Resident-X/brew-state/docs/sunbeam-em7000/photos/original-board-solder-side-aligned.jpg

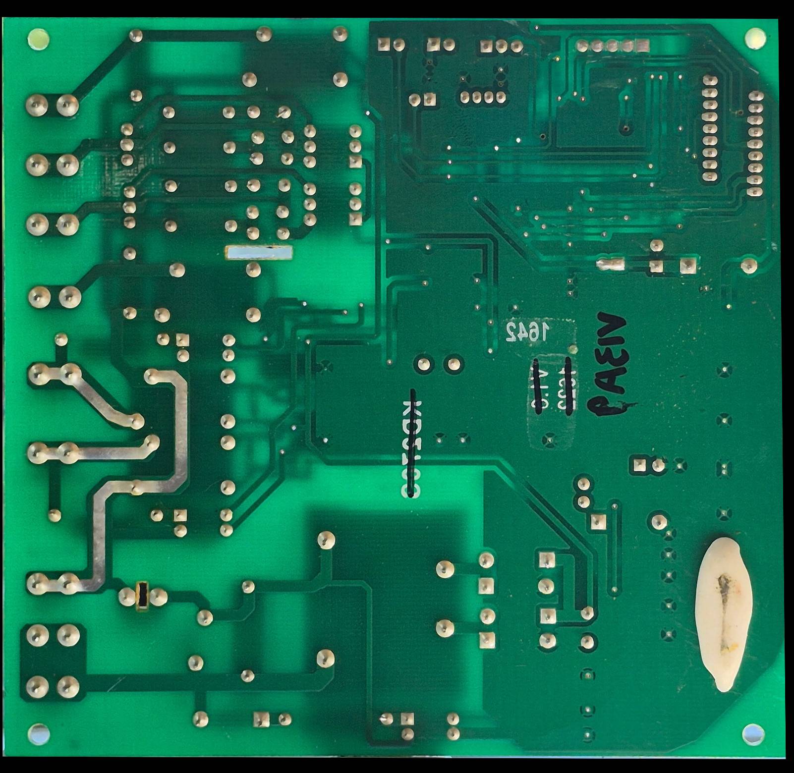
docs/sunbeam-em7000/photos/original-board-solder-side-aligned.jpg
