Resident-X/brew-state/docs/sunbeam-em7000/photos/ntc-two-pin-headers.jpg

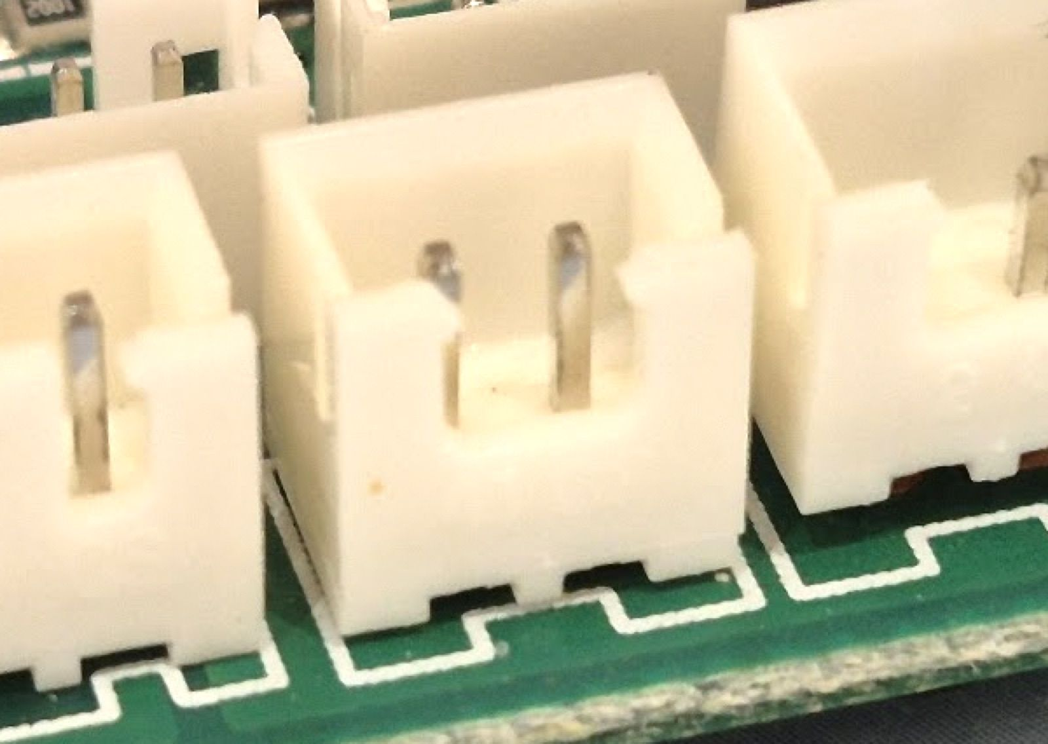
docs/sunbeam-em7000/photos/ntc-two-pin-headers.jpg
