Resident-X/brew-state/docs/sunbeam-em7000/photos/mains-terminals-with-ruler.jpg

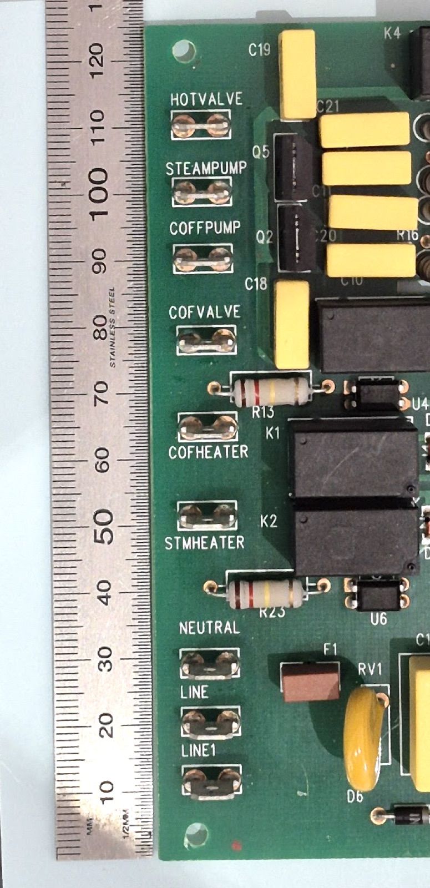
docs/sunbeam-em7000/photos/mains-terminals-with-ruler.jpg
