Resident-X/brew-state/docs/sunbeam-em7000/photos/three-way-valve-coil-marking.jpg

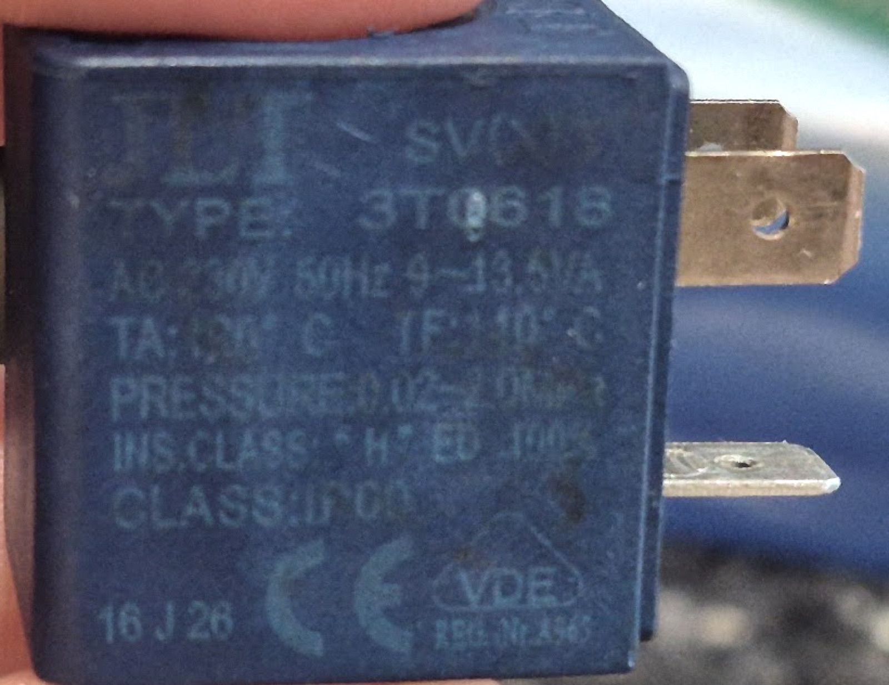
docs/sunbeam-em7000/photos/three-way-valve-coil-marking.jpg
