Resident-X/brew-state/docs/sunbeam-em7000/controller-design/component-specification.md

> **[Fork, kept as history.]** This is the copy of `../component-specification.md` refreshed on 2026-10-12 against the bought-module design. The root document is the live record and governs; this copy's passages are classified in `_carry-forward/reconciliation.md`, and the README of this folder says where the design now is.

# Component specification and list

**This file is local, like `reference-machine.md` and `controller-io.md`.** It answers the question those two leave open: given every channel the machine needs, what property must each part have, which part has been selected, does the selected part meet the property and on what evidence, and what is still undecided or unmeasured.

It is a refresh of the earlier `component-specification.md`, rewritten against the decisions of 2026-10-12 (`decisions.md`) and the current design data (`control-system-bom.csv`, `part-numbers.csv`, `module-interconnect.csv`, `passive-and-drive-components.csv`, `h743-pin-allocation.csv`, `h743-header-pinout.csv`). `decisions.md` was written before any of its decisions was in the graph; its controller choice (D1) has since been replaced by `DEC-CONTROLLER-BASELINE-STM32H743`, which is in the graph, and where this file leans on another decision of that log it says so. `DEL-COMPONENT-SPECIFICATION.C6` — regenerating this document and its list from the graph — is still a later criterion of the parent task and is not attempted here.

Tags used for provenance: **[chosen]** and **[owner decision]**, **[agreed]**, **[recommended]** are the status words of `decisions.md`; **[owner statement]**, **[parts list]**, **[schematic]**, **[published, unverified]**, **[inferred]**, **[unmeasured]** are as defined there. **[BOM]**, **[pin allocation]**, **[interconnect]**, **[passives]** name the data file the statement is read from. **To confirm** marks a claim kept from an earlier text or a source that the current inputs cannot settle.

Three rules govern what may appear below.

**The required property is stated independently of the part.** Each switched load names what its device has to do, carry, dissipate and fail into. The selected part is then held against that property. This is deliberate: a part recovered from another machine, or a replacement bought later, can be held against the property, but not against someone else's part number.

**Every figure traces to a declaration.** Currents are derived from the measured element resistances in `reference-machine.md` § Heating and load at the supply span that document declares. Nothing here introduces a figure that section does not carry, and where a figure cannot be derived the row says so rather than estimating.

**The controller was selected in the earlier design, and the live record has replaced that selection.** The earlier text of this file declined to select a controller because `DEC-PREHARDWARE-TARGET-FAMILY` and `DEC-HEATER-DRIVE-GATED-BY-SUPERVISION` left the choice open, to be answered against measured plant parameters. The WeAct MiniSTM32H743 was then chosen (D1, [chosen]; reason recorded as its 16-bit ADCs). `DEC-CONTROLLER-BASELINE-STM32H743` now baselines the STM32H743 designed bare onto the controller board, does not keep the WeAct module, and supersedes `DEC-PREHARDWARE-TARGET-FAMILY`, which had nominated the F4 family only as a verification stand-in for the pre-hardware target build; the F4 family is not the controller. The earlier assessment candidate, an STM32F407 board, and the OEM Hongfa relays were not used: the F407 was replaced for the H743's ADCs, and the relays cannot be commanded at the switching rate the heater scheme needs (half-cycle or whole-cycle: open decision). `module-interconnect.csv` separately records a graph revision owed against `DEC-MAINS-PHASED-ACTUATION-BELOW-SEAM` (see the supply-timing section).

## What the supply is, and what changes off it

Everything below is stated against a declared supply rather than against this machine's. The reference build runs on a declared span of 216–253 V at 50 Hz, from a 10 A outlet behind an upstream breaker declared as up to 20 A (`reference-machine.md` § Supply, which grades each). Two things follow for an adopter elsewhere, and both are properties of their supply rather than of this design:

- **Frequency sets the switching cadence, not the control period.** Heater devices are specified as commandable once per supply half-cycle (OPEN DECISION: heater switching cadence (whole-cycle versus half-cycle): `h743-pin-allocation.csv` toggles at whole-cycle granularity). That is 100 commands per second at 50 Hz and 120 at 60 Hz; the device requirement is identical either way, and `DEC-MAINS-PHASED-ACTUATION-BELOW-SEAM` carries the residual forward so a non-integer number of half-cycles per control step behaves exactly as an integer number does. [Superseded: bought-module design; the whole-cycle reading is the earlier pin allocation's, and the live record settles the per-half-cycle decision in `../controller-board-function-forms.md` § The heater switch and the per-half-cycle decision.]
- **Voltage sets the current, and the current sets the device.** These elements are fixed resistances, so halving the supply halves the current and quarters the power: the same two elements on 120 V would draw about 2.3 A and 2.6 A and deliver roughly a quarter of their rated heat, which is a different machine rather than the same one on a different plug. An adopter building to the same *heating* on a 120 V supply needs 120 V-rated elements instead, and `reference-machine.md` § What depends on these values records where that lands: the same installed heating at 120 V is over 16 A, so concurrent brew and steam is unavailable there regardless. Either way every current and dissipation figure below is recomputed from the adopter's own supply and element resistances; none of them is inherited.

This machine's 50 Hz is the supply's nominal, taken from the standard governing that supply rather than from a component's marking, as `REQ-MACHINE-CONFIGURATION-001.C9` requires (`reference-machine.md` § Supply, which grades it). Nothing below depends on its exact value: whatever depends on the supply's timing reads it live while the machine runs. The 50 Hz figure also appears in the dimmer acceptance test (about 100 zero-cross edges per second), which therefore measures the supply as well as the module. [Superseded in part: the dimmer acceptance test is bought-module design (the live front end is in `../controller-board-function-forms.md` § Supply-timing front end); the supply-nominal sentence before it is unchanged and is in `../component-specification.md` § What the supply is, and what changes off it.]

## What each switched load needs of its device

Six mains loads, each specified by property. Currents are computed from the measured cold resistances in `reference-machine.md` § Heating and load at three points of the declared 216–253 V span: 230 V nominal, 240 V, and 253 V, the span's top, which sets every current and dissipation a device is sized for (its 216 V bottom sets the least heat delivered and no device rating); a cold resistance gives the higher current if these elements behave as metal heating elements ordinarily do, resistance rising with temperature. **That coefficient is assumed, not declared** — no document here gives one for either element. It is called out because the whole direction of the sizing case turns on it: were either element to fall in resistance when hot, the worst case would be the hot reading rather than the cold one, and every figure in this table would be a floor rather than a ceiling.

### The required property

| Load | Commanded how often | Carries continuously | Must dissipate | Must fail into |
|---|---|---|---|---|
| [Superseded in part: the cadence open-decision note and the SSR dissipation estimate are bought-module design (live record: `../controller-board-function-forms.md` § The heater switch and the per-half-cycle decision and § Parts off the boards); the currents and the fail-into state are carried in `../component-specification.md`.] Coffee thermoblock element | OPEN DECISION: heater switching cadence (whole-cycle versus half-cycle): once per supply half-cycle as written here. This is the requirement that retires the OEM device: `DEC-MAINS-PHASED-ACTUATION-BELOW-SEAM` converts a commanded level into an energise-or-idle decision taken every half-cycle, and a mechanical relay cannot be commanded at that rate or survive being asked to | 4.36 A at 230 V, 4.55 A at 240 V, 4.80 A at 253 V, from the measured 52.7 Ω | At full duty, the device's own forward drop times that current. The earlier estimate was of the order of 6 W at the top of the supply span on a 1.2–1.4 V on-state drop, **a device-class figure from ordinary practice, not from any declaration here**; the BOM now estimates 5–6 W for the selected part on a 1.0–1.2 V drop [BOM, inferred, unmeasured]. A datasheet or measurement replaces either, and the heatsink follows from that number. Mounted so heat leaves it at the ambient inside a machine that is itself heating, not at bench ambient | **De-energised.** `OBL-ELECTRICAL-THERMAL-SAFETY-001.C2` requires a hung controller to de-energise rather than hold a heater on, and a device whose dominant failure is a short does not provide this by itself — see the regression note below |
| [Superseded in part: as the coffee row; the currents and the fail-into state are carried in `../component-specification.md`.] Steam thermoblock element | OPEN DECISION: heater switching cadence (whole-cycle versus half-cycle): once per supply half-cycle, as above | 4.89 A at 230 V, 5.11 A at 240 V, 5.38 A at 253 V, from the measured 47.0 Ω. That reading is a *lower bound* on the element's resistance — the bench could not isolate it and a parallel path can only pull a reading down — so these currents are a conservative ceiling rather than a central estimate, which is the right direction for sizing a device | Of the order of 7 W at full duty at the top of the span on the earlier basis (1.2–1.4 V); 5–6 W per channel is the BOM's estimate for the selected part | **De-energised**, on the same criterion and with the same caveat |
| Coffee pump | At a firing instant within the cycle. `DEC-MAINS-PHASED-ACTUATION-BELOW-SEAM` retains the phase-capable arrangement rather than replacing it | Bounded rather than derived from the declared figures. 48 W (Ulka EP5, nameplate, inspected) is a real-power rating and the load is a solenoid pump, so its VA exceeds its watts by a power factor no document here gives. 0.21 A at 230 V is the real-power floor, not the current the device must carry. The BOM carried 0.1–0.22 A as the pump current for the comparison with the dimmer's 4 A rating; the recorded sizing values, 0.46 A (coffee) and 0.19 A (steam) at 253 V under an assumed 0.5 power-factor floor (`../connector-pinouts.md` § Pumps: running current), replace it | Not derivable for the same reason. The OEM device carries it today, which bounds the question without answering it | **De-energised.** A pump left running is not the thermal hazard a heater is, but it is a water hazard and the same criterion reaches it |
| Steam pump | As the coffee pump | Same basis, 22 W (JYPC-4, nameplate, inspected) giving a 0.096 A real-power floor at 230 V | Same basis | **De-energised** |
| [Superseded in part: the relay that opens on power loss is bought-module design (live record: `../controller-board-function-forms.md` § Two-way valve switching and three-way valve switching); the vent role of the valve and the replacement-coil match are kept in `decisions.md` D6 and F2 and carried to the channel enumeration `../controller-io.md`; the coil currents are carried in `../component-specification.md`.] Two-way solenoid valve (`2T0607W`) | Once per delivery. Nothing requires this channel to modulate; it opens and closes | As found, the coil is marked 230 V AC, 9–13.5 VA, with a cold resistance of 2.496 kΩ: at most 64.6 mA rms steady and 101.4 mA rms inrush at 253 V (`../connector-pinouts.md`). A replacement valve is specified to match the fitted coil, 230 V AC 9–13.5 VA marked, and the snubber leakage note uses the 2.496 kΩ cold resistance | Follows from the device chosen | **Open to the drain when de-energised.** This is now decided rather than hypothesised: the 2-way vent is normally open and is energised closed whenever the coffee pump is pumping through the block (the 30-40 s shot; also hot water; the pre-shot flush; dry-fill and identification runs), so it vents on power loss, fault, end of brew and whenever the block heats with no flow path (D6, [owner decision]; F2, [owner statement]). The channel's safe state is therefore the de-energised state, held by a relay that opens on power loss |
| [Superseded in part: nothing module-specific except the relay; the brew-path state of the de-energised valve is kept in `decisions.md` F1 and carried to the channel enumeration `../controller-io.md`; the coil currents are carried in `../component-specification.md`.] Three-way diverter valve (`3T0618W`) | Once per delivery | As found, the coil is marked 230 V AC, 9–13.5 VA, cold resistance 2.497 kΩ: at most 64.6 mA rms steady and 101.4 mA rms inrush at 253 V (`../connector-pinouts.md`); a replacement valve is specified to match the fitted coil, 230 V AC 9–13.5 VA marked | Follows from the device chosen | **De-energised.** F1 [owner statement]: the 3-way valve is never closed; de-energised it connects the coffee block outlet to the group (brew path), energised it diverts to the hot-water outlet. De-energised is therefore the brew path |

### The selected part against the property

[Superseded: bought-module design (EARU SSR-40DA, ULN2003A breakout, RBdimmer modules, the four-channel relay module and its snubber modules); the live record is `../controller-board-function-forms.md` § Coffee element switching and steam element switching, § Coffee pump switching and steam pump switching and § Two-way valve switching and three-way valve switching, with the module properties re-stated as constraints in `../controller-board-design-constraints.md` § Carried-forward module properties. The datasheet-derived figures in the rows below (snubber leakage arithmetic, pump sizing currents, triac holding current against the valve coils) are held there and in `control-system-bom.csv`, `decisions.md` D5 and `passive-and-drive-components.csv`.]

The as-found OEM devices are recorded in `reference-machine.md` as evidence of what the machine was built with, not as candidates: two mechanical relays on the elements (on/off only, cannot be commanded per half-cycle), an opto-triac driver into a triac on each pump, and two mechanical relays on the valves.

| Load | Selected part | Meets the property? Evidence | Undecided or unmeasured |
|---|---|---|---|
| Coffee element | EARU SSR-40DA zero-cross solid-state relay (D2, [chosen]), control + to the 5 V rail, control − to ULN2003A OUT1 | **Current:** 40 A rating against 4.36 A at 230 V (4.80 A at 253 V) [BOM], large margin. **Cadence:** zero-cross type is the property that permits burst firing and the BOM calls it load-bearing; the BOM describes the scheme as half-cycle burst-fire, while `h743-pin-allocation.csv` says PB0 is toggled at whole-cycle granularity by the burst layer — the two readings are **to confirm** against `heater-drive-and-supply-timing.md`. **Isolation:** command crosses the SSR input to output; the ULN2003A sits between the controller pin and the SSR so no controller pin carries SSR drive current [BOM]. **Fail state on controller loss:** low-side drive, a lost wire turns the SSR off, and a 10 k pull-down on each ULN2003A input at the breakout's own header holds it off in reset [BOM, passives] | **Zero-cross type of this EARU part is not confirmed** — confirm on EARU's own datasheet, not the generic SSR-40DA class [BOM]. Package dimensions are assumed to match the Fotek it replaces [BOM, unmeasured]. Control current at the ~4 V the SSR sees after the Darlington drop is unmeasured (expect 7.5–12 mA). Heatsink: 2 × AUD 10 is listed, but the owner will try mounting direct to the side wall so it may not be needed (proposed, not decided; superseded 2026-10-23: the owner's plan is to mount the heater switches outside the enclosure on the machine's metal wall (`controller-board-design-constraints.md` § Enclosure air temperature); the wall is plastic and unearthed as found (reference-machine.md § Controller enclosure as found)) [owner statement, BOM]. SSR isolation rating not read from a datasheet (to confirm). Fail-short behaviour: see the regression note |
| Steam element | EARU SSR-40DA, OUT2 / PB1 | As above; 40 A against 4.89 A at 230 V (5.38 A at 253 V) [BOM] | As above |
| Coffee pump | RBdimmer 4A 1-channel Standard module (Z-C/DIM header) (D3, [chosen]); DIM on PA9, 1–2 A slow-blow branch fuse in its AC-L feed | **Phase-capable:** the controller times the triac itself from the module's Z-C, giving phase-angle and whole-cycle burst control [BOM]. **MOC3021 confirmed random-phase** so genuine phase-cut [BOM]. **Current:** BT136S 4 A against a pump current of 0.46 A (coffee) and 0.19 A (steam) at 253 V, the sizing values under an assumed 0.5 power-factor floor (`../connector-pinouts.md` § Pumps: running current); large margin even allowing for the unknown power factor [inferred]; no heatsink needed [BOM]. **Fail state:** DIM is active-high (from the vendor library), a 10 k DIM-to-GND pull-down is to be fitted at the module header so a floating or disconnected line cannot fire the pump; loss of AC-N or Z-C removes the timing reference and firmware must stop firing and raise a fault [BOM, interconnect] | Z-C output type (open-collector or push-pull), pulse width and polarity are not published — scope on arrival. Confirm by meter that the board has no pull-down of its own. The triac reads BT136S-600E from the board photo, which appears not to be snubberless; commutation on an inductive pump load is an open question the BOM judges likely a non-issue at a pump current of 0.46 A (the sizing value under an assumed 0.5 power-factor floor), and no snubber is to be added pre-emptively. The BT136 tab is non-isolated, so PCB copper under it is live: clearance matters when mounting. The vendor page states no isolation figure (read 2026-10-13) — **measure it, do not assume it**. Price of the Standard variant not yet checked |
| Steam pump | Same module; DIM on PD8; Z-C not wired | As above | As above, plus D4: steam pump drive (phase-angle versus burst) is **open**, to be settled on the bench; the OEM drives it in software bursts [published, unverified] |
| Two-way valve | Channel 1 (IN1, PD7) of a 4-channel opto-isolated mechanical relay module (Songle SRD-05VDC-SL-C relays, 10 A class) (D5, [chosen]); RC snubber + MOV module (100 nF / 220 Ω with 10D471K) across the contacts | **Isolation:** opto input plus the relay's own coil-to-contact separation. **Why mechanical:** espresso solenoid coils draw about 39-59 mA at 230 V (the coil marking's 9-13.5 VA, `../connector-pinouts.md`) against a BTA16 triac's maximum holding current of 60 mA, so a triac cannot reliably latch on them; the OEM's own split (triac for the pumps, mechanical relay for the valves) rests on the same physics (`decisions.md` D5) [earlier working README]. Relay contacts can weld; that is not removed by the choice. **Fail state:** the vent being fail-safe is a separate point: a de-energised coil is the venting state (D6), and the relay opens on power loss. **Drive level:** opto input triggers at 3.0–5.0 V so a 3.3 V GPIO drives it directly; JD-VCC jumper open to feed coil current from the 5 V rail so 286 mA of steady coil current for four relays does not sag the logic rail [BOM] | The as-found coil is marked 9–13.5 VA with a cold resistance of 2.5 kΩ (at most 64.6 mA rms steady and 101.4 mA rms inrush at 253 V: `../connector-pinouts.md`), so the contact rating margin is 10 A against that current, not against a replacement's, which is specified to match the fitted coil. **Input polarity** (active-low typical) is to be established first; the 10 k pull on each IN line is safety-critical and its direction depends on it [passives]. The snubber passes about 7.2 mA with contacts open (230 V over 100 nF at 31.8 kΩ, 220 Ω and the coil's 2.5 kΩ cold resistance in series), leaving about 18 V across the coil taken as its cold resistance (the lower bound) to about 31–51 V across the sealed coil (impedance 230² ÷ VA = 3.92–5.88 kΩ from the 9–13.5 VA marking, 7.95–8.63 mA), 8–22 % of line, the plunger-open state between and not recorded: whether that holds a valve in is not established (no drop-out or holding voltage is recorded for the coils, and the vent valve's fail-safe state rests on it: to confirm on the bench), and "de-energised" is not zero [BOM]. Whether the OEM valve is retained or replaced by the BOM's replacement spec is not settled (the BOM tags both valves with retained and future markers) — to confirm |
| Three-way valve | Channel 2 (IN2, PD10) of the same module; second snubber | As above. Channels 3 and 4 (PD14, PD15) are spare | As above |

### Isolation, which every row above shares

[Superseded in part: the first paragraph is unchanged and is in `../component-specification.md` § Isolation, which every row above shares; the module-by-module barrier statements, the BL0942 and IRM-10-5 items and the hand-cut carrier gaps that follow are bought-module design, and the barrier ratings are in `../controller-board-function-forms.md` § Barrier parts and `../controller-board-design-constraints.md` § Carried-forward module properties.]

`OBL-ELECTRICAL-THERMAL-SAFETY-001.C6` applies to all six loads and is stated once here rather than repeated per row, because the requirement does not vary between them: the barrier between the mains-referenced switching device and everything the controller, its sensing and the operator can reach must hold under fault as well as in service, and under the water, steam and repeated thermal cycling the machine actually runs in rather than under bench conditions.

For every one of the six, that means the device is commanded across an isolating barrier and never by a direct electrical connection to a controller pin. On the two pump channels the dimmer module's optocoupler (MOC3021) is that barrier and the requirement is a property of the module, and the vendor page states no isolation figure (read 2026-10-13), so it must be measured before it is relied on. On the two valve channels the relay module's opto input and the relay's own coil-to-contact separation provide it. On the two heater channels the barrier is inside the SSR, and the controller's pin reaches it only through the ULN2003A at 5 V; the SSR's own isolation figure is **to confirm** from the EARU datasheet. The heater channels are the consequential ones: they carry the largest current in the machine and they are the channels moved from a relay to a semiconductor.

Two further isolation items are new with the selected parts. The BL0942 energy meters (D17) are inherently mains-referenced, with a shunt in the current path and a resistor divider off mains, and **may not be connected at all until the module's isolation has been measured** (resistance between every header pin and every mains terminal reads open; treat as live until proven) [interconnect, pin allocation]. And the IRM-10-5 supply is rated 4.2 kVac isolation [BOM].

Creepage and clearance on the boards carrying these devices are a layout question this document does not settle, and no declared figure of this design bounds them. The BOM states 4–5 mm gaps on the hand-cut IRM carrier, that conformal coating does not replace creepage, and that the module's own 38.5 mm pin separation must stand on its own. The jurisdiction whose wiring rules apply is AS/NZS 3000 (`reference-machine.md` § Supply), which is a local assumption an adopter replaces along with the voltage and the frequency.

### The regression this specification makes visible

[Superseded in part: the argument is unchanged and is in `../component-specification.md` § The regression this specification makes visible; the SSR-specific sentences and the deferred interlock parts (master relay, watchdog module, latching relay) are bought-module design, and the live record is `../controller-board-function-forms.md` § Proof-of-life interlock.]

Meeting the half-cycle requirement (cadence is an open decision) on the two heater channels meant replacing a mechanical relay with a semiconductor device, and that is a regression in failure mode, not only a change of part. A relay's dominant failure is an open contact — not its only one, since contacts switching this current do weld — whereas a shorted junction is a semiconductor switch's ordinary way of dying rather than its unlucky one. That the selected SSR shares this failure tendency is **inferred** from its being a semiconductor output switch; it is not stated in any input and is to confirm on the EARU datasheet. On a heater channel the difference is the whole of `OBL-ELECTRICAL-THERMAL-SAFETY-001.C2`: a shorted output holds the element energised with no command and no way for the controller to intervene, which is precisely the state that criterion exists to forbid.

This is recorded here rather than solved here. The answer is not a better SSR — it is a series element that removes power independently of the switching device, which is what `REQ-SAFETY-CHAIN-001.C2` and `.C3` already require of the proof-of-life interlock. **Overtaken by `DEC-PROOF-OF-LIFE-INTERLOCK-IN-FIRST-HARDWARE` (2026-10-18): the interlock is built into the first controller hardware, not deferred.** The interlock is still not built: the master relay (Songle SLA-05VDC 30A, with aux contacts, which "cannot be the trip decider" because firmware may not be in the protective path) and the watchdog module (Jaycar/Freetronics XC4267) are BOM rows marked DEFERRED, and a candidate latching relay (CZH-LABS D-1022) is noted in `module-interconnect.csv`, deferred per `DEC-HEATER-DRIVE-GATED-BY-SUPERVISION`, which permits bench operation under human supervision without it and gates only the assembled unattended machine. Whether the graph now has covering work for the interlock is **to confirm**; the earlier text said it had none. The coupling remains: choosing the device the actuation scheme demands worsens the failure mode it protects against.

What the selected design adds is limited. The ULN2003A low-side drive with 10 k pull-downs holds both SSRs off while the controller is in reset or hung, which addresses a controller failure, not an SSR failing shorted. The BL0942 current reading (D17, [chosen], no BOM row yet) could in principle show heater current flowing with no command [inferred]; it detects, it does not remove power, and it is blocked on the isolation measurement above.

Both elements sit downstream of a per-block series thermostat (coffee block 110 °C, steam block 200 °C [parts list]), which the controller cannot reach (`DEC-HEATER-DRIVE-GATED-BY-SUPERVISION`). The parts list also names a thermal fuse (240 °C, steam block), a published, unverified derived view: none was seen at the board end and none was found by the owner (`../reference-machine.md` § Protection), so none is relied on here. The thermostats bound the hazard; they do not satisfy the criterion, which is about the controller's own failure rather than the temperature's.

## What the supply-timing front end needs

[Superseded in part: the Property, Requirement and OEM columns are unchanged and are in `../component-specification.md` § What the supply-timing front end needs; the Selected design column (the dimmer module's Z-C on PA10), the closing statement that the heater SSRs need no phase reference and the graph revision owed are bought-module design, and the live record is `../controller-board-function-forms.md` § Supply-timing front end.]

| Property | Requirement | OEM circuit (as found) | Selected design |
|---|---|---|---|
| What it presents | Both crossings of every cycle. `DEC-MAINS-PHASED-ACTUATION-BELOW-SEAM` resolves half-cycles, and a scheme resolving half-cycles cannot be timed against a reference reporting every second one | A `PC817` optocoupler fed from the line through a `1N4007` and a 120 kΩ 1 W resistor [schematic]. **Half-wave** — one conduction window per cycle; does not meet the property | The Z-C output of dimmer module #1 on PA10 (TIM1_CH3 expected, rising edge, input capture), one edge per half-cycle, **believed** full-wave: the acceptance test is about 100 edges per second at 50 Hz [BOM, interconnect]. Not yet measured, so **whether it meets the property is open**. The second module's Z-C is not wired |
| Isolation | A barrier separating the mains-referenced side from every low-voltage circuit and operator-reachable control, holding under fault and under the water, steam and thermal cycling the machine actually runs in, per `OBL-ELECTRICAL-THERMAL-SAFETY-001.C6` | The `PC817`'s optical barrier. Adequate in kind | The dimmer module's own; the vendor page states no figure, so it is to be measured |
| What it is read as | An input, not a clock. The supply's period is measured from it, and an edge arriving outside a plausible window — or not arriving — is a supply fault to report rather than smooth over | Routed to an interrupt pin of `U3`. Adequate in kind | Timer capture with the digital input filter plus a software lock ignoring edges inside a noise gate (the vendor library uses 3000 µs). Loss of the reference is a supply fault and firmware must stop firing [interconnect] |
| Phase accuracy | **Not established and not bounded.** The offset between a true crossing and a detected edge is real in any such front end, and no declared figure of this design bounds it. `DEC-MAINS-PHASED-ACTUATION-BELOW-SEAM` explicitly declines to invent one | Unknown | Unknown. The BL0942's ZX output (datasheet delay 570 µs) is not on the module header and the UART carries no phase, so it cannot supply a bound [interconnect] |

The heater SSRs are zero-cross and need no phase reference; the reference serves the pumps and the supply-period measurement [interconnect]. The both-crossings property is no longer a matter of choosing a rectifier or detector part: the dimmer module supplies the reference and the selection question becomes the acceptance test above. `module-interconnect.csv` records that this restores the both-crossings reference and that the graph's zero-cross enumeration row and `DEC-MAINS-PHASED-ACTUATION-BELOW-SEAM` have not been re-read or amended against it (graph revision owed).

## Does the selected controller serve every channel at once

[Superseded: bought-module design (the WeAct MiniSTM32H743 on female headers and its pin allocation); the live record is `../component-specification.md` § Does a candidate controller serve every channel at once and § The part selected, and `../controller-board-function-forms.md` § Controller.]

The assessment is made in interface resources, not in connector count, because `REQ-HARDWARE-HEADROOM-001.C2` and `DEL-COMPONENT-SPECIFICATION.C4` both rule that a count of spare pins argues nothing: what matters is whether the capture channels, conversion inputs and timer outputs the design collectively demands are *simultaneously* available. The ST datasheet facts (alternate functions, ADC channel maps) are not recomputed here; they are cited from `h743-pin-allocation.csv`, whose rows are checked against ST DS12110 except where marked.

### What the design demands, and where each channel lands

[Superseded: this is the earlier allocation on the WeAct module, an input only; the live record is `../component-specification.md` § What the enumeration demands, § Where each function lands and § The earlier pin allocation, as input only, which re-reads each row below against the manufacturer's datasheet.]

Read from `h743-pin-allocation.csv`. The option of reaching the panel over the machine's old two-wire link, left open by `DEC-U8-BOARD-RETENTION-UNVERIFIED`, no longer arises: the panel board carries no controller, and the project replaces both microcontrollers.

| Resource | Channel | Pin | Count | Verification status [pin allocation] |
|---|---|---|---|---|
| Heater SSR gates (via ULN2003A) | Coffee, steam | PB0, PB1 (TIM3_CH3/CH4, spare capability only) | 2 | Verified against DS12110 |
| Pump DIM gates | Coffee, steam | PA9, PD8 | 2 | Assigned, plain GPIO; TIM1_CH2 on PA9 "expected", not verified |
| Zero-cross capture | Shared, from dimmer #1 | PA10 (TIM1_CH3) | 1 | Assigned, AF not yet verified |
| Energy-meter UART receive | Coffee, steam heater | PC7 (USART6_RX), PA3 (USART2_RX) | 2 | Verified; TX optional on PC6 / PA2; blocked on isolation test |
| Pressure sensors, two I2C buses | Brew, steam | PB8/PB9 (I2C1), PB10/PB11 (I2C2) | 4 | Verified |
| Analogue inputs, 16-bit | 3 NTC (coffee, steam, wand) | PC0, PC1, PC4 | 3 | Verified |
| Analogue inputs, 16-bit | Outlet-water PT1000; commissioning PT1000; steam-output PT1000 | PA4; PA1; PA6 | 3 | Assigned, ADC channel **not yet verified** |
| Valve relay drive | 2-way, 3-way, 2 spare | PD7, PD10, PD14, PD15 | 4 | Verified, plain GPIO |
| Gauge drive lines (via 74HCT541) | 2 direction, step clocks, reset | PD0, PD1, PD4, PD5, PD6 | 5 | Verified, plain GPIO |
| Panel key/indicator lines | 5 bidirectional | PE4–PE8 | 5 | Verified, plain GPIO |
| Indicator anode-rail gate | PWM | PB5 (TIM3_CH2 expected) | 1 | Assigned, AF **not yet verified** |
| Buzzer drive | Open-drain | PB4 | 1 | Verified; PB4 defaults to NJTRST, release in firmware |
| Water-indicator cathode | Open-drain | PA0 | 1 | Verified |
| Tank level, hot-water knob, steam knob switches | S6, S7, S8 | PE9, PE15, PC6 | 3 | Verified |
| Flow-meter capture | Pulse train | PA8 (TIM1_CH1) | 1 | Verified |
| Mains-presence confirm | Two isolated inputs | unassigned | 2 | Under review (see the confirm-channel row below) |
| **Assigned total** | | | **38** | Matches the allocation file's budget line |

The 38 assigned pins are all that the allocation file counts; the two unassigned mains-presence inputs would bring the demand to 40.

### What the selected controller provides

[Superseded: bought-module design (the module's headers, onboard screen, card slot and flash, and its onboard 3.3 V converter); the live record is `../component-specification.md` § What the selected part provides.]

The selected controller is the WeAct MiniSTM32H743 (STM32H743VIT6, LQFP100) on female headers [chosen]: 480 MHz, 3 × 16-bit ADC, 2 MB flash and 1 MB RAM per `part-numbers.csv`, an onboard DC-DC accepting 3.3–5.5 V in and rated 1 A for the 3V3 rail [BOM, part-numbers]. The H750VBT6 variant (same board, 128 KB flash) is not to be bought [BOM]. Board footprint 40.64 × 66.88 mm, height estimated [BOM].

| Resource | Provided [pin allocation, header pinout] | Demanded | Remaining and caveat |
|---|---|---|---|
| Header GPIO | 74 port pins on headers (92 header positions including power and SWD; PC13 and PE3 are the only port pins off the headers; PA13/PA14 on the separate SWD header) | 38 assigned | 17 free; 19 are encumbered by onboard TFT, microSD, QSPI/SPI flash and USB. The design avoids every encumbered pin; the DVP camera pins are used freely because no camera is fitted. Five header designators (3, 7, 10, 90, 91) did not parse from the source library and are almost certainly power or ground: **to confirm** against the schematic |
| 16-bit ADC channels | 3 ADCs; ADC channel map per DS12110 differs between ADC1/2 and ADC3 on this package | 6 channels (3 NTC, 3 PT1000) | PC0/PC1/PC4 verified; PA1, PA4 and PA6 **not yet verified** (expected ADC1_INP17, ADC12_INP18 and ADC12_INP3). Free ADC-capable pins are not counted in the allocation file — **to confirm** from the header pinout before the headroom claim below is made firm. PC2/PC3 plain pads do not exist on LQFP100 and were deliberately avoided |
| Timers | Allocation uses TIM1 (flow capture CH1, zero-cross capture CH3; PA9 CH2 expected for a pump DIM) and TIM3 (PB0 CH3, PB1 CH4, PB5 CH2) | 2 captures, timer-backed outputs | Each timer's channels share a counter and prescaler: TIM1's two captures are noted "no conflict expected" and TIM3 carries the anode-rail PWM beside the heater gates. The heater gates are plain-GPIO-sufficient so the shared TIM3 period does not bind, **to confirm** once firmware allocates periods |
| Serial | USART2 and USART6 receive for the meters; I2C1 and I2C2 | 2 UART RX, 2 I2C | PC6 is both the optional USART6 TX and the steam-knob switch input S8: if the coffee meter needs commands, one of the two must move. **To confirm** whether the module needs commands |
| Output level, gauge lines | 3.3 V I/O | 5 lines clearing the retained `VID66-08`'s 3.15 V VIH | Cleared by the 74HCT541 level-up buffer (D19, [chosen]); HCT accepts 3.3 V as a valid high [part-numbers]. The buffer's output reaching the driver at 5 V is **inferred** from its supply. The allocation file notes the 5 V-tolerance analysis behind the buffer was an F407 one and the H743 pin set differs: re-check, though the buffer is conservative either way |
| 5 V-tolerance on open-drain stages | PB4, PB5 drive the OEM-copied Q8 and Q7 transistor stages open-drain (D18, [recommended]) | 2 pins | To be verified 5V-tolerant (PB4, PB5; see `open-items.md` section B); the allocation file says verify, otherwise add an NPN level shifter. **To confirm** |
| Flash / RAM / compute | 2 MB / 1 MB / 480 MHz | Not stated by the design | Unquantified on both sides, as before; see below |

**Simultaneity holds on the allocation as written, with the unverified rows named.** No channel is double-assigned among the 38, and the one overlap in the file (PC6) is on an optional TX. The six unverified items are the PA1, PA4 and PA6 ADC channels, the PA10 and PB5 timer alternate functions, and PA9's timer channel (not required: plain GPIO is assigned). Until those six are checked against DS12110 the allocation is a plan, not a proven placement.

**One row of the earlier assessment is resolved by a part.** The earlier text found that a 3.3 V controller output could not be guaranteed to clear the gauge driver's 3.15 V input high, and offered level shifters or a bench measurement of VOH. The 74HCT541 buffer on the perfboard is that level shifter (one octal part, socketed). It is also a cost that belongs to **retention** of the gauge driver rather than to the gauges, which sits with `DEC-DEVICE-RETENTION-BOUNDARY`.

**A requirement disagreement to settle.** The earlier enumeration said the two gauge step clocks need timer channels because an uneven step rate reads as needle stutter. The allocation file assigns all five gauge lines (PD0, PD1, PD4, PD5, PD6) as plain GPIO and does not say whether the step clocks are timer-driven. Whether the stutter requirement is met by a software-timed clock or needs timer outputs on two of those pins is **to confirm**.

### Room for the channels the graph anticipates

[Superseded in part: the pin counts and the states of the brew-path pressure and current-sensing channels are bought-module design; the live record is `../component-specification.md` § Room for the channels the graph anticipates.]

Several channels the earlier text carried as anticipated are now designed; the rest are as before.

| Channel | Where it comes from | State and cost |
|---|---|---|
| Brew-path pressure transducer | `REQ-MEASUREMENT-001.C7` requires brew pressure measured rather than inferred | Now designed: XDB401 on I2C1 (PB8/PB9), D12 [chosen]. No longer anticipated |
| Current sensing | Earlier: not fitted, not decided | Now designed as the two BL0942 energy meters on USART RX (D17), blocked on the isolation test |
| Weight-based endpoint control | Named in `REQ-HARDWARE-HEADROOM-001` as the immediate deferred capability | Not designed; 2 digital pins to a load-cell amplifier against 17 free header GPIO (some of which are the encumbered-but-usable pins; the 17 counts only the free ones) |
| Direct group-head instrumentation | Named in the same requirement as the general case | Not designed; would cost 1–2 conversion inputs. Headroom in ADC-capable free pins is to confirm (above) |
| Real-time clock | Not fitted, not decided | Not designed. Pin cost of a 32.768 kHz crystal option is not determined from the inputs; the earlier text said 0 pins on the internal oscillator and 2 with the crystal, and noted the internal oscillator drifts too far for timestamping — **carried, to confirm** on the H743 board |

Against 17 free header GPIO, the anticipated channels that remain (weight, group-head instrumentation, an RTC crystal) fit by pin count on the allocation's own budget line, which is what `REQ-HARDWARE-HEADROOM-001.C1` and `DEL-COMPONENT-SPECIFICATION.C4` ask to be shown; the ADC-capable share of those 17 is the part not yet shown.

### What this assessment does not establish

[Superseded in part: the compute and memory bullet and the usable-subset bullet are unchanged and are in `../component-specification.md` § What this assessment does not establish; the board-specific allocation checks are bought-module design.]

- **Compute and memory are unquantified on both sides.** The design states no RAM, flash or clock requirement, and measuring the control law's actual execution time is on-target work under a later phase. 480 MHz, 2 MB and 1 MB are recorded as what the board provides, not as what the design needs; no headroom claim is made about them in either direction.
- **The board's usable subset is narrower than the part's, and the allocation has now been checked against it.** The earlier text required the pins a board brings out to be checked against its own schematic before purchase. The header map was recovered from the maker's Altium library and cross-checked with the V12 schematic PDF; the encumbered pins are identified. The QSPI and SPI-flash pairings are noted PARTIAL in the allocation file, with a note to verify against the PDF before committing the allocation. The five unparsed header designators remain.
- **The graph records the selection as the bare chip, not the module.** D1 is [chosen] in `decisions.md` as the WeAct module; `DEC-CONTROLLER-BASELINE-STM32H743` records the STM32H743 designed bare onto the board and supersedes `DEC-PREHARDWARE-TARGET-FAMILY` (see the opening note), so the module selection is not kept.

## The component list

[Superseded in part: the status list of selected bought modules, including the table under *What each channel requires, and what is selected*, is bought-module design; the live record is `../component-specification.md` § The component list, with the form of each function in `../controller-board-function-forms.md` and the catalogue stock and price per channel in `../controller-board-design-constraints.md` § Manufacturer stock and price, per channel. The channel properties in the Must satisfy column that are not module-specific are held in `control-system-bom.csv` and the retained design data named per row.]

This is a specification and a status list. Each row states what a part on that channel has to satisfy, what has been selected, how the selection meets it and what remains open, so a replacement — bought new, taken off this machine, or recovered from a donor machine — can still be held against the row. **Provenance and spend are recorded as parts are bought; the BOM prices are mostly estimates and are not totalled here.**

**Declared spend: 250 USD**, covering what the retrofit adds and excluding the machine it is added to. This is the figure `REQ-COST-DISCIPLINE-001.C5` and `DEL-COMPONENT-SPECIFICATION.C5` require to be written down rather than held in anyone's head, and it is the figure an adopter replaces with their own — currency, market and what they paid for their machine are all theirs. `REQ-COST-DISCIPLINE-001.C6` asks that the running total be *weighed* against it as decisions land, not that it be treated as a trip point. The BOM prices are in AUD and no conversion is declared, so the running total is not stated (see the end of this section).

### Provenance classes

Three, and they differ on more than price. The class is recorded per channel when the part is chosen.

- **Reused** — already carried by this machine, whether it stays where it is or is recovered off a board being replaced. Costs nothing, and has demonstrated it survives this machine's environment, which is more than a datasheet establishes (`REQ-COST-DISCIPLINE-001.C1`). A part coming off the OEM control board is reuse on this definition: it loses its board, not its history.
- **Salvaged** — taken from a different machine. Costs nothing and has demonstrated *neither* a datasheet nor survival here, so a salvaged row records how the part was verified against its specification before it is admitted. What that verification has to reach is set by what the channel's failure costs, not by what the part costs (`REQ-COST-DISCIPLINE-001.C4`).
- **Bought** — new, carrying its datasheet and its price.

### What each channel requires, and what is selected

Prices are AUD each from `control-system-bom.csv`; "est." means the BOM says the price is an estimate or not looked up. Whether a part has actually been bought is recorded in `../controller-board-design-constraints.md` § Purchases ahead of verification.

| Channel | Must satisfy | Selected part | Class | Cost (AUD) | Meets / open |
|---|---|---|---|---|---|
| Controller | Every row of the resource assessment above, simultaneously, with room for the anticipated channels | WeAct MiniSTM32H743 on female header strips soldered to the perfboard, so it is swappable (D1) | Bought | 20 | Meets by pin and ADC count on the allocation; five allocation items unverified; height estimated |
| Coffee element switching | OPEN DECISION: heater switching cadence (whole-cycle versus half-cycle): commandable once per half-cycle as written here; carries 4.80 A at the top of the span; dissipates about 5–6 W at full duty; isolated; see the fail-state discussion | EARU SSR-40DA (D2) | Bought | 15 | Zero-cross type, isolation rating and package unconfirmed; fail-short covered only by the deferred interlock (overtaken by `DEC-PROOF-OF-LIFE-INTERLOCK-IN-FIRST-HARDWARE` (2026-10-18): the interlock is built into the first controller hardware and not deferred) |
| Steam element switching | As above at 5.38 A | EARU SSR-40DA (D2) | Bought | 15 | As above |
| Heater gate drive, both channels | Sinks 7.5–12 mA each from 5 V, holds both SSRs off while the controller is not driving, isolation between the controller pin and the mains-referenced load | ULN2003A 7-channel breakout (buy 2, fit 1) with a 10 k pull-down across each used input, fitted at the breakout's header pins | Bought | 1.5 ea (est.) | About 24 mA total; the Darlington drop is about 1 V, SSR sees about 4 V — measure. The breakout's GND/VCC jumper header and the LED loading are undocumented; check the chip marking. The ULN2003A's own internal input default-off is a datasheet claim not yet confirmed on this board |
| Coffee pump switching | A firing instant placed within the cycle; isolated; de-energised on failure | RBdimmer 4A Standard module, DIM on PA9, 10 k DIM pull-down, 1–2 A slow-blow fuse (D3) | Bought | TBD | See the table above |
| Steam pump switching | As above; 22 W | RBdimmer 4A Standard module, DIM on PD8 (D3); drive scheme open (D4) | Bought | TBD | See above |
| Two-way valve switching | Per-delivery switching of a mains AC coil; isolated; de-energised on failure, which is the venting state (D6) | Channel 1 of the 4-channel mechanical relay module; RC snubber + MOV across the contacts (D5) | Bought | 6.40 (module); 3 ea (snubber, est.) | Input polarity to establish; coil marked 9–13.5 VA (`../connector-pinouts.md`) |
| Three-way valve switching | As above; de-energised is the brew path | Channel 2 of the same module; second snubber | Bought | (shared) | As above. Do not fit the snubber module to the pump triacs: about 7.2 mA through 100 nF can latch a BT136 on [BOM] |
| Supply-timing front end | Both crossings of every cycle; isolation; read as an input | Z-C of dimmer module #1 on PA10 (shared) | Bought (within the dimmer) | (in dimmer) | Full-wave, output type and pulse unmeasured; phase offset unbounded |
| Heater current and voltage metering | Quantitative heater current, upstream of the SSR so the voltage channel sees continuous mains | Two BL0942 isolated energy-meter modules, UART TX to PC7 and PA3 (D17) | Bought | no BOM row yet | Isolation to be measured before connection; no BOM row or price |
| Heater mains-presence confirm | Two isolated AC-sense inputs reporting whether mains actually reached each element, which distinguishes a relay that did not close, a welded contact and an open thermal cutout from a command that was obeyed | Not selected. D20 [recommended, not decided]: replace by the BL0942 current reading, losing the localisation of "did not close" versus "open downstream". The OEM `LTV814` through a 120 kΩ 1 W resistor is the as-found floor | — | — | Two pins unassigned. The allocation file notes `controller-io.md` marks mains presence safety-relevant, so decide whether the BL0942 reading suffices; keep only if the meters are dropped |
| Outlet-water temperature (key sensor) | Reads the water, the controlled variable (`REQ-BREW-TEMP-001.C2`); PT1000; element, sheath and leads at least 125 °C (150 °C preferred); at least 15 bar; own divider | Calibrated PT1000 spike probe (3 mm × 30 mm class, PTFE/FEP leads) at the coffee block outlet before the 3-way valve, in a standard tee used as an elbow, tip facing upstream, with a compression gland, on PA4 (D9, [owner decision] for placement) | Bought | 12 + 6 tee + 8 gland + 5 sleeving (all est.) | Probe class claim unverified; calibrate on the whole chain (ice and boiling point, pressure-corrected); tee and gland threads unmeasured; stagnant water at rest cools, so it is not a rest-state reference for the NTCs |
| Block and wand temperature (casing sensors) | Analogue resistance, NTC, at the accuracy `controller-io.md` states per channel; calibrated in place against the water probe under steady low flow | `EM70025` (coffee), `EM70020` (steam) and the wand disc sensor, retained as casing sensors, PC0/PC1/PC4; no MAX31865 (D10) | Reused | 0 | The NTCs are 100 kΩ at 25 °C with 10 kΩ 1 % dividers on the OEM board and B is not established [schematic]; the new dividers are 4.7 kΩ low-TCR (25 ppm/°C or better, 8 off, est. 0.5 ea) to VREF+/VDDA, 100 nF at each ADC pin. Sensitivity of a 4.7 kΩ divider against a 100 kΩ NTC over the working range is not in the inputs: **to confirm** at calibration. Thermal compound for refitting the NTCs (non-conductive, rated 200 °C or more) is a BOM item |
| Commissioning probes | A temporary puck-inlet probe for the identification runs, plus a spare | Two PT1000 thin-film flat chips, 250 °C or more, on PA1 (D11) | Bought | 6 ea (est.) | Class A claim is a label, not a test; room-temperature, ice and boiling checks owed. Never fitted to the blocks |
| Flow sensing | A pulse train on a port pin | The fitted OEM meter on the suction line about 5–7 cm ahead of the coffee pump, on PA8 (TIM1_CH1) | Reused | 0 | Output type (open-collector, open-drain or push-pull) is pending (not yet read; it is read when the board carrying the device is designed, and does not block the division of the circuitry into boards) and the K-factor is unmeasured; the OEM signal is held to the 5 V rail by 2 kΩ [schematic], and level handling into a 3.3 V controller pin is to be settled (`SOL-FLOW-METER-READING-AT-CONTROLLER.C1` exists because the signal is unidentified). Whether PA8 tolerates the 5 V pull-up is not stated in the inputs: **to confirm**. Pull-up 10 k and 1 k + 10 nF RC are reserved (0–1) |
| Steam-path pressure | Measure the in-block pressure (`REQ-MEASUREMENT-001.C8`, `DEC-STEAM-PRESSURE-SENSOR-ADDED`); the steam end must survive saturated steam | XDB401 3.3 V I2C, 0.5 MPa, on I2C2 (PB10/PB11), at the lowest point of a 100–150 mm downhill PTFE drop leg from a hairpin-clip tee between the steam block and the manual steam knob valve (D12, D14); steam tee rated for saturated steam | Bought | 30 (est.), tee 6, leg tube 10, adaptors 20 (est.) | Sensor spec: ±1 % FS (±0.05 bar), response ≤ 4 ms, −40 to 105 °C operating, 150 % FS overload, IP65 [BOM, owner-supplied datasheet of the generic XDB401 family]. The 3.3 V I2C variant's output rate and thread are to confirm with the seller. Drop-leg sensor end aimed under about 60 °C, unmeasured. Whether the steam OPV caps block pressure depends on a check valve (F7), to be inspected. No required accuracy is declared in the inputs, so whether ±0.05 bar meets it is **to confirm** against the requirement |
| Brew-path pressure | Measure brew pressure rather than infer it (`REQ-MEASUREMENT-001.C7`) | XDB401 3.3 V I2C, 1.2 MPa, on I2C1 (PB8/PB9), direct tee on the cold side between the new brew OPV and the block, no leg (D12, D13 [agreed]) | Bought | 30 (est.), tee shared with steam row | ±1 % FS (±0.12 bar). A cold-side tap sits inside the sensor's compensated range and needs no capillary; the block, valve and tube drop is estimated at hundredths of a bar at espresso flow [unmeasured] |
| Pressure containment (not electrical) | A relief that acts without anything electrical (`OBL-ELECTRICAL-THERMAL-SAFETY-001.C5`); brew pressure bounded by a safety-only relief (`DEC-BREW-RELIEF-VALVE-IS-SAFETY-ONLY`) | Steam OPV retained, on the steam pump, about 4–5 bar (it is the pressure guarantee only if no check valve lies between it and the block, to be inspected, F7; otherwise the block is bounded by the 200 °C thermostat, about 15.5 bar absolute); brew OPV new between pump and damper and the block, setting TBD, adjustable preferred; brew damper retained; no steam damper (D15, D16) | Retained / Bought | 30 each (est.) | Settings, threads and body sizes are not published or measured; the steam damper decision rests on a reasoning review with assumed numbers, about 75 % confidence, unmeasured |
| Gauge drive, both gauges | Two direction levels, two step clocks, a shared reset, all five clearing a 3.15 V input threshold; the controller does not provide stepper drive | Retained OEM `VID66-08` on the gauge assembly (inherited), five lines through a socketed 74HCT541 buffer, PD0/PD1/PD4/PD5/PD6 (D19) | Reused (driver); Bought (buffer) | 1 (buffer, 20-pin socket est. 0.5) | The driver is out of production, an obtainability risk and a single point of failure with no fallback, distinct from the unknown-condition question `OBL-PHYSICAL-CONFIGURATION-001.C3` asks. Step-clock timing requirement to confirm (above). The /OE pins carry 10 k pull-ups so the gauges read zero at boot |
| Low-water indication, visual | One output sinking an indicator cathode on the gauge assembly, whose anode rail is the panel's gated rail extended over the gauge harness | The fitted indicator, retained; PA0 open-drain, 47 Ω in series at the pin as the OEM has | Reused | 0 | Sink current for two elements is pending with the forward voltage (not yet read; it is read when the board carrying the device is designed, and does not block the division of the circuitry into boards); contact 6 of the gauge harness is measured (`../connector-pinouts.md`) |
| Operator panel — keys, indicators, buzzer | Five bidirectional lines carrying both the key pairs and the indicator cathodes, one timer output gating the anode rail, one buzzer output — seven pins for the whole panel | The OEM panel board retained as a passive assembly; the controller copies the OEM `Q7` anode-rail gate and `Q8` buzzer stages with 2N5401 PNP transistors driven open-drain (D18, [recommended], not yet decided) | Reused (panel); Bought (transistors, 2 off) | 0.5 ea (est.) | Pinout in `connector-pinouts.md`. Key lines have 1 kΩ in series with each switch and 47 Ω at the MCU pin, no pull-up drawn [schematic]; this disagrees with the earlier reading of the 1 kΩ as pull-ups: check with a meter. Buzzer type (magnetic or piezo) is pending (not yet read; it is read when the board carrying the device is designed, and does not block the division of the circuitry into boards) and the terminal order is read (`../connector-pinouts.md`) |
| Tank level and knob switches | Three ground-switched inputs on their own wires | The tank reed (S6, PE9), hot-water knob microswitch (S7, PE15) and steam knob microswitch (S8, PC6), internal pull-ups plus firmware debounce. The reed is soldered through holes to the original board (body on the back face and leads on the component face: inferred; the two aligned board photographs under `../photos/` show the `WAT` outline and a blob of insulating compound, not the element clearly), so it is lifted or replaced like for like at X 122 mm, Y 17.5 mm (`../reference-machine.md`, enclosure section); the two microswitches are reused | Reused (the microswitches); lifted or replaced (the reed) | 0 | The tank reed is on the board being replaced and its channel is the new board's to provide. S8 is the only thing that engages steam mode in the base machine (F5) |
| Low-voltage supply | Whatever the controller and gate drives need, isolated from the mains side | Mean Well IRM-10-5 (10 W / 2 A) on a hand-cut single-sided copper-clad FR4 carrier, recommended T2A slow-blow fuse and 47–100 µF output capacitor (D7) | Bought | TBD (module); 4 carrier, 3 fuse set, 0.5 ea cap (est.) | Typical-based 5 V budget about 0.53 A (many items estimated; its 143 mA term is the relay-module coil current, 2 x 71.4 mA, not valve solenoid current); worst case with the VID6608 datasheet maximum (200 mA, or the doubled 400 mA the old E16 used) about 0.66 to 0.86 A, all against 2 A; derating about 75 % at 60 °C and about 50 % at 70 °C (1.0 A), read approximately off the spec sheet. 4.2 kVac isolation. Surge only EN61000-4-5 Level 3 1 kV L-N and no earth path, hence the inlet MOV. `decisions.md` D7 names only an external T2A slow-blow fuse (recommended, not required) and states that an internal fuse in the IRM-10-5 is not established; none was found in the spec sheets read, so an internal fuse is **to confirm** in the user manual. 40 A cold-start inrush at 230 V |
| Mains inlet protection | Filter, fuse and surge clamp at the inlet; the clamp strictly downstream of the fuse | IEC C14 → Schaffner FN9222-15-06 (15 A, `DEC-INLET-CHAIN-RATED-ABOVE-ITS-FUSE`) → T10A slow-blow M205 fuse on the active → RN3404 MOV (275 VAC, L-N), leads under 25 mm (D8); see `mains-inlet-protection.md` | Bought | 11.50 + 5 + 3 | Filter panel cut-out and L/W/H mapping not confirmed; holder must be 250 VAC rated and shrouded |
| Wiring, connectors, mains-rated terminals | Rated for the currents above; mains-referenced runs separated from low-voltage per `OBL-ELECTRICAL-THERMAL-SAFETY-001.C6` and `REQ-ELECTRICAL-INSTALL-001.C1`; AS/NZS 3000 in this jurisdiction | Perfboard (7 × 9 cm double-sided PTH) with landing headers or pluggable terminals for every harness; 5.08 mm 300 V-class screw terminals on the IRM carrier | Bought / Reused (loom) | 3 + 5 + 1 ea (est.) | Existing loom condition unassessed. The perfboard size is estimated, not laid out; an LV-only PCB spin is recommended, not decided (D21) |

### Against the declared figure

[Superseded: the channel count and the running total are of the earlier module-based list in AUD; the live record is `../component-specification.md` § Against the declared figure.]

| | |
|---|---|
| Channels specified | 25 (the earlier 18 plus brew pressure, outlet-water probe, commissioning probes, heater metering, pressure containment, switches/tank level, mains inlet protection) |
| Channels with a part selected | 24; the heater mains-presence confirm is undecided (D20) |
| Bought to date | See `../controller-board-design-constraints.md` § Purchases ahead of verification |
| Reused to date | Not recorded as a count; retained parts are listed in the BOM at zero cost |
| Salvaged to date | None recorded; the BOM rows for the valves leave open whether the OEM valves are kept |
| **Declared spend** | **250 USD** |
| **Remaining** | Not computed: BOM prices are AUD with no declared conversion, the dimmer and IRM-10-5 prices are TBD, and most others are estimates |

`REQ-COST-DISCIPLINE-001.C2` asks for a justification wherever a part departs from the reused-or-commodity default. The BOM records these departures: the SSR over the Fotek (counterfeit and over-rating risk), the 4-channel relay module over the 2-channel (AUD 0.70 more), two I2C buses over a multiplexer (removes a module and a failure point), and a Mean Well module over an open-frame supply (encapsulation, 4.2 kVac isolation).

Two rows are worth reading against `REQ-COST-DISCIPLINE-001.C4`. The heater channels' parts are cheap and their failure is a hazard, which is exactly the combination that criterion says to weigh — and the answer is not a dearer SSR, since failing shorted is a property of the device class rather than of its price. **Overtaken by `DEC-PROOF-OF-LIFE-INTERLOCK-IN-FIRST-HARDWARE` (2026-10-18): the interlock is built into the first controller hardware, not deferred.** It is the series interlock, deferred and still outside this list, which will draw on the declared figure (the BOM prices the master relay at AUD 5 and the watchdog at AUD 60; the interconnect note puts the candidate unit at AUD 80–100). The steam-side relief question and the panel decision (D18) also sit partly outside the totals.

## Open items collected

[Superseded in part: items 1 to 9 and 11 are open items of the bought-module design; where one still bears on the live design its subject is held in `../controller-board-design-constraints.md` § Pending marks and in `../controller-board-function-forms.md` § Pending marks this record ended, and the live record is the root `../component-specification.md`; item 12 (the logic supply's internal fuse) is held with the logic supply in `../controller-board-design-constraints.md` § Carried-forward module properties, *Logic supply*, and item 10 is corrected in place.]

For the next reader, the items this refresh could not resolve from its inputs, all marked **to confirm** above:

1. OPEN DECISION: heater switching cadence (whole-cycle versus half-cycle): half-cycle (BOM, `DEC-MAINS-PHASED-ACTUATION-BELOW-SEAM`) versus whole-cycle (pin allocation).
2. EARU SSR zero-cross type, isolation rating, package and fail-short behaviour.
3. Whether the Standard dimmer's Z-C is full-wave, its output type and pulse width, and its optical isolation (the vendor page states no figure).
4. BL0942 module isolation (blocks connection), and whether the module needs TX (PC6 clash with S8).
5. D20: whether the BL0942 reading replaces the mains-presence confirm; two pins unassigned.
6. Allocation rows not yet verified: PA1, PA4 and PA6 ADC channels, PA10 and PB5 timer AFs; 5 V-tolerance of PB4, PB5, PA8, PD7, PD10, PD14, PD15, PA0 and PE4 to PE8; five unparsed header designators; QSPI pairing.
7. Gauge step-clock timing requirement versus plain-GPIO assignment.
8. Relay module input polarity; whether the valves are retained or replaced.
9. Pressure-sensor accuracy against the requirement; XDB401 3.3 V variant output rate and thread.
10. **Overtaken by `DEC-PROOF-OF-LIFE-INTERLOCK-IN-FIRST-HARDWARE` (2026-10-18): the interlock is built into the first controller hardware, not deferred.** `DEC-PREHARDWARE-TARGET-FAMILY` is superseded by `DEC-CONTROLLER-BASELINE-STM32H743`; whether the zero-cross enumeration has been amended, and whether the interlock now has covering work, are still to confirm.
11. Currency: BOM in AUD, declared spend in USD.
12. IRM-10-5 internal fuse.
