Resident-X/brew-state/docs/sunbeam-em7000/controller-design/controller-io-bom.csv

Ref | Option | Channel | Direction | Signal | Controller resource | Pins | Qty | Items | Status | Notes
T-A1 | NTC casing sensors (kept) | Coffee thermoblock temperature | In | Analogue resistance NTC 100k 2-wire | ADC channel (16-bit) + 4.7k low-TCR divider to VREF+/VDDA + 100nF | 1 | 1 | COFFEE NIC WIRE EM70025 (RT1) | Fitted (kept as casing sensor) | OEM sheet 3-3: 100k NTC against 10k 1% divider (R54-R56) + 100nF filter; sensitivity peak ~85-90 degC was for the 10k divider and is not re-derived for 4.7k (to confirm). Replacement divider 4.7k low-TCR (~25ppm/C) to VREF+/VDDA, ratiometric. Pin is one of PC0/PC1/PC4; which NTC is on which pin is not recorded (to confirm). Beta is pending (not yet read; it is read when the board carrying the device is designed and does not block the division of the circuitry into boards). Kept and calibrated in place against the outlet water probe (D10, Chosen)
T-A2 | NTC casing sensors (kept) | Steam thermoblock temperature | In | Analogue resistance NTC 2-wire | ADC channel (16-bit) + 4.7k low-TCR divider to VREF+/VDDA + 100nF | 1 | 1 | Steam SOLEPLATE THERMISTOR SR6000 EM70020 | Fitted (kept as casing sensor) | Same class as T-A1; pin is one of PC0/PC1/PC4 (D10, Chosen)
T-A3 | NTC casing sensors (kept) | Steam wand temperature | In | Analogue resistance NTC 2-wire | ADC channel (16-bit) + 4.7k low-TCR divider to VREF+/VDDA + 100nF | 1 | 1 | Steam Arm NTC WIRE EM70024 | Fitted (kept as casing sensor) | Conduction disc on wand exterior; stays an NTC (D10, Chosen); pin is one of PC0/PC1/PC4
T-C1 | PT1000 (selected) | Outlet water temperature (key sensor) | In | Analogue resistance PT1000 spike probe | ADC channel (16-bit) + own 4.7k low-TCR divider to VREF+/VDDA + 100nF | 1 | 1 | PT1000 spike probe, stainless, ~3mm x 30mm class, rated >=125C (150C preferred) and >=15bar, in a tee at the block outlet before the 3-way valve | Chosen; not yet fitted | D9 (Owner decision on placement; fitting detail Agreed): tee used as an elbow, probe in the opposite run port, tip facing upstream. Pin PA4 (ADC12_INP18 expected, NOT YET VERIFIED against DS12110 Table 9); PA4 is the DVP HSYNC pin, connector only, free in practice. About 0.54mA, 0.4mW self-heating, ~1.6mV/C at the 4.7k divider. Replaces the earlier plan of one MAX31865 per RTD, which is dropped (D10)
T-C2 | PT1000 (selected) | Commissioning PT1000 (temporary puck-inlet probe, plus a spare chip) | In | Analogue resistance PT1000 thin-film flat chip | ADC channel (16-bit) + 4.7k low-TCR divider to VREF+/VDDA + 100nF | 1 | 2 chips on 1 channel | PT1000 thin-film flat chip, Class A claimed, welded leads, rated >=250C | Chosen; commissioning tool only | D11 (Chosen). Pin PA1 (ADC1_INP17 expected, NOT YET VERIFIED); used for the puck-inlet probe during commissioning and as a spare channel afterwards. Not fitted to the blocks any more. The Class A claim is a label, not a test: check ~1090 ohm at room temperature and the ice and boiling points
T-C3 | PT1000 (selected) | Steam-output temperature monitor (permanent channel) | In | Analogue resistance PT1000 probe | ADC channel (16-bit) + own 4.7k low-TCR divider to VREF+/VDDA + 100nF | 1 | 1 | PT1000 probe at the steam output; type, rating (steam-side temperature) and placement NOT YET SPECIFIED | Chosen (channel only); probe not specified | D23 (Owner decision). Pin PA6 (ADC12_INP3 expected, NOT YET VERIFIED against DS12110 Table 9); PA6 is the DVP PIXCLK pin, connector only, free in practice. Reserved so the commissioning channel PA1 is not borrowed. Same divider and filtering as T-C1
P1 | Both | Steam-path pressure | In | I2C digital, XDB401 3.3V variant 0.5MPa, fixed address 0x7F | I2C2 (PB10 SCL / PB11 SDA, AF4) + 2x 4.7k pull-ups to 3V3 | 2 | 1 | XDB401 3.3V I2C, 0.5MPa (steam) | Chosen; not yet fitted | DEC-STEAM-PRESSURE-SENSOR-ADDED; D12 (Chosen). Tap per D14 (Owner decision): hairpin-clip tee between the steam block and the manual steam knob valve, 100-150mm downhill PTFE drop leg, sensor at the lowest point. Accuracy +/-1% FS (+/-0.05 bar), response <=4ms, overload 150% FS. Separate bus from the brew unit so both stay at 0x7F with no multiplexer. Replaces the earlier analogue ADC-channel entry (part had not been selected)
P2 | Both | Brew-path pressure | In | I2C digital, XDB401 3.3V variant 1.2MPa, fixed address 0x7F | I2C1 (PB8 SCL / PB9 SDA, AF4) + 2x 4.7k pull-ups to 3V3 | 2 | 1 | XDB401 3.3V I2C, 1.2MPa (brew) | Chosen; not yet fitted | REQ-MEASUREMENT-001.C7 (whether the graph now links this channel to it was not re-read, to confirm); D12 (Chosen), D13 (Agreed): direct tee on the cold side between the new brew OPV and the block, no leg. Accuracy +/-1% FS (+/-0.12 bar), response <=4ms. Replaces the earlier Proposed row that depended on the OPV return location
D1 | Both | Operator panel keys | In | Contact closure to ground, shared with the indicator cathodes on the same line | Bidirectional GPIO, open-drain, internal pull-up + 47R at the pin (PE4 PE5 PE6 PE7 PE8) | 5 | 5 keys / 10 switches | PWR MAN ONE TWO PRG | Fitted | Ten tact switches wired as five parallel pairs - a wide cap with a switch at each end - so the controller sees one signal per key. Each key's line ALSO carries its indicator cathodes, so these 5 pins are shared with O10 and are not additional to it. The anode rail must be blanked before reading. OEM sheet 3-3 (read 2026-10-12): 1k in series with each switch to ground and 47R at the MCU pin, NO pull-up drawn, so the OEM appears to rely on the MCU's own; this disagrees with the earlier reading of the 1k as a pull-up - check with a meter (to confirm). See docs/sunbeam-em7000/connector-pinouts.md
D2 | Both | Control knob microswitches | In | Contact closure to ground | GPIO in with pull-up (S7 on PE15, S8 on PC6) | 2 | 2 | S7 HOT and S8 STM on the L-panel and R-panel assemblies | Fitted | 250 V 3 A. Reach the board on their own wires, not through the front-panel harness. Ground-switched, 1k in series and 47R at the pin on the OEM schematic. S8 is the only thing that engages steam mode in the machine as found (Owner statement) and a candidate interlock for the steam heater
D3 | Both | Tank water level | In | Contact closure (reed/magnet) | GPIO in with pull-up (PE9) | 1 | 1 | S6 WAT tank level sensor | Fitted | Drawn as a plain switch alongside the knob microswitches rather than as a pushbutton. The reed element is soldered through holes to the original board (body on the back face and leads on the component face: inferred; the two aligned board photographs under `../photos/` show the `WAT` outline and a blob of insulating compound | not the element clearly) and is lifted or replaced like for like (reference-machine.md Controller enclosure as found)
D4 | Both | Flow meter | In | Digital pulse 5 V | Timer capture / counter input (PA8, TIM1_CH1, AF1) | 1 | 1 | Flow meter on coffee pump suction line via CZ1 | Fitted | Established digital from OEM sheet 3-3: 3-pin connector, R51 2k pull-up to VCC5, landing on a general-purpose port pin while the three analogue inputs are occupied by the thermistors. This supersedes an earlier reading of the same scan that placed it on analogue-labelled pins. STILL OPEN: open-drain vs push-pull (open-drain re-references to 3V3 by pull-up alone, push-pull needs a shifter), pending: not yet read; it is read when the board carrying the device is designed and does not block the division of the circuitry into boards; the K-factor in pulses per litre, and PA8's 5V tolerance - do not connect to PA8 until it is confirmed or the pull-up is moved to 3V3 at the controller end. PA8 AF0 is MCO1: confirm nothing drives MCO1 out of it. SOL-FLOW-METER-READING-AT-CONTROLLER.C1
D5 | Both | Mains zero-cross | In | Z-C output of the coffee-pump dimmer module, one edge per half-cycle (believed full-wave; output type and pulse width not published) | Timer input capture, rising edge, input filter + software noise gate (PA10, TIM1_CH3, AF1 expected - NOT YET VERIFIED) | 1 | 1 | Z-C of RBdimmer Standard module #1 (shared for the whole system) | Replaced (dimmer Z-C; D3) | Supersedes the half-wave OEM front end (D6 1N4007 in series with R5 120k 1W into U2 PC817, one polarity only), which goes with the OEM board. The Standard dimmer times both pumps' triac firing from this edge, supplies the supply period, and loss of it is a supply fault. The module #2 Z-C is NOT wired and the two are never tied together. The heater SSRs need no phase reference. Edge rate about 100/s at 50Hz is an acceptance test; scope the output on arrival. DEC-MAINS-PHASED-ACTUATION-BELOW-SEAM has not been amended to match - revision owed
D6 | Both | Coffee heater mains-presence confirm - under review | In | Opto-isolated AC sense (LTV814 via 120k 1W) on the machine as found; replacement undecided | GPIO in, isolated - UNASSIGNED | 1 | 1 | CFSIG to U3 PA2 | Under review (D20: Recommended, not decided) | OEM arrangement (machine as found): CFSIG to U3 PA2, senses mains actually present at the heater node - detects a relay that did not close, a welded contact or an open thermal cutout. It sits with the OEM relays and board being replaced. D20 (Recommended; not decided) replaces this binary bit with the BL0942 current reading, which loses localisation of 'did not close' versus 'open downstream'; keep a dedicated input only if the meters are dropped. REQ-ACTUATION-CONFIRMATION-001.C2 requires the confirmation available for each output, and the time it takes, to be established rather than assumed; this row establishes the AVAILABILITY half only on the machine as found, and the time it takes is measurement work
D7 | Both | Steam heater mains-presence confirm - under review | In | Opto-isolated AC sense (LTV814 via 120k 1W) on the machine as found; replacement undecided | GPIO in, isolated - UNASSIGNED | 1 | 1 | SMSIG to U3 PA1 | Under review (D20: Recommended, not decided) | OEM arrangement (machine as found): SMSIG to U3 PA1, senses mains actually present at the heater node - detects a relay that did not close, a welded contact or an open thermal cutout. It sits with the OEM relays and board being replaced. D20 (Recommended; not decided) replaces this binary bit with the BL0942 current reading, which loses localisation of 'did not close' versus 'open downstream'; keep a dedicated input only if the meters are dropped. REQ-ACTUATION-CONFIRMATION-001.C2 requires the confirmation available for each output, and the time it takes, to be established rather than assumed; this row establishes the AVAILABILITY half only on the machine as found, and the time it takes is measurement work
D8 | Both | Coffee heater energy meter | In | UART from BL0942 module (V, I, active power, energy), free-running | UART receive (PC7, USART6_RX, AF7) | 1 | 1 | BL0942 energy meter #1 in series with the coffee heater, upstream of the SSR | Chosen (D17); blocked on isolation test; no BOM row yet | BEFORE CONNECTING measure resistance between every header pin and every mains terminal - isolated reads open; treat as live until proven. Receive only may suffice (confirm whether the module needs commands; if so the PC6 TX option noted in the pin allocation collides with the S8 input assigned to PC6, to confirm). Packet 23 bytes / ~48ms at 4800bps. ZX pin not available on the module header. Slow integrated scalars; feeds the state estimator
D9 | Both | Steam heater energy meter | In | UART from BL0942 module (V, I, active power, energy), free-running | UART receive (PA3, USART2_RX, AF7) | 1 | 1 | BL0942 energy meter #2 in series with the steam heater, upstream of the SSR | Chosen (D17); blocked on isolation test; no BOM row yet | As D8. Optional TX on PA2 (USART2_TX, AF7) if the module needs commands
O1 | Both | Coffee thermoblock element | Out | Logic level to ULN2003A input, sinking the SSR control from 5V | GPIO push-pull (PB0), 10k pull-down at the ULN2003A input | 1 | 1 | COF HEATER, measured 1004 W at 230 V; EARU SSR-40DA #1 via ULN2003A OUT1 | Chosen (D2); not yet fitted | Element measured at 52.7 ohm cold, so 4.80 A continuous at 253 V, the declared span's top and the worst case (1004 W and ~4.4 A at 230 V nominal); the 1000 W circuit-diagram label is superseded by that measurement. SSR control + to the 5V rail, control - to ULN2003A OUT1; SSR needs 3-32VDC at 7.5-12mA so a 3V3 GPIO cannot drive it direct; the Darlington drops ~1V so the SSR sees ~4V (measure it). OPEN DECISION: heater switching cadence (whole-cycle versus half-cycle): the pin allocation toggles at whole-cycle granularity and this file's earlier rows say commandable per half-cycle. ZERO-CROSS TYPE IS LOAD-BEARING - confirm on EARU's own datasheet (to confirm). ~5-6.5W dissipation per channel: heatsink, or mount direct to the side wall (owner will try; proposed, not decided; superseded 2026-10-23: the owner's plan is to mount the heater switches outside the enclosure on the machine's metal wall (controller-board-design-constraints.md § Enclosure air temperature); the wall is plastic and unearthed as found (reference-machine.md § Controller enclosure as found)). Machine as found: mechanical relay, on/off only, not commandable within a half-cycle - the capability floor, replaced. PB0 TIM3_CH3 AF2 confirmed but unused as an AF
O2 | Both | Steam thermoblock element | Out | Logic level to ULN2003A input, sinking the SSR control from 5V | GPIO push-pull (PB1), 10k pull-down at the ULN2003A input | 1 | 1 | STM HEATER, measured 1126 W at 230 V; EARU SSR-40DA #2 via ULN2003A OUT2 | Chosen (D2); not yet fitted | Element measured at 47.0 ohm cold (a lower bound on the true resistance), so 5.38 A continuous at 253 V, the declared span's top and the worst case (1126 W and ~4.9 A at 230 V nominal) - the LARGER of the two, and what sizes the switching part for both channels; do not inherit the coffee channel's 4.80 A. Both together draw 10.18 A at 253 V, over the 10 A outlet rating the supply budget is spent against (reference-machine.md, Supply), which REQ-POWER-BUDGET-001 arbitrates against at that figure (REQ-POWER-BUDGET-001.C6). Machine as found: the same mechanical relay arrangement. PB1 TIM3_CH4 AF2 confirmed but unused as an AF
O3 | Both | Coffee pump | Out | Logic level phase-timed (active-high DIM pulse ~100us after a computed delay from zero-cross) | GPIO out fired from a timer compare (PA9), 10k DIM pull-down at the module header | 1 | 1 | RBdimmer 4A 1-ch Standard module #1 (MOC3021 random-phase opto-triac + BT136S 4A triac) | Chosen (D3); not yet fitted | Replaces the OEM COF PUMP stage (U5 MOC3021 + Q2 Z0409NF) in kind - phase-capable, random-phase. 1-2A slow-blow branch fuse in the module's AC-L in feed. The pump's thermal protector stays in series. Pump current 0.46A (coffee) and 0.19A (steam) at 253V (the sizing values under an assumed 0.5 power-factor floor) against the 4A triac (connector-pinouts.md Pumps: running current). TIM1_CH2 AF1 expected on PA9, not verified
O4 | Both | Steam pump | Out | Logic level phase-timed (active-high DIM pulse ~100us after a computed delay from zero-cross) | GPIO out fired from a timer compare (PD8), 10k DIM pull-down at the module header | 1 | 1 | RBdimmer 4A 1-ch Standard module #2; module Z-C NOT wired | Chosen (D3); not yet fitted | As O3 (OEM STM PUMP stage U7 MOC3021 + Q5 Z0409NF replaced). Phase-angle versus burst drive for the steam pump is OPEN (D4): bench test; the OEM is reported to drive it in software bursts (Published, unverified)
O5 | Both | Two-way solenoid valve (vent), normally open | Out | Logic level to mains-rated switch (energise = closed) | GPIO out (PD7) to relay module channel 1, 10k pull resistor at the module input | 1 | 1 | 2T0607W on a second coffee block outlet, via channel 1 of a 4-channel mechanical relay module + RC snubber | Chosen (D5, D6) | Mains AC coil (OEM sheet 3-2). NORMALLY OPEN to the drain: energised closed whenever the coffee pump is pumping through the block (the 30-40 s shot; also hot water; the pre-shot flush; dry-fill and identification runs), so it vents on power loss, fault, end of brew and whenever the block heats with no flow path (D6, Owner decision). Mechanical relay chosen over a triac or SSR because espresso solenoid coils draw about 39-59 mA at 230 V (the coil marking's 9-13.5 VA, ../connector-pinouts.md) against a BTA16 triac's maximum holding current of 60 mA, so a triac cannot reliably latch on them; the OEM's own split (triac for the pumps, mechanical relay for the valves) rests on the same physics. Relay contacts can weld. The vent being fail-safe is a separate point: normally open and de-energised on power loss (D6). SRD-05VDC coil 71.4mA each; JD-VCC jumper open, coils fed from their own 5V (286mA inrush); opto input 3.0-5.0V so 3V3 drives it direct; active-low typical (confirm). Snubber 100nF+220R with 10D471K across the CONTACTS; ~7.2mA flows with contacts open (230V over 100nF at 31.8k, 220R and the coil's 2.5k cold resistance) leaving ~18V on the coil taken as its cold resistance (the lower bound) to ~31-51V on the sealed coil (impedance 230^2/VA = 3.92-5.88k from the 9-13.5 VA marking, 7.95-8.63mA), 8-22 % of line, the plunger-open state between and not recorded, so 'de-energised' is not zero. Pull-resistor direction depends on module polarity: establish it first (SAFETY-CRITI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
O6 | Both | Three-way diverter solenoid (never closed) | Out | Logic level to mains-rated switch (energise = hot water outlet) | GPIO out (PD10) to relay module channel 2, 10k pull resistor at the module input | 1 | 1 | 3T0618W via channel 2 of the same relay module + RC snubber | Chosen (D5) | As O5. De-energised it connects the coffee block outlet to the group (brew path); energised it diverts to the hot water outlet; it is never closed (F1, Owner statement). Which schematic tag (COF VALVE or HOT VALVE) drives which physical valve on the OEM board is still not established. Spare relay channels 3 and 4 are PD14/PD15 (expansion, unused)
O7 | Both | Espresso gauge stepper | Out | Direction level + step clock to an inherited driver | Timer output (step) + GPIO (direction), via 74HCT541 level-up | 2 | 1 | MOT1 resistance-to-pour gauge | Fitted | The VID66-08 is on the GAUGE ASSEMBLY, not the main board - CONFIRMED by opening the machine and reading the part off that board, which also fits the 9-conductor harness closing only if the driver is local. Note the board silkscreens it U8 where the circuit diagram says U9; the manual has U8 and U9 swapped. If that board is retained the driver is inherited and the controller drives logic lines, not motor phases. Step clock needs a timer channel: a needle has inertia and an uneven rate reads as stutter. DRIVE LEVEL: the VID6608 datasheet puts Vih at 3.15 V min and Vil at 1.35 V max as absolute figures across its whole 4.5-5.5 V supply range. Its prose says the inputs carry level shifters so the part may run at a higher VDD than the logic driving it, but that decouples the threshold from the motor rail without lowering it. So a 3.3 V controller has 150 mV of margin at best and needs level shifting or a Voh guarantee checked against 3.15 V. In this design the five driver lines go through a 74HCT541 level-up (D19, Chosen), which clears the threshold. The pin allocation lists them as plain GPIO (PD0 PD1 PD4 PD5 PD6; roles not recorded), which does not provide the timer step clocks this row asks for (to confirm). Rising edge steps 1/12 degree of shaft rotation fixed in silicon; 450 ns min pulse; 100 ns direction setup; 20 ns glitch filter; speed ceiling 7.2 kHz, quoted against VID29 movements that MOT1/MOT2 have not been identified as. See docs/sunbeam-em7000/connector-pinouts.md
O8 | Both | Milk gauge stepper | Out | Direction level + step clock to the same inherited driver | Timer output (step) + GPIO (direction), via 74HCT541 level-up | 2 | 1 | MOT2 milk temperature gauge | Fitted | As O7, second channel of the same VID66-08 and under the same 3.15 V Vih obligation. The part is out of production, so retaining it makes an unobtainable device a single point of failure - an obtainability risk rather than a saving - and distinct from the unknown-condition question OBL-PHYSICAL-CONFIGURATION-001.C3 asks, which is answered by testing the part. Pins and buffer as O7
O9 | Both | Gauge driver reset | Out | Logic level | GPIO out via 74HCT541 | 1 | 1 | RST on the VID66-08 | Fitted | Resets the driver's phase counter but does not establish needle position. Active low and SHARED across both channels - neither gauge can be reset alone. The datasheet asks it be held low while VDD rises and released about 1 ms after the supply settles, so a replacement owes that at power-on, and it asks for an external pull-down to hold the line low through start-up - a part on the board, not just firmware ordering. Both movements have hard end stops and the machine sweeps to full scale and back to zero at power-on, so a replacement owes the same homing routine - without it a step count runs from an unknown origin and the needles read plausibly and wrongly. Counting steps between stops also yields steps-per-sweep, which no document carries. No reset pull-down appears in passive-and-drive-components.csv and the buffer's /OE pull-ups leave the line high-impedance at boot; whether a pull-down is fitted is to confirm
O10 | Both | Panel indicator elements | Out | Logic level sink | Shares the 5 bidirectional lines of D1 - no pins of its own | 0 | 8 elements / 5 groups | PWR x1 MAN x2 ONE x1 TWO x2 PRG x2 | Fitted | Count settled at 8 elements across 5 functions by tracing the physical panel board. The circuit diagram's sixth function, WATER, is a real indicator but sits on the gauge assembly - see O13. Each group's cathodes share the line carrying its key, so the indicators cost no pin beyond D1's five. ~300 ohm series resistors are on the panel and stay with it. See docs/sunbeam-em7000/connector-pinouts.md. Realised on PE4-PE8. Sink current per element is pending with the forward voltage (not yet read; it is read when the board carrying the device is designed and does not block the division of the circuitry into boards): when it is recorded check the pin's rated sink or sink through spare ULN2003A channels (to confirm)
O12 | Both | Panel indicator anode rail gate | Out | Logic level to a rail-switching transistor | Timer / PWM output (PB5, TIM3_CH2 AF2 expected - NOT YET VERIFIED), open-drain into a copy of the OEM Q7 stage | 1 | 1 | Common anode rail for all five indicator groups (OEM Q7) | Fitted function; stage rebuilt (D18: Recommended) | THE MULTIPLEXING GATE, not an ornament: the rail must be blanked to read the keys, because each line carries both. It is also how brightness is modulated - globally rather than per line, which is why the PWR element appears to ramp alone while heating (it is the only one lit). ONE timer output for the panel, not one per line - and the same rail is extended over the gauge harness to the low-water indicator of O13, so this single gate covers every indicator on the machine. It costs a second connector pin there, not a second controller pin. See docs/sunbeam-em7000/connector-pinouts.md. Q7 stage: 2N5401 PNP, emitter on 5V, base through 2k from the pin and 100k to 5V; driven open-drain (low = on), so PB5 is to be verified 5V-tolerant (PB4, PB5; see open-items.md section B) in DS12110, or put an NPN level shifter in front
O11 | Both | Buzzer | Out | Logic level to a driver stage | GPIO out (PB4), open-drain into a copy of the OEM Q8 stage | 1 | 1 | Sounder on the front panel near the pushbuttons | Fitted function; stage rebuilt (D18: Recommended) | Was absent from controller-io.md, reference-machine.md and the graph; now enumerated. Drive stage is on the main board being replaced, which is why the sounder takes two harness conductors but only one controller pin. Magnetic (needs a drive waveform) vs self-driving piezo (needs on/off only) is pending (not yet read; it is read when the board carrying the device is designed and does not block the division of the circuitry into boards). It is one mechanism by which the machine tells the operator something, and it is the audible half of low-water annunciation - but NO criterion requires an audible channel specifically, so do not read this row as coverage of one. Q8 stage: 2N5401 PNP, emitter on 5V, base through 1k from the pin and 10k to 5V, buzzer then 100R to ground, no diode. Open-drain drive needs PB4 to be verified 5V-tolerant (PB4, PB5; see open-items.md section B). PB4 defaults to NJTRST: release in firmware. A tone must not share TIM3 with the PB5 gate PWM
O13 | Both | Low-water indicator | Out | Logic level sinking an indicator cathode | GPIO out, open-drain (PA0) | 1 | 1 | WATER indicator on the gauge assembly | Fitted | Was absent from controller-io.md and the graph; the fourth such channel found on this branch. Modulated rather than merely switched - observed to dim and brighten in step with the PWR element, which places it on the SAME gated rail as the button panel, extended over the gauge harness on that harness's contact 7. An earlier row here had it on a separate supply, on an observation of the same machine that has since been corrected. It is the visual half of a low-water annunciation whose audible half is the buzzer; keeping one and dropping the other degrades the annunciation without removing it. Two elements share the one cathode (sink current pending with the forward voltage: not yet read; it is read when the board carrying the device is designed and does not block the division of the circuitry into boards); the anode is on the gated 5V rail, so the pin must be open-drain, not push-pull. 47R series at the pin on the OEM. Contact 6 of the gauge harness, measured (connector-pinouts.md)
U1 | Both | Operator display link | Bidir | UART or bespoke 2-wire | UART peripheral | 2 | 1 | Serial display board | Undecided; the retained-panel alternative no longer arises | Conservative figure is direct drive. The OEM CMDTX/SLVOK pair is not an inter-board link: both microcontrollers are on the main board, so those two wires connect two chips this project replaces and the panel board is retained but carries no controller to speak to. A display is a separate question this row does not settle. The H743 board's own 0.96in TFT is unused by this design
O14 | Both | Spare valve relay channels | Out | Logic level | GPIO out (PD14, PD15) to relay module channels 3 and 4 | 2 | 2 | Spare channels of the 4-channel relay module | Chosen (D5); unused expansion | 4ch chosen over 2ch for AUD 0.70, so channel headroom is free; a snubber is added per extra valve only if a spare channel is ever used
