Resident-X/brew-state/docs/sunbeam-em7000/controller-design/control-system-bom.csv

Item | Qty | Channel | Location | L_mm | W_mm | H_mm | Area_mm2 | Rail | mA | Cost_AUD_ea | Dim_status | Note | User Note
WeAct MiniSTM32H743 (STM32H743VIT6) | 1 | controller | box | 66.88 | 40.64 | ? | 2718 | 3V3-5V5 in / 3V3 out | 117 | 20 | L-W confirmed from WeAct repo / H estimated | 40.64x66.88mm, LQFP100, 480MHz, 3x 16-bit ADC. Headers are DOUBLE ROW on both edges - 2 headers x 2 rows x ~22 positions, so 74 GPIO of the LQFP100 are on the headers (the only port pins not on a header are PC13 and PE3). Header footprint (WeAct BoardShape V12 drawing, read 2026-10-12): two columns on each long edge, 22 rows at 2.54mm pitch, columns 2.54mm apart, inner columns 33.02mm apart and outer columns 38.10mm apart, first row 6.77mm from each end (88 holes, plus a separate 4-pin SWD header, which is the 92 positions of the header map). Mounting holes 3.1mm, 2.54mm in from the side edges and 2.75mm from the ends, on 35.56 x 61.38mm centres. Pin count is NOT a constraint (37 of the 74 header GPIO are assigned in h743-pin-allocation.csv). Onboard DC-DC accepts 3.3-5.5V in, 1A max - a 1A onboard DC-DC for the 3V3 rail. H is PCB+header+DuPont+standoff; right-angle headers cut it to ~10mm. Carries an unused 0.96in TFT, microSD, 8MB QSPI + 8MB SPI flash and a DVP port - they cost pins and height, not function. Do not buy the H750VBT6 variant - same board, 128KB flash. HEIGHT CAUTION: double-row headers make the right-angle trick awkward - the inner row has nowhere to go. Budget for vertical headers plus DuPont unless the inner row is left unpopulated. | Swapped for better ADCs in-case we need them
74HCT541 octal buffer | 1 | E3 gauge lines | box | k m | 6.35 | 3.6 | 161 | 5V | 1 | 1 | confirmed | DIP-20. No commercial breakout exists - goes on the perfboard. Removes the 5V-tolerance requirement on the 5 gauge pins.
Perfboard (buffer + sensor dividers + connector landings) | 1 | E3/E5/E6 passives | box | 90 | 70 | 1.6 | 6300 | - | 0 | 3 | RECOMMENDED size, estimated from the parts and connector count, NOT laid out. Price is an estimate | DECIDED: the H743 plugs into female header strips soldered to this board (not soldered straight in), so it is swappable and its under-module space holds the low parts. Double-sided plated-through-hole, 2.54mm pitch, FR4 1.6mm, 7x9cm. Carries: the 74HCT541 (socketed) with its 100nF decoupling and two 10k /OE pull-ups (gauge line buffer); the 5 sensor dividers (2 PT1000 and 3 NTC, 4.7k low-TCR + 100nF each); the 4 I2C pull-ups (4.7k, two per bus); about 4 general 100nF decoupling caps; and the landing headers or pluggable terminals for every harness (NTCs, two pressure sensors, gauge and panel harnesses, relay module, flow meter, BL0942 UART, dimmer Z-C/DIM, ULN2003A inputs). Optional, only if needed: flow-meter pull-up and RC, BL0942 RX pull-ups, dimmer-line series resistors, button debounce caps. NOT on it: the ULN2003A (its own breakout board, with its two 10k pull-downs at that board's header), the relay-input pull resistors (at the relay module's input pins), and the DIM pull-downs (at the dimmer module headers). Board has no onboard analog conditioning. The old 80x20mm was flagged tight and the connector landings were not counted in it: rough parts area is about 1500 mm2 and perfboard packing is typically a third, hence about 6000 mm2. SELV ONLY - no mains conductor goes on this board. If the H743 is plugged into female headers on it, the board's area is shared and the cavity total drops by the H743's 2718 mm2; side by side, the 130x130 cavity runs roughly 80% full with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
EARU SSR-40DA solid state relay | 2 | E10 heaters | mains | 60 | 45 | 24 | 2700 | 5V ctrl (via ULN2003A) | 12 | 15 | dimensions NOT confirmed for EARU - assumed same standard SSR-xxDA package as the Fotek it replaces | Replaces Fotek SSR-25DA: counterfeit Foteks are rife and a fake 40A part often cannot do 10A. EARU is a brand store with traceable provenance. 40A vs 4.36A/4.89A load at 230V (4.80A/5.38A at 253V). ZERO-CROSS TYPE IS LOAD-BEARING - the drive scheme in heater-drive-and-supply-timing.md depends on it and a random-phase part reopens the whole zero-cross question; confirm on EARU's own datasheet, not the generic SSR-40DA class spec. CONTROL DRIVE: 3-32VDC, 7.5-12mA trigger. 3.3V is the BOTTOM of that range and an STM32 pin sourcing 12mA sags below its rail - do NOT drive direct from a 3V3 GPIO. Drive it low-side from the ULN2003A breakout (D2): SSR control + to the 5V rail, control - to the ULN2003A output, and a 10k pull-down at each breakout input. Dissipation is set by the junction drop, not the current rating, so the 40A part does not reduce the heatsinking owed - a larger die may give ~1.0-1.2V instead of 1.2-1.4V, so ~5-6W rather than 6.5W.
SSR heatsink | 2 | E10 heaters | mains | 80 | 50 | 50 | 4000 | - | 0 | 10 | inferred | Required - ~5-6.5W per channel. Combined H ~74mm so mains area only. This dissipation is the price of burst firing (cadence is an open decision); OEM relays paid ~0.1W for coarse on/off. | Will try mounting direct to metal side wall so not required if that mounting is adopted (proposed, not decided)
RBdimmer AC Dimmer 4A 1ch, STANDARD (Z-C/DIM header) | 2 | pump | mains | 50 | 16 | TBD | 800 | 3V3 | TBD | TBD | L-W 50x16 and terminal labels (AC-N / AC-L in / AC-L load) from the owner's product photo and listing. H = screw-terminal block + PCB thickness, NOT measured. Price of the Standard variant not yet checked | One per pump. STANDARD variant chosen over DimmerLink: the controller times the triac itself from the module's Z-C output, which gives both phase-angle and whole-cycle burst control, a supply-period reference, and a drive that stops when firing stops. Header GND/VCC/Z-C/DIM. Screw terminals: AC-N (neutral, the zero-cross reference - carries almost no current; the pump's own neutral goes to the neutral bus, not through the module), AC-L in, AC-L load. MOC3021 confirmed random-phase so genuine phase-cut. BT136S triac (SMD D2PAK, 4A) vs 0.1-0.22A pump current - no heatsink needed. BT136 is the NON-isolated-tab type, so the PCB copper under the triac sits at MT2 and is LIVE - clearance matters when mounting. TIMING IS OURS: from the vendor's ESP32 library, DIM is ACTIVE-HIGH (a high level fires the triac, low idles it), the gate pulse is 100us, the minimum delay after zero-cross is 100us, and the Z-C interrupt is on the RISING edge with a 3000us noise gate to reject triac switching spikes. The library is a reference, not this board's specification: Z-C output type (open-collector or push-pull), pulse width and polarity are NOT published - scope them on arrival. One Z-C serves both pumps (use one module's Z-C only; do not tie the two together). Loss of AC-N or of Z-C removes the timing reference, so firmware must stop firing and raise a fault. FUSE: 1-2A slow-blow in each module's AC-L in feed - it protects the 4A triac and the thin pump leads, which the T10A trunk fuse does not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
Mechanical relay module 4ch | 1 | E12 valves + expansion | mains | 73 | 54 | 20 | 3942 | 5V | 286 | 6.40 | confirmed | CHOSEN. Core Electronics. Only AUD 0.70 over the 2ch so channel headroom is free. SRD-05VDC coil is 71.4mA / 70R / 360mW each. Open JD-VCC jumper to feed coil current from its own 5V rail so 286 mA of steady coil current for four relays cannot sag the logic rail. Opto input triggers 3.0-5.0V so 3.3V GPIO drives it direct. No snubber fitted. Pin cost +2 from spare pool. 8ch exists (91x57mm) but jumps to AUD 22 and 571mA - not warranted.
RC snubber + MOV module (100nF/220R + 10D471K) | 2 | E12 valves ONLY | mains | 30.8 | 13.6 | TBD | 419 | - | 0 | 3 | L-W confirmed from product photo / H not found | Two needed: one per solenoid valve (the 3-way diverter and the 2-way vent), matching the two snubbed relay channels in module-interconnect.csv; add one per extra valve channel only if a spare channel is ever used. Prebuilt module: 100nF 630V X-class series 220R, in parallel with a 10D471K varistor, on a 2-way screw terminal. 220R is BETTER than the 100R previously specified - it limits the cap discharge surge into closing contacts to 1.5A at 325V peak instead of 3.3A. The 470V varistor is correct HERE (across contacts it must not conduct at normal line peak) even though the mains-inlet MOV is deliberately the lower 275VAC/431 class - different job. NOTE: 100nF is 31.8k at 50Hz, in series with the 220R and the 5.9k solenoid coil, so about 7.1mA flows with the contacts OPEN, leaving about 42V permanently across the coil. Not enough to hold a valve in, but 'de-energised' is no longer zero - relevant to the fail-safe vent hypothesis and to servicing isolation. Not fitted on any generic relay module. DO NOT FIT THESE TO THE PUMP TRIACS. 100nF passes ~7.2mA at 50Hz and a BT136's holding current is only ~10-25mA by grade, so this module risks latching the triac permanently on. A triac snubber, if one is ever needed, is a much smaller RC (about 39R+10nF or 100R+47nF, 0.7-3.4mA) fitted MT1-MT2 - a different device for a different problem.
XDB401 3.3V I2C | 2 | E7 pressure | plumbing | TBD | TBD | TBD | - | 3V3 | 5 | 30 | thread UNCONFIRMED (G1/4 BSP assumed; the datasheet lists NPT1/8 and NPT1/4; confirm with the seller) | G1/4 BSP is UNCONFIRMED (the sheet lists NPT1/8 and NPT1/4 as standard; confirm with the seller). Same body across ranges and across I2C/analog variants. 1.2MPa brew / 0.5MPa steam. Fixed 0x7F address. DATASHEET (owner-supplied, generic XDB401 family; the 3.3V I2C variant falls under 'others on request', so confirm its output rate and its thread with the seller - the sheet lists NPT1/8 and NPT1/4 as standard): accuracy +/-1% FS (brew 1.2MPa: +/-0.12 bar; steam 0.5MPa: +/-0.05 bar), response time <=4 ms, operating temperature -40 to 105C, compensated range -20 to 80C with drift <=+/-0.03% FS per C, overload 150% FS, burst 300% FS, IP65, 304 stainless, insulation resistance >100 MOhm, long-term stability <=0.2% FS per year, current <=3 mA. CONSEQUENCES: the STEAM tap sits behind a 100-150mm downhill PTFE condensate drop leg with the sensor at the lowest point (D14), so the sensor sees near-ambient water and not steam (saturated steam at 150C and up is far above the 105C limit); a stainless capillary is the fallback. A brew tap AFTER the block sees about 95C, outside the compensated range, adds up to about +/-0.9% FS of extra drift at 95C (about 0.1 bar on the brew sensor), and the 110C coffee thermostat trip is above the 105C limit, so it also needs a capillary. A brew tap BEFORE the block (between the new brew OPV and the block, cold water) sits inside the compensated range and needs none - the chosen placement (D13, Agreed). Steam overpressure check, gauge and absolute labe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
[RETAINED] Mechanical OPV, steam line (directly on the steam pump outlet, discharges to the drip tray) | 1 | steam line | plumbing | TBD | TBD | TBD | - | - | 0 | 30 | not published | Listed whether or not it is replaced. Base machine: fitted directly on the steam pump, on the cold water side, opening at about 4-5 bar and discharging cold water to the drip tray; it limits the maximum for safety (it caps the block only if no check valve lies between it and the block, to be inspected), and the steam block heater is off when no steam is drawn so the pressure falls (owner statement 2026-10-11, not yet confirmed on the machine). It sits downstream of the pump's own check valve (owner statement), so if no check valve lies between it and the block (to be inspected) it also opens when the block pressure rises and caps it at its setting; what reaches the tray may then be hot water or steam, not only cold water. Setting: about 4-5 bar (the earlier row said ~5, the owner says 4-5; read it off the part). The steam sensor (XDB401 0.5MPa, overload 150%) full scale is a coordinated pair with it. It caps the block pressure only if no check valve lies between it and the block (to be inspected); otherwise the block is bounded by the 200C thermostat (about 15.5 bar absolute, about 17 bar absolute at the thermostat tolerance) and the OPV limits only the cold pump side. Whether a check valve lies between it and the block is not established (to be inspected). Price is an estimate (a replacement), not looked up.
[NEW] Mechanical OPV, brew line (pump outlet side, discharges to the drip tray) | 1 | brew line | plumbing | TBD | TBD | TBD | - | - | 0 | 30 | not published | The base machine's brew pump has a damper and NO OPV (owner statement 2026-10-11, not yet confirmed on the machine; the earlier 'OPV before the block' was where the new one would go. The parts list's RELIEF ADAPTER BRASS is only an extension tube between the block and the 2-way, so the base machine has no brew relief device). Listed because the graph caps brew pressure mechanically (DEC-PROFILE-COMMANDS-FLOW) and the pump alone does not. Position (our choice): between the pump and damper and the block, cold side, with a discharge hose to the drip tray; the brew pressure tap sits between it and the block. Setting TBD: above the highest profile pressure, below the pump's maximum and the XDB401 1.2MPa sensor's overload; adjustable type preferred so it can be set against a blocked outlet with the sensor. Thread and body size not published (TBD). Price is an estimate, not looked up.
[RETAINED] Membrane pulsation damper, brew line | 1 | brew line | plumbing | TBD | TBD | TBD | - | - | 0 | 0 | retained, not bought | The base machine's brew pump has a damper (owner statement 2026-10-11, not yet confirmed on the machine). Listed whether or not it is replaced. It sits on the pump, so the cold-side brew tap downstream sees the damped pressure; what it hides of the pump's ripple is settled in commissioning. Rated for the brew OPV setting plus margin. Replacement price not looked up.
[NOT FITTED - decided] Membrane pulsation damper, steam line | 0 | steam line | plumbing | TBD | TBD | TBD | - | - | 0 | 0 | not fitted | Owner decision 2026-10-11, after an Opus-agent reasoning review (reasoning only, assumed numbers, not measured): do not fit one. The base machine has none. The pump's strokes are small against the block and its steam volume; the dry-steam limit is set by heater power; a damper adds compliance that slows the pressure and flow response and is the textbook trigger for boiling-channel pressure-drop oscillation; the sensors' ripple is removed by averaging over whole mains cycles. Revisit if bench logs show the pump-outlet peaks cracking the steam OPV at the working flow, wet-steam bursts locked to the pump strokes, or slow burst drive being forced. Prefer phase-angle drive or bursts of 10 Hz or more. Bench tests: log pressure at 2 kHz or faster at both ends, and weigh steam into a cup of water to find where it turns wet. The row stays so the decision is visible.
[NEW] Tee and fitting for the brew OPV (cold side), plus drain hose from the OPV to the drip tray | 1 | E7 pressure | plumbing | - | - | - | 0 | - | 0 | 8 | not bought yet | Thread to match the brew pump outlet line - NOT YET MEASURED. New plumbing for the part the base machine lacks. The retained steam OPV already discharges to the tray, and the steam damper is not fitted.
[RETAINED] Water tank, 3 L | 1 | water path | plumbing | - | - | - | 0 | - | 0 | 0 | retained, not bought | 3 L from the machine's EM7000 specification (reference-machine.md, parts list). Listed for the line order, tank first.
[RETAINED] Tank level sensor (reed/magnet), schematic S6 / WAT | 1 | E1 water path | plumbing | - | - | - | 0 | - | 0 | 0 | retained, not bought | Read as a controller input. Wiring route not yet bench-verified (reference-machine.md). On PE9 in h743-pin-allocation.csv.
[RETAINED] Flow meter on the suction line, about 5-7 cm ahead of the coffee pump | 1 | E8 water path | plumbing | - | - | - | 0 | - | 0 | 0 | retained, not bought | Position is an owner statement (reference-machine.md). Output type (push-pull or open-drain) and the K-factor are unmeasured; the OEM signal has a 5 V pull-up, so level handling into the controller is to be settled (PA8).
[RETAINED] Coffee pump, Ulka EP5, serves brew and hot water | 1 | water path | plumbing | - | - | - | 0 | - | 0 | 0 | retained, not bought | Nameplate 15 bar, 48 W (reference-machine.md). Contains a check valve (owner statement 2026-10-11, not yet confirmed on the machine). The pumps are expected to change as the design settles; if replaced, change this tag to [REPLACE]. Driven by the Standard dimmer row above.
[RETAINED] Steam pump, JYPC-4 | 1 | water path | plumbing | - | - | - | 0 | - | 0 | 0 | retained, not bought | 22 W; the variant fitted and its 4 bar rating are not confirmed (reference-machine.md). Contains a check valve (owner statement 2026-10-11, not yet confirmed on the machine). Feeds only the steam thermoblock, with the steam OPV directly on its outlet. How it draws from the tank (shared suction line or not) is not established. No flow meter on this path.
[RETAINED] Check valves: one inside each pump | 2 | water path | plumbing | - | - | - | 0 | - | 0 | 0 | retained, not bought | Owner statement 2026-10-11: the pumps have check valves and no discrete check valve is visible; any others would be inside the thermoblocks (unestablished, to be opened and looked at). No separate check valve is bought unless commissioning shows one is missing.
[RETAINED] Coffee thermoblock with its NTC (EM70025) | 1 | E5 coffee block | plumbing | - | - | - | 0 | - | 0 | 0 | retained, not bought | Brew and hot water both draw from this block; outlet goes to the 3-way valve and also to a second outlet running to the 2-way vent (owner statement). The NTC is kept as the casing sensor.
[RETAINED] Brass extension tube ('RELIEF ADAPTER BRASS' in the parts list) between the coffee block and the 2-way vent valve | 1 | water path | plumbing | - | - | - | 0 | - | 0 | 0 | retained, not bought | Owner statement 2026-10-11, not yet confirmed on the machine: despite the parts-list name it is only an extension tube between the block and the 2-way, not a relief valve, so the base machine has no relief device on the coffee side. Listed so the line order is complete; it is also a natural place for the vent-branch test tee.
[RETAINED] Steam thermoblock with its thermistor (EM70020) | 1 | E5 steam block | plumbing | - | - | - | 0 | - | 0 | 0 | retained, not bought | Heater off when no steam is drawn (owner statement). Outlet leads to the manual steam knob valve and the wand.
[RETAINED] Steam wand with its NTC disc (EM70024) | 1 | E5 wand | plumbing | - | - | - | 0 | - | 0 | 0 | retained, not bought | The disc's behaviour is a hypothesis in reference-machine.md; it stays an NTC.
[RETAINED] Manual steam knob valve (2-way) with microswitch S8 | 1 | E1 steam path | plumbing | - | - | - | 0 | - | 0 | 0 | retained, not bought | Owner statement 2026-10-11, not yet confirmed on the machine: a manual two-way valve between the steam block and the wand; the knob also triggers the microswitch that is the only thing that engages steam mode. The steam pressure tap sits between the block and this valve. S8 is on PC6 in h743-pin-allocation.csv.
[RETAINED] Group head, portafilter, basket, hot-water arm | 1 | outlet | plumbing | - | - | - | 0 | - | 0 | 0 | retained, not bought | The group head is the brass outlet joined to the coffee block. The hot-water arm is fed by the 3-way valve.
Master relay [DEFERRED] | 1 | safety interlock | mains | 32 | 27.6 | 25.5 | 883 | 5V | 180 | 5 | inferred | Songle SLA-05VDC 30A. Buy a variant with aux contacts. Cannot be the trip decider - firmware may not be in the protective path.
Watchdog module [DEFERRED] | 1 | safety interlock | mains | TBD | TBD | TBD | - | 5V | TBD | 60 | pending | Jaycar/Freetronics XC4267. Holds the master relay coil. 1 or 5 min timeout is coarse vs the 10-50ms discussed. Deferred - bench operation is supervised.
PT1000 spike probe, stainless, for the water at the block outlet (3mm x 30mm class), PTFE/FEP leads rated 150C or more | 1 | E6 outlet water | plumbing | - | - | - | 0 | - | 0 | 12 | - | THE KEY TEMPERATURE SENSOR: the controlled variable (REQ-BREW-TEMP-001.C2) is the water, and this reads it directly. Placed at the BLOCK OUTLET, BEFORE the 3-way valve: it sees both brew and hot-water flow, has the least transport delay for the control loop, and keeps the downstream loss (valve, tubes, the hot bore) a modelled, identified quantity. Must be a PT1000 (a PT100 would need a different divider). Rating: element, sheath and leads at least 125C, 150C preferred (the coffee thermostat trips at 110C, so 200C is NOT needed; PVC-lead probes at 105C are not enough); pressure at least 15 bar. Own 4.7k divider on PA4 (ADC channel not yet verified). Mounted in a standard tee used as an elbow straight at the block outlet (flow in one run port, out the branch to the 3-way valve, probe in the opposite run port pointing back into the oncoming flow so the tip faces upstream with the sheath along the flow axis, about 20mm immersed), fitting and sheath insulated from the casing - stagnant water at rest cools toward ambient, so the first water of a draw is a short cooled-stub transient and the probe is NOT a rest-state reference for the NTCs. Calibrate it carefully (ice and boiling point on the real chain, pressure-corrected). A short hot-water pre-flush conditions it. Price is an estimate, not looked up.
Tee fitting for the water probe at the block outlet (before the 3-way valve; used as an elbow, probe facing upstream) | 1 | E6 outlet water | plumbing | - | - | - | 0 | - | 0 | 6 | - | Thread to match the machine's line at the block outlet - NOT YET MEASURED. Used as an elbow: the block outlet goes into one run port, the branch goes on to the 3-way valve, and the opposite run port carries the probe gland with the probe pointing back into the oncoming flow. The flow turns at the tee, which mixes it (a heated laminar stream is cooler at the core than its mixed average), and the tip faces upstream with the sheath behind it. The only dead volume is the gap behind the branch around the sheath. Fit it straight in the block outlet and insulate it from the casing. A Y with an upstream-facing angled probe port is the second choice and a plain T with a cross-flow probe is to be avoided. General instrumentation practice, not yet checked on this block; the outlet port's thread is unmeasured. Brass (lead-free) or stainless, rated 15 bar and 125C or more. Thread seal rated for hot water. Price is an estimate, not looked up.
[NEW] Compression gland adaptor for the water probe (3mm sheath into the tee run port) | 1 | E6 outlet water | plumbing | - | - | - | 0 | - | 0 | 8 | - | Thread to match the tee's run port - NOT YET MEASURED. Compression gland (olive and nut, or a probe adaptor with an O-ring) for a 3mm sheath, rated 15 bar and 125C or more; the probe must not be able to push out under pressure. Price is an estimate, not looked up.
Silicone sleeving or high-temperature foam for the probe stub and fitting | 1 | E6 outlet water | plumbing | - | - | - | 0 | - | 0 | 5 | - | Slows the stagnant-water cooling at the probe and cuts heat carried away by the sheath. A thin layer on a small tube helps little (critical-radius effect: 10mm of foam on a 6mm tube improves the loss by only about 10%), so keep the stub short rather than relying on insulation. Price is an estimate, not looked up.
Tee fittings for pressure taps, normal hairpin-clip style (or brass/stainless equivalent), one brew line and one steam line | 2 | E7 pressure | plumbing | - | - | - | 0 | - | 0 | 6 | - | Thread to match each line - NOT YET MEASURED. Hairpin-clip push-in style if the OEM lines use it; its temperature rating at steam is unconfirmed. BREW tap (REQ-MEASUREMENT-001.C7): cold side, between the new brew OPV and the block (the base machine has no brew OPV, owner statement 2026-10-11), direct tee with no leg, so it sees the pressure that opens the OPV and the pressure the block and puck get, and lets the OPV setting be checked in place against a blocked outlet; the block, valve and tube drop is estimated at hundredths of a bar at espresso flow (unmeasured). STEAM tap (REQ-MEASUREMENT-001.C8, DEC-STEAM-PRESSURE-SENSOR-ADDED): in the line between the steam block and the manual steam knob valve (owner statement), upstream of the valve so a closed valve stops milk suck-back reaching the tap, with the drop-leg tube below it; it reads the pressure in the block, not the pump side (a cold-side steam tap adds the unmeasured two-phase block drop). Steam tee rating: saturated steam at the 200C thermostat trip, about 15.5 bar absolute (reference-machine.md); the steam OPV is downstream of the pump's check valve and caps the block at its 4-5 bar setting if no check valve lies between it and the block (to be inspected); until that is seen, size to the steam thermostat trip. If confirmed, size to at least 160C and 8-10 bar (saturated steam at 4-5 bar gauge is about 152-159C). Price is an estimate, not looked up.
Drop-leg tube for the steam pressure tap: PTFE matched to the OEM steam or brew PTFE size and wall (measure OD and ID), 100-150mm per sensor (buy 0.5m); stainless 304/316 capillary 3mm OD x 1.5mm ID, 300mm, as the fallback | 1 | E7 pressure | plumbing | - | - | - | 0 | - | 0 | 10 | - | A plain drop leg DOWNHILL from the steam tee, no rising section, sensor at the lowest point so air rises back into the steam line. The leg fills with condensate (distilled, no scale): the sensor sees water at near ambient and the pressure is transmitted through the water/steam boundary. Estimated from textbook properties, not measured: heat penetrates a stagnant water column only mm to about 1cm in minutes, so 100-150mm keeps the sensor end cool; check with the spare commissioning chip on the tube next to the sensor (aim under about 60C, the sensor is compensated to 80C). Route it away from the block and other hot parts so the seal does not boil off. About 2ml for 150mm if the bore is 4mm; the OEM tube's bore is not yet measured, and a 4mm OD tube holds less. One leg only: the brew tap has none. PTFE is acceptable only if its pressure rating at the hot-side maximum is confirmed with the supplier: the steam OPV caps the block only if no check valve lies between it and the block (to be inspected) (otherwise the pressure after the block is the saturation pressure at the block temperature, about 15.5 bar absolute at the 200C trip, far less at normal steam temperatures; if it does cap at 4-5 bar gauge, the steam is about 152-159C, so rate to at least 160C and 8-10 bar), the OEM steam line is already PTFE, the OEM tube size and joint method are matched, and the real maximum block temperature is established; if not, use the stainless capillary or 4mm metal tube. Replace the leg at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
Adaptors to land the pressure sensors on G1/4 BSP: tee branch thread to G1/4 female (brew), drop-leg tube to G1/4 female (steam), plus hot-water thread seal; compression olives and nuts only if the capillary fallback is used | 2 | E7 pressure | plumbing | - | - | - | 0 | - | 0 | 20 | - | One adaptor per sensor. Brew: from the tee's branch thread to the XDB401's G1/4 BSP. Steam: from the drop-leg tube (use the OEM joint method on PTFE; PTFE creeps under ferrules) to G1/4. If the stainless capillary is used instead, buy two compression sets (olives, nuts) for the tee and the sensor ends. Thread sizes on the machine side are NOT YET MEASURED, so the exact adaptors are settled when the lines are measured. Steam side rated for saturated steam at the 200C thermostat trip (about 15.5 bar absolute, about 17 bar absolute at the thermostat tolerance) until the check valve question is settled; if the OPV caps the block, at least 160C and 8-10 bar. Price is an estimate, not looked up.
[RETAINED] Solenoid valve 3-way [FUTURE] | 1 | brew / hot-water diverter | plumbing | TBD | TBD | TBD | - | 230VAC | 39 | 25 | thread not verified on the machine | 1/8 BSP female. SPEC TO MATCH: 230VAC 8-9W, orifice 1.5-2.3mm, 12-30 bar, -10 to +140C, brass body + FKM/PTFE seals. Scavenge or AliExpress ~AUD 15-30; the EUR 60-75 ODE/Sirai figure was specialist-retailer pricing. CHECK TEMP RATING - generic AliExpress mains solenoids are often water-inlet valves rated 80C and low pressure, which will fail on a 95C 9-bar line. The base machine has one (it routes the coffee block outlet to the group or to the hot water outlet and is never closed). This is the replacement spec. MOUNT CLOSE TO THERMOBLOCK OUTLET - short direct leg to group, long leg to tap.
[RETAINED] Solenoid valve 2-way [FUTURE] | 1 | drip-tray vent | plumbing | TBD | TBD | TBD | - | 230VAC | 26 | 20 | thread not verified on the machine | 1/8 BSP female. SPEC TO MATCH: 230VAC 5-9W, NORMALLY OPEN, i.e. open to the drain when de-energised (owner decision 2026-10-11, consistent with the standard espresso practice of a brew valve that vents the group when de-energised): the controller energises it closed whenever the coffee pump is pumping through the block (the 30-40 s shot; also hot water; the pre-shot flush; dry-fill and identification runs), so a power loss or controller fault leaves it venting, and it is not held energised the rest of the time. The earlier 'normally closed' had no source in the files. 8-15 bar, +140C, FKM/PTFE seals. Scavenge or AliExpress ~AUD 15-25. Same temp-rating caution as the 3-way. The base machine has one. Role (owner statement, not yet confirmed on the machine): on a second coffee block outlet, opens to the drain. Closed during a shot, opened by the controller at the end of the brew to relieve group pressure. The branch upstream of it is a dead end while it is closed, so a tee there would read the shot pressure (a possible brew pressure tap). The owner's reading of the base machine is the same: the OEM 2-way is normally open and is energised closed while pumping, so the block and group drain downhill to the tray whenever the machine is not pumping (inference, not yet confirmed).
Schaffner FN9222-15-06 IEC inlet filter | 1 | mains inlet | mains | 48 | 38.25 | 27.8 | 1836 | - | 0 | 11.50 | letters A/D/E from datasheet dimension table (10-15A types, so the row already covers the 15A part); drawing not parsed so L/W/H mapping and panel cut-out NOT confirmed | IEC C14 inlet + EMI filter, no fuseholder. Cx 0.1uF / Cy 2.2nF / L 0.225mH (10A part figures; 15A part's figures not rechecked). Leakage 373uA at 250VAC 50Hz (10A part). Rated 15A at 50C per DEC-INLET-CHAIN-RATED-ABOVE-ITS-FUSE (was FN9222-10-06, 10A). Whether the 15A part's appliance coupler stays IEC C14 (10A) is UNVERIFIED - confirm against the datasheet; if it is C14 the connector, not the filter, caps the inlet at 10A. ENEC/CQC/UL/CSA, IP40. Do NOT take the B (medical, Y-caps deleted - kills the common-mode filtering the dimmer needs), the A (low-leakage), or the Z (internal MOV, unserviceable). FN9260 is the same filter with a twin fuseholder at ~2.5x. See mains-inlet-protection.md
Panel-mount fuse holder M205 + T10A slow-blow | 1 | mains inlet | mains | TBD | TBD | TBD | - | - | 0 | 5 | not published | On ACTIVE, on the filter's output side. Slow-blow mandatory: 5V module cold-start inrush is 40A at 230VAC. Interrupts a sustained fault a 16/20A MCB does not (AU plugs are unfused), but slowly near its rating: a slow-blow fuse carries about 15A for half an hour or more before it opens (DEC-INLET-CHAIN-RATED-ABOVE-ITS-FUSE; this fuse's own curve not read), so the conductors relying on it alone - the trunk and the two heater branches, board copper included - are rated for that band, not for their load. Check the holder is 250VAC rated with shrouded terminals; many cheap ones are 250V DC automotive. See mains-inlet-protection.md
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
