Resident-X/brew-state/docs/sunbeam-em7000/controller-design/passive-and-drive-components.csv

# Passive and drive components required BEYOND the modules in control-system-bom.csv. Derived from the h743-pin-allocation.csv channel list. Two rows are marked SAFETY-CRITICAL: the SSR gate pull-downs and the valve relay pull resistors. Both exist to keep a load DE-ENERGISED when the MCU is in reset, booting, or hung with its GPIOs high-impedance - the state OBL-ELECTRICAL-THERMAL-SAFETY-001.C2 names. Neither is optional and neither is on
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
