Resident-X/brew-state/hardware/tools/tests/box.step

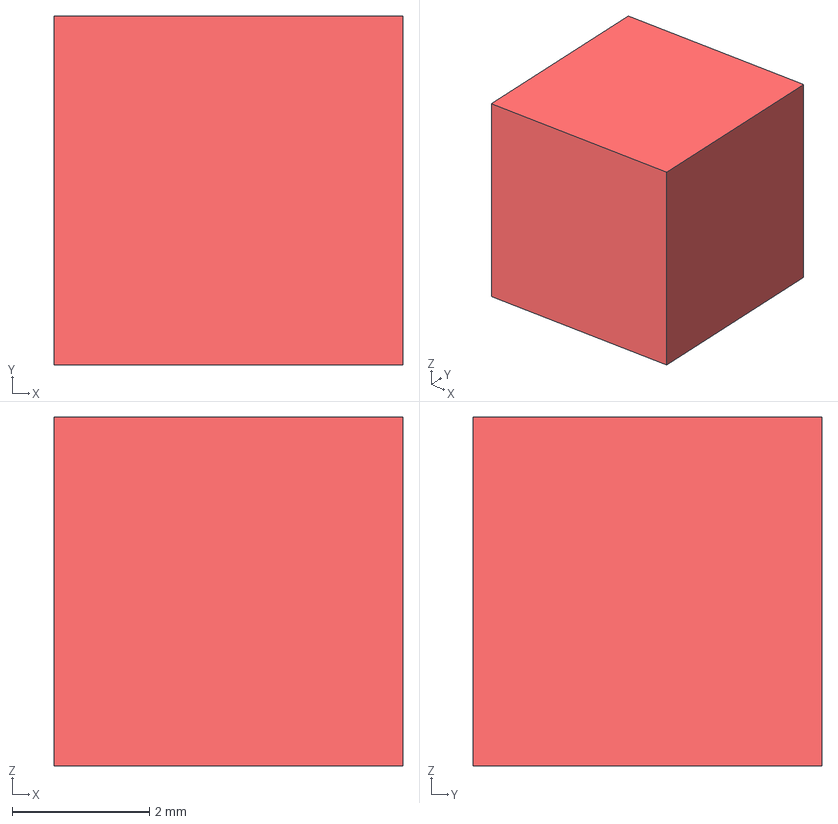
[picture p5: CAD file, 2026-10-16]
hardware/tools/tests/box.step
5.08 x 5.08 x 5.08 mm
