Resident-X/brew-state/hardware/tools/tests/fixtures/board_check_kicad_test_ids.txt

- AClassIsReadWholeOnABoardOfAnySize.test_the_board_is_past_the_limit_on_its_mains_nets_alone
- AClassIsReadWholeOnABoardOfAnySize.test_the_locked_copper_reading_sees_that_set
- AClassIsReadWholeOnABoardOfAnySize.test_the_mains_class_is_read_exactly_on_every_run
- AClassIsReadWholeOnABoardOfAnySize.test_the_pre_order_check_sees_that_set
- AClassIsReadWholeOnABoardOfAnySize.test_the_review_views_see_that_set
- AForgedRuleIsReported.test_a_rule_written_to_look_like_the_checks_own_has_its_findings_reported
- AReportCutShortFailsTheCheck.test_a_design_rule_failing_on_more_items_than_the_limit_fails_saying_the_report_was_cut_short
- AnUnparseableSchematicFailsTheDesignWhichSwitchesOffPolarisationBySymbol.test_a_schematic_kicad_cannot_read_fails_the_design_naming_the_schematic
- EveryTrackedDesignPassesTheConnectivityCheck.test_every_design_the_repository_tracks_is_held_to_a_record_and_passes
- EveryTrackedDesignPassesTheFloorAndHoleRules.test_no_design_the_repository_tracks_fails_either_rule_and_each_carries_the_inputs_the_floor_reads
- EveryTrackedDesignPassesTheMainsToMainsRules.test_every_tracked_design_passes_and_the_mains_present_ones_state_the_new_keys
- EveryTrackedDesignPassesTheMinimumsAndLifecycleRules.test_no_design_the_repository_tracks_fails_either_rule_and_each_carries_the_records_they_read
- EveryTrackedDesignPassesTheMinimumsAndLifecycleRules.test_the_reads_listings_description_names_the_manufacturer_limits_record
- EveryTrackedDesignPassesTheMinimumsAndLifecycleRules.test_the_round_learns_a_change_to_the_limits_record_reaches_a_design_through_the_reads_listing
- EveryTrackedDesignPassesTheSensingAndGroundReturnRules.test_no_design_the_repository_tracks_fails_either_rule_and_each_carries_a_synthetic_board_rules_record
- EveryTrackedDesignPassesTheSensingAndGroundReturnRules.test_the_round_learns_a_change_to_the_record_reaches_a_design_through_the_reads_listing
- FloorAndHolesRunDirectly.test_a_basis_lacking_the_floor_inputs_fails_the_run_by_key_and_still_runs_every_other_check
- FloorAndHolesRunDirectly.test_a_footprint_of_one_plated_pad_left_out_of_the_bom_is_a_fixing_whose_courtyard_is_measured
- FloorAndHolesRunDirectly.test_a_footprint_of_one_plated_pad_with_no_bom_flag_is_a_fixing_whose_courtyard_is_measured
- FloorAndHolesRunDirectly.test_a_hole_beyond_the_signed_distance_passes_and_one_inside_it_fails_with_the_gap_named
- FloorAndHolesRunDirectly.test_a_hole_inside_the_distance_fails_whether_or_not_it_is_on_a_protective_earth_net
- FloorAndHolesRunDirectly.test_a_pad_larger_than_its_hole_is_held_at_its_edge_in_a_hole_footprint_and_in_a_part
- FloorAndHolesRunDirectly.test_a_plated_hole_on_a_mains_net_is_not_failed_by_the_plated_hole_rule
- FloorAndHolesRunDirectly.test_mains_copper_inside_a_fixings_courtyard_distance_fails_by_track_and_by_pour_and_names_the_gap
- FloorAndHolesRunDirectly.test_the_distance_is_the_larger_of_the_signed_clearance_and_creepage_whichever_it_is
- FloorAndHolesRunDirectly.test_the_failure_is_in_the_same_report_as_the_existing_checks_with_the_rule_design_and_item
- FloorAndHolesRunDirectly.test_the_hole_that_is_clear_with_its_pad_clear_too_passes
- FloorAndHolesRunDirectly.test_the_same_fixing_with_the_mains_copper_beyond_the_distance_passes
- FloorAndHolesRunDirectly.test_the_unmodified_throwaway_design_passes_both_rules
- FloorAndHolesRunDirectly.test_without_its_physical_clearance_constraint_the_part_with_an_oversize_pad_would_pass
- KiCadComparesTracksEverywhereButAtAPad.test_a_branch_at_a_pad_passes_and_one_off_a_track_or_a_via_fails
- KiCadReportsATrackEndingFreeUnaided.test_a_stub_off_a_pad_off_a_track_or_lying_loose_is_reported_and_fails_the_design
- MainsToMainsRunDirectly.test_a_pair_listed_in_held_at_reinforced_fails_at_the_mains_to_low_voltage_figures_in_either_order
- MainsToMainsRunDirectly.test_a_pair_naming_a_net_outside_the_mains_class_fails_mains_declaration_naming_it
- MainsToMainsRunDirectly.test_a_pair_not_listed_keeps_the_mains_to_mains_figures
- MainsToMainsRunDirectly.test_a_pair_with_a_mains_entry_item_between_the_downstream_and_the_ahead_of_the_fuse_creepage_fails
- MainsToMainsRunDirectly.test_items_of_one_net_and_pairs_at_or_beyond_the_figures_are_never_reported
- MainsToMainsRunDirectly.test_pads_of_one_part_and_of_neighbouring_parts_closer_than_the_terminal_clearance_fail_and_conductors_between_it_and_the_clearance_pass
- MainsToMainsRunDirectly.test_the_same_distance_between_two_nets_outside_mains_entry_passes
- MainsToMainsRunDirectly.test_the_terminal_pairs_of_the_clean_design_pass_at_the_signed_terminal_clearance
- MainsToMainsRunDirectly.test_two_mains_items_closer_than_the_signed_clearance_fail_naming_both_nets_whatever_the_designs_rules_say
- MainsToMainsRunDirectly.test_two_mains_items_closer_than_the_signed_creepage_fail_naming_both_nets_whatever_the_designs_rules_say
- NamesRunDirectly.test_the_proof_fails_a_fault_whose_run_names_what_the_check_must_leave_alone
- NamesRunDirectly.test_the_seeded_net_run_carries_a_pin_nothing_joins_and_names_none_of_them_in_a_failure
- NamesRunDirectly.test_the_unmodified_throwaway_design_passes_the_name_refusals
- NetTiesAreExemptFromClearance.test_kicad_checks_no_clearance_between_tied_pads_and_the_check_fails_the_tie
- NothingFromTheMachineRunningTheCheck.test_kicad_run_as_the_user_finds_the_library_and_the_check_does_not
- OneCommand.test_the_task_runs_the_whole_check_on_the_repository
- OneCommand.test_the_task_stops_naming_a_missing_kicad_rather_than_passing
- OnlyWhatTheRepositoryHoldsIsChecked.test_a_footprint_library_left_out_of_the_commit_is_not_used
- OnlyWhatTheRepositoryHoldsIsChecked.test_libraries_and_sheets_above_the_designs_folder_are_checked_with_it
- PinCoverageSparesListedPins.test_the_proof_fails_a_run_that_names_the_listed_pin_it_must_leave_alone
- TheCheckReadsATrackMeetingAPadAsKiCadDoes.test_the_contact_rule_joins_a_track_to_a_pad_exactly_when_kicad_does
- TheCleanDesignStatesTheFiguresOfTheDecouplingAndSilkscreenRules.test_the_inherent_zeros_are_stated_and_the_clean_design_passes_the_two_rules
- TheMainsEntryDeclaration.test_a_mains_entry_net_outside_the_mains_class_fails_naming_the_net
- TheMainsEntryDeclaration.test_a_mains_entry_variable_that_is_unset_or_neither_present_nor_none_fails_naming_the_variable
- TheMainsEntryDeclaration.test_a_valid_declaration_with_a_net_in_the_class_passes
- TheMainsEntryDeclaration.test_none_with_a_net_in_the_mains_entry_class_fails_naming_the_variable_and_the_net
- TheMainsEntryDeclaration.test_present_with_no_net_in_the_mains_entry_class_fails
- TheMainsToMainsRowsOfTheProof.test_the_proof_holds_a_row_for_each_of_the_eight_failures_and_for_no_rule_this_leaf_leaves_alone
- TheMinimumsAndLifecycleRulesRunOnTheShippedCheck.test_a_board_setup_minimum_the_record_bounds_that_the_project_does_not_state_fails_naming_the_key
- TheMinimumsAndLifecycleRulesRunOnTheShippedCheck.test_a_custom_rule_that_sets_a_minimum_looser_than_the_limit_fails_naming_the_rule_and_its_line
- TheMinimumsAndLifecycleRulesRunOnTheShippedCheck.test_a_design_with_no_limits_record_in_any_folder_above_it_fails
- TheMinimumsAndLifecycleRulesRunOnTheShippedCheck.test_a_net_class_looser_than_the_limit_fails_naming_the_class_and_the_figure
- TheMinimumsAndLifecycleRulesRunOnTheShippedCheck.test_a_placed_part_whose_status_is_not_recommended_for_new_designs_fails_naming_the_position
- TheMinimumsAndLifecycleRulesRunOnTheShippedCheck.test_a_synthetic_limits_record_applied_to_an_orderable_board_fails
- ThePoursAreMeasuredOnTheBoardKiCadFilled.test_a_pour_round_a_pad_of_another_net_is_read_with_the_pads_hole_and_its_bridge
- ThePoursAreMeasuredOnTheBoardKiCadFilled.test_a_saved_fill_covering_the_track_does_not_hide_the_gap_the_refill_leaves
- ThePoursAreMeasuredOnTheBoardKiCadFilled.test_a_saved_fill_stopping_short_does_not_fail_a_pour_whose_refill_covers_the_track
- ThePoursAreMeasuredOnTheBoardKiCadFilled.test_saving_the_refilled_board_changes_nothing_in_kicads_report
- ThePoursAreMeasuredOnTheBoardKiCadFilled.test_the_clean_design_passes_both_rules
- TheProjectFilesNetClassesAreResolvedByKiCad.test_assignments_and_patterns_resolve_as_kicad_matches_them
- TheProofCopyCarriesTheSharedLimitsRecord.test_the_proof_copy_carries_the_shared_limits_record_so_it_is_held_to_it_as_the_committed_design_is
- TheProofDesignAndItsFaults.test_every_rule_the_check_reports_of_its_own_has_a_seeded_fault
- TheProofDesignAndItsFaults.test_the_proof_design_is_marked_not_for_manufacture_and_carries_a_synthetic_record
- TheRecordKeysProofDesignPasses.test_the_record_keys_proof_design_with_every_key_passes_the_check
- TheRejectedRuleIsNamed.test_a_form_that_is_not_a_rule_is_named
- TheRejectedRuleIsNamed.test_the_first_rejected_rule_is_named_wherever_it_sits
- TheReport.test_a_clean_tree_reports_every_design_passing_and_exits_zero
- TheReport.test_each_design_gets_a_verdict_each_violation_one_line_and_the_exit_status_matches
- TheReportLimitIsKiCads.test_an_assertion_every_item_fails_is_reported_exactly_the_limit_times
- TheSensingRulesRunDirectly.test_a_class_only_the_layout_gives_a_connector_net_is_resolved_not_taken_for_default
- TheSensingRulesRunDirectly.test_a_declared_class_that_holds_no_net_fails_so_a_pattern_that_misses_cannot_pass
- TheSensingRulesRunDirectly.test_a_design_that_declares_no_mains_may_still_declare_sensing_classes_and_is_held_to_the_override_rule
- TheSensingRulesRunDirectly.test_a_pair_with_mains_is_held_to_the_signed_figure_when_the_declared_one_is_smaller_so_the_rule_does_not_loosen_it
- TheSensingRulesRunDirectly.test_a_pair_without_mains_is_held_to_the_declared_figure_alone_and_a_gap_at_the_figure_passes
- TheSensingRulesRunDirectly.test_the_design_own_stricter_rule_is_still_held_because_the_sensing_rules_run_apart_from_it
- TheSignedFigurePrevails.test_a_design_declaring_a_stricter_figure_is_held_to_the_record
- TheSignedFigurePrevails.test_a_zone_fill_keeps_the_signed_figure_whatever_its_own_clearance
- TheSignedFigurePrevails.test_kicad_ranks_pad_and_footprint_overrides_above_custom_rules
- TheTrackedDesignsPassTheFiducialAndPolarityMarkRules.test_every_tracked_design_passes_and_reports_the_count
- TheTrackedDesignsPassTheTestPadCourtyardRule.test_every_tracked_design_passes_and_reports_the_figure
- TheUnmodifiedProofDesignPassesTheConnectivityCheck.test_a_net_moved_off_its_controller_pin_is_caught_on_the_real_netlist
- TheUnmodifiedProofDesignPassesTheConnectivityCheck.test_the_throwaway_design_as_committed_passes_with_its_synthetic_record
- ZonesAreRefilled.test_a_stale_fill_closer_than_the_signed_figure_does_not_fail_a_design_whose_refill_is_clean
- ZonesAreRefilled.test_an_unfilled_zone_is_filled_before_it_is_judged
P BoardMinimumsAndLifecycleProof.test_a_seeded_minimums_or_lifecycle_fault_names_the_fault_and_the_rule_in_the_record_of_the_run
P BoardMinimumsAndLifecycleProof.test_each_minimums_and_lifecycle_fault_is_caught_on_a_copy_of_the_proof_design_and_the_committed_design_stays_passing
P Connectivity.test_a_channel_the_design_lacks_and_a_pin_the_record_omits_are_each_caught_by_name
P Connectivity.test_each_connectivity_fault_is_caught_with_the_line_that_names_it
P Connectivity.test_every_pin_allocation_record_failure_fails
P Connectivity.test_the_four_connectivity_faults_are_each_seeded_and_caught_naming_what_they_break
P Discovery.test_every_discovery_failure_fails_by_name
P MountingHoleProof.test_each_hole_fault_is_caught_on_a_copy_of_the_throwaway_design
P Names.test_a_tool_named_net_and_each_unnamed_sheet_fail_by_name_beside_a_pin_nothing_joins
P Parts.test_every_parts_failure_fails_and_is_named
P Parts.test_every_none_convention_failure_fails_and_is_named
P Parts.test_the_unmodified_throwaway_design_passes_the_parts_check
P PinCoverageProof.test_a_pin_left_out_of_a_listed_parts_entry_is_caught_on_a_copy_of_the_throwaway_design_that_spares_its_listed_pins
P PinCoverageSparesUnconnectedPins.test_a_pin_on_no_other_pin_and_no_rail_is_not_failed_beside_a_connected_pin_left_out_and_the_proof_notices_if_it_were
P RecordKeys.test_a_misspelt_key_in_each_kind_of_record_fails_and_is_named
P RuleChecks.test_kicad_violations_parity_exclusions_and_ignored_checks_each_fail
P SensingAndGroundReturnProof.test_a_seeded_sensing_or_ground_fault_names_the_fault_and_the_rule_in_the_record_of_the_run
P SensingAndGroundReturnProof.test_each_sensing_and_ground_return_fault_is_caught_on_a_copy_of_the_proof_design_and_the_committed_design_stays_passing
P SensingAndGroundReturnProof.test_the_proof_requires_the_mains_pair_rule_to_decide_after_the_signed_rule
P Separation.test_every_separation_failure_fails
P SeparationFloorProof.test_each_floor_fault_is_caught_on_a_copy_of_the_throwaway_design_and_the_committed_design_stays_passing
P TheBarrierPasteAndPourRules.test_a_missing_or_malformed_figure_of_either_measured_area_fails_by_name
P TheBarrierPasteAndPourRules.test_a_no_connect_pad_and_a_pad_on_a_mains_net_with_no_number_leave_the_part_measured
P TheBarrierPasteAndPourRules.test_a_part_the_barrier_rule_cannot_measure_and_a_missing_rule_each_fail_by_name
P TheBarrierPasteAndPourRules.test_each_failure_names_where_on_the_board_it_is
P TheBarrierPasteAndPourRules.test_each_rule_fails_on_its_seeded_fault
P TheDecouplingAndSilkscreenRules.test_each_rule_fails_on_its_seeded_fault_and_names_where
P TheFiducialAndPolarityMarkRules.test_each_rule_fails_on_its_seeded_fault_and_names_the_rule_the_design_and_the_item
P TheFiducialAndPolarityMarkRules.test_the_seeded_part_with_no_pad_numbered_one_and_self_mapping_holes_is_caught_with_its_reason
P TheMainsToMainsRules.test_each_new_failure_is_caught_on_a_seeded_fault_under_the_rule_named_for_it
P TheSeededFaultProof.test_the_clean_design_passes_and_every_fault_is_caught_without_touching_the_tree
P TheTestPadCourtyardRule.test_the_rule_fails_on_its_seeded_fault_and_names_the_test_point_the_part_and_the_distances
P TheWorkmanshipRules.test_each_kicad_finding_and_measured_failure_names_the_item
P TheWorkmanshipRules.test_every_workmanship_rule_fails_on_its_seeded_fault
P VoltageRulesProof.test_a_seeded_fault_names_the_fault_and_the_rule_in_the_proofs_record_of_the_run
P VoltageRulesProof.test_each_voltage_rule_fault_is_caught_on_a_copy_of_the_throwaway_design_and_the_committed_design_stays_passing
P ControllerPart.test_every_controller_part_failure_fails_and_is_named
P ControllerPart.test_each_controller_failure_is_caught_with_the_line_that_names_the_rule_the_design_and_the_part
P RidingDomainsProof.test_a_divider_part_over_its_share_and_each_malformed_riding_declaration_is_caught_on_a_copy_of_the_throwaway_design
P RidingDomainsProof.test_a_seeded_riding_fault_names_the_fault_and_the_rule_in_the_proofs_record_of_the_run
- TheUnmodifiedProofDesignPassesTheControllerRule.test_the_throwaway_design_as_committed_passes_with_its_own_synthetic_controller
- TheUnmodifiedProofDesignPassesTheControllerRule.test_a_synthetic_controller_record_is_refused_for_a_design_not_marked_not_for_manufacture
- TheDeclarationOnTheThrowawayDesign.test_a_declared_design_that_places_a_controller_is_not_accepted
- TheDeclarationOnTheThrowawayDesign.test_a_design_with_no_machine_folder_is_not_held_to_the_far_channel_check
- TheDeclarationOnTheThrowawayDesign.test_the_check_reports_the_rule_and_the_part_in_its_text_report
- TheDeclarationOnTheThrowawayDesign.test_the_design_as_committed_passes_and_a_rail_entry_beside_its_controller_channels_is_accepted
- TheDeclarationOnTheThrowawayDesign.test_the_far_channel_case_runs_in_a_machine_folder_and_the_others_in_the_design_without_one
P TheNoControllerFaultsAreSeeded.test_each_way_the_declaration_can_be_abused_has_a_seeded_case_that_fails_the_check_naming_what_it_breaks
- SpacingExceptionsRunDirectly.test_a_distance_below_the_accepted_one_fails_naming_the_entry_and_both_distances
- SpacingExceptionsRunDirectly.test_a_mains_to_low_voltage_creepage_shortfall_at_or_above_the_accepted_distance_is_reported_and_the_design_passes
- SpacingExceptionsRunDirectly.test_a_mains_to_mains_clearance_shortfall_at_or_above_the_accepted_distance_is_reported_and_the_design_passes
- SpacingExceptionsRunDirectly.test_a_shortfall_with_no_exception_is_the_ordinary_violation_and_prints_no_accepted_line
- SpacingExceptionsRunDirectly.test_an_entry_accepting_no_less_than_the_figure_relaxes_nothing_and_fails_naming_it
- SpacingExceptionsRunDirectly.test_an_entry_dated_after_the_record_or_after_today_is_not_honoured_and_fails_naming_it
- SpacingExceptionsRunDirectly.test_an_entry_naming_a_pad_or_net_the_layout_lacks_fails_naming_it
- SpacingExceptionsRunDirectly.test_an_entry_of_the_other_pair_kind_or_the_other_constraint_excuses_nothing
- SpacingExceptionsRunDirectly.test_an_entry_that_no_shortfall_uses_fails_naming_it
- SpacingExceptionsRunDirectly.test_an_exception_for_one_pad_pair_of_a_part_does_not_excuse_another_pair_of_its_pads
- SpacingExceptionsRunDirectly.test_an_exception_in_a_synthetic_record_of_an_orderable_board_is_never_honoured
- SpacingExceptionsRunDirectly.test_an_exception_in_an_unsigned_record_is_never_honoured
- SpacingExceptionsRunDirectly.test_an_unsigned_entry_is_not_honoured_and_fails_naming_it
- SpacingExceptionsRunDirectly.test_the_net_pair_form_excuses_the_same_shortfall
- TheExceptionsKeepTheTrackedDesignsPassing.test_every_tracked_design_passes_and_none_of_them_holds_an_exception
- TheSpacingExceptionRowsOfTheProof.test_the_proof_holds_a_row_for_each_of_the_three_failures_and_for_no_rule_this_leaf_leaves_alone
P TheSpacingExceptionRules.test_each_new_failure_is_caught_on_a_seeded_fault_under_spacing_exception
