Resident-X/brew-state/hardware/tools/tests/fixtures/divided_test_ids/test_board_history.txt

CriticalRoutingFails.test_a_board_judged_commit_holding_unlocked_copper_or_none_fails
CriticalRoutingFails.test_a_board_judged_commit_on_a_side_branch_fails
CriticalRoutingFails.test_a_checklist_item_dropped_in_the_board_judged_commit_and_restored_before_the_router_fails
CriticalRoutingFails.test_a_checklist_item_neither_judged_nor_listed_or_given_twice_fails
CriticalRoutingFails.test_a_fail_put_right_before_the_router_passes_and_one_put_right_after_it_fails
CriticalRoutingFails.test_a_fail_with_no_commit_putting_it_right_fails
CriticalRoutingFails.test_a_first_pass_edited_after_the_second_was_appended_fails
CriticalRoutingFails.test_a_later_pass_judged_before_the_previous_passs_router_fails
CriticalRoutingFails.test_a_router_commit_between_the_first_router_and_the_second_passs_board_judged_fails
CriticalRoutingFails.test_a_router_commit_that_is_a_merge_fails
CriticalRoutingFails.test_a_squash_merged_copy_of_a_compliant_branch_fails_closed
CriticalRoutingFails.test_locked_router_copper_in_the_board_judged_commit_fails_with_routed
CriticalRoutingFails.test_locked_router_copper_reads_as_router_not_yet_run_and_fails_with_routed
CriticalRoutingFails.test_no_tracks_and_no_critical_routing_section_fail_with_routed
CriticalRoutingFails.test_router_copper_on_two_lines_after_the_board_judged_commit_fails
CriticalRoutingFails.test_tracks_with_no_critical_routing_section_fail
CriticalRoutingFails.test_unlocked_copper_merged_in_from_another_line_between_the_passes_fails
Documentation.test_every_site_describing_the_plan_compare_carries_the_one_sentence_and_none_a_falsehood
Documentation.test_nothing_the_command_prints_or_the_guides_say_calls_the_first_copper_a_track_only
Documentation.test_the_drawing_item_in_the_methods_circuit_catalogue_leaves_the_layout_checklist_unchanged
Documentation.test_the_guide_and_the_task_describe_the_command
Documentation.test_the_guide_and_the_task_state_each_hardened_behaviour
Documentation.test_the_review_names_a_sheet_in_the_net_or_part_column_and_in_every_text_on_the_rows_a_record_may_name
Output.test_the_task_runs_the_command_from_the_repositorys_taskfile
Output.test_the_text_and_json_outputs_give_the_same_verdicts
Passes.test_a_branch_merged_without_fast_forward_passes_checked_on_main
Passes.test_a_circuit_item_in_the_method_leaves_the_layout_checklist_unchanged
Passes.test_a_compliant_history_after_the_router_passes_and_a_hand_route_before_locking_is_not_the_routers
Passes.test_a_compliant_history_after_the_router_passes_with_routed
Passes.test_a_compliant_placement_before_any_track_passes_judged_at_head
Passes.test_a_pass_recorded_before_the_router_runs_is_judged_at_head_and_says_so
Passes.test_a_second_pass_appended_after_a_placement_change_passes
PlacementFails.test_a_candidate_measured_against_a_floorplan_widened_in_its_own_commit_fails
PlacementFails.test_a_candidate_merged_in_only_after_the_first_track_fails
PlacementFails.test_a_candidate_off_heads_line_of_history_fails
PlacementFails.test_a_chosen_candidate_the_section_does_not_record_fails
PlacementFails.test_a_missing_placement_section_fails_rather_than_passing
PlacementFails.test_a_part_moved_in_the_first_tracks_commit_fails
PlacementFails.test_a_placement_item_given_two_verdicts_fails
PlacementFails.test_a_placement_with_no_chosen_field_fails
PlacementFails.test_a_recorded_measure_the_candidates_commit_does_not_measure_fails
PlacementFails.test_a_track_in_the_root_commit_fails
PlacementFails.test_a_verdict_outside_the_three_or_a_not_applicable_the_plan_does_not_mark_no_fails
PlacementFails.test_a_verdict_table_missing_a_placement_items_row_fails
PlacementFails.test_an_empty_heading_committed_before_the_first_track_and_filled_in_after_fails
PlacementFails.test_cited_commits_not_in_the_repository_fail
PlacementFails.test_one_candidate_a_renders_not_naming_its_commit_and_a_chosen_part_outside_fail
PlacementFails.test_tracks_first_appearing_in_a_merge_commit_fail
PlacementFails.test_tracks_first_appearing_on_two_lines_of_history_fail
PlacementFails.test_two_candidates_holding_the_same_board_fail
PlanAndCopperFails.test_a_board_that_never_holds_a_footprint_fails
PlanAndCopperFails.test_a_first_placement_that_does_not_come_before_the_sections_commit_fails
PlanAndCopperFails.test_a_half_turn_stays_distinct_from_a_full_turn
PlanAndCopperFails.test_a_negative_zero_in_a_position_reads_as_zero
PlanAndCopperFails.test_a_part_appended_and_placed_after_the_chosen_candidate_still_fails
PlanAndCopperFails.test_a_part_appended_and_placed_after_the_first_copper_passes_with_the_section_left_as_it_is
PlanAndCopperFails.test_a_part_appended_before_the_first_copper_is_held_to_the_plan_when_it_is_placed_after_it
PlanAndCopperFails.test_a_part_appended_in_the_commit_that_places_it_or_after_it_fails
PlanAndCopperFails.test_a_part_appended_to_a_region_before_its_footprint_first_appears_passes
PlanAndCopperFails.test_a_part_dropped_from_the_plan_when_it_is_placed_fails_though_listed_earlier_after_the_first_placement
PlanAndCopperFails.test_a_part_first_placed_in_a_merge_commit_fails_unless_every_parent_lists_it
PlanAndCopperFails.test_a_part_listed_dropped_and_listed_again_all_before_it_is_placed_passes_as_the_plan_holds_it_when_placed
PlanAndCopperFails.test_a_part_listed_once_dropped_before_placement_and_listed_again_after_it_is_placed_fails
PlanAndCopperFails.test_a_part_placed_in_the_first_placement_commit_and_listed_only_afterwards_fails
PlanAndCopperFails.test_a_part_removed_moved_or_a_region_added_in_the_plan_fails
PlanAndCopperFails.test_a_plan_committed_alone_before_the_first_placement_passes
PlanAndCopperFails.test_a_plan_committed_with_the_first_placement_or_after_it_fails
PlanAndCopperFails.test_a_plan_text_the_compare_does_not_cover_may_change_and_the_report_says_what_it_covers
PlanAndCopperFails.test_a_pour_drawn_before_the_placement_section_is_recorded_is_the_first_track
PlanAndCopperFails.test_a_region_widened_after_an_unrecorded_placement_and_before_the_first_candidate_fails
PlanAndCopperFails.test_a_region_widened_in_the_commit_that_records_the_section_fails
PlanAndCopperFails.test_a_repeated_region_name_stops_the_plan_check_rather_than_comparing_a_plan_with_its_own_copy
PlanAndCopperFails.test_a_rule_area_is_no_copper_and_a_history_drawing_one_before_the_section_passes
PlanAndCopperFails.test_a_zone_on_a_layer_that_is_no_copper_is_no_pour_and_one_on_the_back_copper_is
PlanAndCopperFails.test_an_unlocked_pour_between_the_board_judged_commit_and_the_router_is_not_the_routers_commit
PlanAndCopperFails.test_candidates_differing_in_a_parts_angle_or_in_which_parts_they_hold_are_distinct
PlanAndCopperFails.test_candidates_differing_only_by_the_side_their_parts_sit_on_are_distinct
PlanAndCopperFails.test_candidates_holding_different_sets_of_parts_are_distinct_though_one_part_sits_alike
PlanAndCopperFails.test_footprints_first_appearing_in_a_merge_or_on_two_lines_of_history_fail
PlanAndCopperFails.test_one_turn_written_two_ways_fails_as_one_placement
PlanAndCopperFails.test_positions_equal_to_six_significant_digits_fail_as_one_placement_and_a_sixth_digit_apart_stay_distinct
PlanAndCopperFails.test_region_names_differing_only_in_case_or_spacing_are_distinct_regions_and_pass
PlanAndCopperFails.test_the_pass_says_none_placed_yet_for_an_appended_part_no_footprint_has_reached
PlanAndCopperFails.test_the_same_history_with_the_section_recorded_before_the_pour_keeps_the_order_and_passes
PlanAndCopperFails.test_turns_a_full_circle_apart_or_a_tiny_step_under_one_stay_whole
PlanAndCopperFails.test_two_candidates_differing_only_in_the_files_text_fail_as_one_placement
Refusals.test_a_board_or_plan_differing_from_head_is_refused
Refusals.test_a_board_outside_a_git_work_tree_or_unreadable_is_refused
Refusals.test_a_shallow_clone_is_refused
Refusals.test_an_untracked_board_or_plan_is_refused
