Resident-X/brew-state/hardware/tools/tests/fixtures/divided_test_ids/test_board_views.txt

Documentation.test_the_command_its_views_and_its_tools_are_named_in_the_method_and_the_readme
ExportStatus.test_a_leftover_export_from_an_earlier_run_does_not_stand_for_this_one
ExportStatus.test_a_non_zero_status_with_a_corrupt_export_is_unreadable_naming_the_status_the_cause_and_the_fault
ExportStatus.test_a_non_zero_status_with_a_readable_export_is_used_and_the_cause_kept
ExportStatus.test_a_non_zero_status_with_an_empty_export_is_unreadable_naming_the_status_and_the_cause
ExportStatus.test_a_non_zero_status_with_no_export_is_unreadable_naming_the_status_and_the_cause
ExportStatus.test_a_timeout_is_not_tolerated_even_when_an_export_was_written
ExportStatus.test_a_zero_status_is_not_reported_as_tolerated
ExportStatus.test_every_other_command_stays_strict_on_status_whatever_it_wrote
ExportStatusThroughTheCommand.test_a_non_zero_export_that_wrote_a_readable_file_still_renders_and_states_the_cause_in_text_and_json
ExportStatusThroughTheCommand.test_a_non_zero_export_that_wrote_nothing_or_nothing_readable_is_unreadable_with_its_cause_and_writes_no_views
ExportStatusThroughTheCommand.test_a_zero_status_export_adds_no_export_line_or_field_to_the_report_or_the_index
Lacking.test_a_fabrication_or_courtyard_layer_the_board_does_not_carry_is_named_where_it_would_be_drawn
OutputNames.test_a_tiled_net_beside_an_untiled_net_named_as_one_of_its_tiles_write_distinct_files
OutputNames.test_a_view_named_as_the_index_or_the_fact_table_never_takes_their_names
OutputNames.test_two_nets_whose_names_differ_only_in_case_write_two_files_each_listed_once
Pieces.test_a_caption_names_at_most_its_share_and_leaves_the_rest_to_the_index
Pieces.test_a_caption_too_tall_for_any_tile_is_refused_at_once_naming_the_view
Pieces.test_a_crop_larger_than_the_size_limit_is_tiled_and_its_tiles_cover_it
Pieces.test_a_crops_supply_nets_and_parts_are_capped_and_its_caption_still_tiles
Pieces.test_a_decoupling_part_goes_to_the_circuit_whose_nearest_pad_is_closest_not_whose_centre_is
Pieces.test_a_net_in_more_than_one_critical_class_is_named_on_the_class_map
Pieces.test_a_part_on_rails_another_circuit_does_not_share_is_never_its_decoupling
Pieces.test_a_part_with_both_pads_on_one_net_is_never_decoupling
Pieces.test_a_two_pad_integrated_circuit_on_the_rail_is_never_another_circuits_decoupling
Pieces.test_each_decoupling_part_on_a_shared_rail_belongs_only_to_the_circuit_nearest_it
Pieces.test_kicad_is_set_to_report_in_english_whatever_it_was_set_to
Pieces.test_nine_or_more_critical_classes_each_get_their_own_colour_named_apart_in_the_caption
Pieces.test_the_copy_keeps_the_designs_names_and_finds_its_models_as_the_design_does_in_place
Pieces.test_the_extent_of_a_plot_holds_everything_drawn_in_it_strokes_included
Pieces.test_the_fact_table_counts_a_copper_zone_held_inside_a_footprint
RealBoard.test_the_repositorys_kicad_authored_proof_board_renders
Refusals.test_a_board_open_in_an_editor_is_refused
Refusals.test_a_board_stating_no_minimum_a_zero_minimum_or_a_non_finite_one_is_refused_naming_the_figure
Refusals.test_a_class_list_leaving_out_mains_on_a_board_declaring_mains_is_refused
Refusals.test_a_class_named_twice_is_refused
Refusals.test_a_missing_layer_is_refused_by_name
Refusals.test_a_project_file_not_the_boards_own_is_refused
Refusals.test_an_edge_layer_holding_no_outline_is_refused
Refusals.test_an_empty_class_is_refused_by_name
Refusals.test_an_output_folder_inside_a_design_folder_is_refused
Refusals.test_an_output_folder_that_already_holds_files_is_refused
Refusals.test_an_unknown_class_is_refused_by_name
Refusals.test_an_unreadable_board_fails_naming_it
SharedIndex.test_the_views_index_and_report_lines_are_unchanged_by_the_placement_view_sharing_them
Tools.test_a_missing_or_too_old_tool_stops_the_command_naming_it
Tools.test_a_rasteriser_with_no_font_for_the_captions_stops_the_command
Tools.test_the_task_locates_resvg_through_its_path_variable
Transforms.test_a_malformed_transform_is_refused
Transforms.test_a_matrix_and_each_skew_map_points_as_svg_defines_them
Transforms.test_a_mirror_with_a_translation_applies_the_translation_first
Transforms.test_a_turn_about_a_centre_keeps_the_centre_and_turns_about_it
Transforms.test_each_element_is_bounded_by_its_own_stroke_and_not_the_widest_in_the_plot
Transforms.test_kicads_hidden_text_is_passed_over_and_content_it_cannot_bound_is_refused
Transforms.test_nested_groups_compose_their_transforms_and_the_stroke_is_bounded_through_them
Views.test_a_board_carrying_every_layer_names_none_as_missing
Views.test_a_circuit_whose_rails_only_candidates_sit_nearer_other_circuits_is_marked_as_having_no_decoupling
Views.test_a_circuit_with_no_power_typed_pad_gets_its_crop_marked_as_declaring_no_supply_nets
Views.test_a_font_kicad_substitutes_is_named_in_every_caption_the_index_and_the_report
Views.test_a_model_the_design_keeps_in_its_own_folder_is_drawn_in_three_dimensions
Views.test_a_net_overlay_and_the_class_map_crossing_a_copper_rule_area_show_and_name_it
Views.test_a_nets_overlay_holds_that_nets_copper_and_no_other
Views.test_a_nets_pour_is_drawn_with_the_fill_the_whole_board_gives_it
Views.test_a_part_drawn_without_its_model_is_named_in_the_captions_the_index_and_the_report
Views.test_a_rule_area_kicad_does_not_plot_is_drawn_and_named
Views.test_a_three_dimensional_view_is_zoomed_out_until_no_part_reaches_its_frame
Views.test_each_crop_and_tile_meets_the_derived_resolution_and_is_read_without_downsampling
Views.test_each_crop_contains_its_circuit_and_its_decoupling_parts
Views.test_each_image_carries_its_caption_drawn_into_it
Views.test_each_side_has_an_assembly_view_of_its_fab_silkscreen_and_courtyard_over_the_edge
Views.test_every_layer_the_board_carries_and_every_layer_holding_an_item_gets_an_image
Views.test_every_view_is_written_as_a_png_on_a_dark_background
Views.test_every_whole_board_view_frames_whatever_its_layers_hold_beyond_the_outline
Views.test_every_whole_board_view_larger_than_the_limit_is_tiled_and_its_tiles_cover_the_board
Views.test_the_class_map_draws_each_critical_class_in_its_own_colour
Views.test_the_class_map_names_a_net_in_more_than_one_critical_class_and_draws_it_in_the_last_ones_colour
Views.test_the_fact_table_gives_each_nets_track_widths_vias_zones_and_class_as_text_and_json
Views.test_the_index_lists_every_image_with_its_caption_fields_as_text_and_json
Views.test_the_overlay_caption_names_each_layers_colour
Views.test_the_render_leaves_the_design_folder_untouched
Views.test_the_smallest_track_and_clearance_each_span_three_pixels_in_the_image
Views.test_the_three_dimensional_views_are_written_within_the_size_limit
Views.test_turned_and_mirrored_items_kicad_plots_through_transforms_are_drawn_inside_the_frame
Views.test_two_circuits_on_a_shared_rail_each_crop_only_their_own_decoupling_and_neither_spans_the_board
