Resident-X/brew-state/hardware/sunbeam-em7000/main-board/circuit-proof/C_curr2_settle.cir

Settling and sample memory, CURR2_AN (R574 R575 R577 C571): sensor step 0 to 4.5 V, ideal sensor output
* Source of every value: the sheet fragment of this block (generated from the same table).
* Sim-only elements (names with SIM_) stand for the sensor, the converter's sample and hold and the supply.
* Converter: DS12110 Rev 11 Table 77 / Table 174: CADC 4 pF (typ), tS 810.5 cycles, 16 bit, fADC 10 MHz.
.model SWM SW(Ron=1m Roff=1e12 Vt=0.5 Vh=0.2)
R574 SIM_STEP CURR2_DIV 10k
R575 CURR2_DIV 0 20k
R577 CURR2_DIV CURR2_AN 1k
C571 CURR2_AN 0 47n
VSIM_STEP SIM_STEP 0 PWL(0 0 1u 4.5)
CSIM_ADC ADC_H 0 4p
SSIM_SH CURR2_AN ADC_H CTL 0 SWM
VSIM_CTL CTL 0 PULSE(0 1 30m 1n 1n 81.05u 100)
.ic V(ADC_H)=0
.tran 2u 45m
.control
* corner slow: every resistor at x1.0145, every capacitor at x1.2650 of nominal
alter R574 = 10145
alter R575 = 20290
alter R577 = 1014.5
alter C571 = 5.9455e-08
run
meas tran vfin_slow FIND v(CURR2_AN) AT=29m
let errx_slow = (vfin_slow - v(CURR2_AN))*1000
meas tran t_set_slow WHEN errx_slow=0.02518 FALL=1
meas tran v_win_slow FIND v(CURR2_AN) AT=30.0811m
let kick_uV_slow = (vfin_slow - v_win_slow)*1e6
print kick_uV_slow
meas tran t_rec_slow WHEN errx_slow=0.02518 FALL=2
meas tran v_end_slow FIND v(CURR2_AN) AT=44m
let resid_uV_slow = (vfin_slow - v_end_slow)*1e6
print resid_uV_slow
* corner fast: every resistor at x0.9855, every capacitor at x0.7650 of nominal
alter R574 = 9855
alter R575 = 19710
alter R577 = 985.5
alter C571 = 3.5955e-08
run
meas tran vfin_fast FIND v(CURR2_AN) AT=29m
let errx_fast = (vfin_fast - v(CURR2_AN))*1000
meas tran t_set_fast WHEN errx_fast=0.02518 FALL=1
meas tran v_win_fast FIND v(CURR2_AN) AT=30.0811m
let kick_uV_fast = (vfin_fast - v_win_fast)*1e6
print kick_uV_fast
meas tran t_rec_fast WHEN errx_fast=0.02518 FALL=2
meas tran v_end_fast FIND v(CURR2_AN) AT=44m
let resid_uV_fast = (vfin_fast - v_end_fast)*1e6
print resid_uV_fast
.endc
.end
