Resident-X/brew-state/hardware/proof/record-keys-proof/record-keys-proof.kicad_pcb

## KiCad design hardware/proof/record-keys-proof/record-keys-proof.kicad_pcb (2026-10-30)

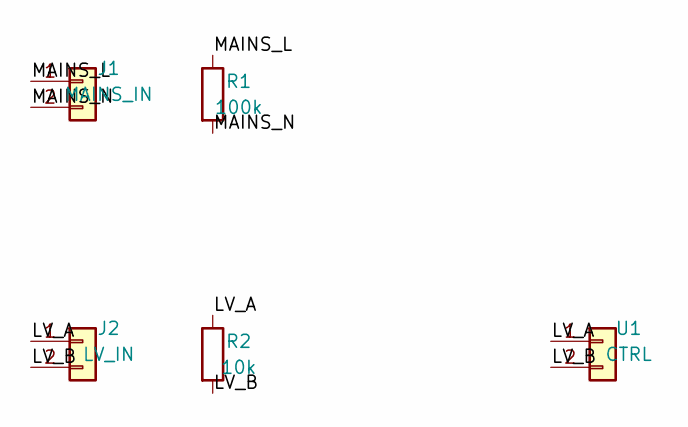
[picture p6: schematic record-keys-proof.kicad_sch]

Parts:
J1: MAINS_IN; PinHeader_1x02_P2.54mm_Vertical; LCSC C9000001
J2: LV_IN; PinHeader_1x02_P2.54mm_Vertical; LCSC C9000003
R1: 100k; R_Axial_DIN0207_L6.3mm_D2.5mm_P10.16mm_Horizontal; Rating 0.25W; LCSC C9000002
R2: 10k; R_Axial_DIN0207_L6.3mm_D2.5mm_P10.16mm_Horizontal; Rating 0.25W; LCSC C9000004
U1: CTRL; Controller_1x02; LCSC C9000005

Connections:
/LV_A: J2.1, R2.1, U1.1 (PA0)
/LV_B: J2.2, R2.2, U1.2 (PA1)
/MAINS_L: J1.1, R1.1
/MAINS_N: J1.2, R1.2

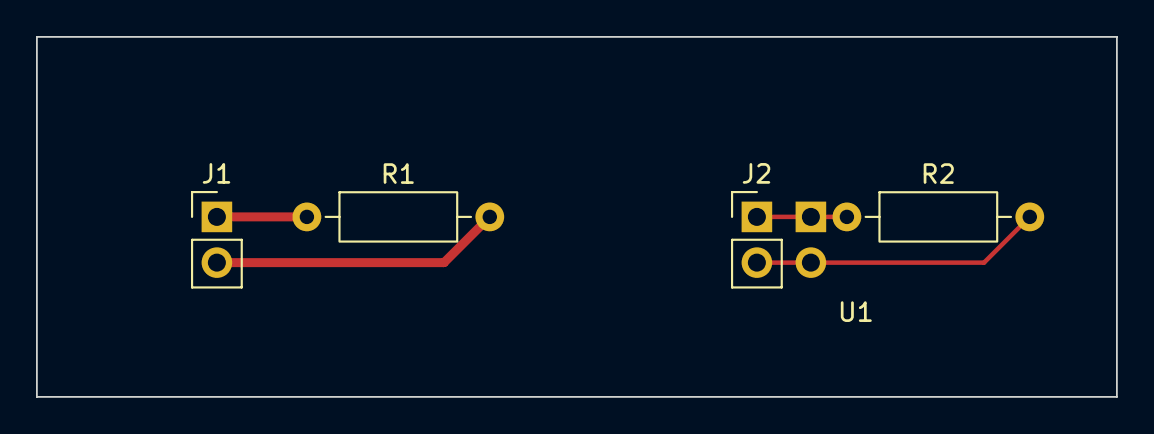
[picture p7: board record-keys-proof.kicad_pcb from above]

Board: 2 copper layers, 60.0 x 20.0 mm, 5 parts (0 on the bottom side), 4 nets.
