Resident-X/brew-state/hardware/proof/method-proof/method-proof.kicad_pcb

## KiCad design hardware/proof/method-proof/method-proof.kicad_pcb (2026-10-19)

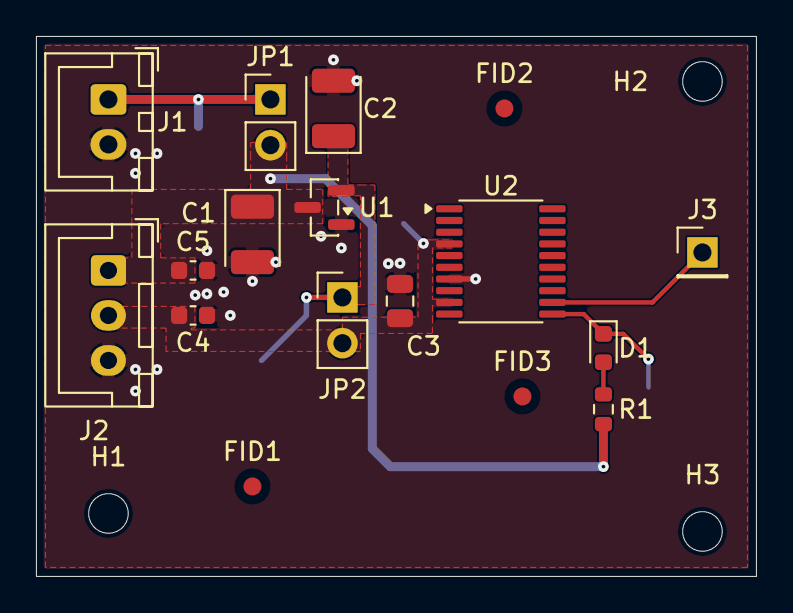
[picture p8: board method-proof.kicad_pcb from above]

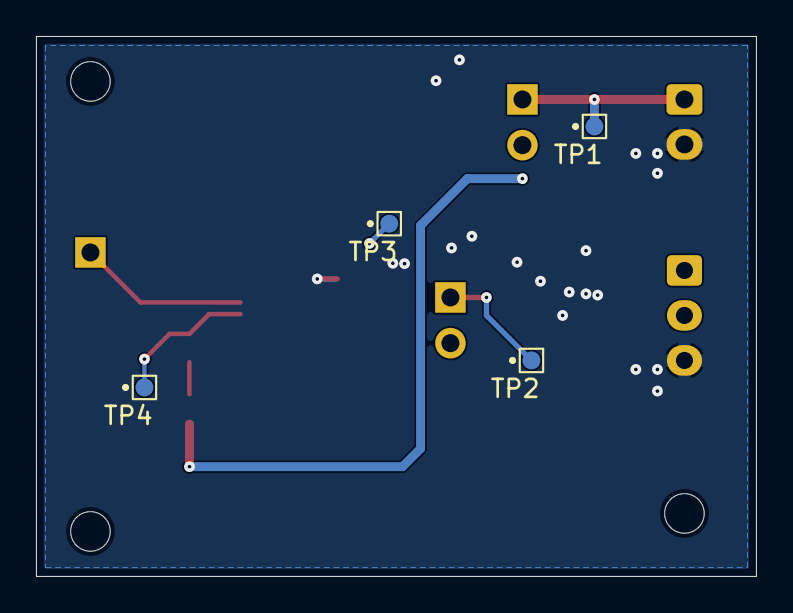
[picture p9: board method-proof.kicad_pcb from below]

Board: 4 copper layers, 40.0 x 30.0 mm, 24 parts (4 on the bottom side), 8 nets.

Parts:
C1: 47uF; CP_EIA-3528-21_Kemet-B
C2: 150uF; CP_EIA-3528-21_Kemet-B
C3: 10uF; C_0805_2012Metric
C4, C5: 100nF; C_0603_1608Metric
D1: VLMG1300-GS08; LED_0603_1608Metric
FID1, FID2, FID3: Fiducial; Fiducial_1mm_Mask2mm
H1, H2, H3: MountingHole; MountingHole_2.2mm_M2
J1: 5V_IN; JST_XH_B2B-XH-A_1x02_P2.50mm_Vertical
J2: OUT; JST_XH_B3B-XH-A_1x03_P2.50mm_Vertical
J3: PA1; PinHeader_1x01_P2.54mm_Vertical
JP1: LINK_5V; PinHeader_1x02_P2.54mm_Vertical
JP2: LINK_3V3; PinHeader_1x02_P2.54mm_Vertical
R1: 1.2k; R_0603_1608Metric
TP1: +5V_IN; TestPoint_Pad_D1.0mm
TP2: +3V3_REG; TestPoint_Pad_D1.0mm
TP3: +3V3; TestPoint_Pad_D1.0mm
TP4: LED_K; TestPoint_Pad_D1.0mm
U1: MCP1700T-3302E/TT; SOT-23
U2: MSPS003F4SPW20R; TSSOP-20_4.4x6.5mm_P0.65mm

Connections:
+3V3: C3.1, C4.1, J2.2, JP2.2, TP3.1 (1_1), U2.4 (NRST), U2.9 (VDD)
+5V: C1.1, C5.1, J2.1, JP1.2, R1.1, U1.3 (VI)
/+3V3_REG: C2.1, JP2.1, TP2.1 (1_1), U1.2 (VO)
/+5V_IN: J1.1, JP1.1, TP1.1 (1_1)
/LED_A: D1.2 (A), R1.2
/LED_K: D1.1 (K), TP4.1 (1_1), U2.11 (PA0)
/PA1_HDR: J3.1 (Pin_1_1), U2.12 (PA1)
GND: C1.2, C2.2, C3.2, C4.2, C5.2, J1.2, J2.3, U1.1 (GND), U2.7 (VSS)
