Resident-X/brew-state/hardware/proof/review-proof/review-proof.kicad_pcb

## KiCad design hardware/proof/review-proof/review-proof.kicad_pcb (2026-10-16)

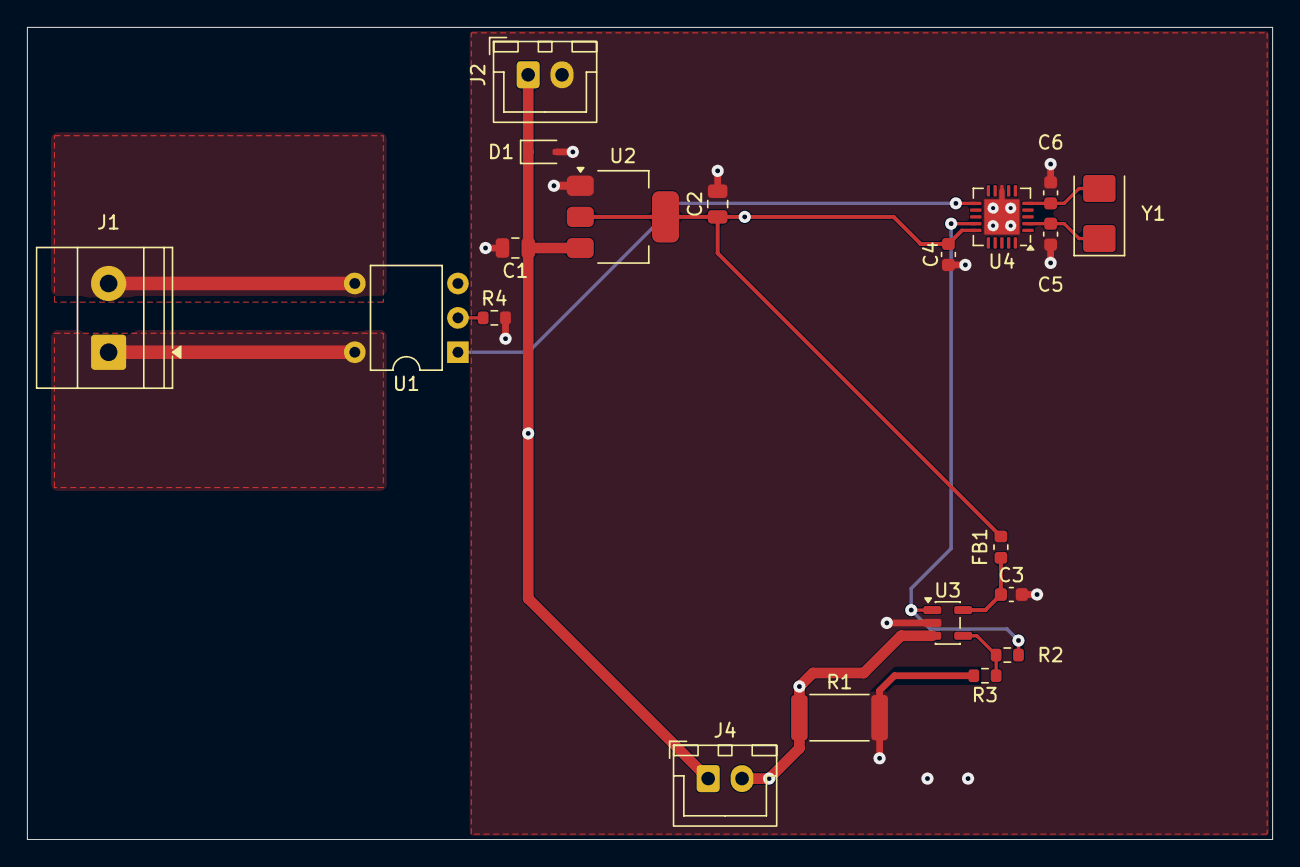
[picture p10: board review-proof.kicad_pcb from above]

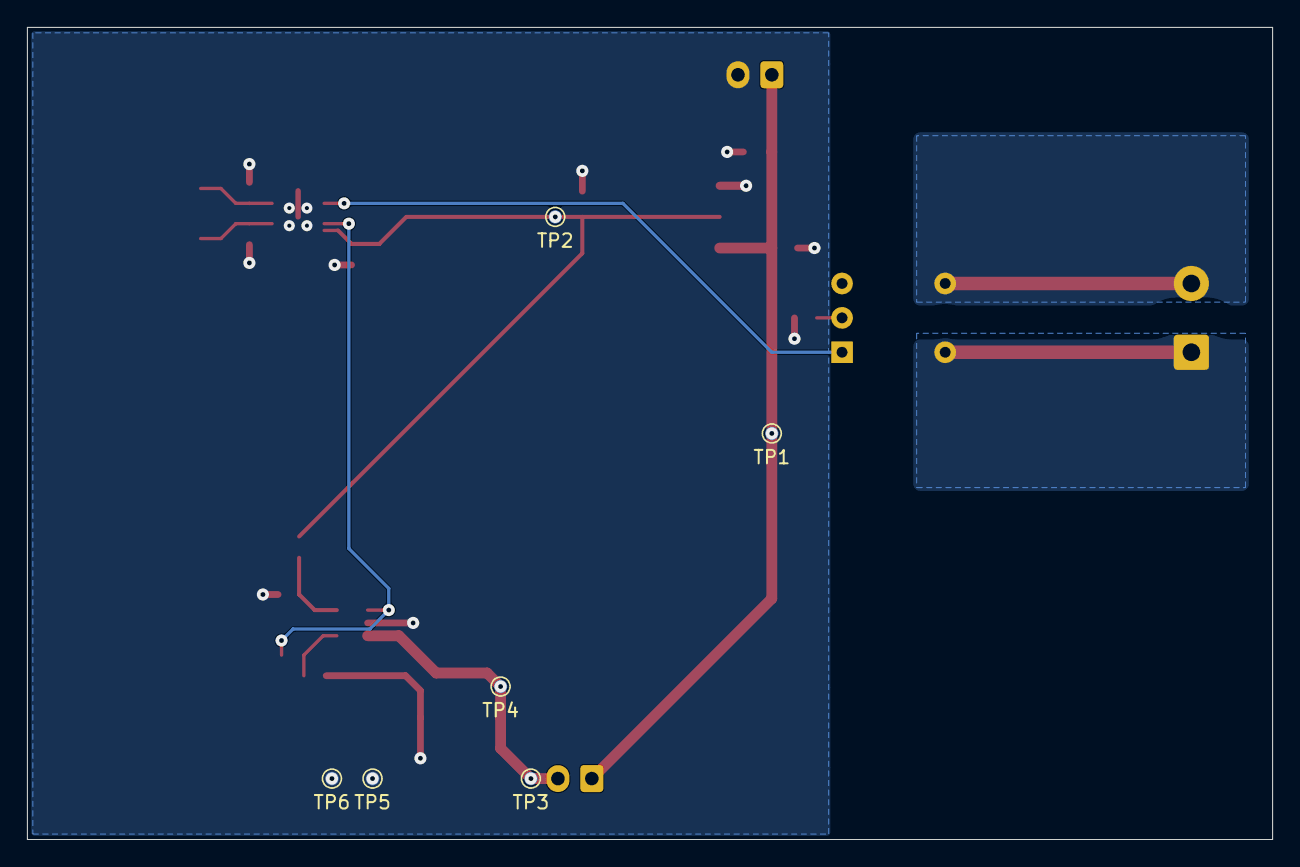
[picture p11: board review-proof.kicad_pcb from below]

Board: 4 copper layers, 92.0 x 60.0 mm, 26 parts (6 on the bottom side), 13 nets.

Parts:
C1, C2: 1uF; C_0805_2012Metric
C3, C4: 100nF; C_0603_1608Metric
C5, C6: 22pF; C_0603_1608Metric
D1: PESD5V0S1BA; D_SOD-323
FB1: 600R@100MHz; L_0603_1608Metric
J1: MAINS; TerminalBlock_Phoenix_MKDS-1,5-2-5.08_1x02_P5.08mm_Horizont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
J2: 5V_IN; JST_XH_B2B-XH-A_1x02_P2.50mm_Vertical
J4: LOAD; JST_XH_B2B-XH-A_1x02_P2.50mm_Vertical
R1: 0.05; R_2512_6332Metric
R2: 47k; R_0603_1608Metric
R3: 1k; R_0603_1608Metric
R4: 330; R_0603_1608Metric
TP1: +5V; TestPoint_Pad_D1.0mm
TP2: +3V3; TestPoint_Pad_D1.0mm
TP3: LOAD_RTN_I; TestPoint_Pad_D1.0mm
TP4: LOAD_RTN_V; TestPoint_Pad_D1.0mm
TP5: GND_I; TestPoint_Pad_D1.0mm
TP6: GND_V; TestPoint_Pad_D1.0mm
U1: VO3526; DIP-5-6_W7.62mm
U2: AMS1117-3.3; SOT-223-3_TabPin2
U3: MCP6001-OT; SOT-23-5
U4: ATtiny85-20M; QFN-20-1EP_4x4mm_P0.5mm_EP2.6x2.6mm
Y1: 8MHz; Crystal_SMD_5032-2Pin_5.0x3.2mm

Connections:
/+3V3: C2.1, C4.1, FB1.1, TP2.1, U2.2 (VO), U4.15 (VCC)
/+3V3A: C3.1, FB1.2, U3.5 (V+)
/+5V: C1.1, D1.1 (A1), J2.1, J4.1, TP1.1, U2.3 (VI)
/AMP_FB: R2.2, R3.1, U3.4 (-)
/AMP_OUT: R2.1, U3.1, U4.14 (PB2)
/GND: C1.2, C2.2, C3.2, C4.2, C5.2, C6.2, D1.2 (A2), J2.2, R1.2, R3.2, R4.2, TP5.1, TP6.1, U2.1 (GND), U3.2 (V-), U4.8 (GND), U4.21 (GND)
/LED_DRV: U1.1, U4.11 (AREF/PB0)
/LED_K: R4.1, U1.2
/LOAD_RTN: J4.2, R1.1, TP3.1, TP4.1, U3.3 (+)
/MAINS_L: J1.1, U1.6
/MAINS_SW: J1.2, U1.4
/XTAL1: C5.1, U4.2 (XTAL1/PB3), Y1.1
/XTAL2: C6.1, U4.5 (XTAL2/PB4), Y1.2
