Resident-X/brew-state/hardware/sunbeam-em7000/main-board/30-logic-supply.kicad_sch

## KiCad design hardware/sunbeam-em7000/main-board/30-logic-supply.kicad_sch (2026-11-06)

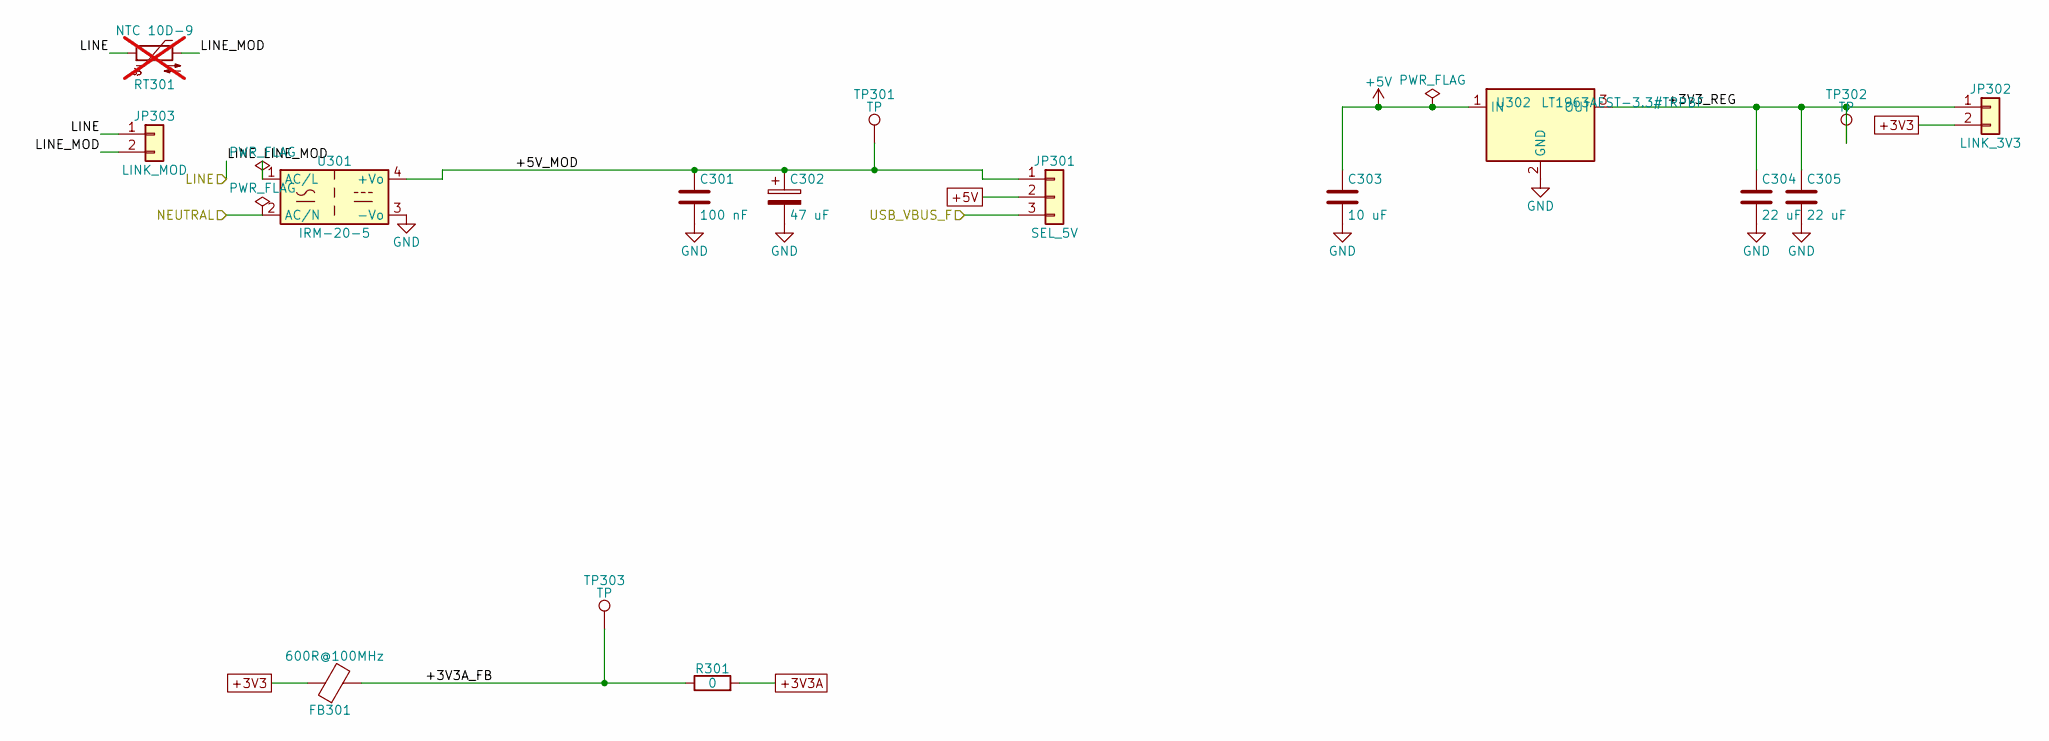
[picture p12: schematic 30-logic-supply.kicad_sch]

Parts:
C301: 100 nF; C_0603_1608Metric; Rating X7R 50 V 10 % 0603; MPN CC0603KRX7R9BB104; LCSC C14663
C302: 47 uF; CP_Elec_6.3x5.2; Rating aluminium electrolytic 16 V 20 % SMD 6.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; MPN MVK 16V47 M 6.3*5.2; LCSC C165623
C303: 10 uF; C_0603_1608Metric; Rating X5R 10 V 10 % 0603; MPN CL10A106KP8NNNC; LCSC C19702
C304, C305: 22 uF; C_0805_2012Metric; Rating X5R 10 V 20 % 0805, 85 degC; MPN LMK212BBJ226MG-T; LCSC C92811
FB301: 600R@100MHz; L_0603_1608Metric; Rating 0603, 0.50 ohm DC max, 350 mA, 25 %; MPN FCM1608KF-601T03; LCSC C141723
JP301: SEL_5V; PinHeader_1x03_P2.54mm_Vertical; Rating 1x3 2.54 mm header with one shorting ju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; MPN PZ254V-11-03P; LCSC C2937625
JP302: LINK_3V3; PinHeader_1x02_P2.54mm_Vertical; Rating 1x2 2.54 mm header with shorting jumper; MPN PZ254V-11-02P; LCSC C492401
JP303: LINK_MOD; JP101_WireLink_P10mm; Rating two plated holes for a wire link (1.5 m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; MPN none (owner-fitted wire); LCSC none
R301: 0; R_0603_1608Metric; Rating 0 ohm 0603 100 mW; MPN 0603WAF0000T5E; LCSC C21189
RT301: NTC 10D-9; C_Disc_D11.0mm_W5.0mm_P7.50mm; Rating NTC inrush limiter 10 ohm at 25 degC +/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; MPN NTC 10D-9; LCSC C3790; not fitted
TP301, TP302, TP303: TP; TestPoint_Pad_D1.0mm_Tight; Rating pad 1.5 mm; LCSC none
U301: IRM-20-5; Converter_ACDC_MeanWell_IRM-20-xx_THT; Rating 85-305 Vac input, 5 V 4 A, 4.2 kVac in-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; MPN IRM-20-5; LCSC C6280121
U302: LT1963AEST-3.3#TRPBF; SOT-223-3_TabPin2; Rating input and output pins +/-20 V absolute 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; MPN LT1963AEST-3.3#TRPBF; LCSC C459918

Connections:
+3V3: FB301.1, JP302.2
+3V3A: R301.2
+3V3A_FB: FB301.2, R301.1, TP303.1
+3V3_REG: C304.1, C305.1, JP302.1, TP302.1, U302.3 (OUT)
+5V: C303.1, JP301.2, JP303.2, RT301.2, U301.1 (AC/L), U301.2 (AC/N), U302.1 (IN)
+5V_MOD: C301.1, C302.1, JP301.1, TP301.1, U301.4 (+Vo)
GND: C301.2, C302.2, C303.2, C304.2, C305.2, U301.3 (-Vo), U302.2 (GND)
LINE: JP303.1, RT301.1
USB_VBUS_F: JP301.3
