Resident-X/brew-state/hardware/sunbeam-em7000/main-board/57-current-sensing-inputs.kicad_sch

## KiCad design hardware/sunbeam-em7000/main-board/57-current-sensing-inputs.kicad_sch (2026-11-06)

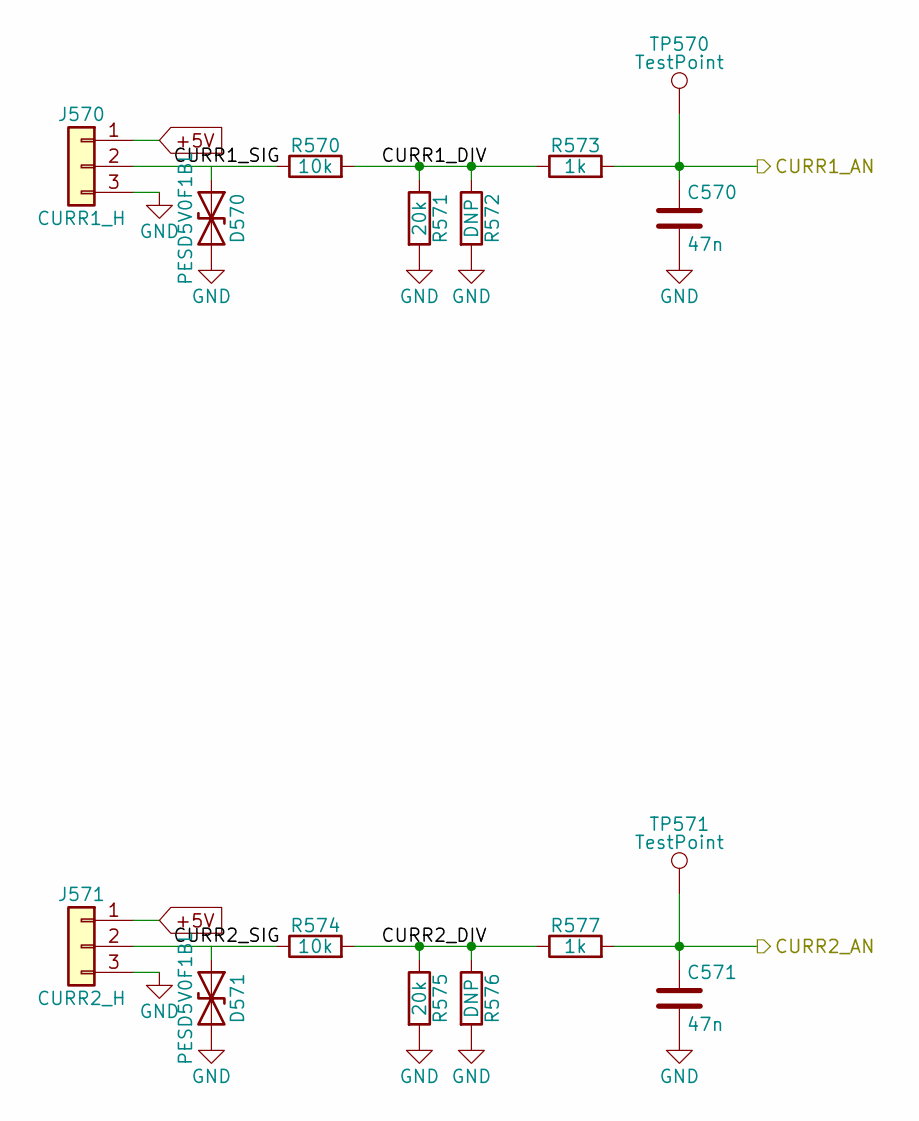
[picture p13: schematic 57-current-sensing-inputs.kicad_sch]

Parts:
C570, C571: 47n; C_0603_1608Metric; Rating 10% X7R 50V 0603; MPN CL10B473KB8NNNC; LCSC C1622
D570, D571: PESD5V0F1BL; D_SOD-882; Rating bidirectional 5.5V standoff, 0.55pF max; MPN PESD5V0F1BL,315; LCSC C45961
J570: CURR1_H; PinHeader_1x03_P2.54mm_Vertical; Rating 2.54mm 0.63mm pins; MPN 2.54mm 1x3 header; LCSC C49257
J571: CURR2_H; PinHeader_1x03_P2.54mm_Vertical; Rating 2.54mm 0.63mm pins; MPN 2.54mm 1x3 header; LCSC C49257
R570, R574: 10k; R_0603_1608Metric; Rating 1% 100ppm/K 0603 100mW; MPN 0603WAF1002T5E; LCSC C25804
R571, R575: 20k; R_0603_1608Metric; Rating 1% 100ppm/K 0603 100mW; MPN 0603WAF2002T5E; LCSC C4184
R572, R576: DNP; R_0603_1608Metric; Rating 1% 100ppm/K 0603 100mW; MPN 0603WAF1002T5E; LCSC C25804
R573, R577: 1k; R_0603_1608Metric; Rating 1% 100ppm/K 0603 100mW; MPN 0603WAF1001T5E; LCSC C21190
TP570, TP571: TestPoint; TestPoint_Pad_D1.0mm_Tight; Rating pad 1.5mm; LCSC none

Connections:
+5V: J570.1, J571.1
CURR1_AN: C570.1, R573.2, TP570.1
CURR1_DIV: R570.2, R571.1, R572.1, R573.1
CURR1_SIG: D570.1 (A1), J570.2, R570.1
CURR2_AN: C571.1, R577.2, TP571.1
CURR2_DIV: R574.2, R575.1, R576.1, R577.1
CURR2_SIG: D571.1 (A1), J571.2, R574.1
GND: C570.2, C571.2, D570.2 (A2), D571.2 (A2), J570.3, J571.3, R571.2, R572.2, R575.2, R576.2
