Resident-X/brew-state/hardware/sunbeam-em7000/main-board/720-heater-led-drive-and-wall-board-header.kicad_sch

## KiCad design hardware/sunbeam-em7000/main-board/720-heater-led-drive-and-wall-board-header.kicad_sch (2026-11-06)

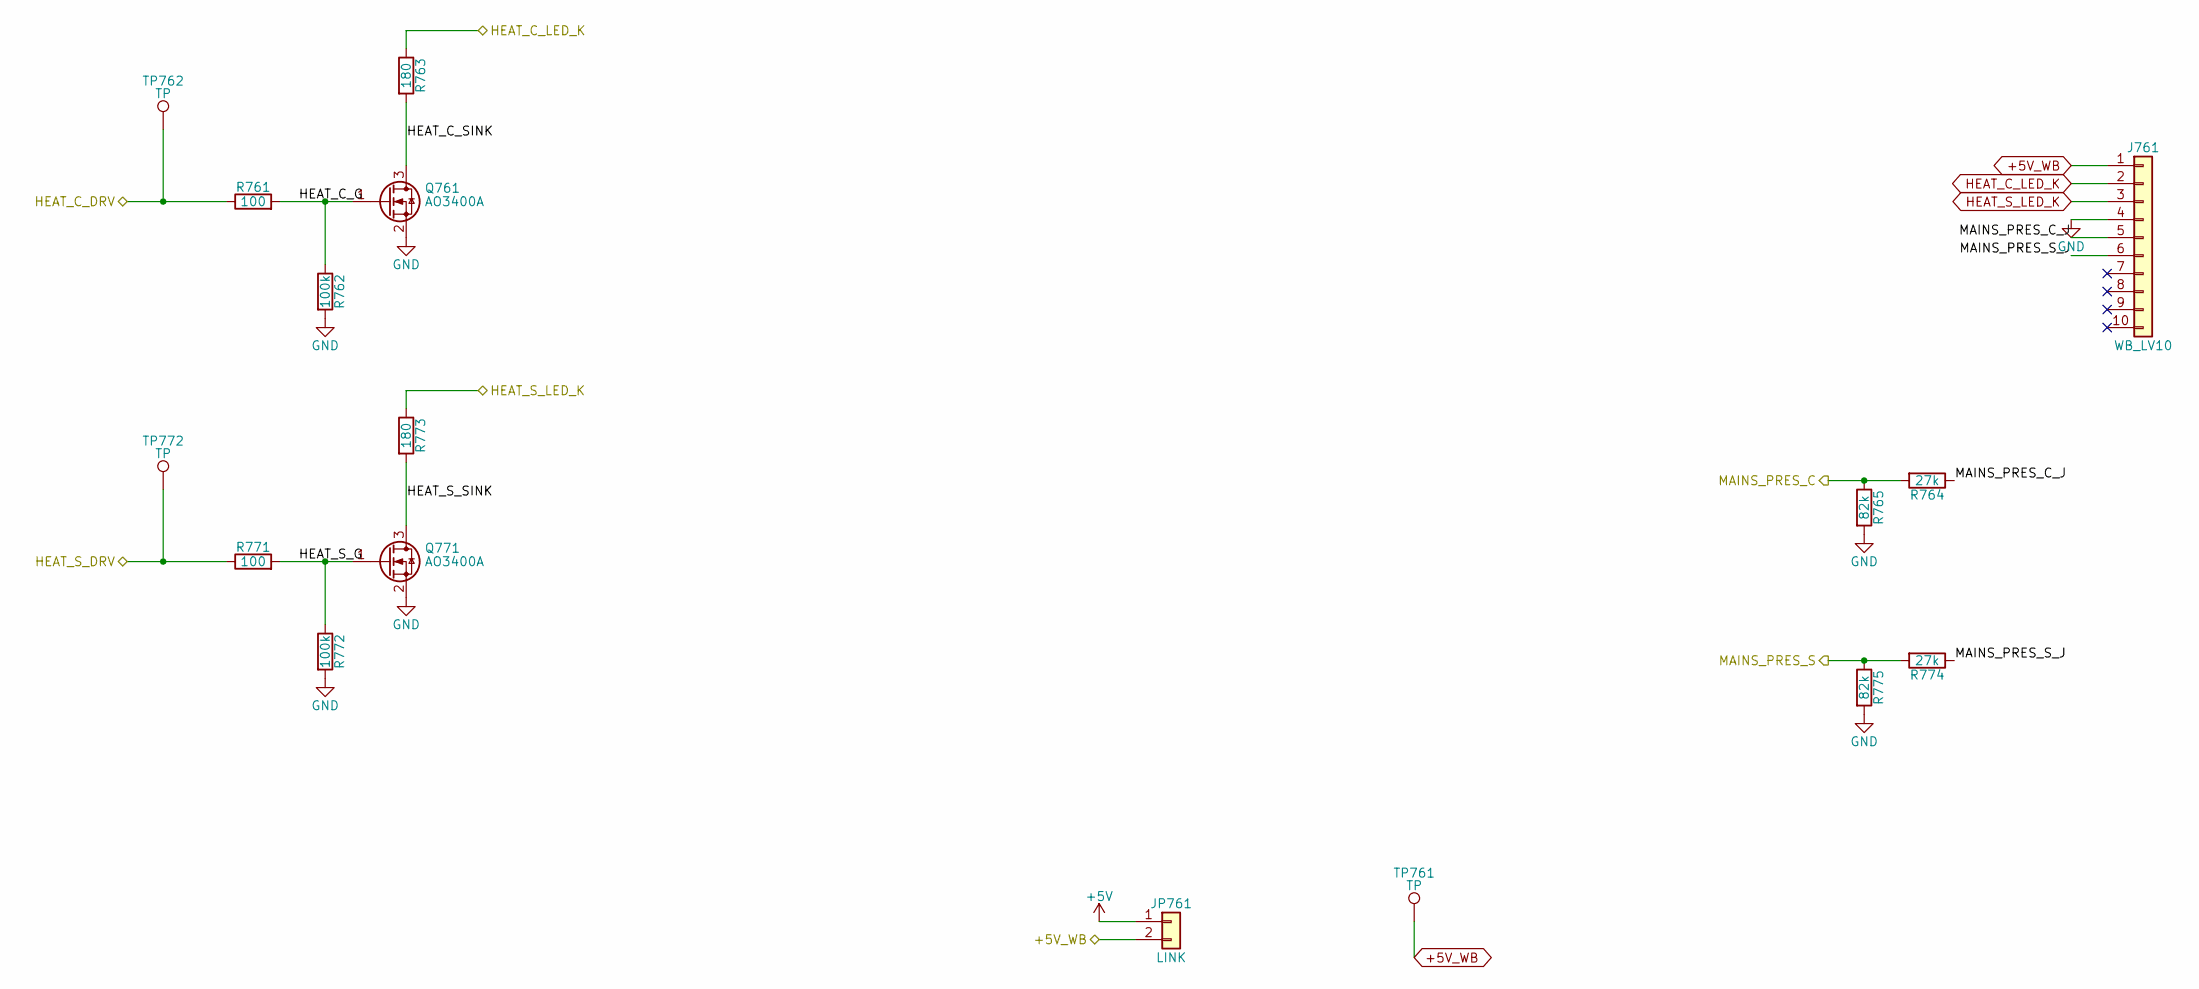
[picture p14: schematic 720-heater-led-drive-and-wall-board-header.kicad_sch]

Parts:
J761: WB_LV10; PinHeader_1x10_P2.54mm_Vertical; Rating 1x10 2.54 mm pin header, 3 A, vertical; MPN 2.54-1*10PPin; LCSC C57369
JP761: LINK; PinHeader_1x02_P2.54mm_Vertical; Rating 1x2 2.54 mm header + shunt jumper, 3 A,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; MPN PH2.54-1X2P-H25 + 2.54 Short Circuit Ca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; LCSC C42431798
Q761, Q771: AO3400A; SOT-23; Rating 30V 5.7A, RDS(on) <48 mohm at VGS 2.5 V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; MPN AO3400A; LCSC C20917
R761, R771: 100; R_0603_1608Metric; Rating 1% 100mW 75V 0603; MPN 0603WAF1000T5E; LCSC C22775
R762, R772: 100k; R_0603_1608Metric; Rating 1% 100mW 75V 0603; MPN 0603WAF1003T5E; LCSC C25803
R763, R773: 180; R_1206_3216Metric; Rating 1% 250mW 200V 1206; MPN 1206W4F1800T5E; LCSC C17924
R764, R774: 27k; R_0603_1608Metric; Rating 1% 100mW 75V 0603; MPN 0603WAF2702T5E; LCSC C22967
R765, R775: 82k; R_0603_1608Metric; Rating 1% 100mW 75V 0603; MPN 0603WAF8202T5E; LCSC C23254
TP761, TP762, TP772: TP; TestPoint_Pad_D1.0mm_Tight; Rating test point; LCSC none

Connections:
+5V: JP761.1
+5V_WB: J761.1, JP761.2, TP761.1
GND: J761.4, Q761.2 (S), Q771.2 (S), R762.2, R765.2, R772.2, R775.2
HEAT_C_DRV: R761.1, TP762.1
HEAT_C_G: Q761.1 (G), R761.2, R762.1
HEAT_C_LED_K: J761.2, R763.1
HEAT_C_SINK: Q761.3 (D), R763.2
HEAT_S_DRV: R771.1, TP772.1
HEAT_S_G: Q771.1 (G), R771.2, R772.1
HEAT_S_LED_K: J761.3, R773.1
HEAT_S_SINK: Q771.3 (D), R773.2
MAINS_PRES_C: R764.2, R765.1
MAINS_PRES_C_J: J761.5, R764.1
MAINS_PRES_S: R774.2, R775.1
MAINS_PRES_S_J: J761.6, R774.1
