Resident-X/brew-state/hardware/sunbeam-em7000/main-board/750-knob-tank-level-and-reed-inputs.kicad_sch

## KiCad design hardware/sunbeam-em7000/main-board/750-knob-tank-level-and-reed-inputs.kicad_sch (2026-11-06)

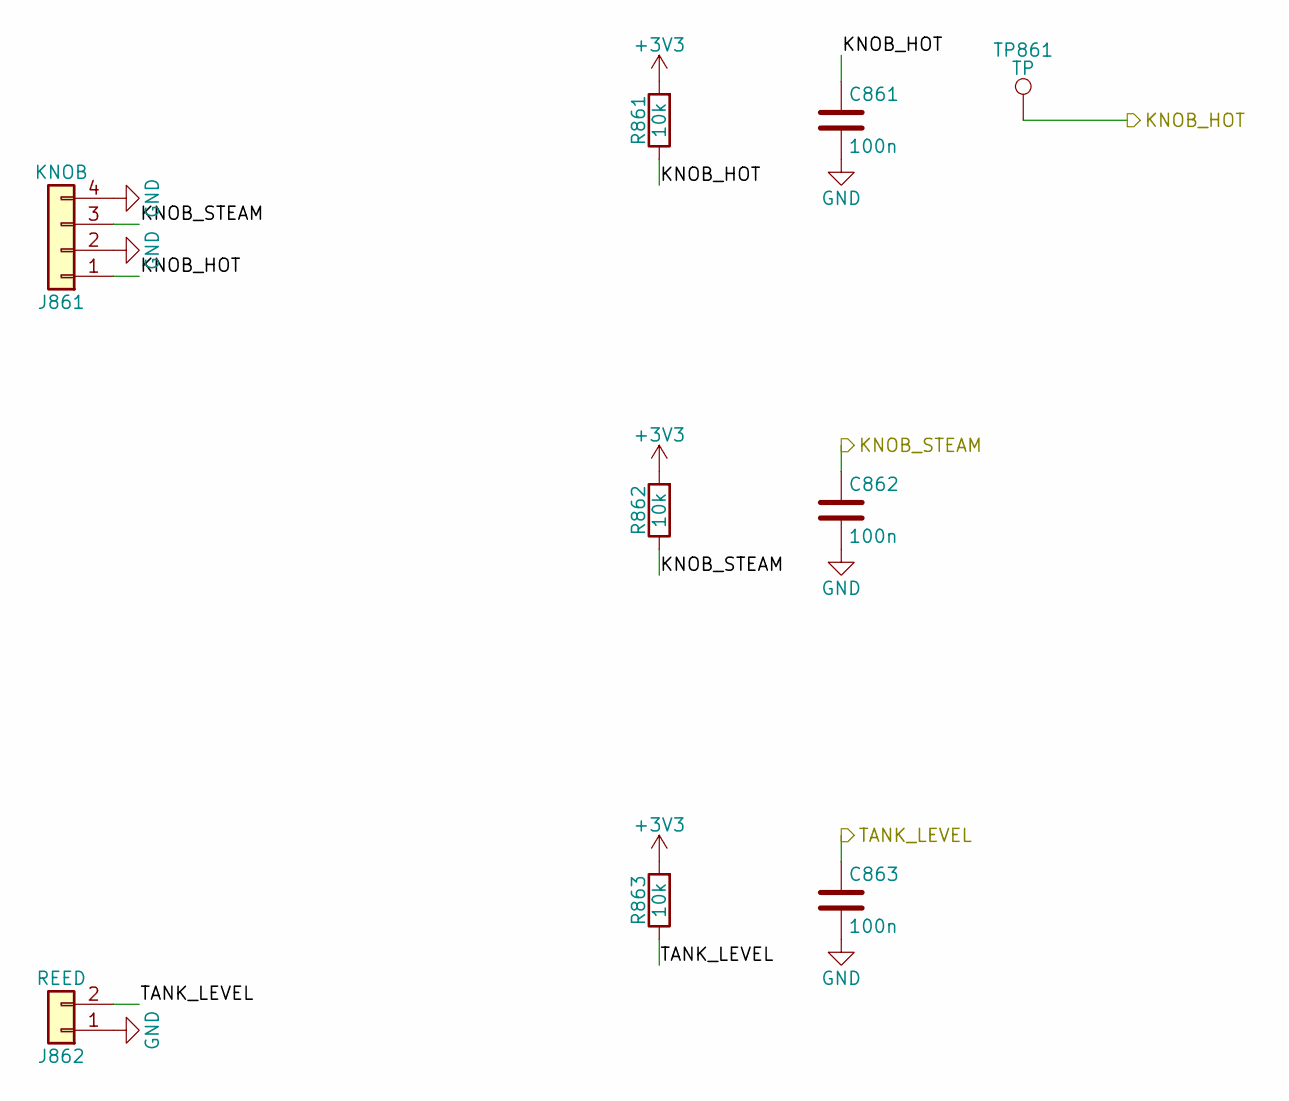
[picture p15: schematic 750-knob-tank-level-and-reed-inputs.kicad_sch]

Parts:
C861, C862, C863: 100n; C_0603_1608Metric; Rating 10% X7R 50V 0603; MPN CC0603KRX7R9BB104; LCSC C14663
J861: KNOB; JST_PH_B4B-PH-K_1x04_P2.00mm_Vertical; Rating 4-way header, JST B4B-PH-K-S (2.00 mm; 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; MPN B4B-PH-K-S(LF)(SN); LCSC C131334
J862: REED; REED_PADS_P20.00mm; Rating two through-hole pads 20.0 mm apart for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; LCSC none
R861, R862, R863: 10k; R_0603_1608Metric; Rating 1% 100mW 75V 0603; MPN 0603WAF1002T5E; LCSC C25804
TP861: TP; TestPoint_Pad_D1.0mm_Tight; Rating test point; LCSC none

Connections:
+3V3: R861.2, R862.2, R863.2
GND: C861.2, C862.2, C863.2, J861.2, J861.4, J862.1
KNOB_HOT: C861.1, J861.1, R861.1, TP861.1
KNOB_STEAM: C862.1, J861.3, R862.1
TANK_LEVEL: C863.1, J862.2, R863.1
