Resident-X/brew-state/hardware/sunbeam-em7000/main-board/E1-supply-voltage-and-current-measurement.kicad_sch

## KiCad design hardware/sunbeam-em7000/main-board/E1-supply-voltage-and-current-measurement.kicad_sch (2026-11-06)

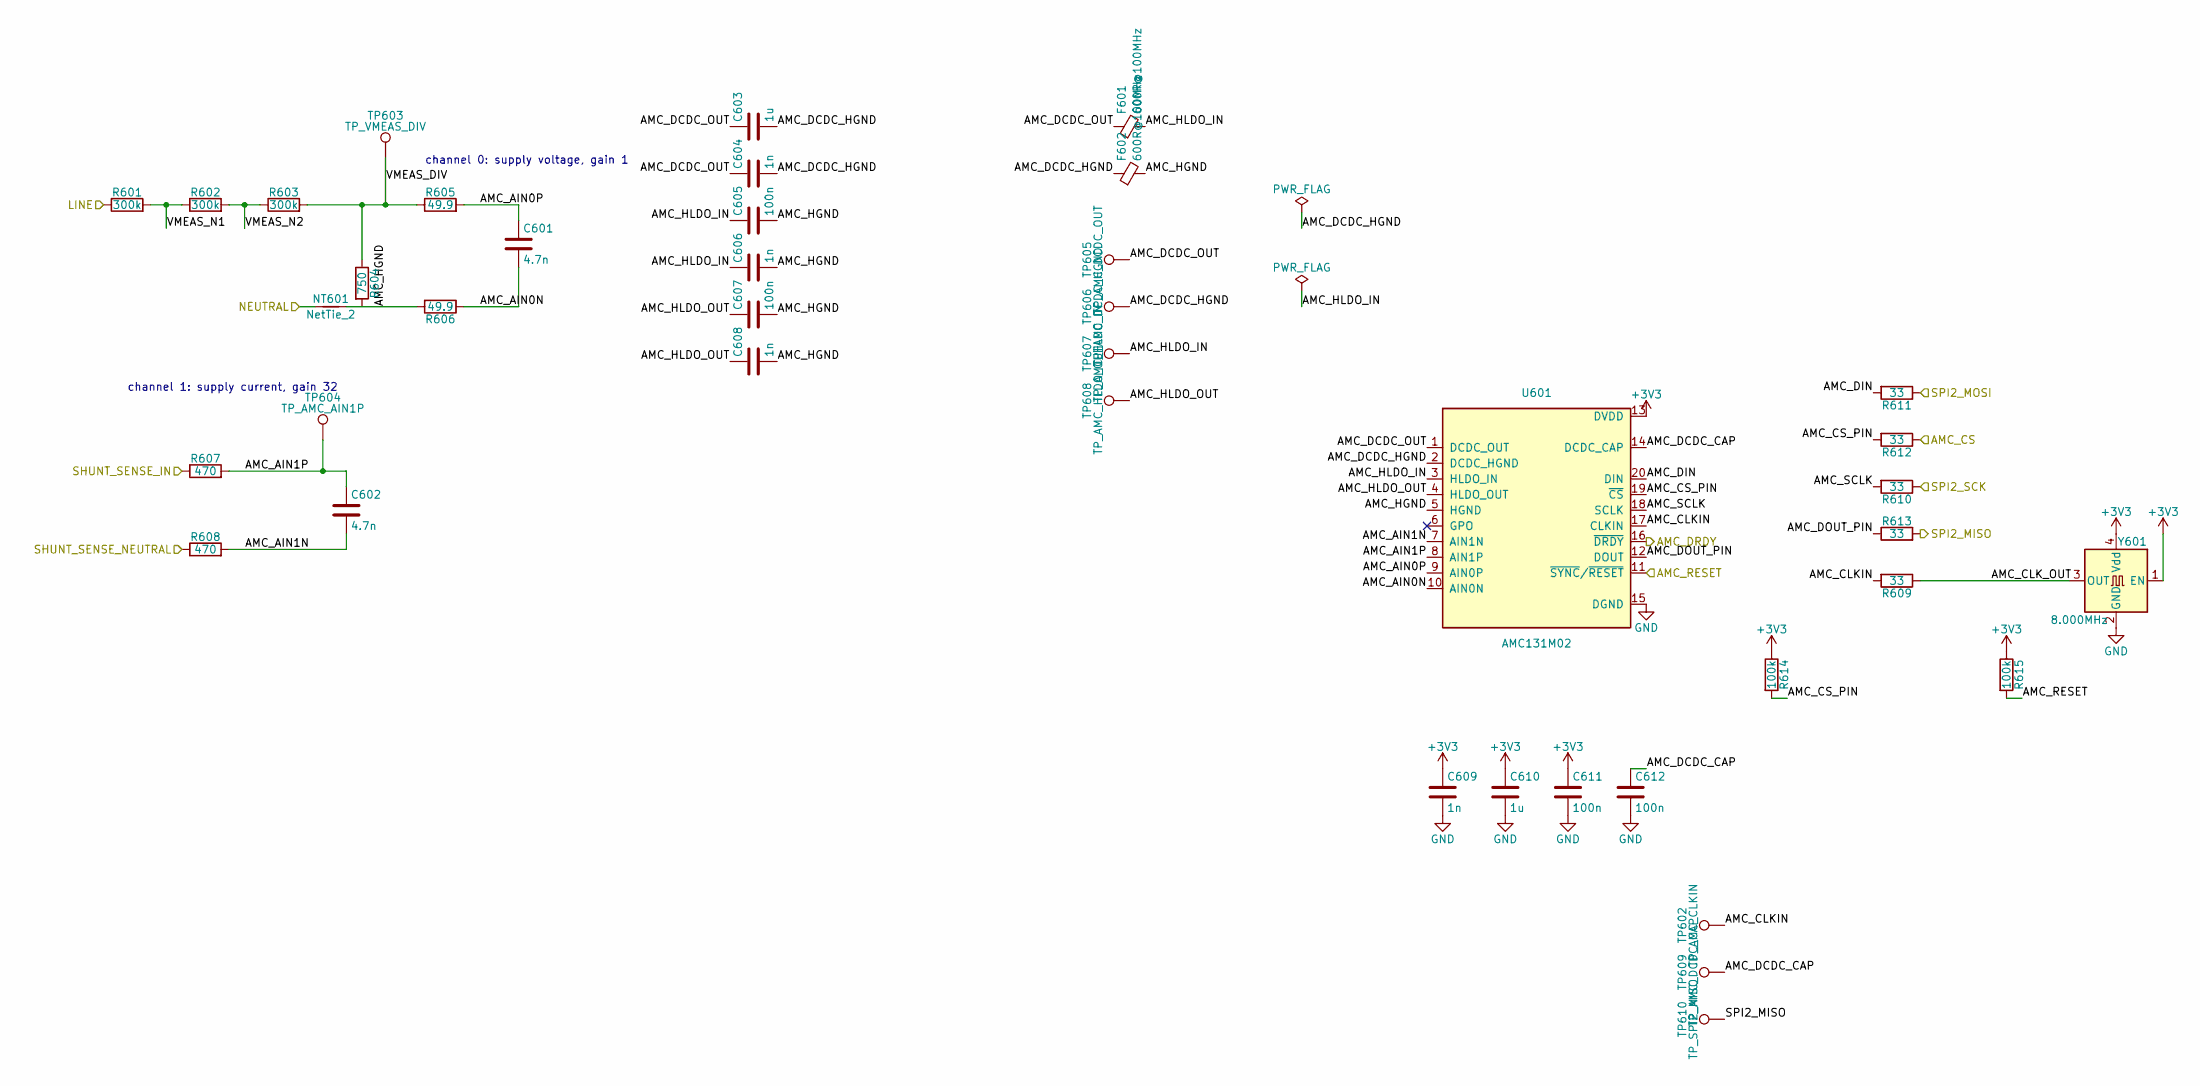
[picture p16: schematic E1-supply-voltage-and-current-measurement.kicad_sch]

Parts:
C601, C602: 4.7n; C_0805_2012Metric; Rating C0G 50V 10% 0805; MPN C0805N472K050T; LCSC C105936
C603, C610: 1u; C_0603_1608Metric; Rating X7R 25V 10% 0603; MPN CC0603KRX7R8BB105; LCSC C106858
C604, C606, C608, C609: 1n; C_0603_1608Metric; Rating X7R 50V 10% 0603; MPN CL10B102KB8NNNC; LCSC C1588
C605, C611, C612: 100n; C_0603_1608Metric; Rating X7R 50V 10% 0603; MPN CL10B104KB8NNNC; LCSC C1591
C607: 100n; C_1206_3216Metric; Rating C0G 50V 5% 1206; MPN 1206N104J500CT; LCSC C170182
F601, F602: 600R@100MHz; L_0603_1608Metric; Rating 0603 350mA 0.5ohm; MPN FCM1608KF-601T03; LCSC C141723
NT601: NetTie_2; NetTie-2_SMD_Pad0.5mm; LCSC none
R601, R602, R603: 300k; R_2512_6332Metric; Rating 1% 100ppm 2512 1W 200V working, 400V ov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; MPN FRC2512F3003TS; LCSC C2960835
R604: 750; R_0603_1608Metric; Rating 1% 100ppm 0603 100mW; MPN 0603WAF7500T5E; LCSC C23241
R605, R606: 49.9; R_0603_1608Metric; Rating 1% 100ppm 0603 100mW; MPN 0603WAF499JT5E; LCSC C23185
R607, R608: 470; R_0603_1608Metric; Rating 1% 100ppm 0603 100mW; MPN 0603WAF4700T5E; LCSC C23179
R609, R610, R611, R612, R613: 33; R_0603_1608Metric; Rating 1% 100mW 75V 0603; MPN 0603WAF330JT5E; LCSC C23140
R614, R615: 100k; R_0603_1608Metric; Rating 1% 100mW 75V 0603; MPN 0603WAF1003T5E; LCSC C25803
TP602: TP_AMC_CLKIN; TestPoint_Pad_D1.0mm_Tight; LCSC none
TP603: TP_VMEAS_DIV; TestPoint_Pad_D1.0mm_Tight; LCSC none
TP604: TP_AMC_AIN1P; TestPoint_Pad_D1.0mm_Tight; LCSC none
TP605: TP_AMC_DCDC_OUT; TestPoint_Pad_D1.0mm_Tight; LCSC none
TP606: TP_AMC_DCDC_HGND; TestPoint_Pad_D1.0mm_Tight; LCSC none
TP607: TP_AMC_HLDO_IN; TestPoint_Pad_D1.0mm_Tight; LCSC none
TP608: TP_AMC_HLDO_OUT; TestPoint_Pad_D1.0mm_Tight; LCSC none
TP609: TP_AMC_DCDC_CAP; TestPoint_Pad_D1.0mm_Tight; LCSC none
TP610: TP_SPI2_MISO; TestPoint_Pad_D1.0mm_Tight; LCSC none
U601: AMC131M02; AMC131M02_SOIC-20W_DFM0020A; Rating reinforced isolation VIORM 1700 V pk, V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; MPN AMC131M02DFMR; LCSC C31423783
Y601: 8.000MHz; Oscillator_SMD_Abracon_ASE-4Pin_3.2x2.5mm_Pin1Mark; Rating 2.97-3.63 V supply range, 3.3 V LVCMOS,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; MPN SiT8008BI-22-33E-8.000000; LCSC C819601

Connections:
+3V3: C609.1, C610.1, C611.1, R614.1, R615.1, U601.13 (DVDD), Y601.1 (EN), Y601.4 (Vdd)
AMC_AIN0N: C601.2, R606.1, U601.10 (AIN0N)
AMC_AIN0P: C601.1, R605.2, U601.9 (AIN0P)
AMC_AIN1N: C602.2, R608.2, U601.7 (AIN1N)
AMC_AIN1P: C602.1, R607.2, TP604.1, U601.8 (AIN1P)
AMC_CLKIN: R609.2, TP602.1, U601.17 (CLKIN)
AMC_CLK_OUT: R609.1, Y601.3 (OUT)
AMC_CS: R612.1
AMC_CS_PIN: R612.2, R614.2, U601.19 (~CS)
AMC_DCDC_CAP: C612.1, TP609.1, U601.14 (DCDC_CAP)
AMC_DCDC_OUT: C603.1, C604.1, F601.1, TP605.1, U601.1 (DCDC_OUT)
AMC_DIN: R611.2, U601.20 (DIN)
AMC_DOUT_PIN: R613.1, U601.12 (DOUT)
AMC_DRDY: U601.16 (~DRDY)
AMC_HGND: C605.2, C606.2, C607.2, C608.2, F602.2, NT601.2, R604.2, R606.2, U601.5 (HGND)
AMC_HLDO_OUT: C607.1, C608.1, TP608.1, U601.4 (HLDO_OUT)
AMC_RESET: R615.2, U601.11 (~SYNC/~RESET)
AMC_SCLK: R610.2, U601.18 (SCLK)
GND: C609.2, C610.2, C611.2, C612.2, U601.15 (DGND), Y601.2 (GND)
LINE: R601.1
NEUTRAL: NT601.1
PWR_FLAG: C603.2, C604.2, C605.1, C606.1, F601.2, F602.1, TP606.1, TP607.1, U601.2 (DCDC_HGND), U601.3 (HLDO_IN)
SHUNT_SENSE_IN: R607.1
SHUNT_SENSE_NEUTRAL: R608.1
SPI2_MISO: R613.2, TP610.1
SPI2_MOSI: R611.1
SPI2_SCK: R610.1
VMEAS_DIV: R603.2, R604.1, R605.1, TP603.1
VMEAS_N1: R601.2, R602.1
VMEAS_N2: R602.2, R603.1

Notes on the sheet:
channel 0: supply voltage, gain 1
channel 1: supply current, gain 32
