Resident-X/brew-state/hardware/sunbeam-em7000/main-board/E2-zero-crossing-detector.kicad_sch

## KiCad design hardware/sunbeam-em7000/main-board/E2-zero-crossing-detector.kicad_sch (2026-11-06)

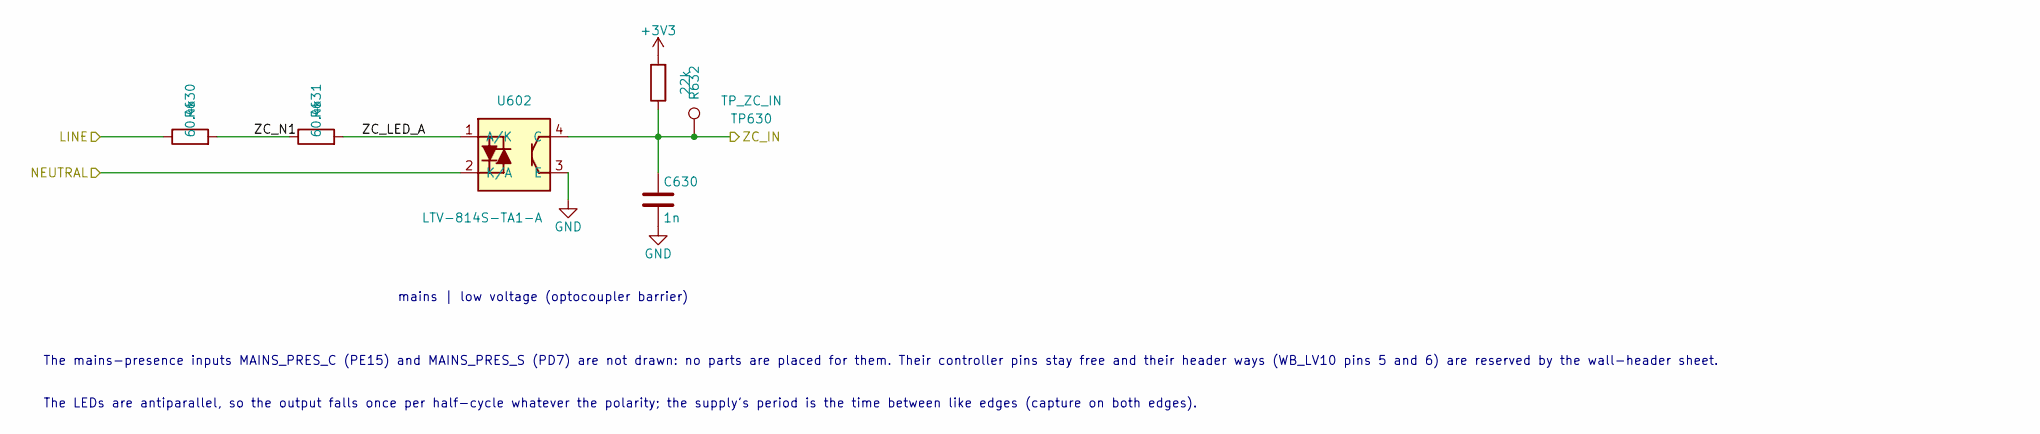
[picture p17: schematic E2-zero-crossing-detector.kicad_sch]

Parts:
C630: 1n; C_0603_1608Metric; Rating X7R 50V 10% 0603; MPN CL10B102KB8NNNC; LCSC C1588
R630, R631: 60.4k; R_2512_6332Metric; Rating 1% 100ppm 2512 1W 200V working, 400V ov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; MPN FRC2512F6042TS; LCSC C5126066
R632: 22k; R_0603_1608Metric; Rating 1% 100mW 75V 0603; MPN 0603WAF2202T5E; LCSC C31850
TP630: TP_ZC_IN; TestPoint_Pad_D1.0mm_Tight; LCSC none
U602: LTV-814S-TA1-A; LTV-814S_SMD-4; Rating isolation 5000 VAC rms 1 min, AC input,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; MPN LTV-814S-TA1-A; LCSC C108051

Connections:
+3V3: R632.2
GND: C630.2, U602.3 (E)
LINE: R630.1
NEUTRAL: U602.2 (K/A)
ZC_IN: C630.1, R632.1, TP630.1, U602.4 (C)
ZC_LED_A: R631.2, U602.1 (A/K)
ZC_N1: R630.2, R631.1

Notes on the sheet:
The mains-presence inputs MAINS_PRES_C (PE15) and MAINS_PRES_S (PD7) are not drawn: no parts are placed for them. Their controller pins stay free and their header ways (WB_LV10 pins 5 and 6) are reserved by the wall-header sheet.
The LEDs are antiparallel, so the output falls once per half-cycle whatever the polarity; the supply's period is the time between like edges (capture on both edges).
mains | low voltage (optocoupler barrier)
