Resident-X/brew-state/hardware/sunbeam-em7000/main-board/E3-in-stream-temperature-converters.kicad_sch

## KiCad design hardware/sunbeam-em7000/main-board/E3-in-stream-temperature-converters.kicad_sch (2026-11-06)

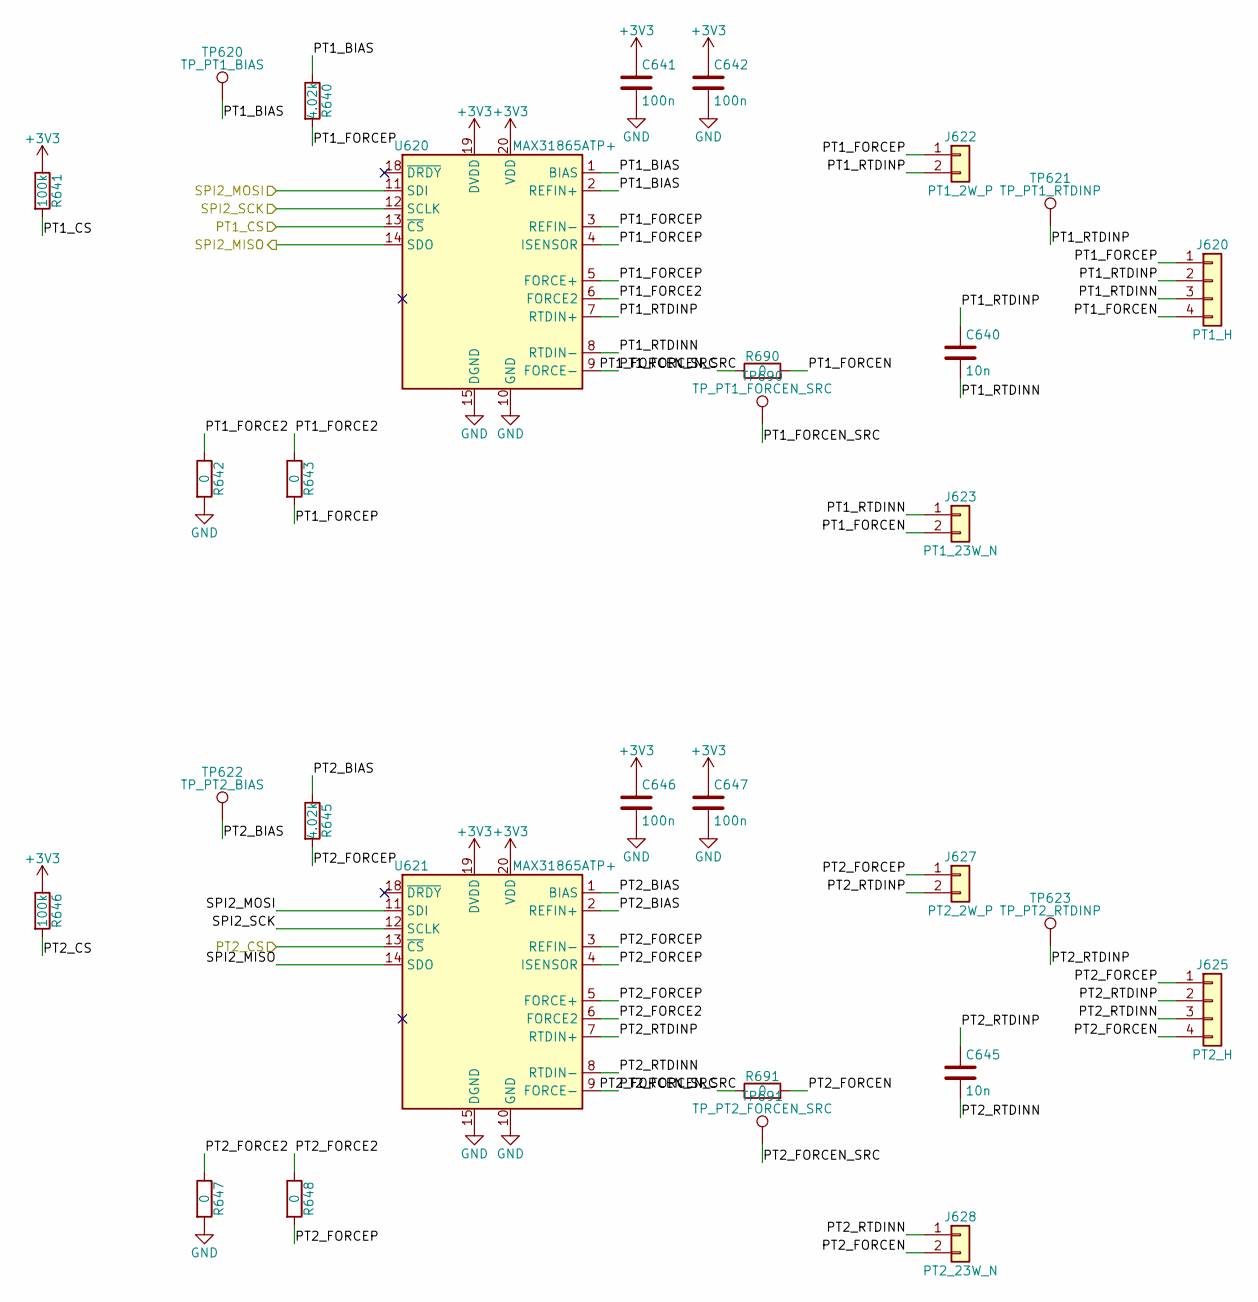
[picture p18: schematic E3-in-stream-temperature-converters.kicad_sch]

Parts:
C640, C645: 10n; C_0603_1608Metric; Rating X7R 50V 10% 0603; MPN CL10B103KB8NNNC; LCSC C1589
C641, C642, C646, C647: 100n; C_0603_1608Metric; Rating X7R 50V 10% 0603; MPN CL10B104KB8NNNC; LCSC C1591
J620: PT1_H; JST_XH_B4B-XH-A_1x04_P2.50mm_Vertical; Rating JST XH 2.5 mm 3 A 250 V; MPN XH-4PA; LCSC C5258885
J622: PT1_2W_P; PinHeader_1x02_P2.54mm_Vertical; Rating 2.54 mm header with jumper cap; MPN 2.54-1*40P (cut) with jumper cap 2.54Sh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; LCSC C2337
J623: PT1_23W_N; PinHeader_1x02_P2.54mm_Vertical; Rating 2.54 mm header with jumper cap; MPN 2.54-1*40P (cut) with jumper cap 2.54Sh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; LCSC C2337
J625: PT2_H; JST_XH_B4B-XH-A_1x04_P2.50mm_Vertical; Rating JST XH 2.5 mm 3 A 250 V; MPN XH-4PA; LCSC C5258885
J627: PT2_2W_P; PinHeader_1x02_P2.54mm_Vertical; Rating 2.54 mm header with jumper cap; MPN 2.54-1*40P (cut) with jumper cap 2.54Sh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; LCSC C2337
J628: PT2_23W_N; PinHeader_1x02_P2.54mm_Vertical; Rating 2.54 mm header with jumper cap; MPN 2.54-1*40P (cut) with jumper cap 2.54Sh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; LCSC C2337
R640, R645: 4.02k; R_0603_1608Metric; Rating 0.1% 25ppm 0603 100mW thin film; MPN ERA3AEB4021V; LCSC C491130
R641, R646: 100k; R_0603_1608Metric; Rating 1% 100mW 75V 0603; MPN 0603WAF1003T5E; LCSC C25803
R642, R643, R647, R648: 0; R_0603_1608Metric; Rating 0603 0 ohm link; MPN 0603WAF0000T5E; LCSC C21189
R690, R691: 0; R_0603_1608Metric; Rating 0603 zero-ohm link; MPN 0603WAF0000T5E; LCSC C21189
TP620: TP_PT1_BIAS; TestPoint_Pad_D1.0mm_Tight; LCSC none
TP621: TP_PT1_RTDINP; TestPoint_Pad_D1.0mm_Tight; LCSC none
TP622: TP_PT2_BIAS; TestPoint_Pad_D1.0mm_Tight; LCSC none
TP623: TP_PT2_RTDINP; TestPoint_Pad_D1.0mm_Tight; LCSC none
TP690: TP_PT1_FORCEN_SRC; TestPoint_Pad_D1.0mm_Tight; LCSC none
TP691: TP_PT2_FORCEN_SRC; TestPoint_Pad_D1.0mm_Tight; LCSC none
U620, U621: MAX31865ATP+; TQFN-20-1EP_5x5mm_P0.65mm_EP3.1x3.1mm; Rating 4 V absolute maximum VDD and DVDD, VDD/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; MPN MAX31865ATP+T; LCSC C118474

Connections:
+3V3: C641.1, C642.1, C646.1, C647.1, R641.1, R646.1, U620.19 (DVDD), U620.20 (VDD), U621.19 (DVDD), U621.20 (VDD)
GND: C641.2, C642.2, C646.2, C647.2, R642.2, R647.2, U620.10 (GND), U620.15 (DGND), U620.16 (GND), U620.21 (GND), U621.10 (GND), U621.15 (DGND), U621.16 (GND), U621.21 (GND)
PT1_BIAS: R640.1, TP620.1, U620.1 (BIAS), U620.2 (REFIN+)
PT1_CS: R641.2, U620.13 (~CS)
PT1_FORCE2: R642.1, R643.1, U620.6 (FORCE2)
PT1_FORCEN: J620.4, J623.2, R690.2
PT1_FORCEN_SRC: R690.1, TP690.1, U620.9 (FORCE-)
PT1_FORCEP: J620.1, J622.1, R640.2, R643.2, U620.3 (REFIN-), U620.4 (ISENSOR), U620.5 (FORCE+)
PT1_RTDINN: C640.2, J620.3, J623.1, U620.8 (RTDIN-)
PT1_RTDINP: C640.1, J620.2, J622.2, TP621.1, U620.7 (RTDIN+)
PT2_BIAS: R645.1, TP622.1, U621.1 (BIAS), U621.2 (REFIN+)
PT2_CS: R646.2, U621.13 (~CS)
PT2_FORCE2: R647.1, R648.1, U621.6 (FORCE2)
PT2_FORCEN: J625.4, J628.2, R691.2
PT2_FORCEN_SRC: R691.1, TP691.1, U621.9 (FORCE-)
PT2_FORCEP: J625.1, J627.1, R645.2, R648.2, U621.3 (REFIN-), U621.4 (ISENSOR), U621.5 (FORCE+)
PT2_RTDINN: C645.2, J625.3, J628.1, U621.8 (RTDIN-)
PT2_RTDINP: C645.1, J625.2, J627.2, TP623.1, U621.7 (RTDIN+)
SPI2_MISO: U620.14 (SDO), U621.14 (SDO)
SPI2_MOSI: U620.11 (SDI), U621.11 (SDI)
SPI2_SCK: U620.12 (SCLK), U621.12 (SCLK)
