Resident-X/brew-state/firmware/params/thermoblock-variant.params

# The reference machine's description with one coefficient changed:
# brew.heater_power_w is 1600 rather than the 1000 the service manual gives.
#
# It exists so that one linked executable can be run against both and produce
# two different trajectories with no rebuild between the runs. A coefficient
# quietly written into the equations rather than read from a description would
# give the same trajectory twice, which is exactly what that check fails on.
#
# The changed figure is not this machine's, so the description as a whole claims
# no machine and says so below. That statement is what exempts it from
# accounting for its values: there is no origin to record for a number chosen
# because it differs, and requiring one would only produce a form of words.
#
# The other twenty-four values are the reference description's, and the account of
# where each came from is there rather than here -- deliberately, because this
# file must stay one coefficient away from that one for the check to conclude
# anything from the pair. So quote thermoblock.params, never this file: a figure
# read out of here has had its provenance stripped by design, and one value of
# the twenty-five is not the machine's at all.

@describes-no-machine

ambient_temperature_c = 20.0

brew.thermal_mass_j_per_k = 320.0
brew.heater_power_w = 1600.0
brew.loss_w_per_k = 1.2
brew.outlet_held_volume_ml = 4.0
brew.outlet_conduction_time_constant_s = 20.0

steam.thermal_mass_j_per_k = 360.0
steam.heater_power_w = 1000.0
steam.loss_w_per_k = 1.5

pump.pressure_bar = 15.0
pump.flow_ml_per_s = 7.0
brew.pressure_time_constant_s = 0.8

water.feed_temperature_c = 20.0
water.heat_capacity_j_per_ml_k = 4.15
water.latent_heat_j_per_ml = 2160.0

steam.saturation_temperature_c = 100.0
steam.saturation_antoine_a = 5.26509
steam.saturation_antoine_b_k = 1810.94
steam.saturation_antoine_c_c = 244.485
steam.casting_ceiling_c = 150.0
steam.restriction_bar_s2_per_ml2 = 25.0
steam.outlet_drop_k_s_per_ml = 15.0
steam.liquid_capacity_ml = 6.0
steam.initial_inventory_ml = 2.0
steam.feed_flow_ml_per_s = 3.0
