Resident-X/brew-state/(commit log)

2026-08-16 feat(graph): requirement chain for the EM7000 retrofit control system
    Establishes the full requirement chain for a DIY retrofit replacing the OEM
    controller on a Sunbeam EM7000 (dual thermoblock) with a model-based control
    system. 287 nodes: 3 personas, 8 obligations, 7 journeys, 33 functional /
    constraint / interface requirements, 14 definitions, 2 decisions.
    Why
    The project's thesis is that requirement-driven engineering produces better
    software faster. This graph is the bet: every design decision downstream has
    to answer to a criterion here, and the criteria are deliberately free of
    mechanism so the decisions stay open.
    Three things drove the shape. The two thermoblocks are independent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
    [OBL-CONTROLLER-FAULT-RESPONSE-001.C1.req.yaml, OBL-CONTROLLER-FAULT-RESPONSE-001.C2.req.yaml, OBL-CONTROLLER-FAULT-RESPONSE-001.C3.req.yaml, OBL-CONTROLLER-FAULT-RESPONSE-001.C4.req.yaml, OBL-CONTROLLER-FAULT-RESPONSE-001.C5.req.yaml, OBL-CONTROLLER-FAULT-RESPONSE-001.C6.req.yaml, OBL-CONTROLLER-FAULT-RESPONSE-001.req.yaml, REQ-HARDWARE-HEADROOM-001.C1.req.yaml]
2026-08-16 chore(sources): remove the stale parts list, mark the design notes historical
    Both files were committed in 8859d0d by a blanket `git add -A` that was checked
    for binaries and secrets but not for whether each file should exist in a repo
    intended for publication.
    parts/requirement_bom.csv was already known stale before that commit. It
    contradicts parts/controller_bom.csv on five interfaces — sensing technology,
    load-cell amplifier, solenoid voltage and driver, pump modulation scheme, and
    pump count — and nothing in the graph or the build depends on it. Publishing two
    contradictory parts lists is the specific hazard
    OBL-OPEN-SOURCE-MAINTAINABILITY-001.C3 and .C5 exist to prevent, so i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
    [requirement_bom.csv]
2026-08-16 chore(sources): demote the parts list to a feasibility sketch; add configuration obligation
    The parts list was never a controlled artefact. It was assembled once to answer
    whether the project was achievable cheaply enough to attempt, it answered yes,
    and it was then treated for the rest of this work as though it were a baseline.
    It is not one: prices are unverified, several rows are already superseded, and
    nothing has maintained it.
    Moved to thoughts/ alongside the design notes, since it is the same category of
    thing — working material that informed the graph rather than project output. The
    directory name parts/ made a claim the file could not support, so parts/ is gone.
    A status hea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
    [controller-bom-feasibility-sketch.csv]
2026-08-16 feat(graph): close blind-review findings and extend the requirement chain
    Closes every open finding from the 2026-08-16 blind review (Tiers 2 and 3), then
    a second four-agent blind review of that work, and its findings too.
    Tier 2 — the open-source promise now holds. REQ-MACHINE-CONFIGURATION-001
    requires the machine's local configuration to be declared in one place the
    requirements point at. Every machine-specific power figure is gone from specs/;
    the values live once, in the declaration, with provenance. The external-authority
    obligation now requires its authority to be named rather than left as "domestic
    wiring rules".
    New capability, on the developer's direction:
    - REQ-DELIVERY-PROF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
    [JRN-MAINTAIN-MACHINE-001.C1.req.yaml, JRN-MAINTAIN-MACHINE-001.C2.req.yaml, JRN-MAINTAIN-MACHINE-001.C3.req.yaml, JRN-MAINTAIN-MACHINE-001.C4.req.yaml, JRN-MAINTAIN-MACHINE-001.req.yaml, REQ-MACHINE-CONFIGURATION-001.C1.req.yaml, REQ-MACHINE-CONFIGURATION-001.C2.req.yaml, REQ-MACHINE-CONFIGURATION-001.C3.req.yaml]
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2026-08-16 docs(claude): record engine read discipline and two known gaps
    Read the graph through show / query / trace / links rather than grepping the
    YAML. Raw file reads lose the inline meanings the envelopes carry, a grep misses
    nodes whose wording differs from the search term, and it takes several calls to
    do what one query does. All three cost real time this session.
    Records that deprecation is one-way through the CLI — reversing it needs the
    file-edit escape hatch plus a reindex — and that criterion IDs must be resolved
    individually with show, because directory order is not .C1..Cn order. Getting
    that wrong retires the wrong criterion, and validate does not catch it.
    Also records the three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
2026-08-16 docs: correct how the README describes maintaining the graph
    The README said reading the graph needs nothing but a text editor and left the
    impression that editing it is the same. It is not. Hand-editing a .req.yaml
    bypasses ID assignment, file placement, link wiring and validation, the chain
    boundary, the authoring discipline and the event trail — and it fails quietly,
    because the file still parses. What breaks is a link pointing at something
    retired, a criterion orphaned from its parent, or a change landing with no
    version and no event behind it, none of which structural validation catches.
    Now separates reading from changing: read freely with any editor, change through
    the engine.
    Rec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
2026-08-16 chore: rename the project to Baristate
    "coffee" was a placeholder. Baristate is barista plus state — a machine that
    judges a shot as it happens rather than running a timer, and the state-space
    estimator that lets it.
    Renames the README title, the graph document description and the schema-ownership
    wording in the Taskfile. Deliberately leaves every use of "coffee" inside specs/
    alone: those are the beverage and the coffee side of the machine, not the project.
    The repository directory is still named coffee and the engine still resolves the
    project identity as coffee. Both can move whenever convenient; the reasoning trail
    recorded against the old identity is not worth preserving and is not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
2026-08-16 docs: record the drip-tray vent hypothesis for over-pressure relief
    The brew solenoid may vent to the drip tray when de-energised, which is standard
    espresso practice and would explain why no dedicated relief part is listed.
    Recorded as hypothesis rather than fact, with the reasoning that follows from it.
    If true it is a genuine fail-safe vent — losing power, or losing the controller's
    proof of life, opens the vent path with nothing having to decide. It still would
    not meet OBL-ELECTRICAL-THERMAL-SAFETY-001.C5, because during a delivery the
    valve is deliberately held energised, which is when pressure is highest, so a
    rise firmware has not recognised is a rise nothing vents. That is the ca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
2026-08-16 fix(graph): state the over-pressure criteria as properties, not as relief
    OBL-ELECTRICAL-THERMAL-SAFETY-001.C5 was titled "Over-pressure is relieved
    without any electrical dependency" and required that "relief acts on the pressure
    itself". That names a mechanism inside a Tier-1 safety criterion, and it
    forecloses the better answer: containing the pressure by adequate strength
    eliminates the hazard rather than mitigating it, leaves no device to fail, needs
    no periodic test, and does not disappear when a component is substituted.
    Both criteria now state the property — pressure the machine can generate is
    contained or released, without anything electrical having to act, holding while
    unpower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
2026-08-16 feat(graph): ratify firmware language and pre-energisation verification toolchain
    Fills the decision space REQ-PREENERGISATION-VERIFICATION-001 deliberately
    left open (how the plant model is obtained, what executes the control law,
    what tooling), and captures a separability requirement the verification
    strategy silently depended on.
    - DEC-FIRMWARE-LANGUAGE: C/C++ on the bare STM32 HAL built with PlatformIO;
    Rust/RTIC and the Arduino framework weighed and rejected. Grounds the choice
    in review-fluency as a safety property (no second reviewer), catastrophe
    contained by the firmware-independent hardware safety chain, and the C++
    espresso-controller ecosystem. Addresses OBL-REALTIME-DIS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
    [REQ-CONTROL-HARDWARE-SEAM-001.C1.req.yaml, REQ-CONTROL-HARDWARE-SEAM-001.C2.req.yaml, REQ-CONTROL-HARDWARE-SEAM-001.C3.req.yaml, REQ-CONTROL-HARDWARE-SEAM-001.req.yaml]
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2026-08-16 feat(graph): add DEL-MAINTENANCE to house remediation of closed work
    Sealing and attestation are one-way, so a defect found in work already
    delivered under a sealed or attested deliverable has nowhere to land:
    the deliverable that owed it admits no further work, and superseding a
    criterion that was correct would misrecord the history as a spec error.
    DEL-MAINTENANCE is that landing place. It carries one criterion per
    confirmed shortfall, each naming the closed criterion whose intent went
    unmet, with the task or sol that closes it wired beneath. It starts
    empty and is sealed only when the graph is.
    Admission is gated on two axes so it does not become a dumping ground:
    the deliverable must b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
2026-08-16 feat(graph): rule the hardware seam at build time and author its first solution leaf [DEL-SIM-SEAMS-HARNESS.C1, .C2, .C3]
    Decomposes DEL-SIM-SEAMS-HARNESS through WF-SLICE (plan
    PLAN-DEL-SIM-SEAMS-HARNESS-001), ratifying one buildable leaf and
    deferring the remaining eight criteria as premise-pending.
    DEC-HARDWARE-SEAM-AT-BUILD-TIME closes an open slot: no decision
    addressed REQ-CONTROL-HARDWARE-SEAM-001, so the seam's substitution
    mechanism was load-bearing but unruled-on. It extends
    DEC-MODEL-STRUCTURE-AT-BUILD-TIME's reasoning to this distinct seam.
    SOL-CONTROL-HARDWARE-SEAM-HOST-SIM is the first solution node in the
    graph, carrying five build-brief criteria.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
    [DEC-HARDWARE-SEAM-AT-BUILD-TIME.req.yaml, SOL-CONTROL-HARDWARE-SEAM-HOST-SIM.C1.req.yaml, SOL-CONTROL-HARDWARE-SEAM-HOST-SIM.C2.req.yaml, SOL-CONTROL-HARDWARE-SEAM-HOST-SIM.C3.req.yaml, SOL-CONTROL-HARDWARE-SEAM-HOST-SIM.C4.req.yaml, SOL-CONTROL-HARDWARE-SEAM-HOST-SIM.C5.req.yaml, SOL-CONTROL-HARDWARE-SEAM-HOST-SIM.req.yaml]
2026-08-16 fix(graph): close blind-review findings on the hardware-seam leaf [DEL-SIM-SEAMS-HARNESS.C1, .C3, .C9]
    Blind review found the sanitizer criterion wired to C1/C2/C3 while it
    restates C9, leaving C9 reading as undecomposed and inflating C1 with an
    assertion it does not make. The solution now derives-from C9 as well.
    The decision's core claim — no indirection in the control path — was
    asserted in prose and required by no criterion, the "assumed, not
    required" pattern. SOL-CONTROL-HARDWARE-SEAM-HOST-SIM.C6 now fails when
    a call through the seam is indirect.
    .C3 compared sources across two builds that compile the same files, so
    it could not fail; it now compares preprocessor output, which c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
    [DEC-HARDWARE-SEAM-AT-BUILD-TIME.req.yaml, SOL-CONTROL-HARDWARE-SEAM-HOST-SIM.C3.req.yaml, SOL-CONTROL-HARDWARE-SEAM-HOST-SIM.C6.req.yaml, SOL-CONTROL-HARDWARE-SEAM-HOST-SIM.req.yaml]
2026-08-16 feat(firmware): deliver the hardware seam and its host-simulated build [SOL-CONTROL-HARDWARE-SEAM-HOST-SIM.C1-.C6]
    Declares the hardware seam as a vendor-neutral C header, satisfies it with a
    simulated implementation and an STM32 HAL-backed one selected by build
    environment, and stands up the host build the tier-one analysis stage consumes.
    The seam's properties are asserted by the build rather than by review: the
    encapsulation check runs inside every PlatformIO build, and the header,
    sanitizer-coverage, direct-call and preprocessor-identity checks run as the
    firmware gate. Each fails rather than passes when it cannot find what it is
    meant to inspect.
    Also records DEC-PREHARDWARE-TARGET-FA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
    [DEC-PREHARDWARE-TARGET-FAMILY.req.yaml, SOL-CONTROL-HARDWARE-SEAM-HOST-SIM.req.yaml]
2026-08-16 fix(firmware): make the encapsulation check fail closed on file kind [SOL-CONTROL-HARDWARE-SEAM-HOST-SIM.C1, .C5]
    The check enumerated .c and .h files while the build filter compiles a whole
    directory, so a C++ or assembly translation unit dropped into src/control was
    compiled into the control objects and never inspected. Both were demonstrated:
    a .cpp including the device header and calling into the HAL, and a .S storing
    to a peripheral address, each building clean in every environment.
    The rule is now the other way round -- every file is inspected unless its
    suffix is one a build never compiles -- so a source kind nobody anticipated
    cannot walk past. Assembly under src/control is itself a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
    [EVD-SOL-CONTROL-HARDWARE-SEAM-HOST-SIM.C1-INSPECTION.req.yaml, EVD-SOL-CONTROL-HARDWARE-SEAM-HOST-SIM.C2-TEST.req.yaml, EVD-SOL-CONTROL-HARDWARE-SEAM-HOST-SIM.C3-DEMONSTRATION.req.yaml, EVD-SOL-CONTROL-HARDWARE-SEAM-HOST-SIM.C4-TEST.req.yaml, EVD-SOL-CONTROL-HARDWARE-SEAM-HOST-SIM.C5-ANALYSIS.req.yaml, EVD-SOL-CONTROL-HARDWARE-SEAM-HOST-SIM.C6-ANALYSIS.req.yaml]
2026-08-16 feat(graph): ratify the plant-structure seam slice and author its solution [DEL-SIM-SEAMS-HARNESS.C4, .C5, .C6]
    Decompose the epic DEL-SIM-SEAMS-HARNESS through WF-SLICE and author the
    ratified leaf, SOL-PLANT-STRUCTURE-SEAM-FIRST-STRUCTURE: the named
    plant-structure interface, plant parameters carried as data, and a build that
    runs only the structure it was built for, with one concrete structure and a
    trivial fixture structure behind it.
    The seam's three requirement criteria are delivered together rather than split.
    REQ-MODEL-STRUCTURE-SEAM-001 states them as one mechanism in its own text, and
    .C3 — a build cannot run a structure other than the one it was built for — has
    nothing to sel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
2026-08-16 feat(firmware): deliver the plant-model seam, one structure behind it, and parameters as data [SOL-PLANT-STRUCTURE-SEAM-FIRST-STRUCTURE.C1-.C9]
    A named plant-model interface is declared once in include/plant_model.h, with
    the vocabulary it is expressed in beside it in include/plant_types.h. No
    signature names a concrete structure: the state and parameter types the
    operations refer to are supplied by whichever structure the build compiles and
    puts on the include path.
    Two structures sit behind it. The thermoblock structure describes the machine's
    architecture with the thinnest equations that express it; the fixture structure
    describes nothing and exists so the exclusivity and two-structure c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
    [fixture.params, thermoblock-nominal.params, thermoblock-variant.params]
2026-08-16 chore(graph): re-observe the plant-seam evidence against the single-precision artefact [SOL-PLANT-STRUCTURE-SEAM-FIRST-STRUCTURE.C1-.C9]
    The nine evidence nodes were observed against the double-precision build. The
    artefact changed materially, so the observation is retaken rather than left
    pointing at a build that no longer exists.
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2026-08-16 fix(graph): close the blind review's findings on the three new criteria [REQ-HARDWARE-HEADROOM-001.C4, REQ-PREENERGISATION-VERIFICATION-001.C5, REQ-STATE-ESTIMATION-001.C5]
    The review found seven problems, the worst of them self-inflicted.
    The cross-tier criterion deferred to "the bound the project declares for it"
    and no such bound exists anywhere in the graph. Avoiding an inlined number that
    way produced an untestable criterion and re-created the assumed-not-required
    pattern the criterion was written to close. It now requires the agreement to be
    declared rather than assumed, so the declaration is part of what is checked.
    That criterion was also on the wrong axis. Its body imported the mu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
    [REQ-HARDWARE-HEADROOM-001.C4.req.yaml, REQ-HARDWARE-HEADROOM-001.req.yaml]
2026-08-16 feat(firmware): verify the plant model across the range it declares, and show each check can fail [OBL-VERIFICATION-DISCIPLINE-001.C8, .C9]
    Every invariant the plant model claimed was asserted at one nominal set of
    coefficients, inside ranges the structure declares admissible for itself. A
    structure can satisfy an invariant there and violate it elsewhere in its own
    declared range, and nothing would have said so.
    Three things were wrong there.
    An instance started at an ambient above the steam saturation temperature came up
    with a steam pressure its own equations would not have produced, so a step taken
    with no actuation moved it. The relation was written twice, once to bring an
    instance up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
2026-08-16 test(firmware): show the support checks failing on the defects they exist to catch [SOL-PLANT-STRUCTURE-SUPPORT-STATUS.C1, .C2, .C3, OBL-VERIFICATION-DISCIPLINE-001.C9]
    The mutation harness catches a check that is correct in isolation and mis-wired
    in the build, which is exactly the risk a newly added check carries. Five
    mutations enrol the two this slice added or rewired: a structure reaching the
    seam with no status, verification claimed with nothing cited, a vocabulary that
    has grown a term for how thoroughly, a README table publishing a status the
    header does not claim, and the support vocabulary header reaching into a
    structure. Each is caught, and each check is confirmed passing before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
2026-08-17 fix(firmware): close the blind review's findings [SOL-PLANT-SEAM-GATE-COVERAGE.C1, .C2, .C4, .C5]
    The review found the artefact side of the analysis gate asserted by no test:
    every case built its environments without an entry point, so the branch that
    inspects an executable for a sanitizer runtime never ran. Removing that branch
    entirely left the suite green. It is now driven with real binaries, one linked
    under the sanitizers and one not.
    Could-not-look is separated from found-the-problem all the way to the exit
    code. An unbuilt artefact and a compilation database that cannot be produced
    now exit 2 rather than 1, so the mutation harness cannot score them as catches
    -- the failure that harn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
2026-08-17 fix(graph): draw readiness on the delivery axis and cover the dial-in journey [REQ-RECIPE-CUSTODY-001.C1-.C6, JRN-DIAL-IN-RECIPE-001.C6, REQ-READINESS-TIMELINESS-001.C6, .C7]
    Blind review found the readiness redraw had invented a third axis rather
    than using the one the graph already had. DEC-NO-REMOTE-ACTUATION records
    that the actuation/observation line was wrong and that the distinction
    carrying the risk is delivery versus readiness; DEF-DELIVERY makes
    anything the machine sends out of itself a delivery. Readiness is now
    defined as performing no delivery, which keeps water free to move inside
    the machine, makes an expelling purge a delivery with everything that
    attaches to one, and leaves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
2026-08-17 chore(repo): declare the project config so semantic search stops degrading
    The project has never had a .staircase/config.yaml. It is not gitignored
    here and it is tracked in the upstream staircase repo, so its absence was
    an omission rather than a convention.
    Without it there is no embedder block, so every `query` — which defaults
    to hybrid — degraded silently to lexical and reported it only in a
    `degraded` field nobody reads. Multi-word queries returned a clean
    total: 0, which is indistinguishable from the term genuinely being absent
    from the graph. That misreads as an answer, and during the dial-in slice
    it did: searches for refill disturbance, for a switching element failing
    closed,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
2026-08-17 fix(graph): let REQ-STARTUP-STATE-001 describe the criterion added beneath it
    The last instance of the pattern this branch fixed twice elsewhere. C6
    turns power-on-proceeds-to-readiness on whether the machine came up by a
    deliberate local act, which is neither establishing a known state nor
    declining to resume interrupted work, and the parent still described only
    those two. It now names the distinction the criterion rests on, which is
    the one the requirement already turned on: power arriving is not evidence
    that a person asked for anything.
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2026-08-17 chore(repo): arm the pre-push guardrail and ignore the index sidecars
    CLAUDE.md has always claimed a pre-push hook blocks direct pushes to main.
    No such hook existed: .git/hooks held only the stock samples, so the rule was
    honour-system in every clone. Hooks committed under .git/hooks cannot travel,
    so the hook lives in a tracked .githooks/ and `task repo:hooks` arms it by
    pointing core.hooksPath there — run by both sc:init and sc:update, the latter
    so clones bootstrapped before today are reached too.
    The hook is a catch for the mistake rather than enforcement: --no-verify
    bypasses it and main carries no server-side rule. CLAUDE.md now says so
    instead of overstating it.
    Also ignores the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
2026-08-17 fix(firmware): close the blind review's findings [SOL-PLANT-DESCRIPTION-BASELINE.C1, .C2, .C3, .C6]
    The reference description's account of the pump pressure claimed a spec sheet
    the local declaration does not cite for that figure, and called the coefficient
    something the statement beside it contradicted; it is recorded as the judgement
    it is. The statement's omissions list did not name the steam relation's largest
    limitation, which is that its slope is local and understates pressure fourfold
    at the temperature the steam thermostat permits -- the regime the machine's open
    pressure question sits in.
    The origins check passed with the reference description exempting itself, so
    long as some othe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
    [thermoblock-variant.params, thermoblock.params]
2026-08-17 fix(firmware): a build-named description must be one this check opened [SOL-PLANT-DESCRIPTION-BASELINE.C2]
    The guard asked whether the description a build is exercised against exists,
    not whether it had been inspected. A description belonging to no structure is
    never parsed, so pointing the build at one passed while the check had never
    opened the file -- the same hole as the exempt one, reached from the other side.
    Reading the build is no longer something a caller can drop in silence either:
    --project or --no-build, one of them said out loud, because the check that runs
    without a build is the weaker one and its arrival should not be quiet.
    The mutation demonstrating the suite's own backsto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
2026-08-17 docs(machine): record the disputed coffee element rating and what depends on it
    The service manual's circuit diagram gives both elements as 1000 W. The
    machine's owner recalls the coffee element as 1200 W and believes the manual
    describes a variant -- which is the case REQ-MACHINE-CONFIGURATION-001.C5 is
    written for, and neither reading has been established on this machine.
    It is recorded rather than resolved, because the manual is the only citable
    source and a recollection is not one. The description keeps the manual's figure
    with the dispute against it; measuring the elements is what settles it, and
    REQ-MACHINE-CONFIGURATION-001.C3 already requires that rather than a document.
    Worth catc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
    [thermoblock.params]
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2026-08-17 test(firmware): close the gaps the enlarged population surfaced [OBL-VERIFICATION-DISCIPLINE-001.C2]
    Separate from the change that enlarged the population, and deliberately so: a
    slice owing both a complete population and a passing sweep has an incentive to
    shape the population until the result passes.
    Eleven survivors, all closed by tests rather than recorded.
    Nine were in the boiler structure, swept here for the first time. Its suite
    asserted properties that hold whatever the coefficients are -- energy is not
    invented, a replay reproduces, the two temperatures do not drift apart -- which
    are the right properties and are indifferent to the arithmetic, so they left it
    unpinned. The vessel'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
2026-08-17 fix(firmware): the narrow structure's mutation names its subject uniquely
    `fw:mutate` reported this one as inconclusive rather than caught: the text it
    edits is `test_build_src = yes` followed by the strict-flags exemption, which is
    what every structure's test environment carries. A third structure's test
    environment made the pair ambiguous, and the harness refuses to edit text it
    cannot locate exactly once -- correctly, since editing either of two places is
    not the mutation described.
    Already the case on main. It arrived with the environments the second structure
    added and stayed quiet because this harness is run on demand, which is the same
    way the sweep's triage record went stale.
    Ancho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
2026-08-17 fix(graph): place the pre-energisation demonstration on the loops that make it [REQ-PREENERGISATION-VERIFICATION-001.C1]
    DEL-SIM-SEAMS-HARNESS targeted REQ-PREENERGISATION-VERIFICATION-001.C1 — "the
    control law is exercised against a plant model before hardware exists" — but
    none of its own fourteen criteria expresses that claim. They are the venue: the
    hardware seam, the plant-structure seam, the reference machine's plant
    description, the host sanitizer tier, and the mutation sweep. A targets link
    with no criterion behind it is the link that is out of step, not the criteria.
    The epic disclaims the law in its own words. Its rationale scopes itself to
    seams, plant description and host ti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
2026-08-18 feat(firmware): declare the assumed model error and what must survive it [SOL-SIM-UNCERTAINTY-BUDGET-DECLARED-MODEL-ERROR.C1, .C2, .C3, .C4, .C5]
    Carries the model error the design assumes in the plant description itself,
    beside the value it qualifies, by the route the origin of a value already
    travels: the artefacts under firmware/params/, the grammar the shared loader
    parses, and a build-time check that refuses a description which omits it. The
    figure is read back through the plant-model seam, so a consumer that is
    deliberately structure-agnostic can ask how wrong a coefficient may be without
    naming the structure it is talking to.
    Separately declares the behaviours the design is not permi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
    [thermoblock.params]
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2026-08-18 feat(firmware): build the machine carrying the verified plant model [SOL-ONBOARD-PLANT-MODEL-IDENTITY.C1-.C8]
    The target environment compiled no plant source at all, so the model the design
    is established against lived only in the host tier that verified it. This puts
    it on the machine.
    env:stm32 gains the shared loader and exactly one structure, selected the way
    every environment selects one. The description travels compiled into the
    artefact, because a target has no filesystem to open one from, and is read back
    through the plant seam's own loader rather than a reader written for the target.
    Four things carry the weight the mechanism cannot, each of them a failure with
    no symptom on the m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
2026-08-18 fix(firmware): read a source-filter term by the path it names [DEL-MAINTENANCE.C3, SOL-FILTER-TERM-PREFIX-READING.C1, .C2]
    Two readers of platformio.ini normalised a filter term with lstrip("./"),
    which removes every leading '.' and '/' rather than the "./" that means "from
    here". A term naming ../plant/thermoblock/ therefore arrived at
    plant/thermoblock -- a directory the build did not name, read as one it did.
    An absolute term and a directory whose name begins with a dot went the same way.
    The consequence lands where the reading is load-bearing. A build compiling
    none of the tree's structures was cleared by check_structure_selection as
    naming exactly one, and handed to the linker, which f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
2026-08-18 fix(firmware): read a filter in one place, and load every gate [DEL-MAINTENANCE.C4, SOL-FILTER-TERM-READ-IN-ONE-PLACE.C1, .C2]
    Two slices merged an hour apart and left a tree that builds nothing. One added
    check_machine_build_settings, which matched filter terms with a pattern of its
    own, normalised them with the lstrip("./") the other was in the middle of
    removing, and imported the term pattern by name. The other removed that name.
    Nothing conflicted -- they touched different files -- so every environment's
    pre-build step now stops on an ImportError.
    Neither slice was wrong about the tree it was written against, which is the
    point: the shortfall is against the stated intent of both and bel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
2026-08-18 fix(graph): settle which brew temperature the machine senses, and admit what it cannot observe [SOL-PLANT-RECONSTRUCTABLE-STATE.C1, .C4, REQ-STATE-ESTIMATION-001.C6]
    C1 had the reported brew temperature following the heated mass, which is
    backwards for a machine whose only brew sensor is in the casting: it would have
    the estimator reconstructing a temperature already being read, and difference a
    prediction of the stream against a reading of the metal. Its parent requirement
    says the opposite in terms -- "sensors sit where they can physically go, which
    is not where the interesting temperatures are" -- so C1 disagreed with what it
    derives from. C4 named the same state and is corrected with it.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
2026-08-18 feat(estimator): reconstruct the brew temperature no sensor reads, and report the residual [SOL-UNMEASURED-STATE-RECONSTRUCTION.C1, .C2, .C3, .C4, .C5, .C6, .C8, .C9, .C10, .C11, .C12, .C13]
    The control law drove from the mass a sensor can be placed on. What the
    extraction happens at is the water leaving that mass, which no sensor on this
    machine reads. The estimator seam stands between the two: it holds a plant-model
    instance, advances it under what was commanded, corrects it toward what the
    machine reports, and answers for the state nothing observes.
    The residual is built here rather than deferred. The correction step computes
    predicted-minus-observed in order to correct at all, so a slic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
2026-08-18 feat(estimator): bound what a reading may be, and advance by the interval that passed [SOL-USABLE-ESTIMATE-EVERY-STEP.C1-.C11]
    The estimator seam could tell whether a reading arrived and had no opinion
    about one that arrived intact and was absurd: a brew thermocouple reporting
    nine hundred degrees was valid by the only definition available and went
    straight into the correction step, dragging the reconstruction toward a
    temperature the machine cannot be at. It had no bound on how long it could run
    without a reading at all, and no agreement with the control law about the
    interval a step represents -- control.c advanced it by CONTROL_STEP_INTERVAL_MS
    however long had actually elapsed, and its o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
2026-08-19 docs(graph): draw the plumbing decision's boundary at topology, not at opening a line [DEC-PLUMBING-LEFT-AS-BUILT]
    The ruling is unchanged — brew water is not routed through the steam side,
    because that serialises brew and steam through one mass and the throughput goal
    wants them concurrent.
    What changes is the reasoning around it. The trade-offs leaned on the project's
    scope being fixed "specifically to keep plumbing out", which does not hold: the
    machine is required to measure pressure in both paths and carries a transducer on
    neither, so tapping lines is work already owed. Read from the title plus that
    sentence, the decision looked like a bar on any fluid work — and it was cited
    that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
2026-08-19 docs(graph): separate steam demand from the feed that answers it [DEL-SIM-STEAM-DRAW-TERM.C1, .C2, .C4, .C6]
    Blind review found the commanded/exogenous split drawn on the wrong axis. The
    original .C2 asserted "the pump is commanded and the wand is not", which is
    faithful to the wand and wrong about the machine: docs/reference-machine.md
    records two pumps, one to each side, and the thermoblock holds no reservoir, so
    the steam pump sets the rate steam can be made. That feed is the only handle by
    which delivered quantity can be reduced while quality is held -- exactly what
    DEL-SIM-STEAM-LOOP.C3 requires -- and the original criterion foreclosed it.
    .C2 now carries the demand alone; a new .C6 ca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
2026-08-20 fix(graph): correct the flow decomposition against blind review [DEL-SIM-FLOW-TERM.C1, .C3, .C4]
    Blind review found the decomposition claimed less than the parent criteria
    demand, and re-read one coefficient into a meaning its own origin contradicts.
    - The outlet coefficient's declared origin is a residence time at shot flow —
    the quantity the drawn-rate term now computes. Re-reading it as the no-draw
    conduction limit asserted a basis the relations had stopped using, and left
    DEL-SIM-FLOW-TERM.C4's explicit demand to correct superseded declarations
    unclaimed. The held volume and the conduction constant are now each declared
    afresh (.C5, new .C13).
    - DEL-SIM-FLOW-TERM.C1 requires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
2026-08-20 docs(graph): decompose the steam draw task into four buildable solutions [DEL-SIM-STEAM-DRAW-TERM.C1-.C6]
    Why: DEL-SIM-STEAM-DRAW-TERM carried six criteria with no covering solutions.
    Ran WF-SLICE to ratify a decomposition plan, then authored the four solutions
    for real (mirroring the water-side SOL-PLANT-FLOW-ENERGY-BALANCE /
    SOL-PLANT-FLOW-REPORTED precedent) so each is a build brief grounded in the
    actual firmware, not a placeholder stub:
    - SOL-PLANT-STEAM-DRAW-CHANNELS: the exogenous steam-demand step input and
    thermoblock's new steam-feed pump channel (boiler/fixture correctly refuse it)
    - SOL-PLANT-STEAM-DRAW-REPORTED: the demand rate as a seam quantity every
    structure answers, de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
2026-08-20 feat(plant): plant step gains a steam-demand input and thermoblock a feed channel [SOL-PLANT-STEAM-DRAW-CHANNELS.C1-C6]
    Adds ACTUATION_CHANNEL_STEAM_PUMP to the shared actuation vocabulary and a
    steam_demand_ml_per_s argument to plant_model_step/plant_model_step_reporting,
    so the plant seam can represent a steam draw the control law never commands.
    thermoblock answers the new channel (the two-pump machine this slice models);
    boiler and fixture refuse it through the existing admissibility mechanism,
    unchanged. Neither value is consumed by any equation yet -- that's
    SOL-PLANT-STEAM-DRAW-ENERGY's and SOL-PLANT-STEAM-DRAW-REPORTED's work.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
2026-08-21 feat(plant): steam mass loses energy to a draw through latent heat, and pressure diverges from temperature while open [SOL-PLANT-STEAM-DRAW-ENERGY.C1-C7]
    Both thermoblock and boiler now charge a latent-heat loss term against
    their steam-side thermal state for whatever is drawn, independent of
    existing ambient/brew-flow losses and read directly from the step's own
    steam-demand argument. Steam pressure gains an integrated deficit below
    the affine saturation relation while a draw is open, resetting to exactly
    zero (bit-exact reversion) the instant demand returns to zero.
    Both new coefficients (water.latent_heat_j_per_ml,
    steam.pressure_fall_bar_per_ml) carry declared origin, error, and
    enforce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
    [boiler-variant.params, boiler.params, thermoblock-variant.params, thermoblock.params]
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2026-08-23 docs(graph): evidence the description slice and seal the steam draw task [SOL-PLANT-STEAM-DRAW-DESCRIBED.C1-.C3, DEL-SIM-STEAM-DRAW-TERM]
    Records inspection evidence for the two prose criteria and test evidence for
    the channel half of C2, then seals DEL-SIM-STEAM-DRAW-TERM, whose cascade this
    slice completes over all four contributing solutions. Delivered with no
    waivers and no contributor in flight.
    The seal rationale records two fidelity limits knowingly rather than silently:
    the steam balance does not charge the block for heating the water replacing
    what was drawn, and the steam feed channel is answered while no relation reads
    it. Neither is a shortfall against a criterion of this task -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
2026-08-23 docs(graph): admit two DEL-MAINTENANCE items for the steam-draw feed [DEL-MAINTENANCE.C1]
    Both correct shortfalls in already-sealed DEL-SIM-STEAM-DRAW-TERM work:
    SOL-PLANT-STEAM-FEED-SENSIBLE-HEAT [REQ-PLANT-DESCRIPTION-001.C1] — the
    steam-side energy balance charges only latent heat for a draw and never
    the sensible heat of raising the replacement feed to saturation, a gap
    the description's own declared omissions already name.
    SOL-PLANT-STEAM-FEED-PUMP-WIRED [REQ-MODEL-STRUCTURE-SEAM-001.C2] —
    ACTUATION_CHANNEL_STEAM_PUMP is declared answered by thermoblock but
    read by no relation, so a draw is honoured at any rate with nothing in
    the arithmetic bounding it.
2026-08-23 fix(plant): charge a steam draw its feed's sensible heat, and bound it by the feed pump [SOL-PLANT-STEAM-FEED-SENSIBLE-HEAT.C1, .C2, SOL-PLANT-STEAM-FEED-PUMP-WIRED.C1, .C2]
    Two defects in the plant model's steam side, kept as separate solutions because
    they fail independently, landed together because they touch the same feed-side
    arithmetic and the same declared omissions.
    The steam-side energy balance charged a draw only the latent heat of turning the
    replacement water to vapour. The water arrives at the feed temperature and has to
    be carried most of a hundred degrees before any of that latent heat is owed, and
    no term debited it -- about an eighth of the whole, and flattering: the steam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
    [thermoblock-variant.params, thermoblock.params]
2026-08-23 feat(control): hold brew temperature to a declared band for a whole extraction [SOL-BREW-TEMPERATURE-TRACKED-AT-GROUP-OUTLET.C1-.C9]
    Replaces the proportional skeleton with a loop that closes on the water
    reaching the group rather than on the mass a sensor reports, feeds the
    commanded flow forward instead of waiting to see the temperature fall, and
    surrenders accumulated intent at the actuator limit rather than after it.
    The band a delivery is held to becomes declared data with a recorded origin,
    read by the control unit rather than compiled into it, and carried into the
    target artefact alongside the description and limits it already carried. The
    law's coefficients account for themselves in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
2026-08-24 fix(graph): require every commandable output to be separately addressable, and correct the target's channel map [REQ-PREENERGISATION-VERIFICATION-001.C6, DEL-MAINTENANCE.C1]
    A defect found while decomposing the brew loop: the target's actuation channel map is one entry short of the channel vocabulary. A table given fewer initialisers than its declared size fills the remainder with zero, and the value denoting the first output is itself zero, so the steam feed pump resolves to the brew heater's output. Bringing the outputs up configures the brew heater's twice and never starts the steam feed pump's; a command addressed to the steam feed pump passes the bounds check, writes the brew heater's d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
2026-08-24 docs(graph): state what interval a sensed reading answers for [SOL-DELIVERY-PROFILE-DEPARTURE-REPORTED.C2]
    The graph has never said what stretch of time a reading at the hardware
    seam covers, so every consumer was free to assume one. The assumption is
    load-bearing for the first time in departure reporting, where getting it
    wrong reports a departure at the start of every delivery and misaligns
    the input/output records the plant model is to be identified from.
    DEC-READING-ANSWERS-FOR-THE-ELAPSED-INTERVAL records the convention the
    estimator already ran on, and applies it to every consumer of a sensed
    channel rather than only the one that prompted it.
    Also corrects SOL-DELIVERY-PROFILE-DEPART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
2026-08-24 test(control): make the span, boundary and per-band guards actually bite [SOL-DELIVERY-PROFILE-DEPARTURE-REPORTED.C1, .C3, .C6, .C7]
    Blind review found three tests that passed regardless of the code.
    The plausible-span test ran a single step, which returns before the span
    comparison is reached, so deleting the limits check left it green. The
    exactly-at-the-band boundary test had been converted to a delivery's first
    step by the interval-alignment change and no longer caught > widening to
    >=. And no test declared a flow band above its own bound, so collapsing
    the two per-band bounds back to one shared constant passed the whole
    suite.
    Each now has a second step or a case that distinguishes th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
2026-08-24 test(control): correct a trace comment left describing the old alignment [SOL-DELIVERY-PROFILE-DEPARTURE-REPORTED.C1]
2026-08-24 docs(graph): supersede the earlier departure slice that mis-stated the comparison [SOL-DELIVERY-PROFILE-DEPARTURE-REPORTED.C1-.C7]
    SOL-DELIVERY-DEPARTURE-REPORTED.C1 specified the flow comparison against
    the same commanded-rate figure driving the pump on that cycle. A reading
    answers for the interval just elapsed, so the figure it must be compared
    against is the one in force during that interval -- the step before. As
    written it prescribes an off-by-one.
    An attested criterion is frozen, so the correction is made the way
    OBL-DELIVERY-CHAIN-IMMUTABILITY-001 prescribes: by superseding the
    deliverable with the one carrying the corrected criterion. The successor
    subsumes all four -- reading the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
2026-08-25 feat(graph): slice the emulation tier and commit its toolchain [DEL-SIM-EMULATION-TIER.C1, .C2, .C3, REQ-PREENERGISATION-VERIFICATION-001.C6]
    Decomposes DEL-SIM-EMULATION-TIER via WF-SLICE into its first buildable
    solution, SOL-EMULATED-BINARY-AND-MODELLED-PERIPHERALS, covering binary
    identity under emulation and full hardware-seam channel coverage. C3/C4
    are correctly left premise-pending — they depend on the peripheral-wiring
    interface this slice has not built yet.
    Also closes a real gap: DEC-SIM-VERIFICATION-TOOLCHAIN deliberately never
    named the emulation tier's tool, and the only precedent in the repo was a
    non-authoritative notes file. DEC-EMULATION-TIER-RENODE records the actual
    ch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
2026-08-25 feat(sim): run the target firmware binary under emulation against modelled peripherals [SOL-EMULATED-BINARY-AND-MODELLED-PERIPHERALS.C1-.C3]
    Stands up a Renode-based emulation tier that loads the literal compiled
    firmware.elf and drives it against register-level PythonPeripheral models of
    ADC1 (sensor channels) and TIM3 (output channels), cross-checked against a
    vendored STM32F407 SVD. Also fixes a real defect the emulation tier's own
    purpose is to catch: hw_output_channel's TIM3 lookup table had only 3
    initialisers for the 4-entry actuation enum, so ACTUATION_CHANNEL_STEAM_PUMP
    silently aliased onto ACTUATION_CHANNEL_BREW_HEATER's compare register via
    zero-initialisation (TIM_CHANNEL_1 == 0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
2026-08-25 feat(maintenance): record the target's unhandled interrupt vector table as a DEL-MAINTENANCE finding [DEL-MAINTENANCE.C1]
    Discovered while building SOL-EMULATED-BINARY-AND-MODELLED-PERIPHERALS: the
    STM32 target build's interrupt vector table has no real handlers wired.
    SysTick_Handler and every other vector resolve to the CMSIS default handler
    (an infinite loop), and HAL_Init already enables the SysTick interrupt, so
    the target binary would hang within ~1ms of boot on real hardware. The
    affected code shipped under the already-finished SOL-CONTROL-HARDWARE-SEAM-HOST-SIM,
    whose criteria never covered target interrupt correctness -- undiscovered
    scope in sealed work, not a promise left unverifi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
2026-08-25 fix(hw/stm32): wire the target build's interrupt vector table to defined handlers [SOL-STM32-INTERRUPT-VECTORS-DEFINED.C1, .C2]
    Every interrupt vector -- SysTick included -- fell through to the vendor
    CMSIS startup file's Default_Handler, an infinite loop with no exit. HAL_Init
    enables the SysTick interrupt, so the tick counter never advanced and every
    HAL timeout the hardware seam relies on was inert.
    SysTick_Handler now calls HAL_IncTick. Every other vector the vendor startup
    file weak-aliases to its own Default_Handler (that symbol is itself strong
    and cannot be redefined, so each alias is overridden individually) traps to
    a shared, observable fault state -- interrupts disabled, a tagged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
2026-08-25 fix(hw-seam): close the actuation channel map against drift and prove the refusal [SOL-TARGET-ACTUATION-CHANNEL-MAP-COMPLETE.C1-.C3]
    hw_stm32.c's actuation-channel-to-timer table and its alternate-function pin
    mask were both declared at the vocabulary's own size, so a channel added to
    the vocabulary and forgotten in either table would pass every length check
    taken over them. The specific defect this shape once produced (a 3-entry
    table backing a 4-channel vocabulary, silently aliasing the steam feed pump
    onto the brew heater) was already fixed incidentally in 5c743d0; this closes
    the criteria that fix did not: both tables are now unsized and carry
    _Static_assert checks (length-matches-vocabu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
2026-08-25 feat(sim): slice the closed-loop bridge between emulated firmware and the plant model [DEL-SIM-EMULATION-TIER.C3]
    Decomposes DEL-SIM-EMULATION-TIER via WF-SLICE into SOL-EMULATED-FIRMWARE-CLOSED-LOOP-WITH-PLANT,
    targeting REQ-PREENERGISATION-VERIFICATION-001.C2/.C5 with four build-brief criteria covering the
    Renode-peripheral-to-plant-model bridge. DEL-SIM-EMULATION-TIER.C4 (cross-tier plant agreement) is
    deferred as premise-pending — its own seam isn't yet decision-pinned or precedented.
    Also corrects DEC-EMULATION-TIER-RENODE's rationale, which claimed the peripheral bridge calls into
    an existing "Python plant model" — the plant model is C (firmware/src/plant/common/plant_step.c);
    onl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
2026-08-26 feat(control): serve a demand following a hot water draw within a declared distance of the same demand from rest [SOL-BREW-RECOVERS-AFTER-DRAW.C1-.C4, .C6, .C7]
    Declares the post-draw match band beside the two bands the delivery
    tolerance already carries, carries the delivery point on the profile and
    asks the plant seam which heated mass stands behind it, and runs a long
    black's worth of hot water through the closed loop before holding the
    extraction that follows to the declared distance from a rested one.
2026-08-26 feat(control): record the evidence and the findings this slice produced [SOL-BREW-RECOVERS-AFTER-DRAW.C1-.C4, .C6, .C7]
    Evidence for all six live criteria, and the amendment to .C6 that its own
    build forced: the volume, the rate and the duration it named cannot all
    hold on a casting that gives up its target above three millilitres a
    second, so the criterion now states the contrast the duration stood for
    and says the second demand follows after a gap whose length is reported
    rather than fixed. The interval this description needs is recorded with
    the evidence rather than left in a test comment.
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2026-08-26 feat(control): a demand contending for the shared heated mass is held and resumed unassisted [SOL-SHARED-MASS-CONTENTION-SERIALISED.C1-.C7]
    Authors and builds the last uncovered criterion of the coffee-side epic:
    contention between the two deliveries this machine serves from one heated
    mass is resolved by holding the contending demand rather than replacing
    what's running, and starting it automatically once the mass frees -- no
    operator action, never a refusal.
    control_command_delivery_reporting now checks the existing two-argument
    mass-sharing seam against whatever delivery is actually running (not the
    group-fixed helper a sibling slice already uses) and holds on contention;
    control_step st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
    [flow_fixture.params]
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2026-08-26 feat(sim): decompose the steam loop into a feed-withhold readiness gate and a measured-pressure control law [DEL-SIM-STEAM-LOOP.C1-.C5, REQ-STEAM-DELIVERY-001.C1-.C5, REQ-PREENERGISATION-VERIFICATION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
    Decomposes DEL-SIM-STEAM-LOOP via WF-SLICE into two solutions and authors
    their real build-brief content in place of the workflow's skeleton drafts:
    - SOL-SIM-STEAM-READINESS-GATE withholds the steam feed pump until measured
    pressure reaches a declared ready threshold, so an early draw is starved
    rather than delivered wet -- the wand is a manual valve with no solenoid
    on the steam path, so this is what "prevented" can mean here.
    -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
2026-08-26 docs(graph): record the native_flow_fixture host-exercise defect in DEL-MAINTENANCE [DEL-MAINTENANCE.C1]
    task fw:run fails on native_flow_fixture with "81 expectation(s) unmet",
    confirmed pre-existing on origin/main and unrelated to any in-flight
    branch. Traced to a state-lookup mismatch in estimator.c: control_init's
    reachability check and the estimator's own per-step correction read back
    different plant_state_t values for the same reconstructed quantity, and
    flow_fixture is the one structure that answers the state the first check
    probes for while refusing the state the second needs -- the mirror image
    of fixture/boiler, which answer the other state alone and are cleanly
    refused at init ins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
2026-08-26 fix(estimator): flow_fixture answers both names of its brew-temperature pairing [SOL-FLOW-FIXTURE-STATE-CORRECTABLE.C1, .C2]
    Why: native_flow_fixture's host exercise failed task fw:run with 81 unmet
    expectations on a clean checkout, reproducible independently of any other
    work. flow_fixture answered PLANT_STATE_BREW_OUTLET_TEMPERATURE_C (what
    control_init's reachability check probes) but refused
    PLANT_STATE_BREW_HEATED_MASS_TEMPERATURE_C (what the estimator's
    correct_against actually corrects for the brew-temperature channel), so the
    structure was admitted at start-up and then had every correction against it
    silently dropped until the loss-tolerance window elapsed and a fault latched
    that ne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
2026-08-26 fix(control): bring the steam side down when one channel's command is refused [SOL-SIM-STEAM-BAND-SUSTAINED.C1, .C5, .C7, .C8]
    Blind review found a correctness bug and a set of tests and rationales that
    did not hold up. Fixed here, with the graph amended where the finding was a
    statement about the design rather than about the code.
    The bug: a step whose heater command was refused returned without touching the
    feed pump, leaving water pushed into a block whose element sits at a level
    nothing established -- the wet start the margin-building sequencing exists to
    prevent, arriving by the one path that bypasses it. control_step brings the
    brew side down in the same situation. It now does the sam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
2026-08-27 fix(control): average the read-ahead term across its lead window instead of sampling it [SOL-COURSE-COMMANDED-DELIVERY-HOLDS-THE-BAND.C1, .C2]
    Why: a course-commanded delivery left the declared brew-temperature band
    twice on a rested machine. The drawn-load feedforward read the course a
    single instant ahead (elapsed + lead): during a rising course this
    over-anticipates a draw the water hasn't caught up to yet (overshoot), and
    past the delivery's own end it hard-collapsed to zero even while the real
    draw was still running (undershoot). Both are now read as the course's mean
    rate across [elapsed, min(elapsed+lead, end)], front-loaded by blending in
    the nearer half-window, which tracks the true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
2026-08-27 feat(estimator): widen admission to prove the correction-target state, not only the reconstruction-target one [SOL-ADMISSION-PROVES-FULL-PAIRING.C1, .C2]
    Why: estimator_init only ever probed the state a reconstruction is named
    after (STATE_FOR_RECONSTRUCTION), never the different state the per-step
    correction actually writes toward (via quantity_measured_by then
    state_observed_by). A structure answering the first and refusing the second
    was admitted and then had every correction silently dropped until the
    reconstruction was withdrawn as "unobserved" -- while readings were arriving
    the whole time. flow_fixture hit exactly this and was fixed in isolation
    (SOL-FLOW-FIXTURE-STATE-CORRECTABLE); t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
    [outlet_only_fixture.params]
2026-08-27 docs(graph): split the closed disturbance investigation from the open recovery-proof gap [SOL-POST-DRAW-DISTURBANCE-PROOF-RESTORED.C1]
    SOL-POST-DRAW-DISTURBANCE-PROOF-RESTORED's criterion asked for the two
    recovery tests to run again -- an outcome the investigation on this branch
    showed is currently unreachable. Re-scoping it to what the investigation
    actually delivered (an exhaustive, evidenced search for a closed-loop-driven
    disturbance scenario, concluding none exists under the corrected control
    law) lets it close honestly, via analysis evidence, instead of sitting open
    against a criterion its own findings rule out.
    The genuinely open question -- what replaces the two TEST_IGNORE'd tests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
2026-08-27 feat(thermoblock): measure brew and steam element power, displacing the manual figures [DEL-BENCH-THERMOBLOCK-ELEMENT-POWER.C1-C4, SOL-THERMOBLOCK-ELEMENT-POWER-MEASURED.C1-C4]
    Cold resistance readings (52.7 ohm brew, 47.0 ohm steam, both at 20.3 degC
    ambient) settle the disputed brew element rating in the manual's favour and
    show the two elements are not equally rated as previously assumed. Carries
    the correction through thermoblock.params' origins, thermoblock.md's account,
    and reference-machine.md's heating/concurrency narrative.
    Widens one pre-existing test's own synthetic excursion-bound margin
    (test_estimator.c) and one mutation-fixture's hardcoded line (mutate.py),
    both exposed by th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
    [thermoblock.params]
2026-08-27 chore(graph): seal DEL-BENCH-THERMOBLOCK-ELEMENT-POWER, attest REQ-MACHINE-CONFIGURATION-001.C5 [DEL-BENCH-THERMOBLOCK-ELEMENT-POWER, REQ-MACHINE-CONFIGURATION-001.C5]
    Task is delivered: all four criteria covered by the single contributing
    solution, no in-flight work. Closing the loop on REQ-MACHINE-CONFIGURATION-001.C5
    surfaced one pre-existing gap outside this slice's own scope -- three
    "Other figures" in reference-machine.md (water tank, espresso pump bar
    rating, steam pump bar rating) carried no provenance at all. Resolved
    rather than deferred: tank volume sourced to the EM7000 spec, coffee pump
    rating labelled as a corroborated-but-uncited nameplate figure, steam pump
    rating labelled no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
    [EVD-REQ-MACHINE-CONFIGURATION-001.C5-ATTEST.req.yaml]
2026-08-27 feat(sim): read which parameters the machine can tell apart out of the dominance sweep's own re-runs [SOL-ESTIMATOR-PARAMETER-IDENTIFIABILITY.C1-C3, DEL-SIM-SENSITIVITY.C3, REQ-STATE-ESTIMATION-001.C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
    The dominance sweep already perturbs every coefficient carrying a declared error
    to both corners and re-runs both closed loops, reducing each re-run to how far
    the delivery moved. This reads the same re-runs at a different place: how far the
    channels the machine can observe moved, and whether a combination of the other
    coefficients' signatures reproduces what one coefficient did to them.
    Flow is added as a fifth observed channel by one additive print path alongside
    the existing outlet-c field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
2026-08-27 feat(sim): let a draw diverge the machine from the controller's belief, and name what drift hides [SOL-ESTIMATOR-IDENTIFIABILITY-UNDER-DRIFT.C1, .C2, .C3]
    The identifiability analysis SOL-ESTIMATOR-PARAMETER-IDENTIFIABILITY built
    perturbs one description handed to both the machine and the control path, so
    it can only ask whether two consistently-built machines could be told apart.
    A machine in service instead drifts away from a description its controller
    still believes -- fouling and ageing move the plant while the estimator's
    model stays put -- and the coupled reading is optimistic about exactly that
    case: a parameter it names identifiable may still be one no amount of running
    a drifting ma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
2026-08-27 feat(sim): slice robustness verification into three buildable solutions [DEL-SIM-ROBUSTNESS-VERIFICATION.C1, .C3, .C4, REQ-ROBUST-CONTROL-001.C1, .C4, .C5]
    Decomposes DEL-SIM-ROBUSTNESS-VERIFICATION via WF-SLICE into three
    solution leaves with real, buildable criteria:
    - SOL-SIM-ROBUSTNESS-STABILITY-ACROSS-DECLARED-ERROR extends the
    existing per-parameter sensitivity sweep with a convergence check at
    each declared-error corner, on both plants — nothing today verifies
    stability itself, only deviation magnitude.
    - SOL-SIM-ROBUSTNESS-ACTUATOR-LIMIT-BEHAVIOUR-DESIGNED closes a real
    gap: the steam loop's conditional-integration mechanism is
    structurally identical to the brew loop's a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
2026-08-27 feat(sim): fold the coupled-error corner into the stability solution [DEL-SIM-ROBUSTNESS-VERIFICATION.C5, REQ-ROBUST-CONTROL-001.C1]
    DEL-SIM-ROBUSTNESS-VERIFICATION.C5 was deferred as premise-pending in
    the prior commit because nothing built declared the shape of the
    error. On rereading its own text closely, that shape is narrower and
    more concrete than the deferral treated it as: two known properties
    the declared-error budget doesn't carry — some coefficients are
    one-sided, and the brew/steam element ratings move together under a
    shared mains supply — not an open-ended correlation question.
    SOL-SIM-ROBUSTNESS-STABILITY-ACROSS-DECLARED-ERROR already builds the
    exact apparatus this needs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
2026-08-28 fix(sim): joint corner compares each side against its own element only [SOL-SIM-ROBUSTNESS-STABILITY-ACROSS-DECLARED-ERROR.C1, .C3, .C4]
    Blind review of d5a10f1 found the joint-corner cross-check matched by
    declared-error fraction against either coupled coefficient regardless of
    side, so the steam side got compared against brew.heater_power_w's own
    corner (which reaches nothing on steam) and the committed record stated
    that this demonstrated a cross-side coupling the description explicitly
    says does not exist. Fixed to compare each side only against its own
    designated element rating, which is incomparable on the steam side (its
    declared error is wider than the joint sag) rather than misleadi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
2026-08-28 feat(control): commanded margin widens against the protection trip point with declared model error [SOL-SIM-ROBUSTNESS-MARGIN-WIDENS-WITH-MODEL-ERROR.C1-C3, DEL-SIM-ROBUSTNESS-VERIFICATION.C2]
    Introduces the commanded margin as a real, computed quantity for the
    first time: the gap between a commanded target and the protection
    trip point, widened by the worst-corner enumeration of each declared
    model-error coefficient's contribution (DEC-MARGIN-COMBINES-DECLARED-
    ERROR-BY-WORST-CASE), wired into both the brew and steam delivery
    paths so it is what the controller actually enforces.
    The protection trip points themselves (107 C coffee, 195 C steam)
    were previously undeclared anywhere machine-re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
2026-08-28 chore(graph): author build brief for the coffee-side authority check's overstated-belief direction [SOL-SIM-ROBUSTNESS-REFUSAL-HOLDS-WHEN-BELIEF-OVERSTATES-CAPABILITY.C1-C4, DEL-SIM-ROBUSTNESS-VERIFI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
    Graph authoring only, no implementation yet — this is the second
    solution WF-SLICE ratified off DEL-SIM-ROBUSTNESS-VERIFICATION's two
    open criteria, kept structurally valid via the engine's contributor-
    binding guard (a solution cannot be deprecated while it sources an
    unresolved edge into an active aggregation criterion, so its own
    criteria had to be authored rather than deferred).
    The solution changes what the coffee-side authority check probes:
    instead of trusting the controller'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
2026-08-28 feat(control): coffee-side authority check refuses against the least-capable plant, not the point belief alone [SOL-SIM-ROBUSTNESS-REFUSAL-HOLDS-WHEN-BELIEF-OVERSTATES-CAPABILITY.C1-C4, REQ-ROBUST-CO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
    The pre-delivery authority check previously probed only the controller's
    point belief when deciding whether a requested delivery exceeds what the
    machine can hold. It now evaluates the least-capable plant the declared
    error budget admits, reusing the worst-corner enumeration built for the
    protection-margin check (DEC-MARGIN-COMBINES-DECLARED-ERROR-BY-WORST-CASE),
    exposed from protection_margin.c/.h as two reusable functions rather than
    duplicated.
    Because the authority probe settle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
2026-08-28 chore(graph): supersede the stale authority-boundary worked example [SOL-SIM-ROBUSTNESS-REFUSAL-HOLDS-WHEN-BELIEF-OVERSTATES-CAPABILITY.C5, SOL-DELIVERY-INFEASIBLE-PROFILE-REFUSED.C4]
    SOL-DELIVERY-INFEASIBLE-PROFILE-REFUSED.C4 was attested and structurally
    frozen, so its stale ~3.0 mL/s worked example and "settled figure" account
    of admission.available couldn't be corrected in place. Added
    SOL-SIM-ROBUSTNESS-REFUSAL-HOLDS-WHEN-BELIEF-OVERSTATES-CAPABILITY.C5,
    restating the same testable predicate (a target the machine cannot hold
    against the profile's peak draw is refused) with the corrected boundary
    (~1.9 mL/s) and figure (worst-corner settled, not point-belief), carrying
    a supersedes link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
2026-08-28 chore(graph): rule that the pump chases the commanded flow and the departure account survives the correction [REQ-DELIVERY-PROFILE-001.C4, PER-OPERATOR-001.C1, DEL-MAINTENANCE.C1]
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2026-08-29 feat(control): trim the pump closed-loop toward the commanded flow, keep the departure account [SOL-PUMP-TRIMMED-TO-COMMANDED-FLOW.C1-C4, REQ-DELIVERY-PROFILE-001.C4]
    The commanded pump level gains a closed-loop trim driven by the gap between
    the profile's commanded rate and the flow seam's measured rate, with gains
    loaded from a new pump_trim.declaration file (mirroring the existing
    steam-control declaration pattern) rather than compiled in. The departure
    account survives the correction: it now also carries the actually-driven
    pump level and whether the trim was pinned at the pump's own bound with the
    rate still short, distinguishing a corrected delivery from an uncorrected
    one and an ordin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
2026-08-29 chore(graph): record a pre-existing test-underflow defect found mid-build [DEL-MAINTENANCE.C1, REQ-SEQUENCE-CONSISTENCY-001.C2]
    test_reading_ahead_stops_at_the_end_condition computes its sample point as an
    unsigned subtraction that underflows against the shipped description's actual
    lead, producing a ~430M-iteration loop that still terminates and still asserts
    correctly but costs minutes instead of milliseconds. Confirmed reproducible on
    unmodified origin/main, unrelated to the pump-trim work that surfaced it. Not
    fixed here -- filed as a DEL-MAINTENANCE item per this repo's discipline for
    already-sealed work that fell short, rather than left to PR prose.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
2026-08-29 chore(graph): decompose flow instrumentation into wiring and pump-margin solutions [DEL-BENCH-FLOW-INSTRUMENTATION.C1, .C5, .C6, DEC-FLOW-SENSED-UPSTREAM-OF-PUMP]
    Corrects the flow meter's position from "never established" to a confirmed
    fact (factory-fitted on the coffee pump's own suction line, per owner
    account) in DEC-FLOW-SENSED-UPSTREAM-OF-PUMP and DEL-BENCH-FLOW-INSTRUMENTATION,
    propagating the correction into their own criteria (C1, C5, C6) rather than
    leaving them stale.
    Ratifies two solutions via WF-SLICE against DEL-BENCH-FLOW-INSTRUMENTATION:
    - SOL-FLOW-METER-READING-AT-CONTROLLER: wires the fitted meter to a bench
    sensing board and decodes its signal into the machine's flow c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
    [SOL-FLOW-METER-READING-AT-CONTROLLER.C1.req.yaml, SOL-FLOW-METER-READING-AT-CONTROLLER.C2.req.yaml, SOL-FLOW-METER-READING-AT-CONTROLLER.C3.req.yaml, SOL-FLOW-METER-READING-AT-CONTROLLER.C4.req.yaml, SOL-FLOW-METER-READING-AT-CONTROLLER.req.yaml]
2026-08-29 chore(graph): correct margin-combination logic, channel scope, and sourcing obligation flagged by blind review [REQ-ROBUST-CONTROL-001.C3, REQ-MEASUREMENT-001.C4, REQ-MACHINE-CONFIGURATION-001.C5]
    Blind review of the prior commit surfaced five real issues in
    SOL-SIM-ROBUSTNESS-MARGIN-WIDENS-WITH-SENSING-ERROR: the worst-case-max
    combination it reused from DEC-MARGIN-COMBINES-DECLARED-ERROR-BY-WORST-CASE
    made the criterion unsatisfiable exactly in the case REQ-ROBUST-CONTROL-001's
    own rationale calls ordinary (model error larger than sensing error), which
    defeats REQ-MEASUREMENT-001.C4's requirement that sensing error be carried
    explicitly; the solution wrongly scoped itself to "one channel"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
2026-08-29 test(control): recovery tests verify carried-forward state and no-second-law directly, not via unreachable band violation [SOL-POST-DRAW-RECOVERY-PROOF-STILL-OWED.C1, SOL-BREW-RECOVERS-AFTER-DRAW.C3,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
    Why: an exhaustive prior search (SOL-POST-DRAW-DISTURBANCE-PROOF-RESTORED) found no
    admitted closed-loop-driven scenario disturbs the casting enough to exit the brew band
    anymore, so the two recovery tests' original end-to-end temperature-band-violation
    precondition could never fire and both stood TEST_IGNORE'd. Chosen fix: verify the
    mechanisms directly (estimator continuity across a delivery-command boundary; the same
    extraction-matches-rest comparison against a reachable, real, sour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
2026-08-29 fix(test): stop the read-ahead end-condition test's sample point underflowing [SOL-READ-AHEAD-END-TEST-STILL-NEEDS-SAFE-SAMPLE.C1, REQ-SEQUENCE-CONSISTENCY-001.C2]
    sample_at was computed as ENDS[0] - (lead/2u), an unsigned subtraction that
    underflows once the shipped lead exceeds 2*ENDS[0] (it now sits at 3000ms
    against ENDS[0]=1000ms). The loop that follows still terminates via
    wraparound but only after several hundred million iterations, costing
    minutes of wall time in what should be a sub-second test.
    Derive sample_at from ENDS[0] alone so the subtraction that used to
    underflow no longer exists, and assert the actual precondition the test
    needs (lead > ENDS[0] - sample_at) so a future le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
2026-08-29 feat(control): commanded margin widens by declared sensing error on top of the model-error margin, on both loops [SOL-SIM-ROBUSTNESS-MARGIN-WIDENS-WITH-SENSING-ERROR.C1, .C2, .C3, REQ-MEASUREMENT-001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
    Adds a per-loop declared sensing-error figure (CONTROL_SENSING_ERROR_C,
    STEAM_CONTROL_SENSING_ERROR_C) that protection_margin_widened() adds on top of
    the existing worst-case model-error corner, per
    DEC-SENSING-ERROR-ADDS-TO-COMMANDED-MARGIN. No temperature-sensing part is
    specified anywhere in this design yet, so both figures are declared @estimated
    in params/control.declaration at a plausible NTC-class accuracy rather than
    read off a datasheet -- honestly marked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
2026-08-29 fix(emulation): finest converter subcase compares the converter's own reading, not the full trajectory [SOL-CROSS-TIER-CONVERTER-MARGIN-RECURS.C1]
    The "few-counts" subcase of test_the_reading_the_converter_reports_changes_what_the_draw_does
    compared a full plant trajectory integrated over a course of per-interval elapsed
    times replayed from a captured emulated-tier (Renode) run. Unrelated tree growth
    shifting Renode's own per-step execution time shifts that replayed jitter, which
    has now twice absorbed a small converter perturbation before it survived 30-odd
    seconds of thermal integration into a detectable difference (margin 1->5, then 5
    recurring).
    Rather than widen the margin again -- the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
2026-08-29 feat(docs): state each controller channel's accuracy, resolution and update rate against its declared basis [DEL-COMPONENT-SPECIFICATION.C2, REQ-MEASUREMENT-001.C1, .C2, .C6]
    Extends docs/controller-io.md's channel enumeration with three columns
    naming what the control needs of each row, sourced only from figures
    already declared in tolerance.declaration, control.declaration,
    cadence.declaration and steam_control.declaration -- never invented,
    never costed. The two block temperature rows take their accuracy from
    the same sensing error their commanded margin is already widened by;
    the wand disc explicitly does not borrow it. Cells with no admissible
    source say so rather than carrying a plausi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
2026-08-30 fix(docs): correct the machine declaration against the actual service manual [OBL-PHYSICAL-CONFIGURATION-001.C1]
    reference-machine.md and controller-io.md carried several "not recorded"
    claims that the Sunbeam EM7000 service manual (parts list + circuit
    diagram) actually settles, and never enumerated two real channels at all.
    Corrected: the three temperature sensors are NTC-type (parts list names
    them directly); both solenoid valve coils are mains-AC, switched through
    relay contacts, not low-voltage DC; the two gauges are driven by a
    dedicated on-board stepper driver IC, not a separate serial-linked board.
    Added: a mains zero-cross detection channel (PC817 optocoupler into an
    MCU interrupt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
2026-08-30 fix(estimator): admission proves the correction-target state can be written, not only read [SOL-ADMISSION-PROVES-CORRECTION-WRITABLE.C1, .C2, .C3]
    The per-step correction reads the correction-target state, subtracts its
    share of the disagreement and writes the result back. Admission proved
    that state readable and never proved it writable, so a structure
    answering the read and refusing the write passed admission cleanly and
    then had every correction against it dropped by the write's own refusal
    -- the same externally observable failure the read probe exists to
    catch, one call further down the same path.
    Admission now writes back the value it just read. A sixth structure,
    correction_read_only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
    [correction_read_only_fixture.params]
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2026-08-31 fix(configuration): fold the driver datasheet and a corrected observation into the wiring record [OBL-PHYSICAL-CONFIGURATION-001.C1, .C4, DEL-COMPONENT-SPECIFICATION.C1, DEL-MAINTENANCE.C1]
    Two pieces of evidence arrived after the record was written, and both bear on claims it makes.
    The VID6608 datasheet is now held, so the gauge driver's interface is read rather than inferred from
    pin naming. The figure that matters to board selection is the input threshold: Vih is a minimum of
    3.15 V and Vil a maximum of 1.35 V, both absolute across the part's 4.5-5.5 V supply range rather
    than scaling with it. The datasheet also says in prose that its inputs carry level shifters so the
    part may run at a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
    [control-board-electrical-requirements.csv, controller-io-bom.csv]
2026-08-31 fix(configuration): trace the gauge driver by opening the machine, and reconcile the manual's swapped IC designators [OBL-PHYSICAL-CONFIGURATION-001.C1, .C4, DEL-MAINTENANCE.C1]
    The machine was opened. Two things came out of it, and one of them reaches the graph.
    The VID66-08 stepper driver and its decoupling capacitor were read off the gauge assembly directly.
    That claim had been carried as an inference from the parts' absence in photographs of the main-board
    spare, and it was both the weakest claim in the wiring record and the premise several stronger ones
    stood on: whether the gauge channel costs a replacement six logic pins or eight phase-drive lines
    plus a driver in the parts list turn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
    [control-board-electrical-requirements.csv, controller-io-bom.csv]
2026-08-31 feat(graph): require the machine's record to exist, gather it into a folder named for the machine, and evidence the work that made it [REQ-MACHINE-RECORD-001.C1-.C6, DEL-MAINTENANCE.C1]
    The record of this machine was being relied on before anything required it. Documents describing the
    one machine this design was built against sat in the documentation directory beside analyses generated
    from the emulation that hold for any machine of this shape, with nothing but the reading to tell them
    apart. Meanwhile DEC-OPERATOR-INTERFACE-REPRODUCED had begun obliging a replacement controller to
    reproduce the operator interface as the record describes it -- a reference into material that nothing
    required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
    [DEC-MACHINE-RECORD-FOLDER-PER-MACHINE.req.yaml, EVD-REQ-MACHINE-CONFIGURATION-001.C5-ATTEST.req.yaml, EVD-SOL-CONTROLLER-AND-MAINS-PARTS-DOWN-SELECT.C1-ANALYSIS-REVISED.req.yaml, EVD-SOL-CONTROLLER-AND-MAINS-PARTS-DOWN-SELECT.C1-ANALYSIS.req.yaml, EVD-SOL-CONTROLLER-AND-MAINS-PARTS-DOWN-SELECT.C2-INSPECTION.req.yaml, EVD-SOL-CONTROLLER-AND-MAINS-PARTS-DOWN-SELECT.C3-INSPECTION.req.yaml, EVD-SOL-C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]
2026-08-31 fix(mutation): re-judge every stale and unreviewed sweep survivor [SOL-SWEEP-JUDGEMENTS-REMADE.C1]
    The sweep's judgement record went stale when the commanded-margin work
    (24c8b39) appended plant_parameter_scale/position/supply_driven to
    plant_parameters.c and gave each structure its own
    plant_structure_supply_driven_parameters accessor. That moved the
    thermoblock's and boiler's already-judged steam-pressure comparisons
    to new lines and produced new mutants of its own.
    Re-keys the two moved judgements at their new coordinates with their
    original reasoning unchanged (the expressions did not move relative
    to anything they depend on). Judges the three new compiled-in
    spec-table size guards equi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
2026-09-03 docs(controller): record the in-flight controller and mains-parts selection
    ## Why
    The selection reasoning existed only in a conversation and in session-scoped
    temp files, which is the failure mode CLAUDE.md warns about: it disappears when
    the branch does. These are committed so it survives.
    They carry **no criterion trace on purpose**. This is mid-flight solution work,
    and the graph has no way today to hold a solution in a pre-flight state waiting
    on an operator to physically build it. Inventing a trace to satisfy the commit
    convention would be a worse lie than having none.
    ## What is in here
    - `control-system-bom.csv` — parts with L/W/H, area, rail, current, cost, location
    - `part-nu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
    [control-system-bom.csv, module-interconnect.csv, part-numbers.csv, robin-nano-v3.1-pin-allocation.csv]
2026-10-12 docs(controller): consolidate the replacement-controller design into controller-design/
    Adds docs/sunbeam-em7000/controller-design/ as a new, consolidated record of the
    hardware design for replacing the EM7000's control system: a state-of-play
    README, a decisions and facts log, a holistic system design, tank-to-outlet
    hydraulic chains with provenance, ranked open items and a PCB plan, plus
    refreshed sensing, heater, mains, controller-I/O and component-specification
    documents, the current BOM, pin allocation and interconnect data, and per-file
    carry-forward logs from two blind reviews and a verification pass.
    Also updates the in-flight working files and the as-found record: owner
    statements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
2026-10-12 feat(graph): controller hardware epic with its fit, proof-before-order and interlock basis [DEL-CONTROLLER-HARDWARE.C1-.C9, REQ-RETROFIT-FIT-001.C1, .C2, REQ-HARDWARE-PROVEN-BEFORE-MADE-001.C1, .C2]
    No node owned the replacement controller hardware. This adds the epic under
    DEL-BREW-STATE-DELIVERY.C4 that designs, proves, builds and brings up the
    boards, the two requirements it surfaced (drop into the machine as found;
    proven before it is paid for), and the decision to build the proof-of-life
    interlock into the first hardware. Reasoning is in discussion session
    93DF4C50-C8BE-40D9-82BE-9E17E063C7E8.
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2026-10-12 feat(graph): slice the design-constraints task into its solutions [DEL-HW-DESIGN-CONSTRAINTS.C1-.C5]
    WF-SLICE run crun-c547fd321637e8fa decomposed DEL-HW-DESIGN-CONSTRAINTS
    into five solutions: the machine-as-found fit record, the requirement
    figures with sources, the manufacturer's dated bounds, the replaced
    modules' properties carried forward, and justified early purchases.
    The materializer wrote these files to specs/deliverables and
    specs/requirements; they are moved, unchanged, to specs/solutions where
    every other solution lives.
2026-10-12 fix(graph): make the constraints solutions fix real constraints, tighten bring-up and partition [DEL-HW-DESIGN-CONSTRAINTS.C1-.C5, DEL-HW-BRING-UP.C2-.C4, .C9]
    A final blind review found the sliced solutions could close with every
    fact marked pending. Facts the floorplan depends on now have to be
    established by inspecting the machine; the tank-level sensor's mounting
    and each live feed's source are traced; what retained devices impose on
    their drivers is recorded; evidence uses the record's own status
    vocabulary, with published photographs graded published unverified; and
    each record names its home.
    Bring-up now covers a loose cable and supply ramp in the held-off cases,
    connects mains only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
2026-10-12 build(staircase): pin STAIRCASE_REF and install skills instead of tracking them [REQ-PUBLISHED-BUILD-PATH-001.C2]
    The upstream skills were tracked copies of whatever main held when
    someone last ran sc:sync-skills, while the binary was installed from an
    unpinned main — two things that could drift apart and showed up as noisy
    diffs on unrelated branches.
    STAIRCASE_REF is now one upstream commit, so the binary, the skills and
    the seeded schema come from the same revision. The sync and schema seed
    fetch by commit (clone --branch cannot take a SHA). The skills are
    ignored and installed by sc:init / sc:update; the sync replaces only
    what its manifest says it installed, checks the upstream set b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
2026-10-12 feat(graph): slice the design method and the rule-check gate; hold bring-up behind partition [DEL-HW-DESIGN-METHOD.C1-.C8, DEL-HW-DESIGN-VERIFICATION.C3-.C5]
    WF-SLICE runs crun-b566e59a638735df and crun-b30cc05e18c8a9a1 decomposed
    the design-method task into four solutions (rules and locked critical
    routing; rendered layout review feeding the rules; pre-layout proof and
    design for bring-up; a followable, machine-free method entered through a
    repo-* operator skill) and the verification task into the rule-check
    gate. The gate's connectivity and parts checks are sliced once the
    partition fixes the pin allocation and specification they compare
    against; the task's rationale records why, and the d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
2026-10-12 chore(skills): own start-work under its upstream name and use upstream stage0-build
    stage0-build is upstream's temporary patch over known workflow gaps and
    retires there as they are fixed; once this repository declares
    check:round, check:daily and daily:status it works here as shipped, so
    the coffee copy is removed. Its project-specific part, how this project
    verifies, moves into CLAUDE.md, which stage0's implementers already read.
    start-work's targets are this project's, so this repository owns it under
    the upstream name: the Taskfile's REPO_SKILLS makes sc:sync-skills neither
    install nor remove it, and .gitignore tracks it. It reads daily:status
    first once that task exists.
    Co-Authored-B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
2026-10-12 docs(graph): settle the inlet chain margin and the supply facts the figures record cites [SOL-HW-REQUIREMENT-FIGURES-SOURCED.C1, .C3]
    Records DEC-INLET-CHAIN-RATED-ABOVE-ITS-FUSE (15 A filter, >=1.5 mm2 trunk,
    T10A kept, one shared TR5 fuse on the valve branches) and propagates it through
    the controller design working docs. Corrects the solution brief: supply facts
    are cited from the machine's declared configuration, amended to 216-253 V,
    a 10 A circuit (owner statement) and an up-to-20 A breaker (project
    assumption); C1's grade vocabulary gains project assumption.
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2026-10-12 feat(machine-record): record the controller boards' requirement-derived figures and amend the supply declaration [SOL-HW-REQUIREMENT-FIGURES-SOURCED.C1, .C2, .C3]
    Adds controller-board-design-constraints.md with its requirement-derived
    figures: supply, supply budget at 253 V against the 10 A circuit, fault
    current per conductor with the device that interrupts it, the derived
    proof-of-life removal interval (1.1 s, coffee block), load currents, rail
    budgets, sensing accuracy, separation-basis inputs and output failure
    states, each graded and sourced, with every unsettled input marked pending
    against the node that settles it.
    Amends reference-machine.md § Supply at source: span 216-253 V, 10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
2026-10-12 docs(machine-record): budget at the span top, grade every entry, re-point pending marks and the steam start [SOL-HW-REQUIREMENT-FIGURES-SOURCED.C1, .C2, .C3]
    Restate every 230/240 V draw called the worst case, or budgeted against
    the 10 A circuit, at 253 V, the declared span's top, across the machine
    record and its working design folder. Grade the wiring authority and the
    coffee pump rating at source and in the figures record, and grade the
    project-assumption fault current on every conductor row. Re-point the
    pending marks a chosen part or circuit fixes at the per-board design
    tasks DEL-HW-PARTITION-AND-FEASIBILITY.C5 creates. Start the steam side
    of the proof-of-life derivation from the dra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
2026-10-12 docs(machine-record): carry the proof-of-life interval as pending against the casting peak [SOL-HW-REQUIREMENT-FIGURES-SOURCED.C1, .C2, .C3]
    Review crun-f1e1682be4761c62: the commanded temperatures do not bound the
    casting, so the interval is pending against SOL-CASTING-PEAK-UNDER-CONTROL-
    DERIVED, in the figures and pending-marks tables. The 1.1 s / 8.9 s arithmetic
    stays, labelled as figures from the commanded temperature that the casting's
    peak replaces and stated as upper limits, not the interval; the claim that
    every simplification errs toward acting early is corrected. Also: shortfall
    at least 0.46 A, the load-currents section cites its source's values, the
    clearing-time mark no longer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
2026-10-12 docs(graph): make the work pending marks name record their figures, and state the heater branches are protected by the inlet fuse [SOL-HW-REQUIREMENT-FIGURES-SOURCED.C2]
    Blind review: DEL-HW-PARTITION-AND-FEASIBILITY.C1/.C5 now record each figure
    the constraints record holds pending against them; DEC-INLET-CHAIN-RATED-
    ABOVE-ITS-FUSE no longer says every load branch has its own fuse.
2026-10-13 docs(machine-record): fix blind review 1 classes in the figures record and its restatements [SOL-HW-REQUIREMENT-FIGURES-SOURCED.C1, .C2, .C3]
    - Pending marks now say what the named work records, matching the
    amended DEL-HW-PARTITION-AND-FEASIBILITY.C1 and .C5; the isolation
    rating names the sources that disagree.
    - Heater branches are rated for the 10 A inlet fuse, not the element's
    draw (DEC-INLET-CHAIN-RATED-ABOVE-ITS-FUSE): record, wiring CSV,
    inlet doc, BOM fuse row.
    - The T10A no longer claims to cover the 8-15 A band; it carries about
    15 A for half an hour or more.
    - Mains frequency is the supply's nominal from its grid standard (owner
    statement 2026-10-13, published unveri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
2026-10-13 docs(machine-record): apply the final blind review [SOL-HW-REQUIREMENT-FIGURES-SOURCED.C1, .C2]
    Removes an unsourced coil-current figure; restates the cord, inlet and filter
    row as fault withstand until the breaker clears and opens an owner item on
    that basis; bumps DEC-MAINS-PHASED-ACTUATION-BELOW-SEAM for its rewired
    address and rationale; corrects a cited column name.
2026-10-13 feat(graph): settle the separation-basis record and mains-declaration contract before building the board gate [SOL-HW-BOARD-RULE-CHECK-GATE.C3, .C5]
    DEC-BOARD-SEPARATION-BASIS-RECORD fixes where board artefacts live, the
    basis record's form and what makes it signed, and how a board declares
    its mains nets. The gate's brief and the board-rules method now state it.
2026-10-13 fix(graph): close the empty-Mains-class and malformed-record gaps in the board gate brief [SOL-HW-BOARD-RULE-CHECK-GATE.C3, .C5]
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2026-10-13 fix(graph): fix the basis record keys, the Mains separation rule form and the ignored-severity rule for the board gate [SOL-HW-BOARD-RULE-CHECK-GATE.C2, .C3, .C5]
2026-10-13 fix(graph): enforce the signed separation figure as the highest-precedence rule instead of parsing rule precedence [SOL-HW-BOARD-RULE-CHECK-GATE.C2, .C3, .C5]
2026-10-13 fix(graph): run one layout check on the copy with the signed rule last, and tie every stated guard to a seeded fault [SOL-HW-BOARD-RULE-CHECK-GATE.C1, .C2, .C3, .C5, .C6]
2026-10-13 fix(graph): state the separation and discovery guards as outcomes so no setting or stray board file escapes them [SOL-HW-BOARD-RULE-CHECK-GATE.C1, .C2, .C3, .C5]
2026-10-13 feat(hardware): pre-order rule-check gate for every board design, proven on a throwaway design [SOL-HW-BOARD-RULE-CHECK-GATE.C1, .C2, .C3, .C4, .C5, .C6]
    task hw:verify finds every KiCad project git tracks and runs KiCad's own
    ERC, and its DRC once on a temporary copy with schematic parity and zones
    refilled. The signed separation-basis figures are appended as the last
    custom rule. Ignored checks, exclusions, custom-rule severities that hide
    findings, and a rules file KiCad silently declines to load all fail.
    KiCad 10 ranks pad and footprint clearance overrides above custom rules,
    so an override below the signed figure fails outright. Each violation is
    one VIOLATION | design | rule | locatio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
2026-10-13 fix(hardware): the board gate reads only what git holds, its own rules cannot be forged, and a rejected rule is named [SOL-HW-BOARD-RULE-CHECK-GATE.C1, .C2, .C3, .C5, .C6]
    The check trusted things a design can write. It recognised its marker and
    Mains probe in KiCad's report by fixed names a design rule could reuse, and it
    read Mains-class membership from copper alone. It also read the working tree
    rather than what git holds. It now:
    - names the rules it recognises afresh for every run, and fails any design
    rule whose name contains the reserved words;
    - reads Mains membership from the layout's copper, KiCad's own schematic
    netlist and the project file's assignments by name, and matches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
2026-10-13 fix(hardware): Mains membership must agree across layout, schematic and project file, and a design is checked with every library and sheet it reaches [SOL-HW-BOARD-RULE-CHECK-GATE.C1, .C3, .C4, .C5, 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
    The check took the union of three Mains-membership sources and passed MAINS=present on any of them, so a design whose mains nets were in Mains only in the schematic passed while the layout's separation rule applied to nothing. Each source is now read as KiCad resolves it -- the layout by the probe on the design, the schematic by KiCad's netlist, the project file's net settings by KiCad on a board of one track per net name -- and every net must be in all three or none; MAINS is then judged ag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
2026-10-13 fix(hardware): the board gate takes KiCad's answer where KiCad has one and reads every other file in one strict form [SOL-HW-BOARD-RULE-CHECK-GATE.C1, .C2, .C3, .C4, .C5, .C6]
    KiCad is now run under a configuration the check makes per run, holding only
    KiCad's installed libraries and no KICAD variable from the caller, so a
    library only one machine's tables supply is reported by KiCad and named as
    the design's. Where the check reads a file itself it accepts one form and
    fails any other by name: a rule holding two conditions or severities, two
    rules of one name, a Mains rule not written exactly or holding a constraint
    or unit the check does not read, a project file with a key twice or a
    settin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
2026-10-13 fix(sweep): refuse any shard timing a shard does not write, and report timing on every exit [SOL-SWEEP-TIME-ACCOUNTED.C1]
    A shard row is now checked against the one shape a shard writes: exactly its
    four fields, a shard's identity, exactly the three phases, finite non-negative
    figures and a whole-number count, and no listing row. The record itself refuses
    a unit already timed, on every path, so no report can be totalled twice.
    Each path reports its completed units on the way out of one block rather than
    at each of its exits, so an error nothing anticipated still prints the timing
    ahead of itself and leaves the outcome untouched.
2026-10-13 fix(graph): fold the board check into the cadence decision, keep its proof on demand, and trigger the round on everything a design reads [SOL-HW-GATE-IN-ROUND-AND-NIGHTLY.C1-.C3, DEL-HW-DESIGN-VERIFI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
    Blind review: the new solution contradicted DEC-VERIFICATION-ROUND-TARGETED-NIGHTLY-FULL
    (round tiers; seeded faults on demand) and its round trigger missed the basis
    record and libraries a design reads outside hardware/.
2026-10-13 chore(graph): elevate the board gate's evidence, with the demonstration inline and C2's known shortfall stated [SOL-HW-BOARD-RULE-CHECK-GATE.C1-.C6]
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2026-10-13 docs(graph): close the routing check against added tracks, require the router to be obtainable, and close the board around the round trip [SOL-BOARD-RULES-AND-LOCKED-CRITICAL-ROUTING.C2]
    Blind-review fixes. C2 now names the compared properties, also fails on a critical-class track or via the router added, and requires the method to say where a reader gets the external router and its runtime (the solution now targets REQ-PUBLISHED-BUILD-PATH-001.C2). The solution text drops the build order no edge enforces, softens the trial claim to what is shown, and closes the board in Konnect's editor around the out-of-editor export and import. The sibling locus edits in the previous commit only name the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
2026-10-13 fix(sweep): keep the timing from changing any run's outcome, and mark a cut-short table partial [SOL-SWEEP-TIME-ACCOUNTED.C1]
    The refusal of a repeated unit moves out of the timing record, which every
    path uses, into the merge's reading of shard reports: a suite an environment
    lists twice is run, timed and judged twice as before, rather than turned into
    a run the sweep could not look at. A shard report's timing is its one unit's
    row, so a report carrying any other number is refused by its shape. A table
    printed on the way out of an error is titled and noted as partial on every
    path, and the merge reads its triage record after the table is whole.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
2026-10-13 fix(graph): settle the module-properties brief on a design that was never bought [SOL-HW-MODULE-PROPERTIES-CARRIED-FORWARD.C1, .C2]
    The earlier design's modules were never bought, so no bench measurement on a
    sample is possible. C2 now ends pending marks on the partition choice of form or
    the board design task, and drops the purchase clause. It adds a set-aside outcome
    for properties no requirement needs or that must not be inherited, and requires
    each constraint to name its source. C1 covers absent properties, records the
    owner statement, and dates datasheet reads.
2026-10-13 docs(graph): fix the separation rule to the gate's form and close the default-class and duplicate gaps [SOL-BOARD-RULES-AND-LOCKED-CRITICAL-ROUTING.C1-.C3]
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2026-10-13 fix(graph): state the measured zone precedence and the record-nets guard [SOL-BOARD-RULES-AND-LOCKED-CRITICAL-ROUTING.C1, .C3]
2026-10-13 fix(graph): require recording to refuse an unlocked critical item [SOL-BOARD-RULES-AND-LOCKED-CRITICAL-ROUTING.C3]
2026-10-13 fix(hardware): hold comparison to the record's nets and classes, and tie a record to one board and its own project [SOL-BOARD-RULES-AND-LOCKED-CRITICAL-ROUTING.C1-.C3]
    Comparing now treats as critical every net the record names as well as every
    net the critical classes hold then, and fails a recorded class the design no
    longer defines, so a project file rewritten or replaced between recording and
    comparing cannot hide added copper. Both commands take only the board's own
    project file, and comparing fails another board's record. Reading a record
    checks every field recording writes. Recording refuses a path inside any
    folder holding a project file and writes the record whole or not at all. A
    r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
2026-10-13 feat(round-gate): sweep the mutants on the plant lines a branch changes [SOL-SWEEP-CHANGED-PLANT-LINES-IN-ROUND.C1]
    The round gate measures the lines the branch changes from the same merge-base
    it selects the emulation tier by, and after the host and emulation tiers hands
    them to fw:sweep, whose new restricted mode keeps those in the population it
    derives, builds only the changed files, judges the mutants on changed lines
    against the triage record, and checks every judgement about a changed file
    against that file's current mutants. No population line changed: no sweep and
    no toolchain. Unmeasurable change: the round fails after the tiers. The sweep
    writes back the outcome it reached, so the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
2026-10-13 fix(graph): give the agent its own lock and readback route, and hold the guard to what the tooling can read [SOL-BOARD-RULES-AND-LOCKED-CRITICAL-ROUTING.C1-.C3]
    The board is designed by an agent with no person at the editor, so locking
    and readback move to the board tooling and KiCad's own checks. The tooling
    refuses what it can read (Mains left out on a mains board, an empty class);
    which other nets are critical stays the board's own judgement.
2026-10-13 fix(graph): align the routing solution's text with the agent lock and readback route [SOL-BOARD-RULES-AND-LOCKED-CRITICAL-ROUTING.C1-.C3]
2026-10-13 fix(graph): confirm rules by an agent-run check of what KiCad loads, narrowed to what it shows [SOL-BOARD-RULES-AND-LOCKED-CRITICAL-ROUTING.C1, .C3]
2026-10-13 fix(graph): reopen the board after the rules step and refuse tooling runs on an open board [SOL-BOARD-RULES-AND-LOCKED-CRITICAL-ROUTING.C2, .C3]
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2026-10-13 fix(hardware): confirm rules and lock critical copper through the board tooling, refuse an open board, and route the agent through close and reopen [SOL-BOARD-RULES-AND-LOCKED-CRITICAL-ROUTING.C1-.C3]
    Adds the rules confirmation and lock commands beside record and compare,
    reusing the gate's marker and class probe. Lock, record and confirm refuse
    an undefined or empty class and a MAINS declaration that is not exactly
    present or none; lock and record refuse a class list leaving out Mains on a
    board declaring mains; lock, record and compare refuse while KiCad's lock
    file shows the board open. The method writes the rules with the board
    closed, confirms them with the new command, reopens before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
2026-10-13 docs(controller): bound the barrier mark, add pump failure row, correct the working design's gate-pulse and isolation claims [SOL-HW-MODULE-PROPERTIES-CARRIED-FORWARD.C1, .C2]
2026-10-13 fix(hardware): state what each rules-table row's confirmation rests on, and hold confirm and compare to the Mains class on a mains board [SOL-BOARD-RULES-AND-LOCKED-CRITICAL-ROUTING.C1, .C3]
2026-10-13 fix(docs): say a net class's track width and via sizes are routing defaults KiCad does not enforce, and hold any the board relies on as a custom rule [SOL-BOARD-RULES-AND-LOCKED-CRITICAL-ROUTING.C1]
    Measured with kicad-cli 10.0.7 pcb drc --severity-all on scratch copies of the
    synthetic proof board: class clearance and every board-wide minimum the rules
    table lists are reported (silkscreen-to-edge as a warning, the rest as errors)
    and the pre-order check fails both severities; class track width and via sizes
    raise nothing and the pre-order check passes a board that breaks them; custom
    track_width, via_diameter and hole_size rules conditioned on a class are
    enforced.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
2026-10-13 fix(round-gate): require a changed directory to yield a mutant, and state what pins the diff truly [SOL-SWEEP-CHANGED-PLANT-LINES-IN-ROUND.C1]
    The restricted sweep accepted an object compiled as proof that a changed
    directory carries no mutant. A scope that matches nothing still compiles, so
    that let an uninstrumented directory pass. It now holds every directory with a
    changed source to the full sweep's rule: at least one listed mutant, or the run
    could not look. The per-source compiled check stays as further evidence.
    The documentation said no git setting could widen, move or hide a hunk. A
    content filter declared in gitattributes does move one. The statements now say
    the diff options and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
2026-10-13 fix(graph): settle placement and recording conventions for the manufacturer bounds solution [SOL-HW-MANUFACTURER-BOUNDS-DATED.C1, .C2]
    Places the machine-independent limits beside the board method and the
    per-channel readings in the machine's design-constraints record, and
    removes C2's false claim that the controller module was already bought.
2026-10-13 fix(graph): record what a board order costs, and how the build quantity is derived [SOL-HW-MANUFACTURER-BOUNDS-DATED.C1, .C2]
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2026-10-13 fix(docs): pin every board price to its configuration, read the omitted part classes, and mark every open reading pending [SOL-HW-MANUFACTURER-BOUNDS-DATED.C1, .C2]
    Manufacturer record: minimum-order fabrication prices read at the quote for
    stated 2-, 4- and 6-layer configurations, website and JLCONE, with the
    102 x 102 mm band threshold confirmed either side; the advertised $2 floor
    graded as a claim, not a price. Handling fee and single-board surcharge
    recorded with both of the price page's readings and the one taken. X-ray
    and fixture tiers in full; storage fees, small-board, small-via, fine-track,
    long-board and extra-design charges given figures, and every charge without
    one graded unme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
2026-10-13 docs(graph): require board layout to published practice, planned in before placement and confirmed by a review that is proven to see defects [REQ-BOARD-LAYOUT-PRACTICE-001.C1, .C2, .C3, DEL-HW-DESIGN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
    No criterion stated what a well laid-out board is: the method required only that a review happen. Adds the layout practice requirement, a design-time criterion on the method so quality is planned in before placement rather than reached by review rounds, a sourced practice catalogue solution, a review-view render solution, and strengthens the layout review solution (per-item verdicts, independent reviewer, full re-review after a change, signed safety waivers, seeded-defect proof,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
2026-10-13 fix(docs): record JLCONE pricing once, carry every extra-charge item, and give every cell a figure or a grade [SOL-HW-MANUFACTURER-BOUNDS-DATED.C1, .C2]
    The fabrication-price table drops its per-row JLCONE column: each row
    gives the website price, and the JLCONE price is one entry holding the
    four figures read and grading every other configuration unmeasured.
    All sixteen numbered items of the extra-charge page now have an entry,
    read at source on 2026-10-13, among them the routing fee for slots and
    the ENIG-area charge the ENIG price rows now carry as their condition.
    Every price or limit cell holds a figure, the word unmeasured with how
    to read it, or not applicable with why; every Source c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
2026-10-13 docs(graph): require first-review misses to be corrected at their planning cause, give the reviewer the plan and check report, and split the seeded-defect proof into its own solution [REQ-BOARD-LAYOU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
    Blind review round 3: the reviewer's allowed inputs excluded the plan and check report it needs, a board's own appended checklist items tripped the timing rule, the first-pass outcome could never close, and the end-to-end demonstration did not cover the new planning and review steps.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
2026-10-13 docs(graph): settle the review-view command's rasteriser, per-board resolution, model image limit, crop parts and failure cases [SOL-BOARD-REVIEW-RENDER-VIEWS.C1]
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2026-10-13 docs(graph): hold the conductor let-through check, the unbounded-interference case and what counts as a rail in the pre-layout proof and bring-up brief [SOL-BOARD-PRE-LAYOUT-PROOF-AND-BRING-UP-PROVIS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
2026-10-13 fix(docs): judge each pre-layout record as it stood at placement and source every input to the conductor withstand calculation [SOL-BOARD-PRE-LAYOUT-PROOF-AND-BRING-UP-PROVISION.C1, .C2]
2026-10-13 feat(hardware): render the layout review views of a board from its files [SOL-BOARD-REVIEW-RENDER-VIEWS.C1]
    task hw:views renders, from a board's own design files, an image of every
    layer it carries and every layer holding an item, an assembly view of each
    side, each critical net over a faint image of the whole board, a class map,
    a crop around each integrated circuit with the parts on its supply nets, and
    top, bottom and angled 3D views. Each is a PNG on a dark background with its
    caption drawn in, at three pixels across the board's smallest track width and
    clearance, tiled to stay within the size a reviewing model reads without
    downsampling. An index and a per-net fact table are written as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
2026-10-13 fix(docs): cross-check the bring-up record against the netlist, limit every supply input, and state copper's constants in the pre-layout steps [SOL-BOARD-PRE-LAYOUT-PROOF-AND-BRING-UP-PROVISION.C1, .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
2026-10-13 fix(docs): account for every external connection pin when listing a board's supply inputs [SOL-BOARD-PRE-LAYOUT-PROOF-AND-BRING-UP-PROVISION.C1, .C2]
2026-10-13 fix(docs): define followed and shunt parts when tracing a connector pin, and class every pin that can power the board as a supply input [SOL-BOARD-PRE-LAYOUT-PROOF-AND-BRING-UP-PROVISION.C1, .C2]
2026-10-13 fix(hardware): name or draw what KiCad leaves out of the review views instead of dropping it silently [SOL-BOARD-REVIEW-RENDER-VIEWS.C1]
    The views were rendered from a renamed copy of the board in a temporary
    folder, so ${KIPRJMOD} and folder-relative model paths pointed nowhere and the
    three-dimensional views showed a bare board while the command reported success.
    The same class showed up elsewhere: KiCad substitutes a missing font and says so
    only in output the command discarded, never plots rule areas, frames the angled
    render so a tall part runs out of the image, and a board without a fabrication
    or courtyard layer lost it from the assembly views and crops without a word.
    - Stage the co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
2026-10-13 fix(docs): replace pin-path tracing with a judged supply-input rule, record multi-source rails, and rate isolating links [SOL-BOARD-PRE-LAYOUT-PROOF-AND-BRING-UP-PROVISION.C1, .C2]
2026-10-13 fix(docs): rate links by the withstand calculation, keep protection apart from the current-limit means, and bound the fault-current conductors and model tolerances [SOL-BOARD-PRE-LAYOUT-PROOF-AND-BRI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
2026-10-13 fix(hardware): compose every two-dimensional review view in one place and frame whole-board views on what their layers hold [SOL-BOARD-REVIEW-RENDER-VIEWS.C1]
    The layer, assembly, net overlay, class map and crop views were built along
    separate paths, so rule areas reached only some of them, and the whole-board
    frame stopped a millimetre past the outline, cutting off anything reaching
    further. Every two-dimensional view and every tile now goes through one
    composer, which alone frames it, sets the dark background, draws and names
    rule areas, names layers the board lacks and fonts KiCad substituted, and
    writes the shared caption fields. Images are written only after KiCad has
    drawn everything,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
2026-10-13 fix(docs): rate a fault-path link as a conductor, drop the unsourced continuous rating, and keep producer-only nets out of the rail list [SOL-BOARD-PRE-LAYOUT-PROOF-AND-BRING-UP-PROVISION.C1, .C2]
2026-10-13 fix(docs): name wire and copper-bridge links, bound bare wire's withstand, and allow several producer pins on a producer-only net [SOL-BOARD-PRE-LAYOUT-PROOF-AND-BRING-UP-PROVISION.C1, .C2]
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2026-10-13 fix(hardware): read KiCad's plots through every transform they carry when framing a whole-board view [SOL-BOARD-REVIEW-RENDER-VIEWS.C1]
    KiCad 10 writes the hidden searchable copy of every turned text under rotate(a cx cy) and of every mirrored text under scale(-1 1) translate(...), and the extent reader refused any transform other than the identity, so every real board, the repository's own gate-proof included, failed as unreadable. The reader now parses the SVG document, composes the full transform grammar (matrix, translate, scale, rotate with and without a centre, skewX, skewY and lists of them) down nested groups, maps every point through it, bounds each element by its own inherited stro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
2026-10-13 fix(hardware): give every review-view file its own name, refuse a board open in an editor, and accept the resvg every system can obtain [SOL-BOARD-REVIEW-RENDER-VIEWS.C1]
    One allocator now names every file the views command writes: each image,
    each tile of one, the index and the fact table. It tells names apart with
    letter case folded, as macOS and Windows do, so two nets differing only in
    case, or a tiled net beside a net named as one of its tiles, write
    distinct files, each listed once in the index.
    The command refuses a board KiCad's lock file shows open in an editor,
    since the views are drawn from the saved file.
    resvg's floor drops to 0.47, the last release carrying a Windows program;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
2026-10-13 fix(hardware): give each decoupling part to the circuit nearest it, refuse a caption no tile can hold, count footprint zones in the per-net facts, and name the caption font in the method [SOL-BOARD-R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
    A crop now holds only its own circuit's decoupling: a two-pad part across a
    shared rail goes to the one circuit on that rail whose nearest pad is closest
    to it, and a circuit given none is marked as having no decoupling parts in its
    caption and the index. A crop's supply-net and parts lists are capped like
    every other caption list, and a caption too tall for any tile is refused at
    once, naming the view, instead of searching without end. The per-net facts
    count copper zones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
2026-10-13 fix(hardware): name only a crop's own circuit and decoupling and say the rest is drawn unnamed, report every part drawn without its model, never take an integrated circuit or a one-net part as decoup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
2026-10-14 docs(method): add the sourced layout practice catalogue and the plan-before-placement step [SOL-BOARD-LAYOUT-PRACTICE-CATALOGUE.C1, .C2]
    The method gains a closing Layout practice catalogue: 43 items over the
    eleven areas, each with an identifier, an applicability condition stated
    against the schematic, its question, passing pattern, failing look in the
    review views, kind, severity and a free published source read on
    2026-10-14. A new Planning the layout section requires a committed
    layout-plan.md (floorplan and one plan row per item) judged in the existing
    pre-placement checkout, and the rules step now carries every applicable
    rule-kind item with the item as its source.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
2026-10-14 docs(method): state every catalogue item's applicability in schematic terms [SOL-BOARD-LAYOUT-PRACTICE-CATALOGUE.C1]
    POWER-3, MFG-3, MAINS-4 and EMI-2 were conditioned on facts the schematic
    does not carry (layer count, vias in a land, a datasheet spacing against the
    separation basis record, a switching frequency). Each now applies on a
    schematic condition, and its plan row says how the layout meets it. MAINS-1's
    failures now include the pre-order check's mains_declaration.
2026-10-14 docs(method): hold rule-kind figures against their source in the rules table, scope ground items to low voltage, require a yes row to name what it binds [SOL-BOARD-LAYOUT-PRACTICE-CATALOGUE.C1, .C2]
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2026-10-14 docs(graph): settle the layout review brief before build [SOL-BOARD-LAYOUT-REVIEW-FEEDS-RULES.C1, .C2, .C3]
    Rule-kind verdicts rest on the pre-order check's report and the board's
    rules table together, as the merged catalogue judges them; board-specific
    items live in the committed plan; one review record keeps numbered rounds;
    cannot-judge is resolved by re-rendering; the safety acceptance form is
    stated in the method's own words; placement extends the method in place.
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2026-10-14 feat(board-method): layout review step that feeds the catalogue [SOL-BOARD-LAYOUT-REVIEW-FEEDS-RULES.C1, .C2, .C3, .C4]
    Adds the Layout review section after Routing: a numbered-round review
    record beside the board, a verdict on every catalogue and board item,
    rule-kind verdicts resting on the pre-order report and the rules table,
    findings judged and fed back as rules or items, first-review planning
    shortfalls amended at their cause, closure rules with a named person's
    acceptance for safety findings, and a full repeat after any change.
    The planning step gains the board's own items table under its
    before-placement check; the introduction and the out-of-scope pointers
    are brought into line.
    Co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
2026-10-14 fix(board-method): check finding severity against the item that raised it [SOL-BOARD-LAYOUT-REVIEW-FEEDS-RULES.C3, .C4]
    The review record's closure and planning-shortfall cross-checks keyed on the
    severity a record writes down, which nothing checked. A new cross-check holds
    each verdict row's kind and severity to the item's, and each finding's
    severity to the item or plan row that raised it, safety wherever it bears on
    mains separation, fusing, protective earthing or insulation. An amended
    planning step now carries a note naming the review in the method's own text,
    and the shortfall cross-check looks for it.
2026-10-14 fix(board-method): close the record checks a review could dodge [SOL-BOARD-LAYOUT-REVIEW-FEEDS-RULES.C1, .C2, .C4]
    The baseline check now requires every before-placement board item to stand unchanged in each round; a rule judgement of no must show why no rule form can state the finding; and the review record is committed at each round's end, each round checked against the history as first recorded.
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2026-10-14 docs(graph): settle the element-power resizing decisions into its brief [SOL-PLANT-MODEL-ELEMENT-POWER-COVERS-DECLARED-SPAN.C1, .C2]
    Symmetric seam reused, per-side multiplicative compounding (0.21 both
    elements), live-control tightening intended, failing-check reporting
    mechanism; casting-peak derivation now waits on the resized corners.
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2026-10-14 feat(plant): size element-power uncertainty to the declared 216-253 V span [SOL-PLANT-MODEL-ELEMENT-POWER-COVERS-DECLARED-SPAN.C1, .C2]
    Both thermoblock element-power fractions become 0.21, sized per side
    about the stored 230 V value: the high side is (253/230)^2 alone, the low
    side compounds (216/230)^2 with the hot-running derate (and, on the steam
    side, the unquantified parallel path). Each account states the span, the
    per-side arithmetic, the governing side and the over-covered side.
    With both fractions equal the stability analysis compares the joint
    mains-droop corner against each element's own corner, the steam side
    against a real re-run as the coffee side is. Every analysis record no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
2026-10-14 docs(graph): record the seeded band-of-nothing defect's failing baseline [SOL-PLANT-MODEL-ELEMENT-POWER-COVERS-DECLARED-SPAN.C2]
    Re-running the seeded defects for the element-power span work found one
    whose check command lacks two source headers the build-time check now
    passes, so its baseline fails before anything is mutated. Outside this
    slice; carried as a DEL-MAINTENANCE child targeting
    OBL-VERIFICATION-DISCIPLINE-001.C2.
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2026-10-14 docs(graph): correct the steam parallel-path allowance comparison [SOL-PLANT-MODEL-ELEMENT-POWER-COVERS-DECLARED-SPAN.C1]
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2026-10-14 fix(plant): discriminate the joint sag, correct the span prose, stop the records vouching for coverage [SOL-PLANT-MODEL-ELEMENT-POWER-COVERS-DECLARED-SPAN.C1, .C2]
    - The C enumeration's joint-corner test declares the two elements different
    errors each way round, so a sag taken from the larger, first or last element
    fails it; the stability record writer's wider-error case is put both ways too.
    - The steam parallel-path allowance is stated as shrinking from about 13% to a
    little over 8%, and the reference machine record no longer says 52.7 ohm rules
    out 1200 W "on this supply" or quotes a 240 V-bounded ceiling.
    - The analysis records state the declared span about its nominal as the sup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
2026-10-14 docs(graph): batch the class read by net and keep the check's own report from being cut short [SOL-HW-BOARD-CLASS-READ-ANY-SIZE.C1]
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2026-10-14 fix(hardware): read net-class membership whole on a board of any size [SOL-HW-BOARD-CLASS-READ-ANY-SIZE.C1]
    KiCad's command-line layout check reports at most 199 failures of one kind
    and drops the rest at random. The class probe ran on the real board beside
    a marker firing on every item, so on any board past that limit the Mains
    read came back short or empty from run to run, and the check's own every-item
    marker could crowd a design's assertion failures out of the report.
    Class membership is now read through the one seam on boards of one track per
    net, carrying the board's project file and its layout's own net-class blocks,
    in batches that keep every run below the limit; a run that still re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
2026-10-14 docs(hardware): state when rules-confirm reports a cut-short report, and which class the views test pushes past the limit [SOL-HW-BOARD-CLASS-READ-ANY-SIZE.C1]
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2026-10-14 docs(graph): let a missed seed close where its gap lies and run the blind review below the design tier [SOL-BOARD-LAYOUT-REVIEW-SEEDED-PROOF.C1]
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2026-10-14 feat(hardware): seeded layout review proof design and its seeding command [SOL-BOARD-LAYOUT-REVIEW-SEEDED-PROOF.C1]
    Add hardware/proof/review-proof, a clean four-layer throwaway design drawn
    through Konnect with a part for every area of the layout practice catalogue,
    its floorplan and plan, rules table and synthetic constraints and separation
    basis records, marked not for manufacture and passing the pre-order check.
    Add review_seed.py and task hw:review-seed: it seeds eleven layout defects,
    one or more per catalogue area, into a copy outside the repository through
    board_prove's seeded-fault mechanics (now taking the design to copy), refuses
    a copy the pre-order check fails, writes a review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
2026-10-14 fix(hardware): type the review proof design's pads from its schematic and state R3's track as drawn [SOL-BOARD-LAYOUT-REVIEW-SEEDED-PROOF.C1]
    The first blind review found two defects in the clean design: its pads carried
    no pin types, so the crop views named no circuit's decoupling, and the plan's
    SENSE-3 row overstated how short R3's track to the inverting input is. Type
    every pad from the schematic's netlist and state the row as laid out.
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2026-10-14 fix(hardware): give the review proof design's U4 a shipped 3D model and clear its assembly-view text overprints [SOL-BOARD-LAYOUT-REVIEW-SEEDED-PROOF.C1]
    The second blind review found two cosmetic defects in the clean design. U4's
    footprint names a 3D model KiCad 10.0.7 does not ship
    (QFN-20-1EP_4x4mm_P0.5mm_EP2.6x2.6mm.step), so the 3D views drew no body
    for it; point it at the shipped model of the same 4 x 4 mm, 0.5 mm pitch
    package (EP2.5x2.5mm). Several fab-layer texts overprinted one another or a
    silkscreen text in the assembly views, U3's value over R2's among them; move
    the fab-layer texts only, so no copper, pad or silkscreen moves.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
2026-10-14 feat(verify): run every gate of the complete verification nightly on main [SOL-VERIFY-NIGHTLY-FULL-ON-MAIN.C1, .C2]
    fw:verify hands its ordered gate list to a driver that runs every gate to
    completion, fails naming each gate that failed, and can leave a declared gate
    out by name. The nightly workflow runs it with the sweep left out and calls
    the sharded sweep workflow in the same run.
2026-10-14 fix(hardware): leave nothing in the layout review folder that tells a seeded item or file from an unseeded one [SOL-BOARD-LAYOUT-REVIEW-SEEDED-PROOF.C1]
    The seeding gave every added track and via a patterned identifier spelling the
    seed, appended them together at the end of the layout, wrote the project file
    without KiCad's closing newline, and kept the edited files' newer times, so a
    reviewer could find the seeds without judging the board. Each added item now
    takes a fresh random identifier of the design's own form, KiCad itself refills
    and saves the seeded layout so every item sits in its order and form, the
    folder holds exactly the committed design's files, and every file and folder
    carri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
2026-10-14 fix(verify): refuse what the nightly's guards exist to stop [SOL-VERIFY-NIGHTLY-FULL-ON-MAIN.C1, .C2]
    The guards on the complete verification and its nightly were only ever
    exercised by cooperative inputs, so a regression of any of them passed every
    test. The driver now reads the declaration and the forwarded command line
    apart: everything after the '--' that ends the Taskfile's declaration may
    only leave a declared gate out, once, so a forwarded --task or --gate can no
    longer replace the task runner or extend the gates. The workflow checks read
    the workflows through one strict reader that refuses forms it cannot read,
    and evaluate the concurrency expressions in a stated run context, so they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
2026-10-14 feat(graph): require layout workmanship and plan its checks [REQ-BOARD-LAYOUT-PRACTICE-001.C5]
    Boards are to be laid out as an experienced electrical engineer would lay
    them out, not only electrically correct. That was asked for but never
    written down, so a practice board passed every check while looking
    beginner-drawn. REQ-BOARD-LAYOUT-PRACTICE-001 now requires workmanship
    (C5, scope amended, v2). SOL-BOARD-LAYOUT-WORKMANSHIP-ITEMS adds sourced
    workmanship items to the catalogue, measured by the pre-order check where
    the board file allows and judged as a style guide otherwise, with a seeded
    blind proof and the practice board tidied. SOL-BOARD-LAYOUT-PLACEMENT-
    CHECKPOINTS checks placement c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
2026-10-14 feat(board-check): measure the workmanship rules and require KiCad's in every rules file [SOL-BOARD-LAYOUT-WORKMANSHIP-ITEMS.C2]
    The pre-order check now requires a track_angle and a track_segment_length
    rule on every track in each design's rules file, and measures from the
    layout what KiCad does not: stubs, route length against the shortest
    straight-line tree of the net's pads, track direction against the board's
    edges, entry into long pads, and narrowing below the net class's width away
    from a pad. Each figure is a project text variable, missing or malformed
    figures fail by name, and the report states each figure it read. The pad
    geometry and the tree live once in board_geometry, which the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
2026-10-14 docs(board-method): rest a rule-kind verdict on the item's own rules in the check's report [SOL-BOARD-LAYOUT-WORKMANSHIP-ITEMS.C2]
    A round can judge a board the check fails on other items' rules, as the
    review proof's first workmanship round does; each rule-kind verdict now
    reads the violations of its own rules, and the review still closes only
    on a round the check passes.
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2026-10-14 feat(hardware): tidy the review proof design to the workmanship items [SOL-BOARD-LAYOUT-WORKMANSHIP-ITEMS.C3]
    Redraw every route of the layout review proof design at 45 degrees, each
    straight run at least 1 mm, each track at its class's width and entering
    long pads along their axes, branching only at pads, and place R1, R2, R3,
    FB1, C3, C4, C5, C6, J4 and the test points beside what they connect to,
    so the board passes the pre-order check with every workmanship rule in
    force. The tracks, parts and vias are changed through Konnect; the eleven
    vias the tidy no longer needs, which Konnect cannot delete, are removed
    with KiCad's own scripting API on the closed board. Give the Supply class
    a 0.3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
2026-10-14 docs(hardware): record round 2 of the review proof design's layout review [SOL-BOARD-LAYOUT-WORKMANSHIP-ITEMS.C3]
    Round 2 judges the tidied board: every rule-kind workmanship item passes
    and the round 1 workmanship findings are closed by the change, but WORK-1
    and WORK-3 fail (R1 turned with its ground pad towards J4, two supply
    routes turning back at a capacitor's pad), J4's body crosses into the
    analog region, and tracks meeting at a pad at 45 degrees escape WORK-4's
    KiCad rule, which the check now measures.
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2026-10-14 feat(board-method): re-anchor the review proof's seeds to the tidied board and seed every workmanship item [SOL-BOARD-LAYOUT-WORKMANSHIP-ITEMS.C3, .C4]
    Redraw seeds S1 to S11 on the tidied copper, each still leaving the copy
    passing the pre-order check with the workmanship rules in force. Add a
    copper seed for each judgement item, WORK-1 and WORK-3, and for each rule
    item a rules seed loosening its figure in the rules table and where the
    board sets it, with a copper defect the loosened figure admits. The stub
    and unneeded-via items, which KiCad reports unaided, and the subtle jog
    and corner defects are proven by the check's own seeded faults.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
2026-10-14 feat(board-method): seed the stub and unneeded-via items through the rules table [SOL-BOARD-LAYOUT-WORKMANSHIP-ITEMS.C4]
    KiCad reports any stub or unconnected via unaided and the check fails an
    ignored severity, so neither can be drawn on a copy that passes. Each is
    seeded where its item's Fails clause looks: the stub figure raised above
    nought, and the unconnected-via row taken out of the rules table.
2026-10-14 fix(board-check): name the rejected rule at its line in the grown proof rules file, and head the check's tests with their trace comment [SOL-BOARD-LAYOUT-WORKMANSHIP-ITEMS.C2]
    The gate proof's rules file now carries the corner and jog rules, so a
    rule appended to it sits nine lines lower. The workmanship tests' trace
    lines become the comment form the project's tests open with.
2026-10-14 docs(graph): rest the stub item on KiCad's own unconnected-end report [SOL-BOARD-LAYOUT-WORKMANSHIP-ITEMS.C2]
    KiCad 10.0.7 reports every loose track end as track_dangling unaided, so a
    measured stub rule would duplicate the gate's own check.
2026-10-14 fix(board-check): rest the stub item on KiCad's own check, hold a route turning through a pad to the corner rule, and source every workmanship figure [SOL-BOARD-LAYOUT-WORKMANSHIP-ITEMS.C1, .C2]
    KiCad's layout check reports every track end left unconnected, wherever the
    stub leaves the route, so the check's own stub measure duplicated it and its
    figure could admit nothing: the measure, WORK_STUB_MM and their tests are
    gone, and WORK-6 names KiCad's track_dangling check as WORK-7 names
    via_dangling, its fault seeded through KiCad's own report. Two tracks meeting
    at a pad are now one route turning there, held to the Corners rule's own
    figure, which the check reads from the rules file and repor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
2026-10-14 fix(hardware): seat the crystal's load capacitors at U4's pins, part AMP_OUT from the 3V3 route, and return R3 at the shunt [SOL-BOARD-LAYOUT-WORKMANSHIP-ITEMS.C3, .C4]
    The tidy had pushed C5 and C6 to the crystal's two ends, 16.6 mm apart, run
    XTAL1 and XTAL2 side by side for 5.3 mm, laid AMP_OUT 0.66 mm under the +3V3
    diagonal for 7 mm, moved R3's ground 12.4 mm from the shunt inside the
    ground pour, and turned AMP_FB square through R2's pad. C5 and C6 now sit
    side by side on their own pins' tracks with the crystal turned beyond them
    and its tracks parting at once; AMP_OUT crosses the +3V3 route once and
    branches at U3's pin-1 via; R2 is entered at 45 degrees and passes straight
    on to R3;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
2026-10-14 fix(review-seed): leave a board's rule areas alone when a seed takes a net's copper areas away [SOL-BOARD-LAYOUT-WORKMANSHIP-ITEMS.C4]
    A rule area carries no net, so reading every zone's net failed on the review
    proof's new pour keepout; the seeds that strip ground or mains copper now
    pass it by.
2026-10-14 docs(hardware): record round 4 of the review proof design's layout review, and close the round 1 and 2 findings the reworked board meets [SOL-BOARD-LAYOUT-WORKMANSHIP-ITEMS.C3]
    Round 4 judges the board as 46ee1d3 left it: the crystal's load capacitors
    side by side at U4's pins, AMP_OUT parted from the 3V3 route, and R3
    returning at the shunt meet CLOCK-1 and SENSE-1, so findings 1.4, 2.2 and
    2.3 close by that change. It raises 4.1, the crystal turned end-on so one of
    its tracks passes the other pad, and 4.2, the R3 rule area leaving a
    0.077 mm sliver between the pour and R3's return track.
2026-10-14 fix(hardware): fit a two-pad crystal whose pads face its capacitors, and keep the R3 rule area clear of its track [SOL-BOARD-LAYOUT-WORKMANSHIP-ITEMS.C3, .C4]
    Round 4 finding 4.1: the HC49-SD crystal's pads lie 8.5 mm apart and each
    must be entered along its length, so no way of turning it both keeps its two
    tracks apart (CLOCK-1) and faces each pad to its capacitor (WORK-1). Y1 is
    now a 5.0 by 3.2 mm two-pad crystal from KiCad's own library, its schematic
    footprint field changed with it, set just beyond C5 and C6 with each pad
    facing its capacitor and both tracks 5.7 mm long; it sits 25.1 mm from C2's
    body, so no further part comes within CLOCK-3's 25 mm. The footprint is
    swapped with KiCad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
2026-10-14 fix(hardware): widen the R3 rule area so the pour clears R3's pad on every side [SOL-BOARD-LAYOUT-WORKMANSHIP-ITEMS.C3]
    Round 5 finding 5.1: the rule area's long edges lay 0.125 mm from R3's
    ground pad, under the board's 0.15 mm minimum, so the slot could close in
    etching and return R3 to ground at its own pad. The edges now lie 0.325 mm
    from the pad and 0.55 mm from the track, and the area ends 0.275 mm beyond
    the pad's east end; the track still joins the pour only at R1's pad 2.
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2026-10-14 docs(graph): file the review proof's pre-existing findings and owed amendments as maintenance [SOL-BOARD-REVIEW-PROOF-BASELINE-CLEAN.C1, .C2, .C3]
    The workmanship build's first review of the layout review's proof design
    found it failing non-workmanship items it already failed on main; the
    seeded proof requires a clean baseline, so they get an owner.
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2026-10-14 docs(hardware): restore rounds 1 to 5 of the review proof's layout review beneath round 6 [SOL-BOARD-LAYOUT-WORKMANSHIP-ITEMS.C3, .C1]
    Commit 1d83c3f wrote round 6 over the whole record, dropping its title and
    rounds 1 to 5. Those rounds are restored exactly as c1a6855 committed them,
    and round 6 follows them exactly as 1d83c3f wrote it, so every round stands
    as first recorded and every citation of round 1, round 2 and finding 5.1
    resolves again.
2026-10-14 fix(board-check): fail a corner or jog rule looser than the one in force, naming it at its line [SOL-BOARD-LAYOUT-WORKMANSHIP-ITEMS.C2]
    KiCad applies the last custom rule that matches, so a later rule holding
    track_angle or track_segment_length at a lower figure for one net class let
    that class break WORK-4 or WORK-5 while KiCad's check, and so the gate,
    passed. The check now fails every other rule of either constraint, before or
    after the one in force, conditioned or not, whose minimum is looser or not
    written in the one form, naming the rule, its line and both figures. The
    rules read from a design's file carry their lines, a seeded fault proves it
    end to end on the gate's proof design, and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
2026-10-14 docs(graph): file a command check for layout review record history as maintenance [SOL-BOARD-REVIEW-RECORD-HISTORY-CHECK.C1, .C2]
    A commit in the workmanship build replaced a review record's earlier rounds
    and no check failed: the history rule is prose only.
2026-10-14 fix(review-seed): give the blind review folder only the design's KiCad files and named records, never its review record [SOL-BOARD-LAYOUT-WORKMANSHIP-ITEMS.C4]
    The seeding command copied every committed file of the proof design into
    the review folder, so the clean design's own layout-review.md travelled
    with the seeded copy and told the blind reviewer what a review of the
    unseeded board had found. The folder now states what it holds: KiCad's
    files of the design, its library tables among them, and the plan, the
    rules table and the records the rules table reads its figures from.
    Every other file of the design's folder, its review record first, stays
    out.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
2026-10-14 fix(board-check): judge a track meeting a pad from the copper, and never let a zone exempt a net's route length [SOL-BOARD-LAYOUT-WORKMANSHIP-ITEMS.C2, .C1]
    The measured rules reasoned about idealised geometry: a track met a pad only
    when its centre-line end point lay on the pad, and a net with any copper zone
    was left out of the route-length rule. A token zone over one pad therefore let
    a long detour pass, and a track ending just short of a long pad's side, joined
    to it in KiCad by its end's copper, was never counted as entering it.
    The contact rule now lives once in board_geometry: a track's end is a round
    cap of half its width, and it meets a pad where that cap reaches the pad's
    copper,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
2026-10-14 test(board-check): prove the unsized-pad failure on a seeded fault [SOL-BOARD-LAYOUT-WORKMANSHIP-ITEMS.C2]
    Every rule the check reports of its own has a seeded fault proving it. The
    new workmanship_pad_copper rule gets one: R2's pad 1 on the gate's proof
    design made a custom-shaped pad, which /LV_A runs into.
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2026-10-14 fix(board-check): measure detour over all a net's pads, hold arcs by their ends, read edges at their true shape, and join a track to a pad as KiCad does [SOL-BOARD-LAYOUT-WORKMANSHIP-ITEMS.C2, .C1]
    - WORK-2: a net's track length is measured against the shortest tree joining
    the centres of all its pads. Zones never enter the measure, so a route
    ending in its net's pour short of its pad no longer drops that pad and
    escapes the rule. A pad's centre is known whatever its copper, so a net
    with an unsized pad is still measured.
    - WORK-9: an arc is held by the way it runs at its two ends, so a fillet
    between compliant tracks passes and a flat arc drawn at an odd angle fails.
    The edge di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
2026-10-15 fix: skill sync should pin main, not sha
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2026-10-15 feat(review-seed): hand the blind reviewer the placement view and its measures [SOL-BOARD-LAYOUT-PLACEMENT-CHECKPOINTS.C2]
    The seeded review folder builder renders the placement view and its
    measures from the seeded copy into placement/, beside views/, and the
    fixed reviewer prompt names them among what the reviewer is given.
2026-10-15 docs(board-method): choose the placement from measured candidates, check critical routing before the router, close placement-caused findings at the placement [SOL-BOARD-LAYOUT-PLACEMENT-CHECKPOINTS.C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
    A placement step between planning and the rules sets the board-wide
    minimums, places the fixed parts first, makes at least two candidates each
    in its own commit, renders and measures each with task hw:placement,
    judges each against the items whose Judged on names the placement view,
    and records the choice in layout-plan.md before any track, with a history
    cross-check. The floorplan table gains a Parts column and its planning
    cross-check. The catalogue names the placement view on the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
2026-10-15 fix(board-views): give the placement view the views' index, report lines and frame to share [SOL-BOARD-LAYOUT-PLACEMENT-CHECKPOINTS.C1]
    The placement command had copied the views' index writer, its frame
    assembly and its FONT/LAYER/RESOLUTION report lines. Those now live once
    in board_views (index_fields, write_index, report_substitutions,
    report_resolution, board_frame), and the views call them themselves. A
    test pins the views' index text, index JSON and report lines byte for
    byte, checked against the code before the move.
2026-10-15 fix(board-placement): take the shared seam from the views, and stop on a table with no separator row or footprints not told apart by reference [SOL-BOARD-LAYOUT-PLACEMENT-CHECKPOINTS.C1]
    The placement command now writes its index, report lines and frame
    through the views' shared functions, with its own output unchanged. A
    floorplan table with no separator row of dashes under its header used to
    lose its first region row silently; it now stops the command. Footprints
    sharing a reference used to merge, and ones with none became '?'; each
    such reference is now named, with how many footprints carry it, and the
    command stops. The hardware guide's stops paragraph says both.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
2026-10-15 fix(board-method): judge the placement and critical-routing sections as they stood before the first track and the router [SOL-BOARD-LAYOUT-PLACEMENT-CHECKPOINTS.C2, .C3]
    The placement record is judged in the commit before the first track,
    <T>^, and must equal the section now: an empty heading committed early
    and filled in later no longer passes. The parts at <T> are compared
    with the chosen candidate's, so a part moved before or with the first
    track shows. The router's commit is found from the record's Board judged
    commit, which must hold copper that is all locked, so a hand-routed net
    committed before locking is not taken for the router's. The critical
    routing section is judged as it stood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
2026-10-15 feat(board-history): judge the placement and critical routing sections against the repository's history [SOL-BOARD-LAYOUT-PLACEMENT-CHECKPOINTS.C2, .C3, .C4]
    The history cross-checks were git recipes in the method, and each round of
    review found a new way their "nothing found" branches passed: an empty
    heading, a Board judged commit off the branch, tracks first drawn on two
    lines of history. task hw:history now makes them a command that fails.
    It reads every version of the board file reachable from HEAD, finds the
    first track and each pass's router commit, and judges the placement section
    as it stood before the first track and each `### Pass <n>` of the critical
    routing section as it stood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
2026-10-15 docs(board-method): run the history command at placement, routing steps 4 and 8 and the placement-caused closure, and append critical routing passes [SOL-BOARD-LAYOUT-PLACEMENT-CHECKPOINTS.C2, .C3, .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
    Placement step 6 and routing step 4 drop their git, awk, cmp and python
    recipes for task hw:history and say what each FAIL means. The critical
    routing section becomes `### Pass <n>` subsections, only ever appended, so a
    re-route from the layout review's placement-caused closure records its own
    pass without changing the one the router already followed. Routing step 8
    is the command's deciding run. The method states that the branch merges
    without rewriting its history, and that finding the rout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
2026-10-15 fix(board-history): measure candidates against the judged floorplan, fail locked router copper under --routed, and fail first copper arriving by a merge [SOL-BOARD-LAYOUT-PLACEMENT-CHECKPOINTS.C2, .C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
    - Every candidate is measured against the floorplan of the commit the
    placement section is judged in, not its own commit's, so a region widened
    in a candidate's commit and restored before the section no longer passes.
    - A pass's checklist is read from the commit the pass is judged in (the
    router's parent, or HEAD), not its Board judged commit.
    - --routed makes a last pass with no router commit, or a missing critical
    routing section, a FAIL; routing step 8 and the placement-caused closu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
2026-10-15 test(board-history): trace the history tests to C6 and cover every refusal and failure it lists [SOL-BOARD-LAYOUT-PLACEMENT-CHECKPOINTS.C6]
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2026-10-15 fix(verify): refuse an untracked board design when what changed cannot be told [SOL-HW-GATE-IN-ROUND-AND-NIGHTLY.C1]
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2026-10-15 docs(graph): C1 states the anchor commit's failure forms [SOL-BOARD-HISTORY-PLACEMENT-HARDENING.C1]
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2026-10-15 feat(hardware): placement history check fails the orderings a final review found it passing [SOL-BOARD-HISTORY-PLACEMENT-HARDENING.C1, .C2]
2026-10-15 fix(hardware): hold amendment timing to the plan at placement, pour on copper layers only [SOL-BOARD-HISTORY-PLACEMENT-HARDENING.C1, .C2]
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2026-10-15 fix(hardware): qualify the rework guidance to before first copper [SOL-BOARD-HISTORY-PLACEMENT-HARDENING.C1, .C2]
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2026-10-15 fix(hardware): state what the floorplan is held to after first copper, quote the criterion in trace comments [SOL-BOARD-HISTORY-PLACEMENT-HARDENING.C1, .C2]
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2026-10-15 fix(hardware): one sentence says what the plan compare covers, enforced across every site [SOL-BOARD-HISTORY-PLACEMENT-HARDENING.C1, .C2]
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2026-10-15 fix(hardware): catalogue entries say how to get a pass, widen the compare-wording check [SOL-BOARD-HISTORY-PLACEMENT-HARDENING.C1, .C2]
2026-10-15 fix(hardware): drop the catalogue remedy clauses that were not true of every failing history [SOL-BOARD-HISTORY-PLACEMENT-HARDENING.C2]
2026-10-15 fix(hardware): one turn written two ways is one placement; track-or-pour wording in the method [SOL-BOARD-HISTORY-PLACEMENT-HARDENING.C1, .C2]
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2026-10-15 Revert "docs(graph): record evidence for the placement history hardening [SOL-BOARD-HISTORY-PLACEMENT-HARDENING.C1, .C2]"
    This reverts commit 746923b67f073d431afd179bad6fc8b6988cd033.
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2026-10-15 docs(graph): own the nightly's Linux gate failures the graph did not cover [SOL-SEAM-DIRECT-CALL-CHECK-READS-LINUX-DISASSEMBLY.C1, .C2, SOL-BOARD-GATES-PASS-ON-HOSTED-RUNNER.C1, .C2]
2026-10-15 docs(graph): wire the board-gates solution to the nightly install criterion and settle the failed-export case [SOL-BOARD-GATES-PASS-ON-HOSTED-RUNNER.C1, .C2, SOL-SEAM-DIRECT-CALL-CHECK-READS-LINUX-DI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
2026-10-15 fix(emulation): hold every run's peak against what the artefact printed, pin inputs per row, refuse unrun corners, name the regeneration task [SOL-CASTING-PEAK-UNDER-CONTROL-DERIVED.C1]
2026-10-15 fix(emulation): derive each side's casting channel from the side and pin it, the digest set and the steam unrun-corner call site with tests [SOL-CASTING-PEAK-UNDER-CONTROL-DERIVED.C1]
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2026-10-16 feat(hardware): fail a review record whose rounds the history check cannot read in full [SOL-BOARD-REVIEW-RECORD-HISTORY-CHECK.C1, .C2]
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2026-10-16 docs(graph): settle the placement of the hosted-runner board gate fix [SOL-BOARD-GATES-PASS-ON-HOSTED-RUNNER.C1, .C2]
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2026-10-16 docs(graph): confirm the brief of the hosted-runner board gate fix [SOL-BOARD-GATES-PASS-ON-HOSTED-RUNNER.C1, .C2]
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2026-10-16 fix(verify): the seam direct-call check recognises the call forms Linux GCC disassembly prints [SOL-SEAM-DIRECT-CALL-CHECK-READS-LINUX-DISASSEMBLY.C1]
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2026-10-16 fix(hw): install the standard KiCad libraries on the hosted runner and judge the 3D export by what it wrote [SOL-BOARD-GATES-PASS-ON-HOSTED-RUNNER.C1, .C2]
2026-10-16 fix(hw): draw the proof design's local model from a STEP file and drive the zero-status export case with a stand-in [SOL-BOARD-GATES-PASS-ON-HOSTED-RUNNER.C1, .C2]
    KiCad's Linux packages write nothing for a VRML model to the three-dimensional export, so the proof design's design-local model is now STEP, which both builds draw. The zero-status export test no longer depends on the real tool's status for the proof design, whose deliberately missing model makes it exit 2 on the runner.
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2026-10-16 docs(graph): elevate the evidence for the hosted-runner board gate fix [SOL-BOARD-GATES-PASS-ON-HOSTED-RUNNER.C1, .C2]
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2026-10-16 test(board): compare a missing connection by where its items lie, as KiCad names the pad or the track from run to run [SOL-BOARD-REVIEW-PROOF-BASELINE-CLEAN.C3]
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2026-10-16 fix(board): the floorplan reader stops on a repeated region name [SOL-BOARD-FLOORPLAN-REGION-NAMES-DISTINCT.C1]
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2026-10-16 fix(plant): close the guard holes, correct the record wording and the maths comments [SOL-HOST-ARITHMETIC-REPRODUCIBLE-ACROSS-HOSTS.C2, .C3, .C5]
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2026-10-16 docs(hardware): move the main-session rule into the method and correct the net class read-back reference [SOL-BOARD-METHOD-FOLLOWABLE-AND-MACHINE-FREE.C1]
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2026-10-16 hardware(method-proof): set the board-wide minimum track width and clearance to JLCPCB's 0.09 mm and write their two rows of the rules table
    Not for manufacture. Read before placement because the placement view takes
    its resolution from them.
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2026-10-16 hardware(method-proof): record the placement: five candidates with their commits, renders, measures and verdicts, and the choice of candidate 5
    Not for manufacture. Candidates 1 to 4 each fail TEST-1 and three of them
    leave courtyards overlapping; candidate 5 is chosen, with the board's design
    files as it holds them, before any track, arc, via or pour.
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2026-10-17 hardware(method-proof): the router's copper imported (Freerouting 2.5.0 session): the signal nets routed, critical copper unchanged by the comparison, with /LED_K redrawn by hand where the router's r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
2026-10-17 hardware(method-proof): layout review round 1 by a reviewer that did not design the board: 61 items judged, one fail and seven further findings, all open
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2026-10-17 hardware(method-proof): the router's copper removed ahead of re-routing, leaving the critical copper reworked for the review's findings, all locked: the board judged by critical routing pass 2
2026-10-17 hardware(method-proof): the router's copper imported again after the critical rework (Freerouting 2.5.0 session), critical copper unchanged by the comparison, /LED_K redrawn by hand as before; pre-or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
2026-10-17 hardware(method-proof): layout review round 2 by a reviewer that did not design the board: 65 items judged, one fail and three further findings, all open
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2026-10-17 hardware(method-proof): layout review round 3 by a reviewer that did not design the board: 66 items judged, one fail that cites earlier closed findings and two further findings, all open
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2026-10-17 hardware(method-proof): layout review round 4 by a reviewer that did not design the board: 67 items judged, one fail that cites earlier closed findings and one further finding, open
2026-10-17 hardware(method-proof): layout review round 5 by a reviewer that did not design the board: 67 items judged, one fail that cites earlier closed findings and one further finding, open
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2026-10-17 docs(hardware): let cosmetic findings stay carried, allow a narrow re-review after a fix, and write the review-rule choices into the method [SOL-BOARD-METHOD-FOLLOWABLE-AND-MACHINE-FREE.C1]
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2026-10-17 docs(hardware): keep the reviewer as author of the planning shortfall, state the no-source case with criterion C4, and settle the follow-up's requirement decision [SOL-BOARD-METHOD-FOLLOWABLE-AND-MAC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
2026-10-17 hardware(method-proof): the plated hole spacing re-derived by GROUND-5's corrected formula, 1.35 to 1.45 mm, in the rules file and its row
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2026-10-17 docs(graph): reshape the proportionate review loop: class fix, measured designator rule, narrow rounds closed only by a full one [SOL-BOARD-REVIEW-LOOP-PROPORTIONATE.C1, .C4, .C5]
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2026-10-17 docs(graph): the review-record rules wait on the proportionate loop that delivers them, not the reverse [SOL-BOARD-REVIEW-LOOP-PROPORTIONATE.C1]
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2026-10-17 docs(graph): confirm the corrected brief [SOL-BOARD-REVIEW-LOOP-PROPORTIONATE.C1]
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2026-10-17 fix(hardware): review-proof rules table lists every measured rule; swept all 21 rule-kind items, only decoupling_via, reference_off_silkscreen and designator_astray rows were missing; GROUND-5 rule n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
2026-10-17 docs(hardware): close Round 9 findings of review-proof by the class fix and by reason [SOL-BOARD-REVIEW-LOOP-PROPORTIONATE.C4]
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2026-10-17 fix(hardware): review-proof ground planes use a 0.25 mm thermal gap so no plated pair's rings merge; swept every plated pair, only J2 pads 1 and 2 merged [SOL-BOARD-REVIEW-LOOP-PROPORTIONATE.C4]
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2026-10-17 fix(hardware): harden the round-kind check with completeness and exact-form rules; correct MFG-9 justification, turned text, arcs and courtyard-less parts; record the GROUND-5 figure defect [SOL-BOAR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
2026-10-17 docs(graph): resolve review findings on the review-gap capture [OBL-ELECTROMAGNETIC-COMPATIBILITY-001.C1, .C2, DEC-MAINS-PHASED-ACTUATION-BELOW-SEAM, DEC-BOARD-SEPARATION-BASIS-RECORD, DEC-BOARD-DESI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
2026-10-17 fix(method): scope the review seed test's catalogue read to the layout section and state CABLE-1's source as it reads [SOL-BOARD-CIRCUIT-PRACTICE-CATALOGUE.C1]
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2026-10-17 docs(graph): fix the key names the board record decisions leave open and the solution's reading rule [SOL-PRE-ORDER-CHECK-READS-RECORD-KEYS.C1]
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2026-10-18 fix(method): let a board with no plated pin in a ground plane pass GROUND-5 with its figure stated as none, and restate the method-proof figure in the item's terms [SOL-BOARD-GROUND-5-FIGURE-FROM-PLA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
2026-10-18 feat(graph): require readable schematics and author the convention and its check [REQ-PUBLISHED-BUILD-PATH-001.C6, DEL-HW-DESIGN-METHOD.C12, DEL-HW-PRE-ORDER-CHECKS-EXTENDED.C13, DEL-CONTROLLER-HARDW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
    Adds the missing requirement that a board's published schematic can be read by someone who did not draw it, the decision recording what was chosen and rejected, and two solutions: the drawing convention with a per-sheet render, and the pre-order check's refusal of tool-named nets and unnamed sheets.
2026-10-18 fix(docs): open the schematic review proof paragraph with its own marker [SOL-BOARD-CIRCUIT-REVIEW-SEEDED-PROOF.C1]
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2026-10-18 docs(graph): confirm the corrected brief of the production-files ordering step [SOL-BOARD-PRODUCTION-FILES-CHECKED-BEFORE-PAYMENT.C1]
2026-10-18 fix(hardware): keep the seed kinds out of the follower's folder, claim only what the sources support, give the seeded number a row of its own [SOL-BOARD-PRODUCTION-FILES-CHECKED-BEFORE-PAYMENT.C1, .C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
2026-10-18 fix(hardware): give the follower each footprint at rotation 0 to judge first-pin orientation [SOL-BOARD-PRODUCTION-FILES-CHECKED-BEFORE-PAYMENT.C1, .C3]
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2026-10-18 fix(hardware): cite real sections, and fail a render that draws fewer sheets than the design holds [SOL-BOARD-SCHEMATIC-DRAWING-CONVENTION.C1, .C3]
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2026-10-18 test(hardware): seed the plated hole clear of the signed clearance so only its hole is inside the distance [SOL-PRE-ORDER-CHECK-SEPARATION-FLOOR-AND-MOUNTING-HOLES.C5]
2026-10-18 test(hardware): seed a fixing whose courtyard alone is inside the signed distance [SOL-PRE-ORDER-CHECK-SEPARATION-FLOOR-AND-MOUNTING-HOLES.C2, .C5]
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2026-10-18 docs(graph): a fixing's courtyard and pad copper are measured against every Mains-class copper, and a plated drilled footprint is a mounting hole [SOL-PRE-ORDER-CHECK-SEPARATION-FLOOR-AND-MOUNTING-HO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
2026-10-18 feat(hardware): measure a fixing's pad copper and courtyard against every Mains copper from the layout, broaden hole identification, probe the hole rules [SOL-PRE-ORDER-CHECK-SEPARATION-FLOOR-AND-MOU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
2026-10-18 docs(graph): a mounting hole is a fixing and not a part, so an all-drilled footprint in the bill of materials is not one [SOL-PRE-ORDER-CHECK-SEPARATION-FLOOR-AND-MOUNTING-HOLES.C2]
2026-10-18 fix(hardware): a plated-pad footprint is a mounting hole only when it is left out of the bill of materials [SOL-PRE-ORDER-CHECK-SEPARATION-FLOOR-AND-MOUNTING-HOLES.C2]
2026-10-18 fix(hardware): move the review proof's mounting hole H1 clear of the mains copper the hole rule measures [SOL-PRE-ORDER-CHECK-SEPARATION-FLOOR-AND-MOUNTING-HOLES.C6]
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2026-10-18 fix(hardware): join the review proof's decoupling and ground pins to the planes by vias beside their pads, as the amended items ask [SOL-PRE-ORDER-CHECK-SEPARATION-FLOOR-AND-MOUNTING-HOLES.C6]
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2026-10-18 fix(hardware): add the plated hole spacing rule and row, take the manufacturer's preferred hole size, and give the leadless package clearance its record [SOL-PRE-ORDER-CHECK-SEPARATION-FLOOR-AND-MOUN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
2026-10-18 fix(hardware): move the review proof's test points TP2, TP3 and TP4 clear of part courtyards and state why AMP_OUT's feedback leg changes layer [SOL-PRE-ORDER-CHECK-SEPARATION-FLOOR-AND-MOUNTING-HOLE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
2026-10-19 fix(hardware): identify a mounting hole by four marks so a forgotten exclude_from_bom does not skip the extent checks [SOL-PRE-ORDER-CHECK-SEPARATION-FLOOR-AND-MOUNTING-HOLES.C2]
2026-10-19 docs(graph): a fixing is marked by non-plated holes, exclusion from the bill of materials, a MountingHole name or a single pad [SOL-PRE-ORDER-CHECK-SEPARATION-FLOOR-AND-MOUNTING-HOLES.C2]
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2026-10-19 fix(hardware): hold test point TP3 2.0 mm from the tall connector J4, as the test point item asks [SOL-PRE-ORDER-CHECK-SEPARATION-FLOOR-AND-MOUNTING-HOLES.C6]
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2026-10-19 fix(hardware): anchor the review seeds on the review proof's decoupling and ground vias beside their pads [SOL-PRE-ORDER-CHECK-SEPARATION-FLOOR-AND-MOUNTING-HOLES.C6]
2026-10-19 docs(graph): brief confirmed again after the report wording, fixing marks and review-driven settlements [SOL-PRE-ORDER-CHECK-SEPARATION-FLOOR-AND-MOUNTING-HOLES]
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2026-10-19 fix(plant,control): refuse inconsistent parameter pairs at load, test the host runs, sweep superheat across error ends [SOL-PLANT-STEAM-FLASH-GENERATOR.C2, .C3, .C5, .C7, .C8, .C9, .C10]
    The superheat error-end test is red on purpose until the ready temperature is re-derived.
2026-10-19 docs(graph): superheat holds at the independent error ends and above zero at the joint ends [SOL-PLANT-STEAM-FLASH-GENERATOR.C7]
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2026-10-19 feat(hardware): fail a side short of fiducials and a polarised part without its first-pin mark [SOL-PRE-ORDER-CHECK-FIDUCIALS-AND-POLARITY-MARKS.C1, .C2, .C3, .C4, .C6]
2026-10-19 fix(hardware): give the tracked proof designs the three fiducials a side with surface-mount parts needs [SOL-PRE-ORDER-CHECK-FIDUCIALS-AND-POLARITY-MARKS.C5]
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2026-10-19 fix(control): the superheat setpoint is a floor and the feed yields to dryness when the heater is spent [SOL-PLANT-STEAM-FLASH-GENERATOR.C7, .C8, .C10]
2026-10-19 fix(hardware): judge a plated through-hole polarised part by the mark rule and pin the attribute and schematic guards [SOL-PRE-ORDER-CHECK-FIDUCIALS-AND-POLARITY-MARKS.C1, .C2, .C4]
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2026-10-20 docs(machine-record): the enclosure, retained harnesses and device characteristics recorded as found [SOL-HW-MACHINE-AS-FOUND-FIT-RECORD.C1, .C2, .C3, .C4] (#180)
    * docs(graph): settle the as-found record's fit tolerance, inspected grade, harness set and unplugged-only inspection [SOL-HW-MACHINE-AS-FOUND-FIT-RECORD.C1, .C2, .C3, .C4]
    * docs(graph): require derived views and the channel enumeration to follow the as-found record, end C3's live-feed marks, complete C4's device classes and name the record's consumers [SOL-HW-MACHINE-AS-FOUND-FIT-RECORD.C1, .C2, .C3, .C4]
    * docs(gra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
2026-10-20 feat(hardware): the pre-order check fails a part over its derated voltage and a pin whose net can exceed its absolute limits [SOL-PRE-ORDER-CHECK-DERATED-VOLTAGE-AND-PIN-LIMITS.C1, .C2, .C3, .C4, .C5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
2026-10-20 docs(graph): a rated part cannot opt out with class none, a listed pin the part lacks fails, and a part's kind is its exact designator letters [SOL-PRE-ORDER-CHECK-DERATED-VOLTAGE-AND-PIN-LIMITS.C1, 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
2026-10-20 docs(graph): proof-design ratings the rule cannot read are corrected, not exempted [SOL-PRE-ORDER-CHECK-DERATED-VOLTAGE-AND-PIN-LIMITS.C6]
2026-10-20 fix(hardware): circuit review proof ratings the derating rule can read, U4 at its datasheet maximum [SOL-PRE-ORDER-CHECK-DERATED-VOLTAGE-AND-PIN-LIMITS.C6]
2026-10-20 fix(hardware): a rated part cannot opt out of derating, a listed pin the part lacks fails, a part's kind is its exact designator letters [SOL-PRE-ORDER-CHECK-DERATED-VOLTAGE-AND-PIN-LIMITS.C1, .C2, .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
2026-10-20 fix(hardware): rating units and designator letters are read ignoring case and a repeated record entry fails [SOL-PRE-ORDER-CHECK-DERATED-VOLTAGE-AND-PIN-LIMITS.C1, .C2]
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2026-10-20 fix(hardware): a repeated rail, a rail that is no net and a voltage-shaped rating named none fail [SOL-PRE-ORDER-CHECK-DERATED-VOLTAGE-AND-PIN-LIMITS.C1, .C2]
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2026-10-20 docs(graph): carry the findings this slice surfaced into the graph, steam pressure accuracy and crash-versus-refusal in the analyses [REQ-MEASUREMENT-001.C11, SOL-ANALYSIS-RECORDS-TELL-A-CRASH-FROM-A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
2026-10-20 feat(hardware): fail a connected pin of a semiconductor or integrated circuit that its pin-limit entry omits [SOL-PRE-ORDER-CHECK-EVERY-CONNECTED-PIN-LISTED.C1, .C2, .C3, .C4, .C5, .C6]
2026-10-20 fix(hardware): guard the setup session's whole history, account failed attempts, classify citations by round and lock before checking records [SOL-HW-REVIEW-FAN-OUT-DRIVER.C2, .C3, .C4, .C5, .C6, .C7]
2026-10-20 fix(hardware): refuse, with a line, a caller hook that raises and say what a rerun kept [SOL-HW-REVIEW-FAN-OUT-DRIVER.C4, .C6]
2026-10-20 fix(hardware): show the proof leaves an unconnected pin unfailed [SOL-PRE-ORDER-CHECK-EVERY-CONNECTED-PIN-LISTED.C4]
2026-10-20 docs(graph): a run again may not leave out a unit whose last run again failed [SOL-HW-REVIEW-FAN-OUT-DRIVER.C8]
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2026-10-20 fix(hardware): refuse absent or mistyped agent output everywhere, keep no-report figures at zero and settle a failed rerun before another [SOL-HW-REVIEW-FAN-OUT-DRIVER.C2, .C4, .C5, .C6, .C8]
2026-10-20 fix(hardware): type every outside input in one layer, drive each hostile value through main and settle a unit by its own mark [SOL-HW-REVIEW-FAN-OUT-DRIVER.C2, .C4, .C5, .C6, .C8]
2026-10-20 fix(hardware): split the stream on newlines only and type every caller value before use [SOL-HW-REVIEW-FAN-OUT-DRIVER.C2, .C4, .C6]
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2026-10-20 docs(graph): settle the Mains-pair sensing order and the ground-return ratio direction and keys [SOL-PRE-ORDER-CHECK-SENSING-CLEARANCE-AND-GROUND-RETURNS.C1, .C2, .C5]
2026-10-20 docs(graph): record the sensing and ground-return placement and keep the separation decision exact [SOL-PRE-ORDER-CHECK-SENSING-CLEARANCE-AND-GROUND-RETURNS.C1, .C3]
2026-10-20 docs(graph): confirm the sensing-clearance and ground-return brief [SOL-PRE-ORDER-CHECK-SENSING-CLEARANCE-AND-GROUND-RETURNS.C1, .C2]
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2026-10-20 feat(hardware): pre-order check fails a sensing net too close to a noisy net and a connector short of ground returns [SOL-PRE-ORDER-CHECK-SENSING-CLEARANCE-AND-GROUND-RETURNS.C1, .C2, .C3, .C4, .C5, 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
2026-10-20 fix(hardware): resolve every project net class for the ground-return and sensing rules [SOL-PRE-ORDER-CHECK-SENSING-CLEARANCE-AND-GROUND-RETURNS.C2, .C1]
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2026-10-20 docs(graph): bound the rendered-record replacement to files an earlier merge wrote [DEL-HW-REVIEW-FAN-OUT.C1]
2026-10-20 fix(hardware): probe the net classes a layout file defines itself for the ground-return and sensing rules [SOL-PRE-ORDER-CHECK-SENSING-CLEARANCE-AND-GROUND-RETURNS.C2, .C1]
2026-10-20 docs(graph): name the record figure as the fifth rule form in the sensing decision [SOL-PRE-ORDER-CHECK-SENSING-CLEARANCE-AND-GROUND-RETURNS.C1]
2026-10-20 fix(hardware): count only numbered connector pads as ground returns [SOL-PRE-ORDER-CHECK-SENSING-CLEARANCE-AND-GROUND-RETURNS.C2]
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2026-10-20 docs(graph): evidence for the sensing-clearance and ground-return rules [SOL-PRE-ORDER-CHECK-SENSING-CLEARANCE-AND-GROUND-RETURNS.C1, .C2, .C3, .C4, .C5, .C6, .C7]
2026-10-20 docs(graph): state the connector pin-counting rules in the sensing decision [SOL-PRE-ORDER-CHECK-SENSING-CLEARANCE-AND-GROUND-RETURNS.C2]
2026-10-20 fix(hardware): count an unconnected-named net's pad as no pin only when no other pad joins it, and correct the SENSE-6 link [SOL-PRE-ORDER-CHECK-SENSING-CLEARANCE-AND-GROUND-RETURNS.C2, .C7]
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2026-10-20 docs(machine-record): carry the pump-diode exception, pin the relay and triac pairing, correct derived switching views, add the overlay [SOL-HW-RETAINED-DEVICE-REMAINING-CHARACTERISTICS-RECORDED.C1]
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2026-10-20 fix(hardware): a rendered record's names are one plain portable component and an earlier merge's files are disclosed [SOL-HW-REVIEW-FAN-OUT-CALLER-SEAM.C4, .C6]
2026-10-20 fix(hardware): the rendered record's bookkeeping tells an earlier merge's files from foreign ones exactly and discloses them when a caller stops rendering [SOL-HW-REVIEW-FAN-OUT-CALLER-SEAM.C4]
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2026-10-20 docs(graph): settle the narrow-round fields, cannot-judge re-run, planning shortfall writer, proof folder and tool parity in the layout fan-out [SOL-HW-REVIEW-FAN-OUT-LAYOUT.C3, .C5, .C7, .C8]
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2026-10-20 fix(hardware): the setup session may hold an empty-text thinking block and is started again after narration [SOL-HW-REVIEW-FAN-OUT-DRIVER.C2]
2026-10-20 fix(hardware): the setup session alone is started with an appended no-text rule [SOL-HW-REVIEW-FAN-OUT-DRIVER.C2]
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2026-10-21 fix(hardware): the setup session is given its documents in the prompt on standard input and has no tool use to narrate between [SOL-HW-REVIEW-FAN-OUT-DRIVER.C2]
2026-10-21 fix(hardware): a vertical bar or line break in a reviewer's cell is written sanitised and kept raw in the record instead of refusing the round [SOL-HW-REVIEW-FAN-OUT-LAYOUT.C3, .C4]
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2026-10-21 fix(hardware): a reviewer's answer with leading prose is kept, the setup wording is neutral for forks, units are told to open every view and read distances from the layout, and the proof can re-run t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
2026-10-21 fix(hardware): the review proof task description is valid YAML [SOL-HW-REVIEW-FAN-OUT-LAYOUT.C8]
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2026-10-21 docs(graph): the review kit's readiness items are settled: cutover with the last caller, system prompt source, fixtures, baseline key, schema-flag cache miss [SOL-HW-REVIEW-KIT.C1, .C2, .C4, .C9, .C1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
2026-10-21 fix(hardware): the layout declares only the couplings verdicts depend on [SOL-HW-REVIEW-FAN-OUT-LAYOUT.C1]
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2026-10-21 fix(hardware): layout facts print a pad's absolute angle, the proof's work folder keeps sessions blind, a small-tier third replica, dry warnings and a cannot-judge message that fits [SOL-HW-REVIEW-FA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
2026-10-21 docs(graph): a cannot judge that needs a document is resolved by an add-document mode beside add-view [SOL-HW-REVIEW-FAN-OUT-LAYOUT.C3, .C5, .C7]
2026-10-21 fix(hardware): a repair never clears a fail, held-out price check, resolved added-path matching and the cost multiple wording [SOL-HW-REVIEW-KIT.C6, .C7, SOL-HW-REVIEW-FAN-OUT-LAYOUT.C8]
2026-10-21 feat(hardware): an add-document mode resolves a cannot judge that needs a document [SOL-HW-REVIEW-FAN-OUT-LAYOUT.C3, .C5, .C7]
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2026-10-21 fix(hardware): the layout caller sets its bound on reviewers at once from the live runs [SOL-HW-REVIEW-FAN-OUT-LAYOUT.C8, SOL-HW-REVIEW-KIT.C13]
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2026-10-22 feat(review-kit): the production-files check names differs as its fail verdict [SOL-HW-REVIEW-FAN-OUT-PRODUCTION-FILES.C2]
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2026-10-22 fix(review-kit): the proof harness merges with the caller's own fail verdict [SOL-HW-REVIEW-FAN-OUT-SCHEMATIC.C6]
2026-10-22 docs(graph): require the production-files check to name differs as its fail verdict [SOL-HW-REVIEW-FAN-OUT-PRODUCTION-FILES.C7]
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2026-10-22 fix(review-kit): replicas that disagree whether an item selects anything no longer refuse the merged schematic round [SOL-HW-REVIEW-FAN-OUT-SCHEMATIC.C2, .C8]
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2026-10-22 docs(graph): the proof-of-life interval gets its own task so the partition no longer waits on the simulation chain [DEL-CONTROLLER-HARDWARE.C13, DEL-HW-PARTITION-AND-FEASIBILITY.C5]
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2026-10-22 fix(hardware): proof commands refuse an empty or unusable baseline, hold a lock across the single run and share their guard through the harness [SOL-HW-REVIEW-FAN-OUT-CRITICAL-ROUTING-PROOF.C2, SOL-H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
2026-10-22 fix(hardware): lock the resolved baselines path, refuse an empty group in write_baseline [SOL-HW-REVIEW-FAN-OUT-CRITICAL-ROUTING-PROOF.C2, SOL-HW-REVIEW-FAN-OUT-PRODUCTION-FILES-PROOF.C2]
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2026-10-22 fix(hardware): the production-files proof completes the seeded folder with its round file and stand-in preview in its own work folder [SOL-HW-REVIEW-FAN-OUT-PRODUCTION-FILES-PROOF.C1]
2026-10-22 fix(hardware): the proof commands run the fanned-out form a second time when the kit requires it and judge both runs together [SOL-HW-REVIEW-FAN-OUT-SCHEMATIC-PROOF.C1, SOL-HW-REVIEW-FAN-OUT-CRITICAL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
2026-10-22 fix(hardware): guard the schematic proof's baseline, run the second fanned-out run in the layout proof and test the wiring; record the critical-routing live result [SOL-HW-REVIEW-PROOFS-REFUSE-UNUSAB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
2026-10-22 fix(hardware): the critical-routing proof gives the review folder the placement view; drop the baseline recorded without it [SOL-HW-REVIEW-FAN-OUT-CRITICAL-ROUTING-PROOF.C1]
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2026-10-22 fix(hardware): the single-run baselines describe the sessions of the run [SOL-HW-REVIEW-FAN-OUT-CRITICAL-ROUTING-PROOF.C2, SOL-HW-REVIEW-FAN-OUT-PRODUCTION-FILES-PROOF.C2]
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2026-10-22 fix(hardware): the layout review's cost multiple test tells 2 from 2.25 so the board tier passes on main's documents [SOL-HW-REVIEW-LAYOUT-COST-MULTIPLE-CHECK-TELLS-TWO-FROM-2-25.C1]
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2026-10-22 fix(graph): review findings - one owner for the pressure layer, off-board protection stated, basis compared with the relief finding, no downstream node named in new prose [DEL-HW-DESIGN-CONSTRAINTS.C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
2026-10-22 fix(graph): drop the stale addresses link and the unasserted amendment route [DEL-BENCH-SAFETY-CHAIN-INSPECTION.C7]
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2026-10-23 fix(graph): blind review - harness change justified, pump drive stated as a property, assumed air figure cited, finished inputs linked [DEL-HW-PARTITION-AND-FEASIBILITY.C1]
2026-10-23 test(hardware): pin the layer order through render under reordered discovery [SOL-ROUND-GATE-NOTES-MISSING-TOOL-UNDER-HOSTED-RUNNER.C2]
2026-10-23 docs(graph): the hosted-runner probe run is the test evidence for the three corrections [SOL-ROUND-GATE-NOTES-MISSING-TOOL-UNDER-HOSTED-RUNNER.C1, .C2, .C3]
2026-10-23 feat(graph): settle the board runner's open choices before build - empty run fails, missing tool named once, one runner for both suites, measured ceiling [SOL-BOARD-TIER-TESTS-RUN-SIDE-BY-SIDE.C1]
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2026-10-23 feat(graph): no fixed fraction of the serial time is required; the stage states its time and commits unsigned [SOL-BOARD-TIER-TESTS-RUN-SIDE-BY-SIDE.C1]
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2026-10-23 fix(tools): the runner counts a module's own tests, not a nested run's [SOL-BOARD-TIER-TESTS-RUN-SIDE-BY-SIDE.C1]
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2026-10-23 fix(graph): leave how the heater wall board is made and assembled to board design [SOL-HW-FUNCTION-FORM-DECIDED.C1]
2026-10-23 fix(record): the heater switches are a designed wall board, and each function's entry stands alone [SOL-HW-FUNCTION-FORM-DECIDED.C1, .C2, .C3, .C4]
2026-10-23 fix(record): the heater triac's ratings are read from its maker's datasheet [SOL-HW-FUNCTION-FORM-DECIDED.C2, .C3]
2026-10-23 fix(record): current triac and opto-triac sheets, the steam transducer behind a condensate leg, and its media temperature owed by the basis criterion [SOL-HW-FUNCTION-FORM-DECIDED.C1, .C2, .C3, DEL-H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
2026-10-23 fix(graph): the transducer media-temperature item traces to the steam pressure measurement it keeps working, and allows for a condensate leg [DEL-MAINTENANCE.C1]
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2026-10-23 fix(record): the spare analogue input carries a 5 V pin so the proving transducer runs in its specification, and the 0.5 MPa range is excluded [SOL-HW-FUNCTION-FORM-DECIDED.C3]
2026-10-23 fix(record): the component specification lists the spare analogue input's 5 V pin [SOL-HW-FUNCTION-FORM-DECIDED.C3]
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2026-10-23 fix(hardware): a record nearer a design cannot stand in for the machine's controller, and the five-volt rating cites the operating limit [SOL-HW-CONTROLLER-MCU-SELECTED.C2, .C4]
2026-10-23 fix(hardware): a design in the machine folder uses the machine's record, the flow line pulls up to 3.3 V, and the five-volt claims are qualified [SOL-HW-CONTROLLER-MCU-SELECTED.C2, .C4]
2026-10-23 fix(controller): the flow sensing costs follow the 3.3 V form, the baseline decision cites the current price, and the README names the suffix-pin pitfall [SOL-HW-CONTROLLER-MCU-SELECTED.C1, .C2]
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2026-10-23 docs(controller): carry the open steam-side question, correct the reconciliation record and the glued cells, and banner the forks [SOL-CONTROLLER-DESIGN-FOLDER-RECONCILED-WITH-RECORD.C1, .C2, .C3]
2026-10-23 fix(hardware): judge the pressure-sensor barrier as earth-referenced water; require the fitted transducer's withstand [SOL-HW-SEPARATION-BASIS-SIGNED.C1, .C3, DEL-HW-PARTITION-AND-FEASIBILITY.C5]
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2026-10-24 chore(graph): restore the four-point fixing and the Extended count of the board division record [REQ-RETROFIT-FIT-001.C1, .C2]
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2026-10-25 chore(graph): carry the tab-blade question and the on-board entry parts into the division correction [REQ-RETROFIT-FIT-001.C1, .C2]
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2026-10-26 chore(graph): settle the blind review of the cost estimate and the four-point fixing item [SOL-HW-BOARD-COST-ESTIMATED.C1, REQ-RETROFIT-FIT-001.C1, .C2]
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2026-10-26 chore(graph): settle the readiness rulings into the four-point fixing solution [SOL-HW-BOARD-FOUR-POINT-FIXING-RESTORED.C2, .C5, .C6]
2026-10-26 chore(graph): carry the bracket-mount and varistor rulings into C5 and C4 [SOL-HW-BOARD-FOUR-POINT-FIXING-RESTORED.C4, .C5]
2026-10-26 chore(graph): confirm the brief of SOL-HW-BOARD-FOUR-POINT-FIXING-RESTORED
2026-10-26 docs(hardware): restore four-point fixing, bracket-mounted triacs, 19 Extended types [SOL-HW-BOARD-FOUR-POINT-FIXING-RESTORED.C1, .C2, .C3, .C4, .C5, .C6]
2026-10-26 docs(hardware): hold the criteria's statements in the record check and chase the bracket form through the cost record [SOL-HW-BOARD-FOUR-POINT-FIXING-RESTORED.C1, .C2, .C3, .C5, .C6]
2026-10-26 docs(hardware): state the limit of the required-statement check in its guard row [SOL-HW-BOARD-FOUR-POINT-FIXING-RESTORED.C3]
2026-10-26 docs(hardware): refuse an omitted mount, ear or triac by name and drop superseded figures [SOL-HW-BOARD-FOUR-POINT-FIXING-RESTORED.C3, .C4, .C5]
2026-10-26 docs(hardware): bring the cost estimate's statement of the division record to match it [SOL-HW-BOARD-FOUR-POINT-FIXING-RESTORED.C3, .C4]
2026-10-26 chore(evidence): record the evidence for SOL-HW-BOARD-FOUR-POINT-FIXING-RESTORED [C1, C2, C3, C4, C5, C6]
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2026-10-27 fix(casting-peak): hold prose, the heater row and spelled-out time units to the chosen interval [SOL-PROOF-OF-LIFE-INTERVAL-CHOSEN-RECORDED.C1, .C3]
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2026-10-27 fix(graph): carry the judged figures into the drawn boards, name every owner decision, and correct the gate claim [DEL-HW-MAIN-BOARD-DESIGNED.C11, .C15, .C16, .C17, .C21, .C22, DEL-HW-HEATER-WALL-BOA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
2026-10-27 fix(graph): carry the owner's possible change to the wall board outline into the assembly judgements [DEL-HW-HEATER-WALL-BOARD-DESIGNED.C16, .C17]
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2026-10-27 chore(hardware): drop a KiCad view-state file that was committed by mistake [SOL-HW-PRE-ORDER-CHECK-HOLDS-BOARD-WITHOUT-CONTROLLER.C6]
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2026-10-28 docs(hardware): judge the heater wall assembly with its arithmetic, window-only wall cut [SOL-HW-HEATER-WALL-BOARD-ASSEMBLY-JUDGED.C1, .C2, .C3, .C4, .C5, .C7]
    Work in progress on the branch: the owner's 2026-10-28 statements on the wiring
    and the wall cut are recorded, the wall-cut acceptance stays pending, and the
    bracket-as-spreader redesign follows.
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2026-10-29 feat(graph): split the main-board leaf into schematic and layout leaves, record the owner's risk acceptances and carried findings, and add the pre-order-check fixes [SOL-HW-MAIN-BOARD-SCHEMATIC-PROVE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
2026-10-29 fix(graph): complete the crystal keep-clear 10 mm brief [SOL-LAYOUT-CATALOGUE-CRYSTAL-KEEP-CLEAR-10MM.C1, .C2, .C3]
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2026-10-29 feat(graph): four pre-order check fixes the main board's rules run exposed [SOL-PRE-ORDER-CHECK-CRYSTAL-KEEP-CLEAR-EXEMPTS-THE-OTHER-CRYSTAL.C1, .C2, SOL-PRE-ORDER-CHECK-DECOUPLING-PINTYPE-SKIPS-PART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
2026-10-29 fix(graph): name the polarity-mark leaf for its design [SOL-PRE-ORDER-CHECK-POLARITY-MARK-SKIPS-A-PART-WHOSE-HOLES-FIX-ITS-ORIENTATION.C1, .C2]
2026-10-29 fix(graph): close the second blind review's findings on the checker fixes [SOL-PRE-ORDER-CHECK-DECOUPLING-PINTYPE-SKIPS-PART-WITH-NO-SUPPLY.C1-C10, SOL-PRE-ORDER-CHECK-POLARITY-MARK-SKIPS-A-PART-WHOS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
2026-10-29 fix(graph): settle the re-check's carry-forward and wording points [SOL-PRE-ORDER-CHECK-DECOUPLING-PINTYPE-SKIPS-PART-WITH-NO-SUPPLY.C3, SOL-PRE-ORDER-CHECK-POLARITY-MARK-SKIPS-A-PART-WHOSE-HOLES-FIX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
2026-10-30 chore(graph): confirm the four checker-fix briefs and state the oval-hole case [SOL-PRE-ORDER-CHECK-POLARITY-MARK-SKIPS-A-PART-WHOSE-HOLES-FIX-ITS-ORIENTATION.C3]
2026-10-30 fix(graph): sign mains-to-mains spacing and accepted exceptions, and test-point courtyard [REQ-ELECTRICAL-INSTALL-001.C15, .C16, REQ-BOARD-LAYOUT-PRACTICE-001.C1]
    Authors REQ-ELECTRICAL-INSTALL-001.C15 and .C16, amends the separation-basis, pre-order rule-readings and main-board residual-risk decisions, and adds four DEL-MAINTENANCE solutions: the check holding mains-to-mains spacing, the check judging signed exceptions, the record signing the figures and exceptions, and the test-point footprint courtyard.
2026-10-30 fix(graph): interpolate creepage, hold the interlock pair, scope exceptions by pair, judge K201/K731/K741/U602 [REQ-ELECTRICAL-INSTALL-001.C15, .C16, .C9]
    Review fixes: creepage read by interpolation to 4.1 mm with a derived row, interlock-contact pair held at the reinforced figures, downstream functional creepage gated on a stated fault-clearing basis, exceptions scoped to one pad or net pair with a dating rule, material group tied to a tracking index of at least 175, enumerated division-record restatements, a new leaf for the four unread bought parts, and decision wording and indentation corrected.
2026-10-30 feat(hardware): skip the first-pin mark for a part whose holes fix its orientation [SOL-PRE-ORDER-CHECK-POLARITY-MARK-SKIPS-A-PART-WHOSE-HOLES-FIX-ITS-ORIENTATION.C1, .C2, .C3, .C4, .C5, .C6, .C7, .C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
2026-10-30 feat(hardware): skip the supply-pin check for a part in a closed no-supply category [SOL-PRE-ORDER-CHECK-DECOUPLING-PINTYPE-SKIPS-PART-WITH-NO-SUPPLY.C1, .C2, .C3, .C4, .C5, .C6, .C7, .C8, .C9, .C10]
2026-10-30 fix(hardware): centre the polarity-mark turn test on distinct holes and name plated pads only [SOL-PRE-ORDER-CHECK-POLARITY-MARK-SKIPS-A-PART-WHOSE-HOLES-FIX-ITS-ORIENTATION.C2, .C3, .C6]
2026-10-30 test(hardware): record the two new KiCad-backed harness tests in the divided-files list [SOL-PRE-ORDER-CHECK-MAINS-BARRIER-IGNORES-PADS-THAT-CARRY-NO-NET.C12, SOL-PRE-ORDER-CHECK-POLARITY-MARK-SKIPS-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
2026-10-30 chore(evidence): record the evidence for the four pre-order check fixes [SOL-PRE-ORDER-CHECK-CRYSTAL-KEEP-CLEAR-EXEMPTS-THE-OTHER-CRYSTAL.C1-C9, SOL-PRE-ORDER-CHECK-MAINS-BARRIER-IGNORES-PADS-THAT-CA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
2026-10-30 docs(graph): split mains-spacing acceptance, bought-part reading and header holes out of unbuildable leaves [REQ-ELECTRICAL-INSTALL-001.C9, .C15, .C16, REQ-BOARD-LAYOUT-PRACTICE-001.C1]
    Why: the readiness pass found four leaves that a build cannot close.
    - Withdraw SOL-TEST-POINT-FOOTPRINT-COURTYARD-FITS-THE-PITCH: no tracked footprint has the defect. The main board's 96 test points use the stock TestPoint_Pad_D1.5mm and fail the courtyard rule at 2.5 mm pitch; the fix is a board-design step (a small test-point footprint in the board's own library), covered by SOL-HW-MAIN-BOARD-PROVEN-AND-LAID-OUT and its pre-order check.
    - Split the owner's acceptance (old C5, deprecated) out of the record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
2026-10-30 docs(graph): order the layout behind the acceptance, split layout-only checks, state the owner-asserted ground and the match tolerance [REQ-ELECTRICAL-INSTALL-001.C15, .C16, REQ-BOARD-LAYOUT-PRACTICE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
    The main-board layout leaf now depends on the acceptance leaf and its pre-order criterion owns the layout runs and the 96 test-point footprint. The header entry criterion tests the committed record only. The slow-signals ground is stated as the owner's assertion, shown with each header's nets at acceptance. Centres match within 0.01 mm and one entry covers a two-row connector's pairs at that pitch.
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2026-10-30 fix(graph): require the entry fuse on the entry/mains nets and the larger figures for held pairs [SOL-PRE-ORDER-CHECK-HOLDS-MAINS-TO-MAINS-SPACING.C1, .C8]
2026-10-30 fix(hardware): hold a pair at the larger figure and require the entry fuse on the entry and mains nets [SOL-PRE-ORDER-CHECK-HOLDS-MAINS-TO-MAINS-SPACING.C1, .C8]
2026-10-30 fix(hardware): read a null mapping as absent in both places and pin the synthetic value [SOL-PRE-ORDER-CHECK-HOLDS-MAINS-TO-MAINS-SPACING.C1]
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2026-10-30 fix(hardware): pin the unsigned draft, say the triac shortfall is lead to lead and note the layout points [SOL-SEPARATION-BASIS-SIGNS-MAINS-TO-MAINS-SPACING-AND-EXCEPTIONS.C1, .C3, .C4]
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2026-10-30 docs(hardware): record the makers' creepage and clearance of the interlock relay, the valve relays and the voltage-reading optocoupler [SOL-BOUGHT-PART-CREEPAGE-OF-K201-K731-K741-AND-U602-READ.C1, .C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
2026-10-30 fix(hardware): chase the judged-section cross-reference and the lands comment, pin the judgement's arithmetic in the record test [SOL-BOUGHT-PART-CREEPAGE-OF-K201-K731-K741-AND-U602-JUDGED.C2]
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2026-10-30 docs(graph): settle the derating exception's failure naming and schematic matching in place [SOL-PRE-ORDER-CHECK-JUDGES-OWNER-ACCEPTED-DERATING-EXCEPTIONS.C1, .C4]
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2026-10-30 fix(hardware): chase the division record's separation row to the pollution degree 2 rows, pin the header's criterion ids and locators [SOL-SEPARATION-BASIS-TAKES-POLLUTION-DEGREE-2-ON-A-COATED-BOARD.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
2026-10-31 fix(hardware): state the fault-state caveat on the neutral-referenced set's exceptions [SOL-MAIN-BOARD-NET-PAIR-EXCEPTIONS-DRAFTED.C5]
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2026-10-31 fix(hardware): make the cross-layer rule fast on large fills, measure filled stroke edges, fail copper curves by name, classify flush slots by all points [SOL-PRE-ORDER-CHECK-HOLDS-MAINS-APART-FROM-L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
2026-10-31 main-board: add the two-lead triac land for T701 and T711 and name it in the specification and plan [SOL-HW-MAIN-BOARD-PROVEN-AND-LAID-OUT.C18]
    The board's own library gains TO-252-2_TabPin2_Triac, KiCad's stock TO-252-2 (SOT-428) land renamed: pin 1 MT1, pin 3
    gate, tab pad 2 MT2, no pad for the cut middle lead, the stock 3D model kept. The sheet 700 record, the schematic
    specification and the parts specification name it for T701 and T711, and the plan's BOARD-3 row states it. The
    schematic Footprint fields and the board footprints follow in the main session; the separation basis's four
    middle-lead entries are replaced in the same commit as the board swap.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
2026-10-31 main-board: correct the floorplan before placement: U602 straddles mains and low voltage, the zero-cross island is dropped [SOL-HW-MAIN-BOARD-PROVEN-AND-LAID-OUT.C7]
    The first board branch's floorplan listed U602 only in mains and digital, whose one meeting place was the
    mains rectangle (1.3, 118.9)-(58, 126.7), sealed from the rest of mains by SL_LINK, K201's barrier strip and
    the low-voltage pocket, so the zero-crossing detector's mains pins could not be reached. This floorplan,
    committed before any footprint is placed on this branch:
    - lists U602 in mains and low voltage (not digital), so it can stand at the mains/low-voltage border of the
    opto column; R630, R631 and TP103 stay in main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
2026-10-31 main-board: placement candidate 1 [SOL-HW-MAIN-BOARD-PROVEN-AND-LAID-OUT.C7, .C18]
    The first board branch's chosen placement (its candidate 5, 2f172f3a: candidate 4's mains-side moves and
    TP202 at (71.5, 113.75)) replayed on this branch's floorplan, with the pump triacs T701 and T711 on the
    board's two-lead DPAK land main-board:TO-252-2_TabPin2_Triac (swapped by KiCad's Python, keeping position,
    turn, side, symbol link, fields and every pad's net, pin type and function; refilled and saved twice,
    byte-identical). Every other footprint is the earlier board's, byte for byte in content.
    Recorded as a candidate, not to be chosen: on the corrected floorplan the zero-crossing parts it leaves in
    th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
2026-10-31 main-board: record placement candidates 1 and 2 and choose candidate 2 [SOL-HW-MAIN-BOARD-PROVEN-AND-LAID-OUT.C7]
    Candidate 1 (the first board branch's chosen placement on the corrected floorplan) leaves R630, R631,
    TP103 and U602 outside their regions and fails MAINS-2 for them; candidate 2 brings the zero-crossing
    detector into mains and the opto column and passes FLOOR-1 and MAINS-2, every other verdict unchanged,
    61.7 mm shorter in all, /ZC_IN 35.8 mm against 126.2 mm, 13 more crossings. Both rendered from their
    commits with hw:placement; the tiles holding moved parts were opened.
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2026-10-31 main-board: record placement candidate 3 and choose it over candidate 2 [SOL-HW-MAIN-BOARD-PROVEN-AND-LAID-OUT.C7]
    Candidate 3 re-places the U601 measurement cluster (C601-C608, F601, F602, R604-R608, TP605-TP608)
    as one placement-only change from candidate 2 and gives every placement item candidate 2's verdict;
    rendered from its commit with hw:placement, the tiles holding the moved parts opened. 12.8 mm shorter
    and 7 crossings fewer in all; it is the only arrangement tried that routes the cluster with no via in
    any pad. Costs recorded in the verdicts: C605 and C606 farther from U601 pin 3, R605-R608 9.9 mm
    from their pins, one more far test pad, cluster courtyards at least 0.03 mm apart. Th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
2026-10-31 graph(hardware): a plated terminal is not a mounting-hole fixing and the pump-triac exceptions follow the land drawn [SOL-PRE-ORDER-CHECK-MOUNTING-HOLE-LEAVES-A-PLATED-TERMINAL-ALONE.C1-C6, SOL-SEPAR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
2026-10-31 graph(hardware): close the blind-review findings on the terminal-versus-fixing and pump-triac leaves [SOL-PRE-ORDER-CHECK-MOUNTING-HOLE-LEAVES-A-PLATED-TERMINAL-ALONE.C1, .C2, .C5, .C7, SOL-SEPARATIO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
2026-10-31 fix(review-kit): write a critical net's view only for the tiles holding its copper and refuse an oversize review context [SOL-BOARD-REVIEW-NET-VIEWS-DRAW-ONLY-TILES-HOLDING-THE-NET.C1, .C2, .C3, .C4]
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2026-10-31 main-board: connect every mains pad the pours left open and fix the mains copper defects found by the early review [SOL-HW-MAIN-BOARD-PROVEN-AND-LAID-OUT.C7]
    The NEUTRAL trunk link R105.4-J110.1 (a pour that filled to nothing) is two 3.0 mm tracks with two vias; the triac neutral island, LINE R101/R103, NEUTRAL R102/R104/F731, F711 and the test pads TP101, TP106, TP108 are joined by tracks; LINE1 no longer reaches past the mains region edge; T701 and T711 stand on F.Cu and B.Cu lands; TP105 and TP107 have vias of their own. TP102 stays unconnected (no routable path).
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2026-10-31 main-board: define the Fast net class and settle the Noisy/Supply5V overlap [SOL-HW-MAIN-BOARD-PROVEN-AND-LAID-OUT.C7]
    The 14 fast nets the plan names (crystals, USB, SPI2, the AMC clock and serial lines) were in Default and could not be locked. They go in a Fast class at the Default figures, no plan row giving a fast net another. Each net is now in exactly one of the non-mains classes: +5V_GAUGE and +5V_WB stay in Supply5V, PUMP_C_GATE_R and PUMP_S_GATE_R in Mains, both out of Noisy (64 nets); the sensing clearance against them is kept by naming Supply5V among the noisy classes. hw:rules-confirm CONFIRMED; the pre-order check shows no new or cleared finding against 0905c793.
    Co-Authored-By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
2026-10-31 main-board: move test pads TP102, TP106 and TP108 beside the pads they read and tie each by its own short track [SOL-HW-MAIN-BOARD-PROVEN-AND-LAID-OUT.C7]
    TP102 (LINE_F) was in a closed B.Cu pocket no copper could reach within the signed figures; it now stands beside F101's load clip at (42.0, 93.0) on a 1.7 mm track to the LINE_F copper at JP101 pin 1. TP106 and TP108 (NEUTRAL) stood 30.6 and 32.7 mm from R105 pad 4; they now stand at (15.5, 80.0) and (15.5, 82.5) on their own short tracks to the B.Cu NEUTRAL copper that joins pad 4 to J110 pin 1. Their long tracks and the via at (25.75, 56.25) are removed; the via at (26.75, 61.25) stays, it joins R102 pin 2. hw:placement LENGTH 9162.3832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
2026-11-01 main-board: Sense converter pins 21 to 25 re-fanned north, +3V3A chain to C409/C408, NTC_WAND_SENS, BREWA_DIV and +3V3A_FB routed, no clearance shortfall (22 of 30 nets complete) [SOL-HW-MAIN-BOARD-P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
2026-11-01 main-board: correct the stage 2b escape-via row text for pin 24 [SOL-HW-MAIN-BOARD-PROVEN-AND-LAID-OUT.C7]
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2026-11-01 main-board: correct the clamp-join figures in the unsigned island note [SOL-HW-MAIN-BOARD-PROVEN-AND-LAID-OUT.C7]
2026-11-01 main-board: move the pumps' neutral return link out of the K731 and U301 barrier strips [SOL-HW-MAIN-BOARD-PROVEN-AND-LAID-OUT.C7]
    The NEUTRAL link on In2.Cu that joins the T701/T711/U602 neutral island to the main pour crossed K731's strip and clipped U301's, where BARRIER_COPPER_MM2 allows no copper. It is now a 0.8 mm track from the T711 pin 1 via west along y 18.45 to the main pour, clear of every barrier strip. mains_barrier 2 to 0 in the full pre-order check; netcheck unchanged; copper lock re-run (0 newly locked, 51 nets). One unsigned creepage shortfall (2.05 mm vs 2.6 mm to the PUMP_S_OPTO_MT via at (28.4, 15.6)) is recorded in layout-plan.md for the owner.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
2026-11-01 main-board: centre the neutral return link and move the PUMP_S_OPTO_MT via so the link keeps 2.6 mm creepage [SOL-HW-MAIN-BOARD-PROVEN-AND-LAID-OUT.C7]
    The link now runs at y 17.85, 2.6 mm from the PUMP_S_OPTO_MT and ZC_LED_A runs, and the PUMP_S_OPTO_MT via moved from (28.4, 15.6) to (29.25, 14.25) with its two stubs, so the DRC with the signed mains-to-mains rules reports no creepage or clearance item for either. Netcheck unchanged; copper lock re-run (0 newly locked, 51 nets).
2026-11-01 main-board: close VREF+, CURR1_AN, BREW_AN and TP527 in the U401 converter island [SOL-HW-MAIN-BOARD-PROVEN-AND-LAID-OUT.C7]
    Steps 1+2 of the island plan: R302, TP402, TP571 and TP527 re-sited; VREF+ sourced from R302.2 and tapped to TP402 through a via beside pin 20; CURR1_AN pin 24 and BREW_AN pin 30 joined to their filters; CURR2_AN, NTC_COF_SENS, NTC_WAND and NTC_WAND_SENS lanes re-laid; two Ground vias swapped for 0.6/0.2 vias (re-locked). 47 tracks and 10 vias, 0 clearance shortfall, 0 off-angle. Netcheck: 0 pad-net mismatches, VREF+, CURR1_AN, BREW_AN and STMP_AN no longer split, open pads 352 to 347, no net newly split.
2026-11-01 main-board: close NTC_COF, NTC_STM and D506.2 with the B.Cu street under the U401 filters [SOL-HW-MAIN-BOARD-PROVEN-AND-LAID-OUT.C7]
    Step 3 of the island plan: U401 pins 15, 16 and 22 descend through vias under the body to a three-lane B.Cu street under C411..C408 and rise at the R502/C501 column; D504.3 joined by a B.Cu run; D506 moved 0.212 mm west and D506.2 hopped onto the +3V3A trunk; C501 and C502 moved 0.1 mm east with their Ground vias (re-locked); TP402 moved under R302. 56 tracks and 13 vias, 0 clearance shortfall, 0 off-angle. Netcheck: 0 mismatches, NTC_STM and +3V3A whole, open pads fewer, no net newly split. D502.3 is the only island net item still open.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
2026-11-01 main-board: re-site the +3V3 feeder of the U621 supply to a short F.Cu stub, two 0.6 mm vias and a B.Cu run west of U621, move C645 east under U621 pins 7 and 8, drop three GND vias (pad 10, C641, C6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
2026-11-01 main-board: route PT2 RTDINN to J628.1 and FORCEN to J628.2 under J635 through a short F.Cu hop of BREWA_3V3_SRC at x 116.2 [SOL-HW-MAIN-BOARD-PROVEN-AND-LAID-OUT.C7]
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2026-11-02 main-board: cite the maker's pad limits in the MFG-1 and MFG-6 rows and record Pass 1 of the critical routing [SOL-HW-MAIN-BOARD-PROVEN-AND-LAID-OUT.C7]
    design-rules.md: the minimum clearance row now cites the maker's pad-to-track 0.10 mm and SMD pad-to-pad 0.15 mm limits beside the 0.09 mm track-and-space figure, the pour gap row inherits them, the hole size row records the pad-drill check (no exception) and the board-edge row states the 'more than 0.3 mm' wording. layout-plan.md: the Critical routing section, Pass 1, judged at b22bdb577acdaf0811a5dbe4668aa6cb3654083a, with each class D item rerun alone written 'cannot judge, then <verdict>'; fails stand until the narrow re-judge.
    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
2026-11-02 main-board: restore the LINE_IN and NEUTRAL_IN B.Cu entry track widths (3.6 and 2.4 mm), the widened tracks fell short of the mains figures [SOL-HW-MAIN-BOARD-PROVEN-AND-LAID-OUT.C7]
2026-11-02 main-board: swap C410/C411 and C408/C409 so the 100 nF stands nearer U401 pins 20 and 21 than the 1 uF [SOL-HW-MAIN-BOARD-PROVEN-AND-LAID-OUT.C7]
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2026-11-02 main-board: correct plan rows to the measured board, record placement-limited items [SOL-HW-MAIN-BOARD-PROVEN-AND-LAID-OUT.C7]
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2026-11-02 main-board: add pre-energisation orientation check, correct the triac bound and touch-current limit, record safety-review owner items [SOL-HW-MAIN-BOARD-PROVEN-AND-LAID-OUT.C7]
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2026-11-04 main-board: remove the router's copper so the hand-routed copper replaces it [SOL-HW-MAIN-BOARD-PROVEN-AND-LAID-OUT.C7]
    The router pass copper (1156 unlocked and 144 locked items) is discarded; the board returns to its placed state. hw:copper-compare against the record taken before the router passes: all 2321 critical items present, locked and unchanged.
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2026-11-04 main-board: lock the hand-routed critical copper (Pass 2 critical routing) [SOL-HW-MAIN-BOARD-PROVEN-AND-LAID-OUT.C7]
    The critical-class copper of the final board (Mains, MainsTrunk, MainsBranch, Mains_Entry, Ground, Supply5V, Supply3V3, Sense and Fast) replaces the router's locked copper and is locked. The non-critical copper arrives in a later commit. The Fast nets AMC_SCLK, AMC_DIN, SPI2_MISO and SPI2_MOSI are re-routed out of the strips under the parts that join mains and low-voltage pads; no Mains or Supply5V item changes.
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2026-11-04 fix(review-kit): give the schematic caller a headroom its own documents fit [SOL-HW-REVIEW-KIT-SESSIONS-HOLD-ONLY-THEIR-GROUP-IMAGES.C5, .C7]
2026-11-04 main-board: record round 1 of the layout review, judged by area group, with its findings [SOL-HW-MAIN-BOARD-PROVEN-AND-LAID-OUT.C7]
    Seven reviewer files merged by hand (the review kit's shared context for this board is about 1.4M tokens). 61 fail, 26 pass, 1 not applicable; 90 findings. Findings 1.42 and 1.75 carry the owner's measurement showing the 9.96 mm creepage is 10.414 mm.
2026-11-04 main-board: record round 6 of the schematic review, judged by area group, with its findings [SOL-HW-MAIN-BOARD-PROVEN-AND-LAID-OUT.C7]
    1112 rows (845 pass, 265 fail, 2 not applicable), 74 findings, 10 of safety severity. The round does not close the review: 25 of round 5's findings stay open, and the separation basis is unsigned at this commit.
2026-11-04 main-board: correct the records that said the separation basis was signed, and the other record gaps from round 6 [SOL-HW-MAIN-BOARD-PROVEN-AND-LAID-OUT.C7]
    The separation basis is unsigned at this commit (accepted_by and accepted_on empty, its 98 accepted exceptions unsigned too): the records that called it signed or re-signed now say so, and say "declared" for its 10.0 mm creepage and 3.0 mm clearance. Pollution degree 3 (and material group IIIb) in the records is corrected to the file's pollution degree 2 and group IIIa, and the mains-to-mains creepage the records restated as 4.1 mm to the file's 2.6 mm. The 74AHCT1G17 wording now says what Rev 5 Table 7 and sections 1 and 2 state. R403 c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
2026-11-04 main-board: fit U520 and C521 and leave R522, R572 and R576 unfitted on the flow input, in the records [SOL-HW-MAIN-BOARD-PROVEN-AND-LAID-OUT.C7]
    The flow input carries the Schmitt buffer U520 and its decoupling C521 fitted, and R522 (the bypass link position), R572 and R576 (burden positions) not fitted, so PC6 sees the Ioff-protected buffer for either meter type. Chased through the sheet (the generator circuit-proof/C_gen_sheets.py is a design file of the review history check and is left as committed; it no longer reproduces the sheets), the regenerated spec and bring-up document, the verdict rows, the proof rows, the open items (the flow meter output type row and bring-up row M21, whose l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
2026-11-04 main-board: record the standing mains spacing items, the checker defect and the library differences [SOL-HW-MAIN-BOARD-PROVEN-AND-LAID-OUT.C7]
    Four open rows in the layout plan's open items: the standing mains-to-mains shortfalls found by the creepage verification (identical on every earlier board, all draft exceptions unsigned), the board_geometry.route_length defect at the U601 slot junction (over-conservative), the U601 library footprint's paste difference at pad 17, and the do-not-populate gap on R522, R572 and R576. No signed figure changes.
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2026-11-04 feat(graph): scope boundaries and wording from blind review [SOL-MAIN-BOARD-EXCEPTIONS-COVER-EVERY-REPORTED-SHORTFALL-PAIR.C2, SOL-HW-MAIN-BOARD-U601-LIBRARY-FOOTPRINT-MATCHES-BOARD.C1, SOL-HW-CONTRO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
2026-11-04 main-board: replace machine-specific scratch paths in the layout plan with a SCRATCH placeholder [SOL-HW-MAIN-BOARD-PROVEN-AND-LAID-OUT.C7]
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2026-11-04 Revert the layout plan's scratch-path placeholders: the Placement section and both routing passes are frozen by hw:history (68 of 94 became 71 of 94) [SOL-HW-MAIN-BOARD-PROVEN-AND-LAID-OUT.C7]
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2026-11-05 main-board: remaining non-mains tracks octilinear (direction 82 to 75, angle 215 to 202, short segments 1273 to 1261), +5V chain left as before so no track is nearer a mains item; Sense pairs and Fas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
2026-11-05 main-board: layout review round 2 on the final board, 25 pass 62 fail 1 not applicable, 88 findings, not closed [SOL-HW-MAIN-BOARD-PROVEN-AND-LAID-OUT.C7]
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2026-11-05 main-board: fiducial pad clearance overrides replaced by one Fiducial keep-clear rule ahead of Mains separation [SOL-HW-MAIN-BOARD-PROVEN-AND-LAID-OUT.C7]
    FID1 to FID3 carried a 0.6 mm local clearance on the pad, which a pad-level override states below the signed 3.0 mm mains-to-low-voltage figure. The pad overrides are removed and the same 0.6 mm is one rule written before Mains separation, so the later rule still governs any mains pair. Pour distances measured on a refilled copy: FID2 0.6 mm, FID3 0.6 mm, FID1 out of reach, identical to before. Copper, zones and fills unchanged.
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2026-11-05 main-board: In2 pour keep-outs round the LINE_IN via and the PUMP_S_OPTO_MT via clear both creepage-to-pour lines [SOL-HW-MAIN-BOARD-PROVEN-AND-LAID-OUT.C7]
    Under the check's own refill (its appended 1.5 mm mains-to-mains rule replaces the NEUTRAL pour's 3.0 mm) the south end of the In2 NEUTRAL pour comes to 1.5005 mm of the LINE_IN via at (15.1, 95.9) ahead of the fuse, and the north lobe to 2.119 mm of the PUMP_S_OPTO_MT via at (29.25, 14.25), against 2.6 mm creepage; the committed fill stands 9.77 and 3.00 mm away. Two In2 rule areas, no pour: a 5.2 mm circle round the LINE_IN via with the LINE taps strip cut out of it (a round keep-out would cut that strip in two from 4.6 mm up), and a 3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
2026-11-05 fix(board-check): read a surface-mount pad in KiCad's report, a plated pad on a net as a terminal not a fixing, and a net tie's graphic as the copper of its nets [SOL-PRE-ORDER-CHECK-READS-A-SURFACE-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
2026-11-05 main-board: prune the 69 separation-basis exceptions the signed run of the layout check found used by no shortfall, keep the 29 it uses unsigned and unchanged [SOL-HW-MAIN-BOARD-PROVEN-AND-LAID-OUT.C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
2026-11-05 feat(graph): the owner-risk decision states the bought-part creepage entries are drafted when the layout shows a shortfall [DEC-MAIN-BOARD-RESIDUAL-RISKS-ACCEPTED-BY-OWNER, SOL-PRE-ORDER-CHECK-JUDGES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
2026-11-05 docs(board): the records state the separation basis and the derating policy as signed on 2026-11-05 [SOL-SEPARATION-BASIS-RECORD-STANDS-SIGNED-ON-THE-FINISHED-LAYOUTS-EXCEPTION-SET.C8]
    The basis (33 exceptions) and the main board's ten derating exceptions were signed on 2026-11-05 on the owner's written instruction, entered by Claude. The main-board records, the constraints record and the division record no longer say they are unsigned or drafts until the owner signs; every other fact in them is kept. The division record's bought-part row and sentence now say what the record holds (no mains-to-low-voltage entry, the slots hold those gaps at the figure).
    pre-order-check-result.md is a dated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
2026-11-05 docs(board): the signal study of the routed main board, and the criteria that carry its firmware settings and bring-up readings [DEL-HW-MAIN-BOARD-DESIGNED.C27, DEL-HW-BRING-UP.C21]
    signal-study.md records a model of the board file at c25f3af6 (ngspice and uncommitted scripts, no physical measurement): its figures and assumptions are unchanged from the working copy, the absolute working paths are replaced by descriptions, and a Provenance section says how it was produced and that it cannot be re-run from the repository alone.
    No node in the graph required the firmware settings it asks for or the bring-up readings it lists (a search of the specs for SPI2, MAX31865, GPIO output speed and the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
2026-11-05 main-board: the sheet generator writes the committed sheets and the flow decks model the fitted buffer, with the proof's check and a test that run them in a copy [SOL-HW-MAIN-BOARD-PROVEN-AND-LAID-OU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
    The generator wrote the old fit (link R522 fitted, buffer U520 and C521 not) and the old test-point footprint, so regenerating the sheets would have undone the flow-input decision; it now reproduces sheets 50, 52 and 57 byte for byte and C_check_sheets.py reports any difference. The two flow decks model U520 (input leakage, thresholds, C521) and no R522, re-run with ngspice; the filter node reaches 5.251 V against the buffer's 5.5 V, the open-drain level 3.242 V against 2.74 V, so the verdi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
2026-11-05 main-board: restore the frozen pass 2 row GROUND-5 of the layout plan to the text pass 2 recorded, which the previous commit had edited [SOL-HW-MAIN-BOARD-PROVEN-AND-LAID-OUT.C7]
    hw:history judges pass 2 as it stood before the router; the row had been rewritten from unsigned to signed, which made the history fail 69 of 94 checks instead of 68. The signed state is stated in the open-items row below it, which is not a frozen pass.
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2026-11-05 docs(board): the traceability and error-budget records, the division record's shunt and resistor clearances brought to the current basis, and the proof's stale sentence replaced [SOL-HW-MAIN-BOARD-PR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
    Produced 2026-11-05 from board commit c25f3af6, by Claude agents; models, no physical measurement. The traceability record states the flow row and the entry-fuse row as recorded after the flow decks were re-run and the fuse accepted; the division record's A3 row and mains-to-mains decision now say R105 at 0.44 mm and the 1206 gate resistors at 1.8 mm, as the basis holds them, and the test that pins those phrases is updated with them.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
2026-11-05 main-board: layout review round 3 on the final design, 25 pass 62 fail 1 not applicable, 86 findings [SOL-HW-MAIN-BOARD-PROVEN-AND-LAID-OUT.C7]
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2026-11-05 feat(graph): the net-pair criterion's stale count is recorded as failing and filed under maintenance [SOL-MAIN-BOARD-NET-PAIR-EXCEPTIONS-DRAFTED.C1, REQ-ELECTRICAL-INSTALL-001.C15]
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2026-11-05 feat(graph): pump-triac leaf no longer says the record stays unsigned [SOL-SEPARATION-BASIS-PUMP-TRIAC-EXCEPTIONS-FOLLOW-THE-LAND-DRAWN.C1]
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2026-11-05 main-board: pre-order check result header no longer says later commits are records only [SOL-HW-MAIN-BOARD-PROVEN-AND-LAID-OUT.C7]
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2026-11-05 feat(graph): plated-hole rule fix needs no board change, 16 lines measured by path [OBL-ELECTRICAL-THERMAL-SAFETY-001.C6]
2026-11-05 feat(graph): maintenance item for the sensing-clearance guard misreading a long clearance list [SOL-PRE-ORDER-CHECK-SENSING-CLEARANCE-AND-GROUND-RETURNS.C1]
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2026-11-05 feat(graph): record the tab-pitch acceptance as recommended, the off-state check's home, and the plated-hole figure correction [DEC-MAIN-BOARD-RESIDUAL-RISKS-ACCEPTED-BY-OWNER, SOL-MAIN-BOARD-PLATED-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
2026-11-06 main-board: record round 7 of the schematic review, judged by area group, with its findings [SOL-HW-MAIN-BOARD-PROVEN-AND-LAID-OUT.C7]
    Round 7 is a full closing round of commit af87877b, judged by six reviewer
    groups and a datasheet reader, by hand (the review kit refuses at this
    commit: shared documents 6,012,293 tokens against 700,000).
    Counts: 1,128 verdict rows in the merged file (813 pass, 308 fail, 7 not
    applicable); 84 findings, 12 of safety severity, none closed. Of the 12
    safety findings, 3 are covered by an owner acceptance (7.1, 7.29, 7.32),
    4 in part (7.17, 7.35, 7.36, 7.44) and 5 not covered (7.33, 7.34, 7.40,
    7.45, 7.52). Of round 6's 74 findings, 70 continue and 4 are closed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
2026-11-06 feat(graph): record owner acceptances (q) to (y), extend (a) to a shorted clamp diode, re-affirm the carry decision [SOL-HW-MAIN-BOARD-SCHEMATIC-PROVEN.C1, REQ-SAFETY-CHAIN-001.C8]
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2026-11-06 main-board: records and proof scripts for the 470 ohm R607 R608 and R791 to R795, E1.7 now on R607 alone, gauge harness-short, back-fed and edge rows, C23179 in the catalogue extract [SOL-HW-MAIN-BOA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
2026-11-06 main-board: targeted re-review of the seven resistor swaps, change after round 7 and after round 3, findings 7.9 and 7.62 closed, 7.11 closed as to U791 [SOL-HW-MAIN-BOARD-PROVEN-AND-LAID-OUT.C7]
2026-11-06 feat(graph): record the owner's decision of 2026-11-06 on the seven resistor swaps, U402 kept (z) and rounds waived (z2) [SOL-HW-MAIN-BOARD-PROVEN-AND-LAID-OUT.C7]
2026-11-06 main-board: leak-detection record, whether the mains current channel sees leakage through an output commanded off, an analysis and not a measurement [SOL-HW-MAIN-BOARD-PROVEN-AND-LAID-OUT.C7]
2026-11-06 feat(graph): the mains current channel resolves a leakage of 50 mA with every output commanded off, analysed, and bring-up measures the idle current and sets the check's threshold [SOL-HW-MAIN-BOARD-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
2026-11-06 feat(graph): (z3) and (z4) confirmed by the owner, the thirteen derating acceptances signed on his behalf and carried by the decision, the stale rationale header and the undecided list corrected [DEC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
    Owner's instruction of 2026-11-06, 'Yes accept all', entered by Claude on the owner's written instruction.
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2026-11-06 feat(graph): acceptance (i) restated against the clarified C16, resolved by the named detection that no node yet delivers, the two senses of independent recorded, the coat after bring-up, the undecid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
2026-11-06 main-board: the eight pump-triac and gate-resistor exceptions state the restated bound of acceptance (i), the detection named and what it resolves and does not, the coat later [SOL-HW-MAIN-BOARD-PROV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
    Only the eight bounded_by texts and the header lines that say the same change. Owner's instruction of 2026-11-06, 'Yes accept all', entered by Claude on the owner's written instruction.
2026-11-06 feat(graph): the owner accepts the three undecided round 7 half-findings, the gauge driver input, the +5V lockout and the ANODE_RAIL short [DEC-MAIN-BOARD-RESIDUAL-RISKS-ACCEPTED-BY-OWNER]
    Entered by Claude on the owner's written instruction of 2026-11-06 ("Accept all and resign"): (z5) 7.11 as to the driver's input clamp current, bounded by the 470 ohm series limit; (z6) the +5V lockout half of 7.30; (z7) the ANODE_RAIL half of 7.82, bounded by the supply module's hiccup limit as (t). The bring-up note (power the gauge assembly before the buffer or leave JP791 closed) goes into bring-up-provision.md; open-items.md's sensor supply feeds row now names the ANODE_RAIL conductors. The schematic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
