Resident-X/brew-state/(notices)

Notices in the files:
docs/board-design-method.md:
The convention's own items each cite their sources in full.
